ElessarCuthalion/KiCAD_library/3D/(SolidWorks)/Installation/Stones/Quartz crystal big 1.jpg

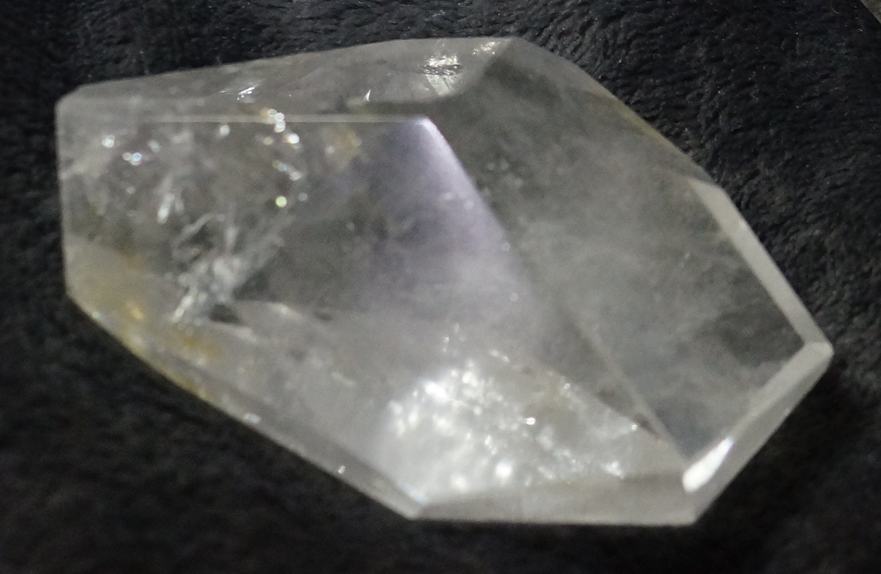
3D/(SolidWorks)/Installation/Stones/Quartz crystal big 1.jpg
