ElessarCuthalion/KiCAD_library/3D/(SolidWorks)/Installation/Stones/Quartz crystal big 2.jpg

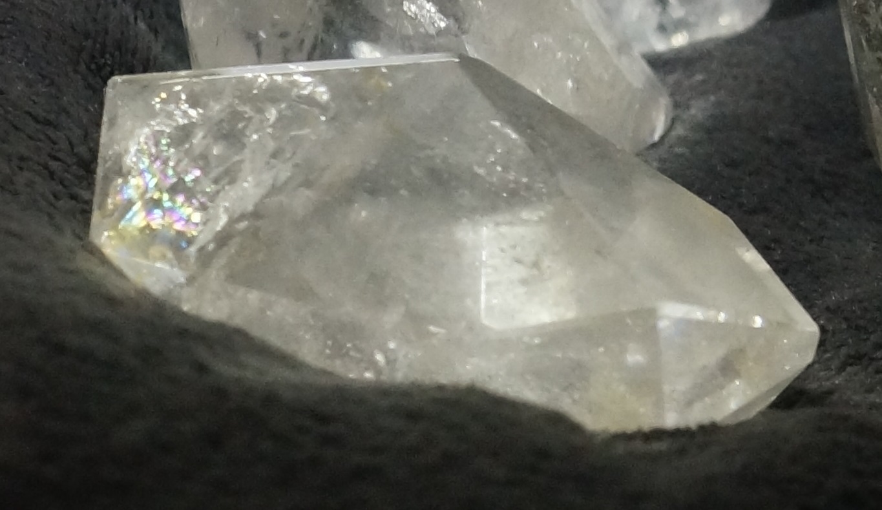
3D/(SolidWorks)/Installation/Stones/Quartz crystal big 2.jpg
