ElessarCuthalion/KiCAD_library/3D/(SolidWorks)/Buttons_Switches/+/900BGQ/900BGQ.png

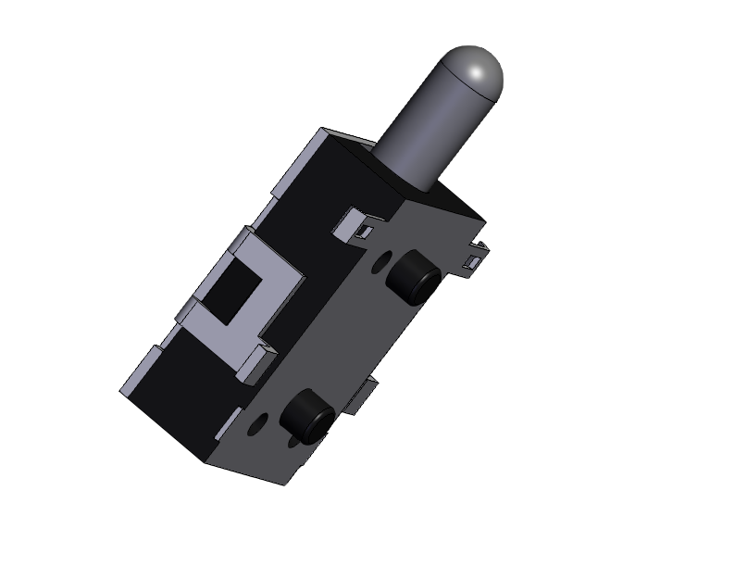
3D/(SolidWorks)/Buttons_Switches/+/900BGQ/900BGQ.png
