ElessarCuthalion/KiCAD_library/3D/(SolidWorks)/LEDs/Cree XLamp XP-E (XPERED L1 0000 00601)/Renderings/XPERED_L1_0000_0060120120402-31379-1748i98.JPG

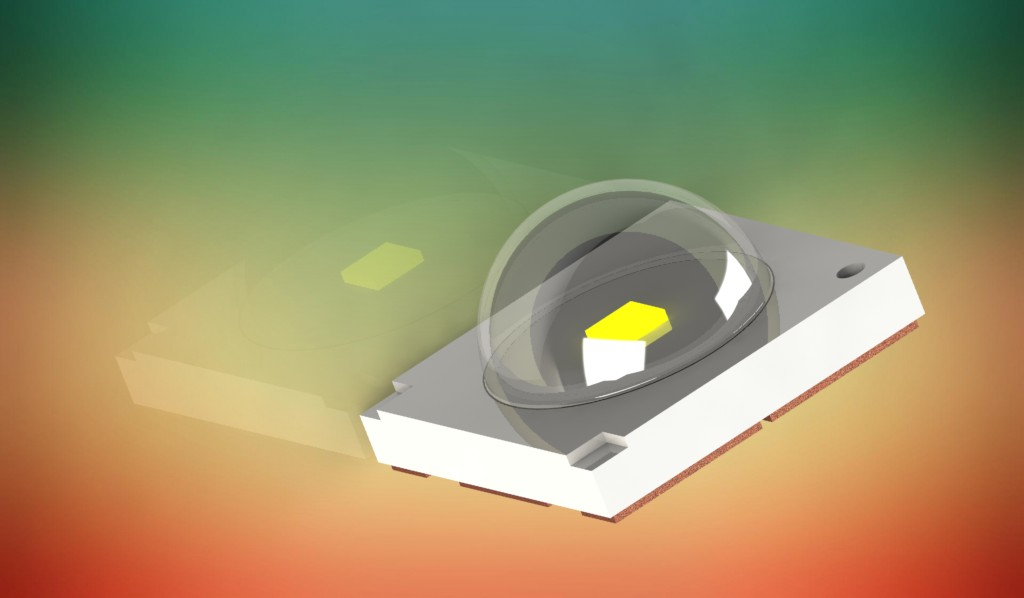
3D/(SolidWorks)/LEDs/Cree XLamp XP-E (XPERED L1 0000 00601)/Renderings/XPERED_L1_0000_0060120120402-31379-1748i98.JPG
