ElessarCuthalion/KiCAD_library/3D/Connectors/+/Degson terminals/Renderings/DG128-5.0.png

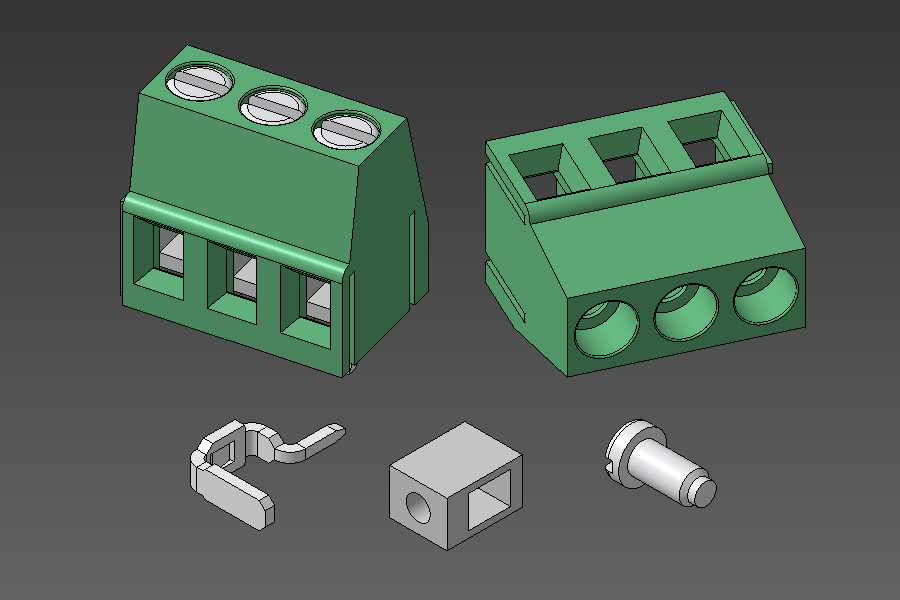
3D/Connectors/+/Degson terminals/Renderings/DG128-5.0.png
