ElessarCuthalion/KiCAD_library/3D/Connectors/+/Degson terminals/Renderings/overview.png

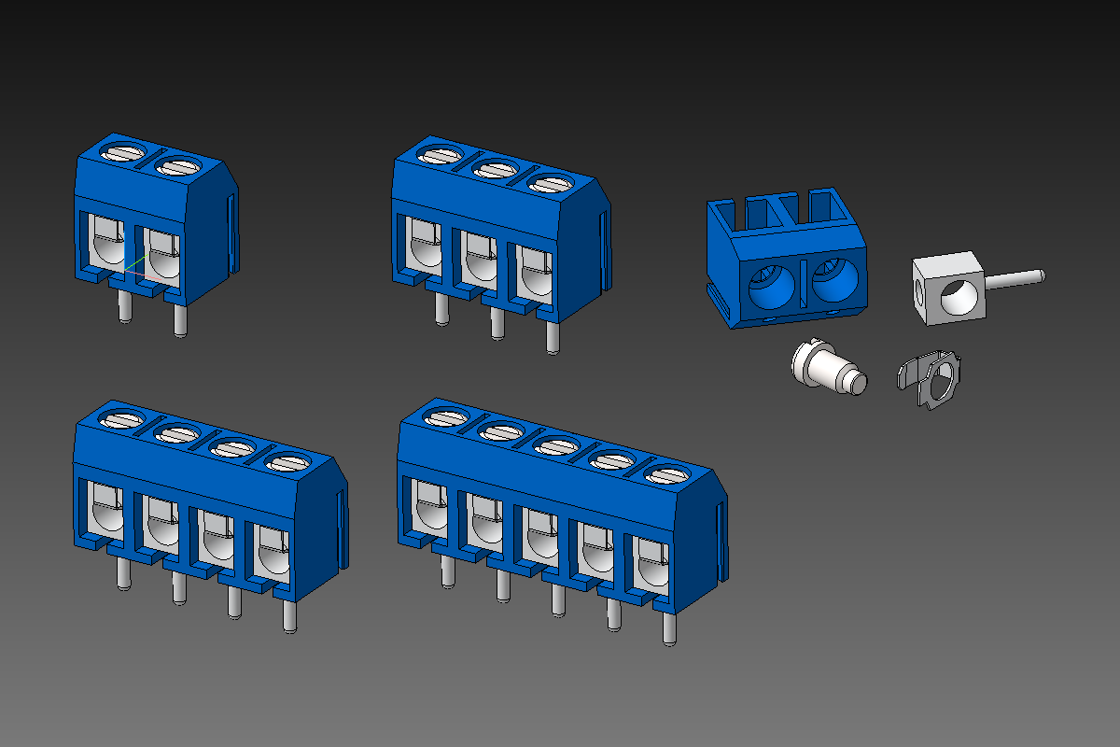
3D/Connectors/+/Degson terminals/Renderings/overview.png
