ElessarCuthalion/KiCAD_library/3D/(SolidWorks)/Buttons_Switches/+/900BGQ/User Library-900BGQ.sldasm

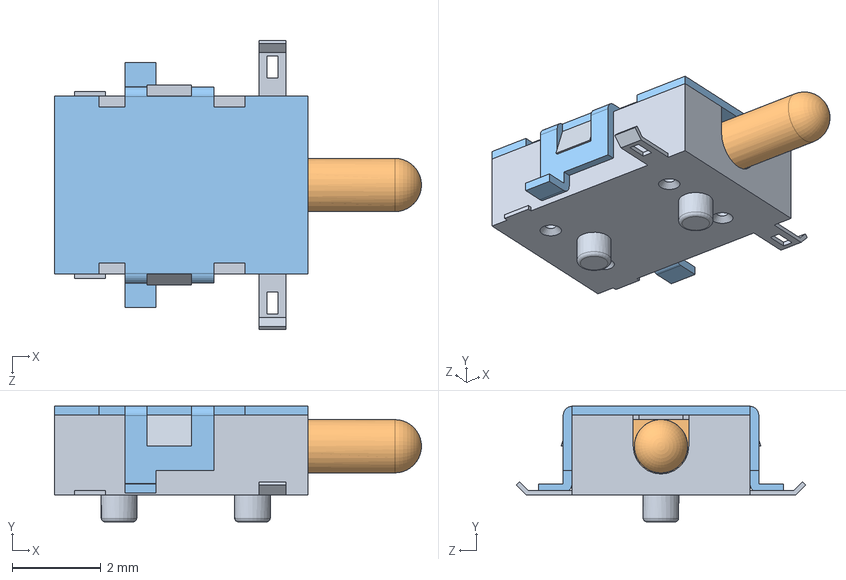
[picture p7: CAD file, 2019-11-22]
3D/(SolidWorks)/Buttons_Switches/+/900BGQ/User Library-900BGQ.sldasm
8.25 x 2.60 x 6.50 mm
User Library-900BGQ_900B_BODY
User Library-900BGQ_button
User Library-900BGQ_metal bracket
