ElessarCuthalion/KiCAD_library/3D/(SolidWorks)/Buttons_Switches/Импортированно/Switch SS-3235S-L2 (MSS-22D18G2)/SS-3235S-L2 (MSS-22D18G2).SLDASM

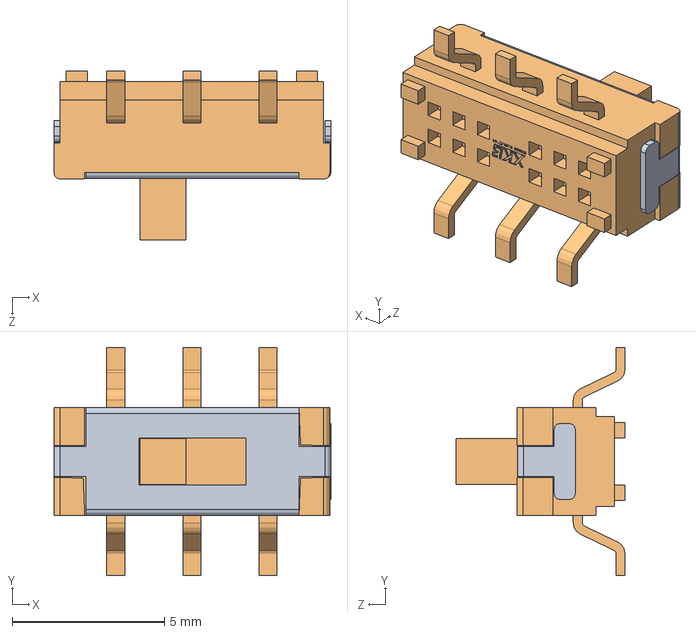
[picture p8: CAD file, 2020-05-14]
3D/(SolidWorks)/Buttons_Switches/Импортированно/Switch SS-3235S-L2 (MSS-22D18G2)/SS-3235S-L2 (MSS-22D18G2).SLDASM
9.10 x 7.50 x 5.55 mm
SS-3235S-L2_01
SS-3235S-L2_02
