ElessarCuthalion/KiCAD_library/3D/(SolidWorks)/Connectors/Импортированно/MicroSD Socket 112J-TXAR-R_C_1-1/112J-TXAR-R_C_1-1 with Card.SLDASM

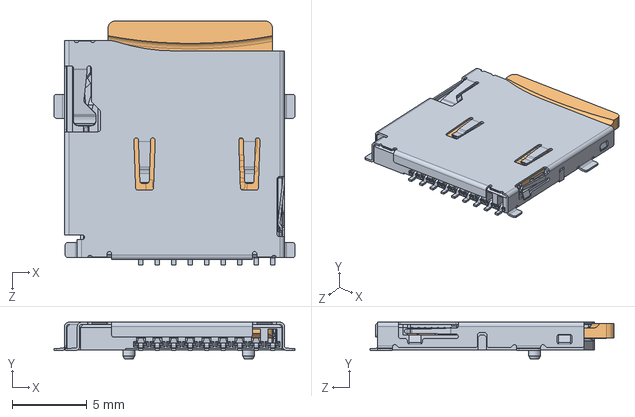
[picture p9: CAD file, 2019-11-27]
3D/(SolidWorks)/Connectors/Импортированно/MicroSD Socket 112J-TXAR-R_C_1-1/112J-TXAR-R_C_1-1 with Card.SLDASM
16.1 x 2.45 x 16.3 mm
MicroSD Socket 112J-TXAR-R_C_1-1
Micro-SD card
