ElessarCuthalion/KiCAD_library/3D/(SolidWorks)/Furniture/Hinge 20x16mm Assem.SLDASM

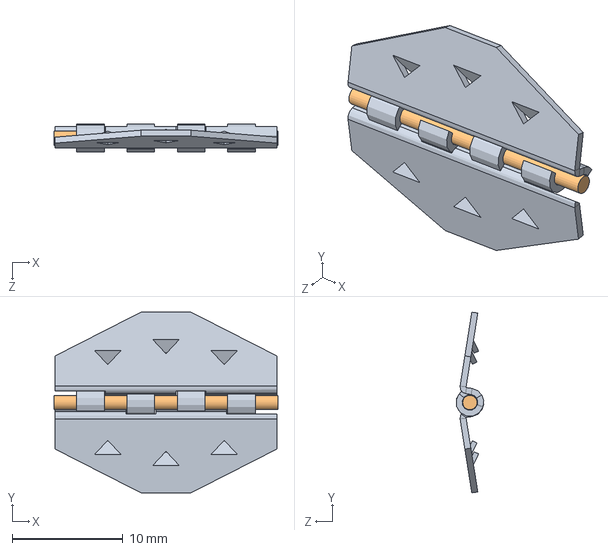
[picture p10: CAD file, 2025-02-06]
3D/(SolidWorks)/Furniture/Hinge 20x16mm Assem.SLDASM
20.2 x 16.3 x 2.48 mm
Деталь1^Hinge 20x16mm Assem x 2
Стержень^Hinge 20x16mm Assem
