ElessarCuthalion/KiCAD_library/3D/(SolidWorks)/Inductors/Импортированно/Ferrite Bead 0603/User Library-FB_1608-1.sldasm

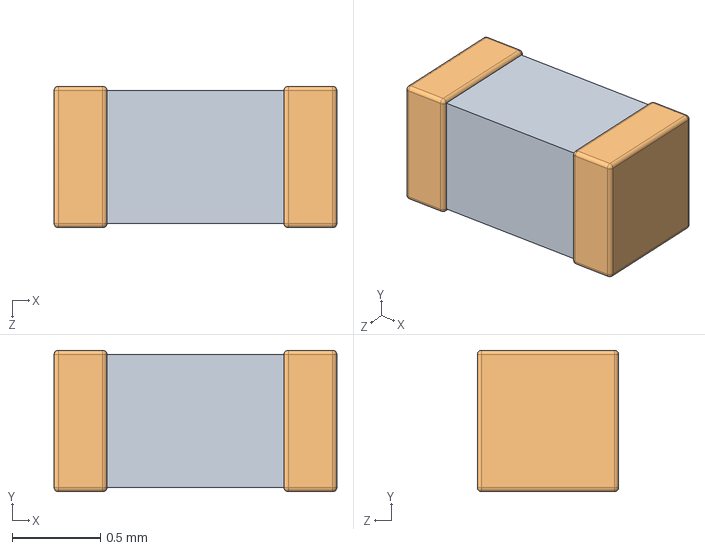
[picture p11: CAD file, 2019-11-27]
3D/(SolidWorks)/Inductors/Импортированно/Ferrite Bead 0603/User Library-FB_1608-1.sldasm
1.60 x 0.8 x 0.8 mm
User Library-FB_1608-1_Pad001
User Library-FB_1608-1_Cut
