ElessarCuthalion/KiCAD_library/3D/(SolidWorks)/Installation/Electrician/Fan 8412NGMI/8412NGMI_ebm-papst.sldasm

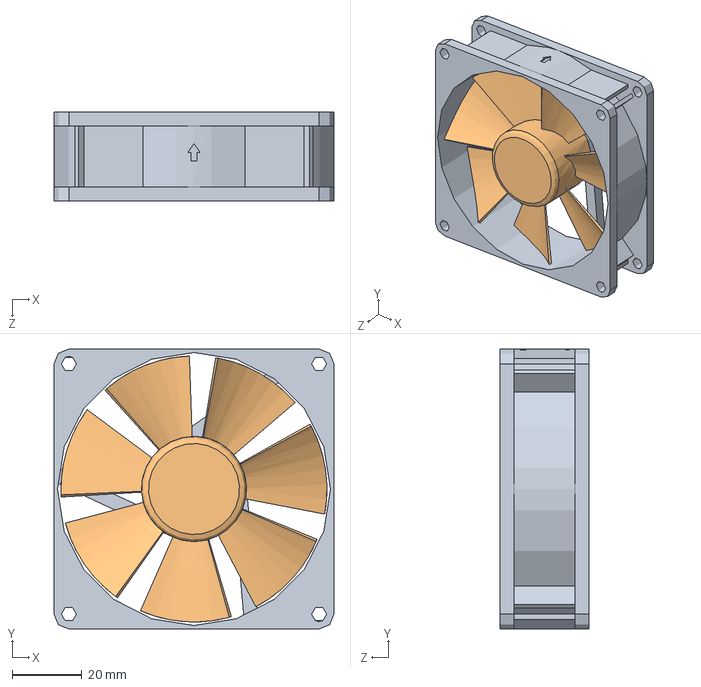
[picture p12: CAD file, 2019-11-18]
3D/(SolidWorks)/Installation/Electrician/Fan 8412NGMI/8412NGMI_ebm-papst.sldasm
80.0 x 80.0 x 25.4 mm
Fan-House_8412NGMI_ebm-papst
Fan_8412NGMI_ebm-papst
