ElessarCuthalion/KiCAD_library/3D/(SolidWorks)/Installation/Electrician/ТЭН водяной из нержавейки 2,0 кВт 195 мм 03.324/ТЭН водяной 2кВт 195мм 03.324.SLDASM

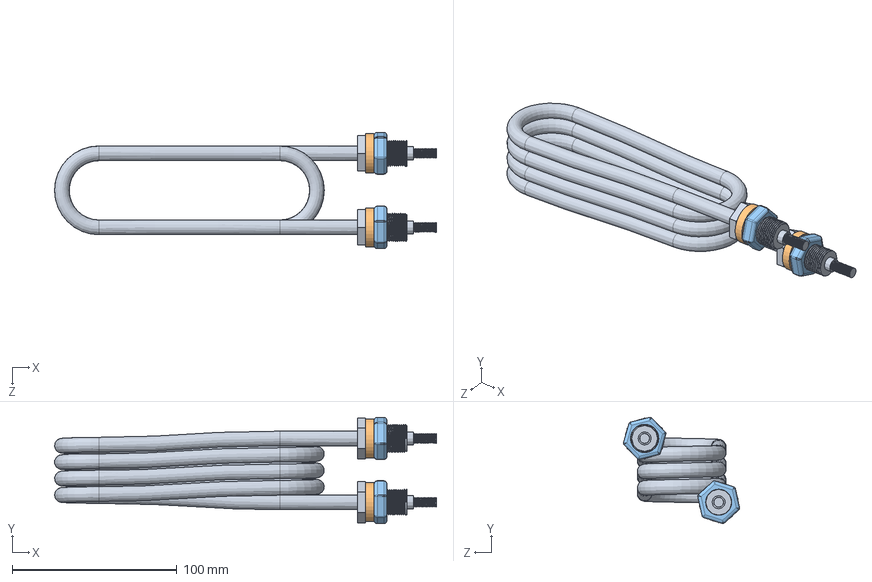
[picture p13: CAD file, 2021-07-01]
3D/(SolidWorks)/Installation/Electrician/ТЭН водяной из нержавейки 2,0 кВт 195 мм 03.324/ТЭН водяной 2кВт 195мм 03.324.SLDASM
232.2 x 64.7 x 70.7 mm
ТЭН№1
ТЭН№2 x 2
ТЭН№3 x 2
