ElessarCuthalion/KiCAD_library/3D/(SolidWorks)/Installation/Импортированно/Fuse Holder FC-201/Clips FC-201 with fuse 5x20.sldasm

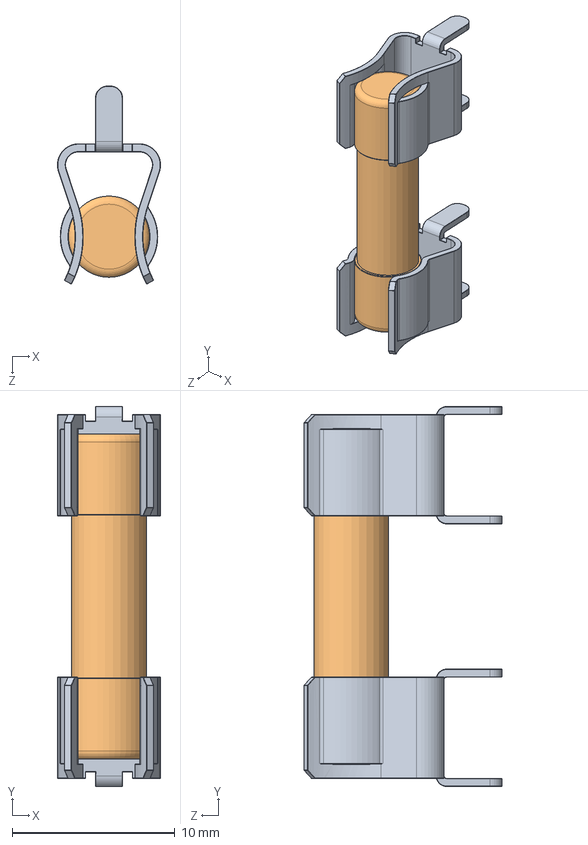
[picture p14: CAD file, 2020-11-07]
3D/(SolidWorks)/Installation/Импортированно/Fuse Holder FC-201/Clips FC-201 with fuse 5x20.sldasm
6.34 x 23.4 x 12.2 mm
Clips FC-201 with fuse 5x20_FC-201 x 2
Clips FC-201 with fuse 5x20_5x20
