ElessarCuthalion/KiCAD_library/3D/(SolidWorks)/Installation/Импортированно/Fuse Holder FH-100/Clips FH-100 with fuse 5x20.sldasm

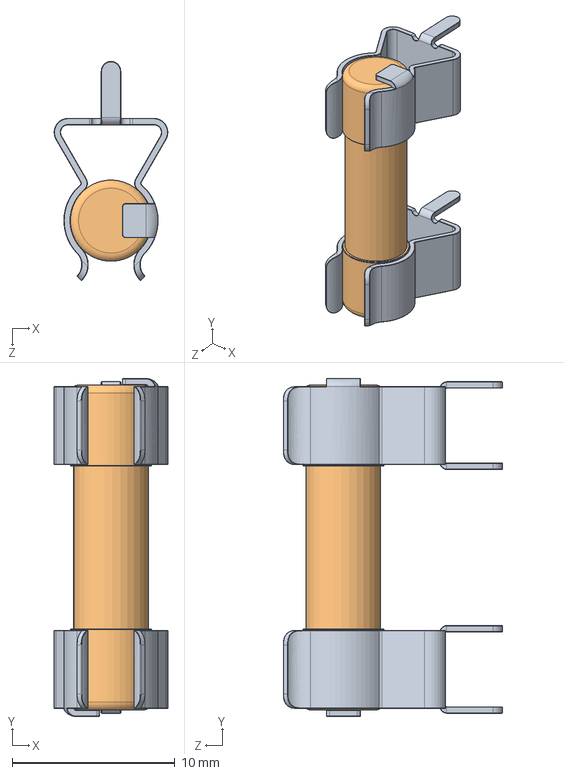
[picture p15: CAD file, 2020-11-07]
3D/(SolidWorks)/Installation/Импортированно/Fuse Holder FH-100/Clips FH-100 with fuse 5x20.sldasm
7.00 x 20.8 x 13.5 mm
Clips FH-100 with fuse 5x20_FH-100 x 2
Clips FH-100 with fuse 5x20_5x20
