ElessarCuthalion/KiCAD_library/3D/(SolidWorks)/LEDs/Cree XLamp XP-E (XPERED L1 0000 00601)/cree xlamp_xp_e XPERED_L1_0000_00601.SLDASM

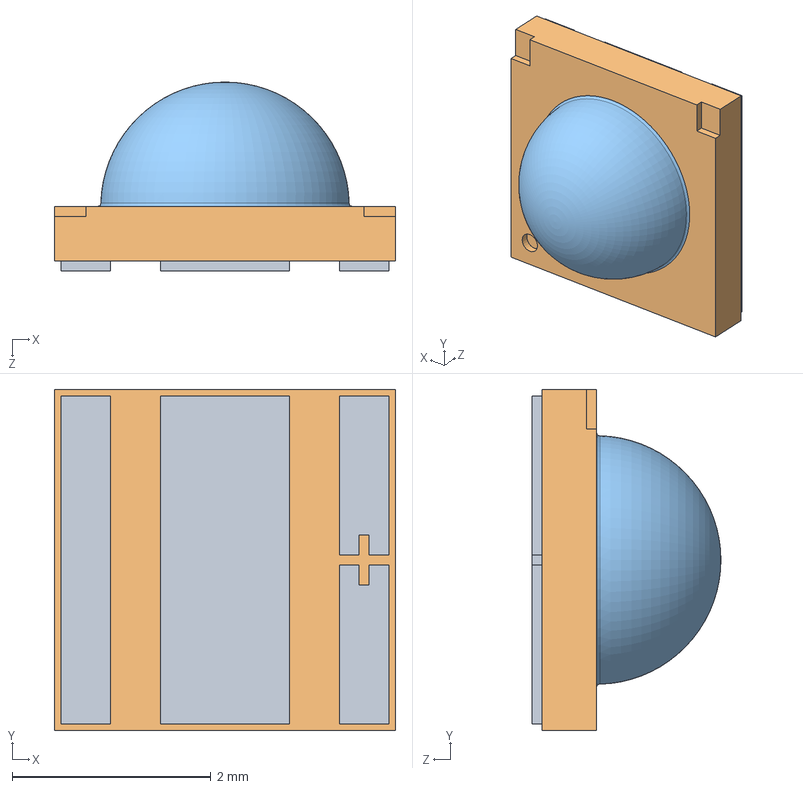
[picture p16: CAD file, 2023-12-07]
3D/(SolidWorks)/LEDs/Cree XLamp XP-E (XPERED L1 0000 00601)/cree xlamp_xp_e XPERED_L1_0000_00601.SLDASM
3.43 x 3.43 x 1.90 mm
led anod
led_alaptest
led_lencse
emiter_fosfor
