ElessarCuthalion/KiCAD_library/3D/(SolidWorks)/LEDs/Импортированы/LED5050 RGB/_LED5050 RGB.sldasm

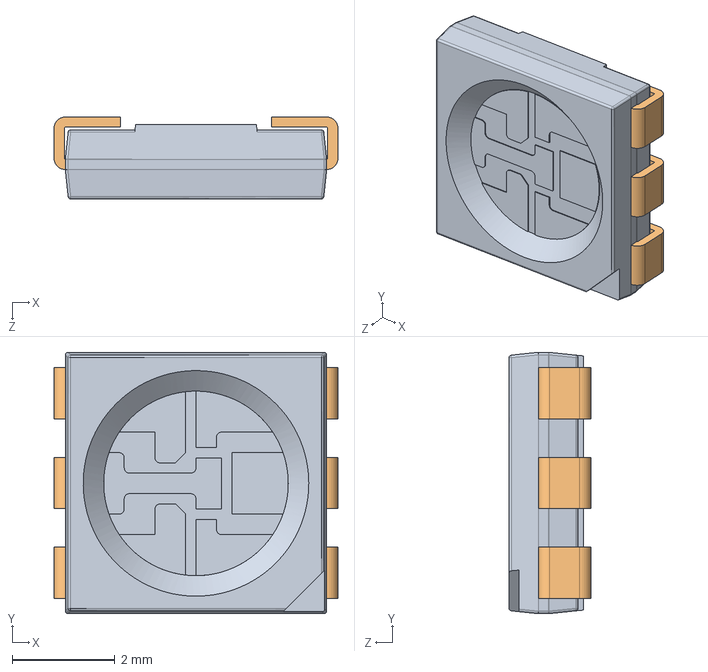
[picture p17: CAD file, 2019-11-22]
3D/(SolidWorks)/LEDs/Импортированы/LED5050 RGB/_LED5050 RGB.sldasm
5.54 x 5.10 x 1.60 mm
Open_CASCADE_STEP_translator_6.8_1.1
Lead x 6
