ElessarCuthalion/KiCAD_library/3D/(SolidWorks)/Modules/Raspberry/Импортированно/Raspberry Pi 3.SLDASM

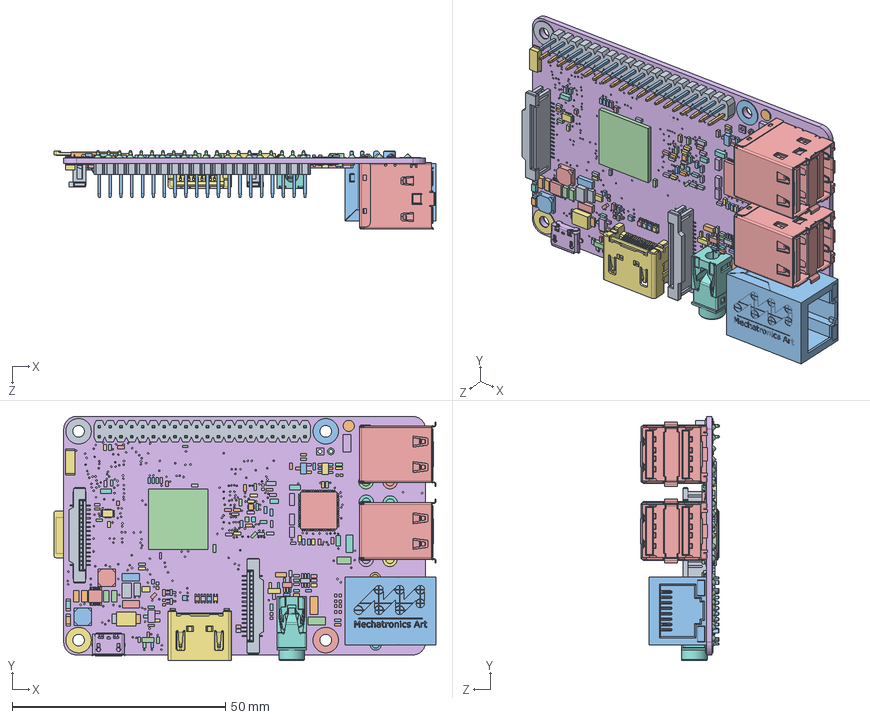
[picture p18: CAD file, 2019-11-18]
3D/(SolidWorks)/Modules/Raspberry/Импортированно/Raspberry Pi 3.SLDASM
89.6 x 57.3 x 18.6 mm
Raspberry Pi 3157
Raspberry Pi 3242 x 20
Raspberry Pi 3266 x 20
raspberry_pi_3(bar_180_2x20)
MOLEX_672983090 x 2
molex_0473460001
molex_0471510001
PJ-322
te_1-1734248-5 x 2
MOLEX_1040310811
raspberry_pi_B_(RJ45)
Raspberry Pi 312
Raspberry Pi 314
Raspberry Pi 3172
Raspberry Pi 3173
Raspberry Pi 3174
Raspberry Pi 3175
Raspberry Pi 3176
Raspberry Pi 3177
Raspberry Pi 3178
Raspberry Pi 3179
Raspberry Pi 3180
Raspberry Pi 3181
Raspberry Pi 3182
Raspberry Pi 3183
Raspberry Pi 3184
Raspberry Pi 3185
Raspberry Pi 3186
Raspberry Pi 3187
Raspberry Pi 3188
Raspberry Pi 3189
Raspberry Pi 3190
Raspberry Pi 3191
Raspberry Pi 3192
Raspberry Pi 3193
Raspberry Pi 3194
Raspberry Pi 3195
Raspberry Pi 3196
Raspberry Pi 3197
Raspberry Pi 3198
Raspberry Pi 3199
Raspberry Pi 3200
Raspberry Pi 3201
Raspberry Pi 3202
Raspberry Pi 3203
Raspberry Pi 3204
Raspberry Pi 3205
Raspberry Pi 3206
Raspberry Pi 3207
Raspberry Pi 3208
Raspberry Pi 3209
Raspberry Pi 3210
Raspberry Pi 3211
Raspberry Pi 3212
Raspberry Pi 3213
Raspberry Pi 3214
Raspberry Pi 3215
Raspberry Pi 3216
Raspberry Pi 3217
Raspberry Pi 3218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
