ElessarCuthalion/KiCAD_library/3D/(SolidWorks)/SOT_TO/Импортированно/SOT89/SOT89.SLDASM

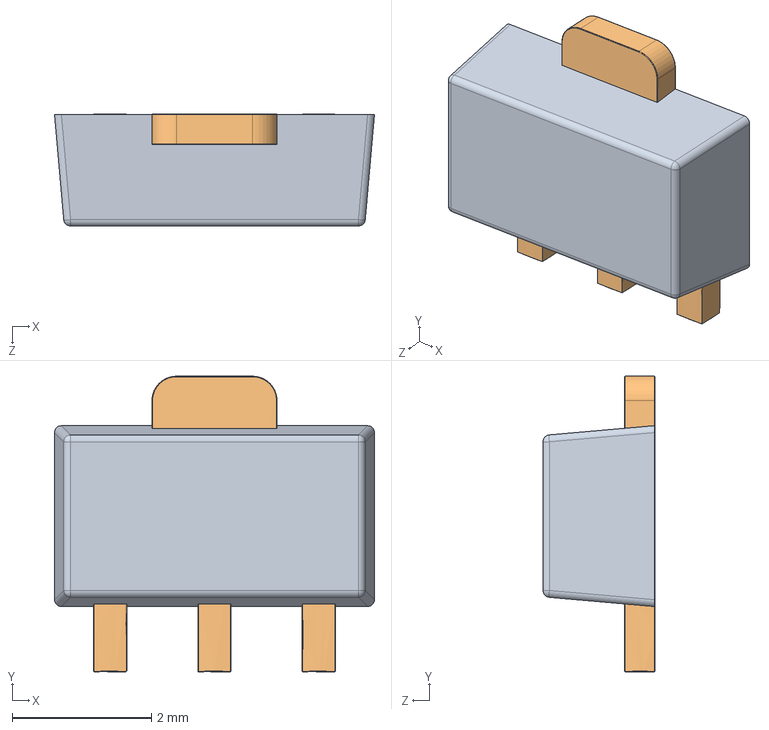
[picture p19: CAD file, 2020-11-05]
3D/(SolidWorks)/SOT_TO/Импортированно/SOT89/SOT89.SLDASM
4.60 x 4.25 x 1.61 mm
SOT89-case
SOT89-pinout
