ElessarCuthalion/KiCAD_library/3D/(SolidWorks)/Battery_&_Holders/BatHolder 3xAA/BatHolder 3xAA Asm.SLDASM

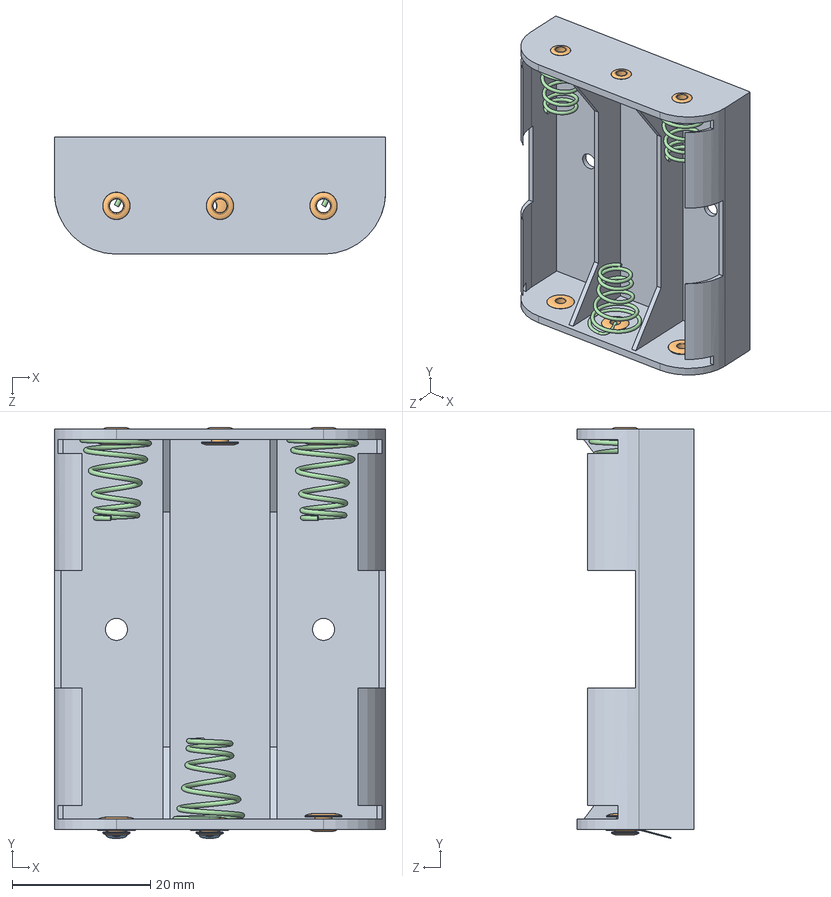
[picture p20: CAD file, 2019-11-18]
3D/(SolidWorks)/Battery_&_Holders/BatHolder 3xAA/BatHolder 3xAA Asm.SLDASM
48.0 x 59.5 x 17.0 mm
BatteryHolder 3xAA Case
