ElessarCuthalion/KiCAD_library/3D/(SolidWorks)/Connectors/_Plug's/RJ-25 plug + cover cast (ethernet cable)/male_main_head.SLDPRT

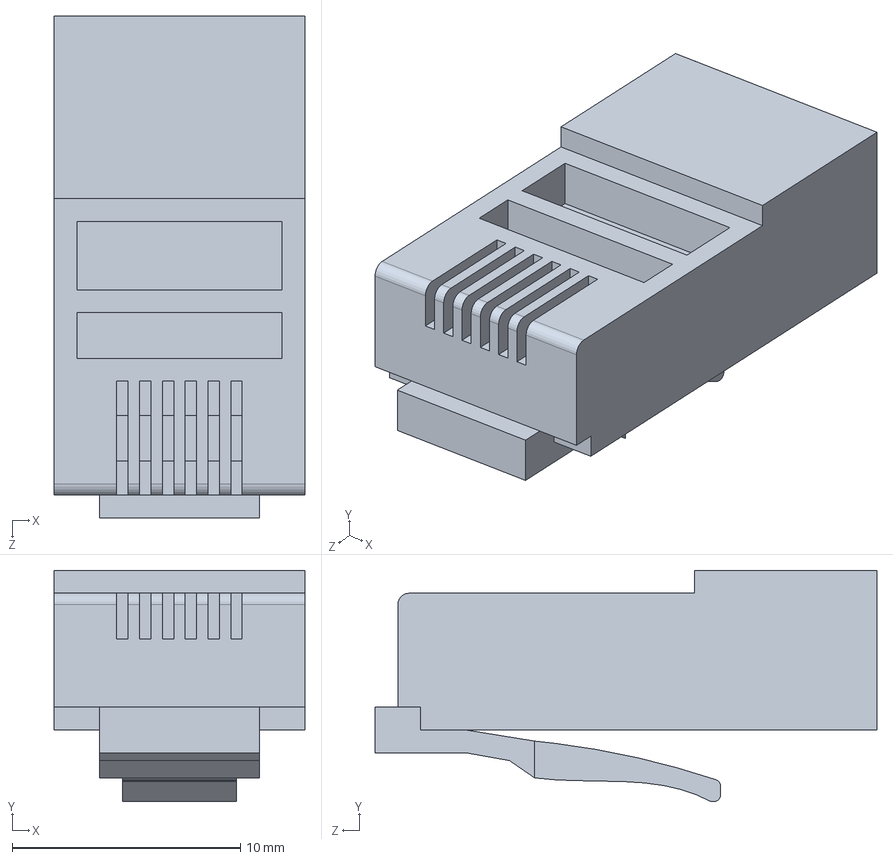
[picture p21: CAD file, 2020-08-14]
3D/(SolidWorks)/Connectors/_Plug's/RJ-25 plug + cover cast (ethernet cable)/male_main_head.SLDPRT
11.0 x 10.1 x 22.0 mm
