ElessarCuthalion/KiCAD_library/3D/(SolidWorks)/Connectors/Cleamm-2_5mm - DG306-5.0-xxP/DG306-5.0-3P.SLDASM

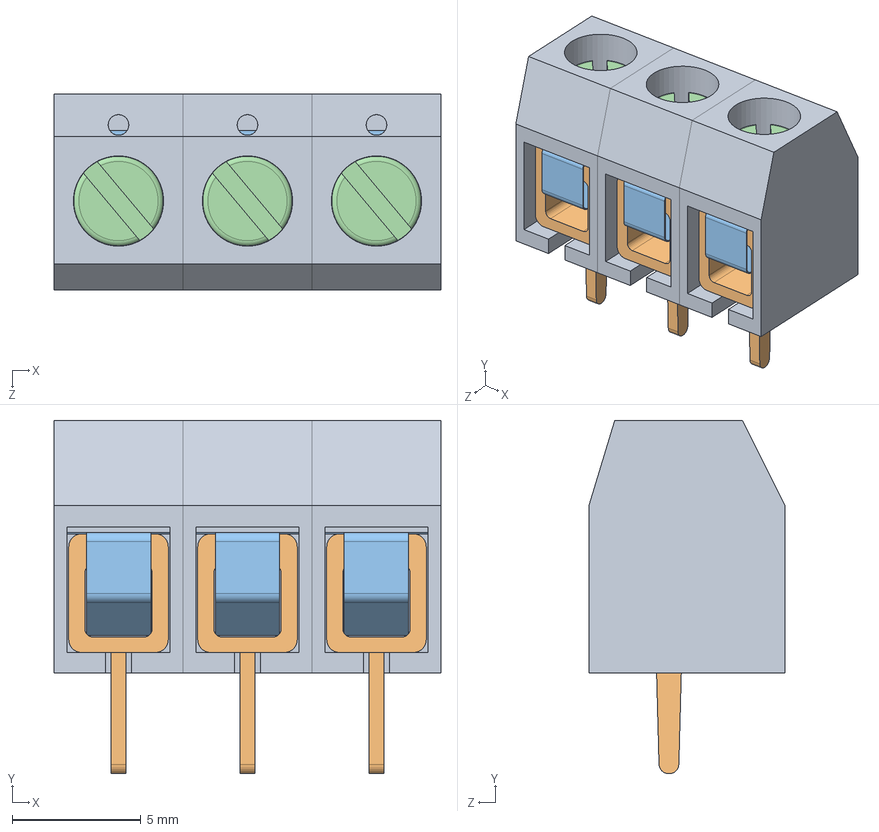
[picture p22: CAD file, 2020-06-08]
3D/(SolidWorks)/Connectors/Cleamm-2_5mm - DG306-5.0-xxP/DG306-5.0-3P.SLDASM
15.0 x 13.7 x 7.60 mm
DG306-5.0-3P_Case x 3
DG306-5.0-3P_Leg x 3
DG306-5.0-3P_Spring x 3
DG306-5.0-3P_Cap x 3
