ElessarCuthalion/KiCAD_library/3D/(SolidWorks)/Connectors/USB-B vetrical IGS-61400413321/User Library-IGS-61400413321-rev1.sldasm

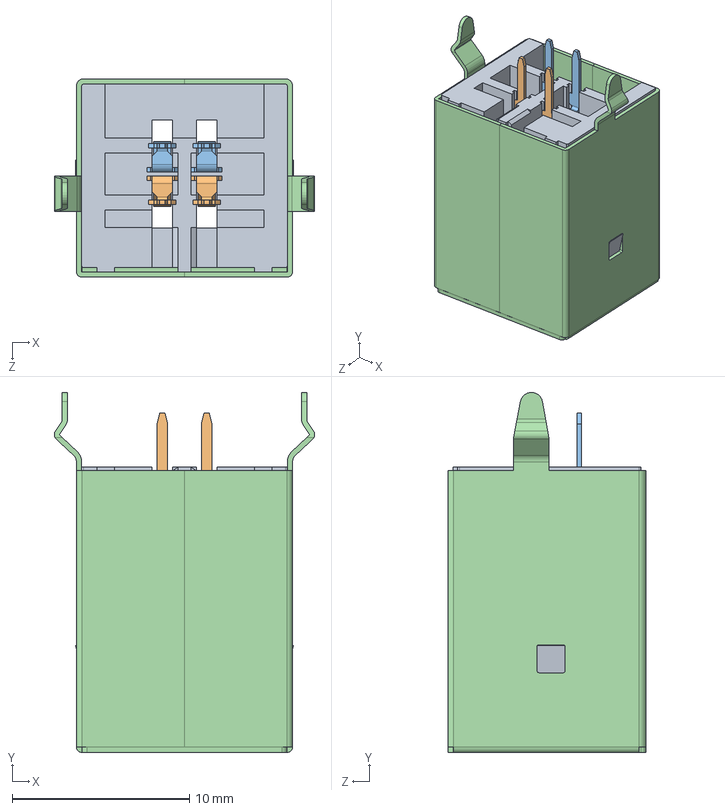
[picture p23: CAD file, 2024-06-06]
3D/(SolidWorks)/Connectors/USB-B vetrical IGS-61400413321/User Library-IGS-61400413321-rev1.sldasm
14.7 x 20.3 x 11.2 mm
User Library-IGS-61400413321-rev1_DEFAULT
User Library-IGS-61400413321-rev1_DEFAULT-1 x 2
User Library-IGS-61400413321-rev1_DEFAULT-2 x 2
User Library-IGS-61400413321-rev1_DEFAULT-3
