ElessarCuthalion/KiCAD_library/3D/(SolidWorks)/Connectors/Импортированно/USB-micro B+Hole/User Library-usb_port_ch.sldasm

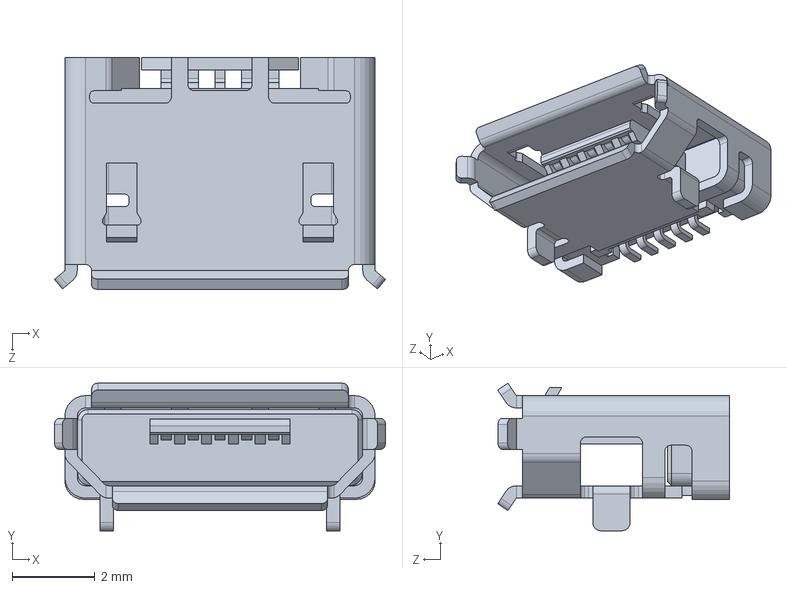
[picture p24: CAD file, 2020-10-19]
3D/(SolidWorks)/Connectors/Импортированно/USB-micro B+Hole/User Library-usb_port_ch.sldasm
8.00 x 3.57 x 5.60 mm
