ElessarCuthalion/KiCAD_library/3D/(SolidWorks)/Furniture/Hinge 42x14mm Assem.SLDASM

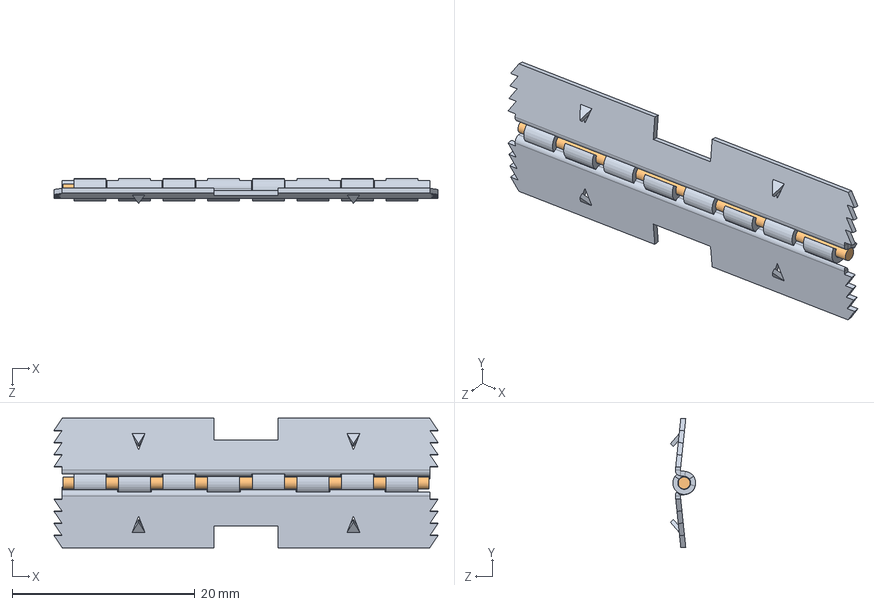
[picture p25: CAD file, 2025-02-06]
3D/(SolidWorks)/Furniture/Hinge 42x14mm Assem.SLDASM
42.0 x 14.2 x 2.77 mm
Деталь1^Hinge 42x14mm Assem x 2
Стержень^Hinge 42x14mm Assem
