ElessarCuthalion/KiCAD_library/3D/(SolidWorks)/Inductors/Импортированно/Ferrite Bead 0805/User Library-FB_2012-1.sldasm

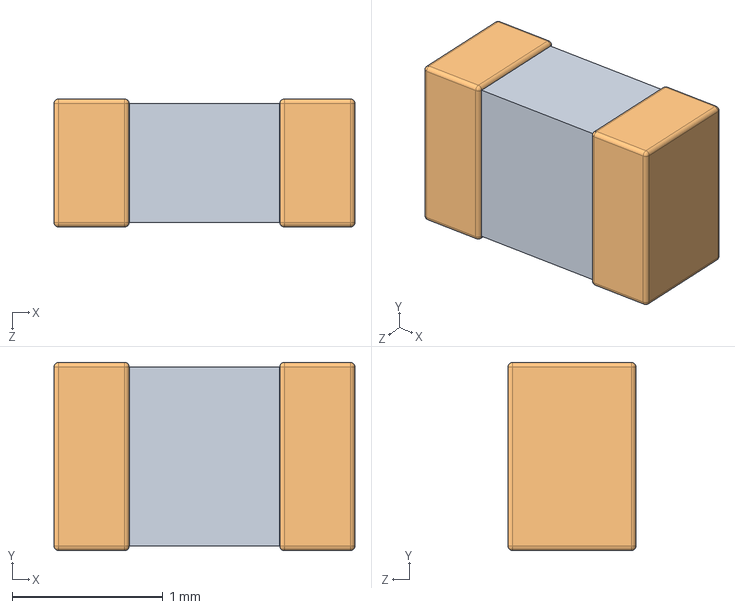
[picture p26: CAD file, 2019-11-27]
3D/(SolidWorks)/Inductors/Импортированно/Ferrite Bead 0805/User Library-FB_2012-1.sldasm
2.00 x 1.25 x 0.85 mm
User Library-FB_2012-1_Pad001
User Library-FB_2012-1_Cut
