ElessarCuthalion/KiCAD_library/3D/(SolidWorks)/Installation/Импортированно/PIR D203S TO5-3 + Case/PIR Sensor.sldasm

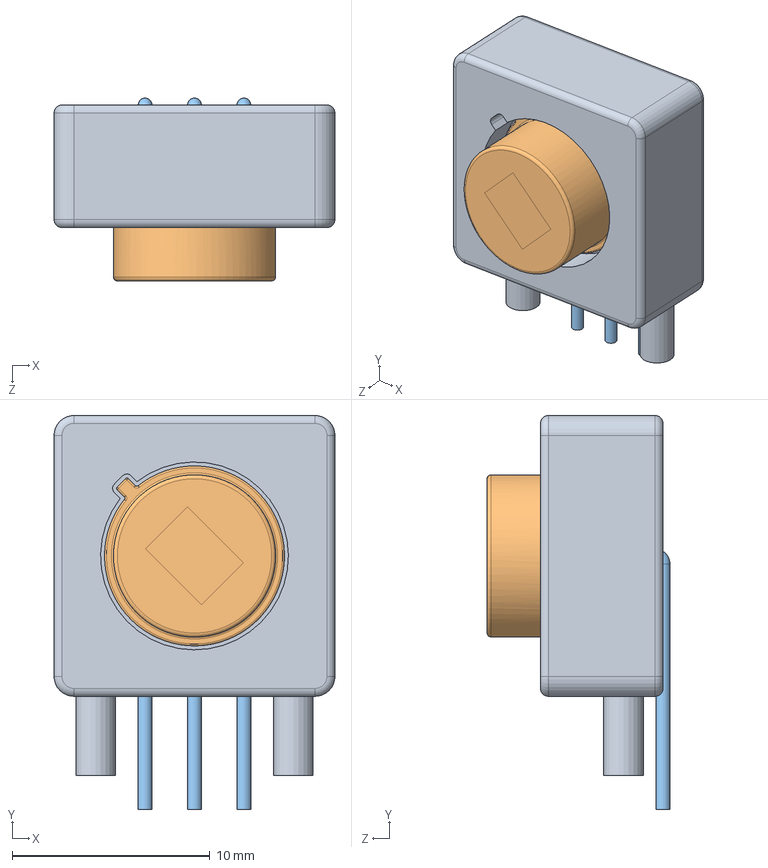
[picture p27: CAD file, 2020-09-22]
3D/(SolidWorks)/Installation/Импортированно/PIR D203S TO5-3 + Case/PIR Sensor.sldasm
14.2 x 19.9 x 9.25 mm
User Library-PIR Sensor_PIR plastic
User Library-PIR Sensor_PIR_S_Orginal
User Library-PIR Sensor_Leads
