ElessarCuthalion/KiCAD_library/3D/(SolidWorks)/Opto/opto_SOP4-2.54 - KAQY21xS/SOP254P680X235-4N.SLDASM

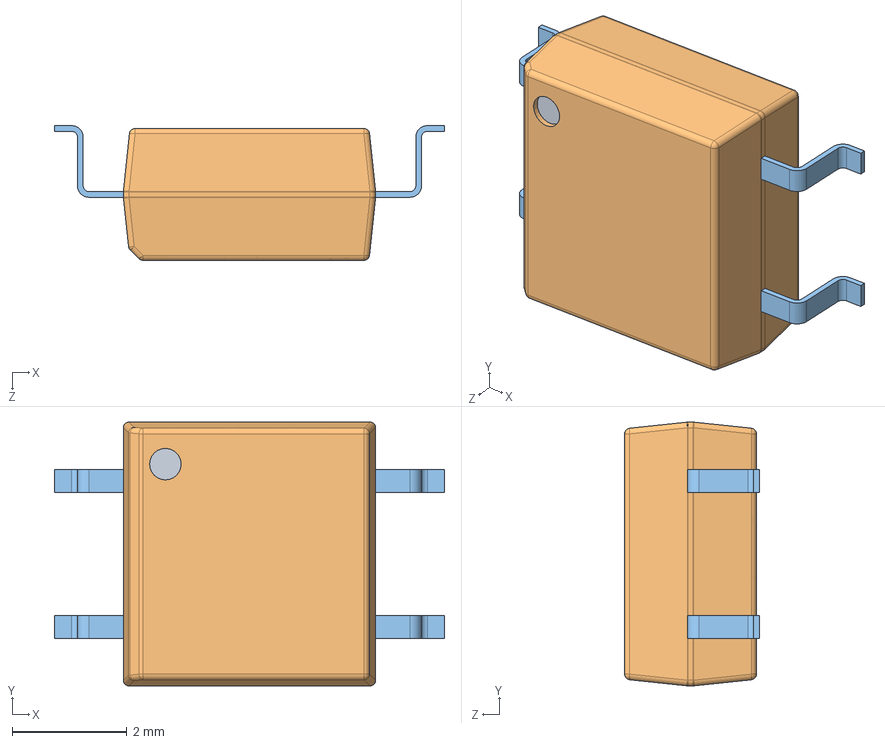
[picture p29: CAD file, 2023-04-14]
3D/(SolidWorks)/Opto/opto_SOP4-2.54 - KAQY21xS/SOP254P680X235-4N.SLDASM
6.80 x 4.60 x 2.35 mm
Open_CASCADE_STEP_translator_6.8_1.1
Open_CASCADE_STEP_translator_6.8_1.2.1
Leader x 4
