ElessarCuthalion/KiCAD_library/3D/(SolidWorks)/Opto/Импортированно/opto_SOP16/TLP291-4(SOP16).sldasm

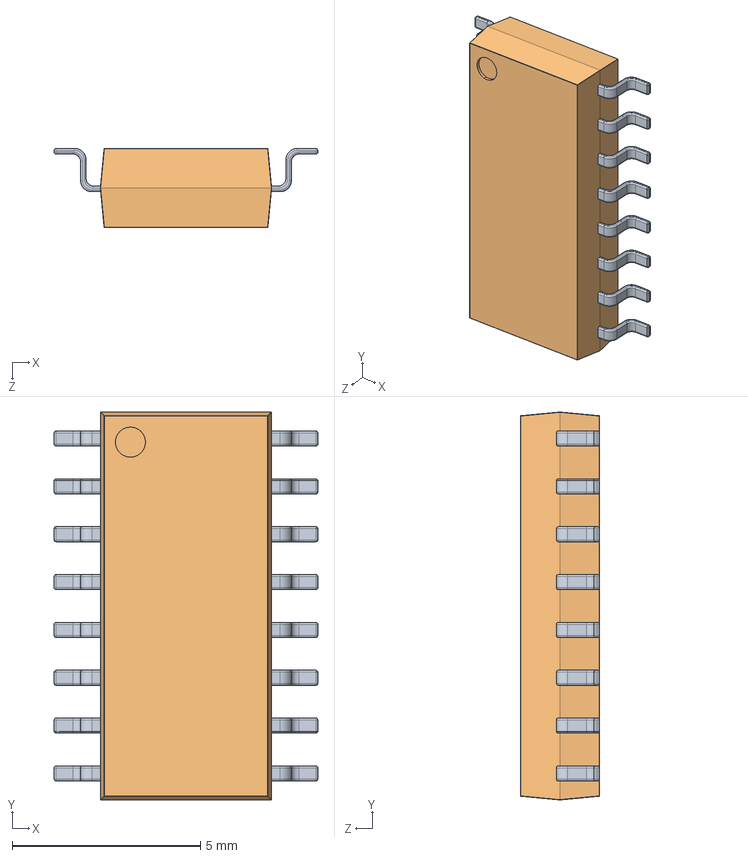
[picture p30: CAD file, 2020-10-14]
3D/(SolidWorks)/Opto/Импортированно/opto_SOP16/TLP291-4(SOP16).sldasm
7.00 x 10.3 x 2.10 mm
TLP291-4(SOP16)_Document
TLP291-4(SOP16)__X_EB_X_B8_X_94_X_EB_X_A1_X_9D 01
