ElessarCuthalion/KiCAD_library/3D/(SolidWorks)/Power/24V Mean Well Power Supply/User Library-24 V Power Supply.SLDASM

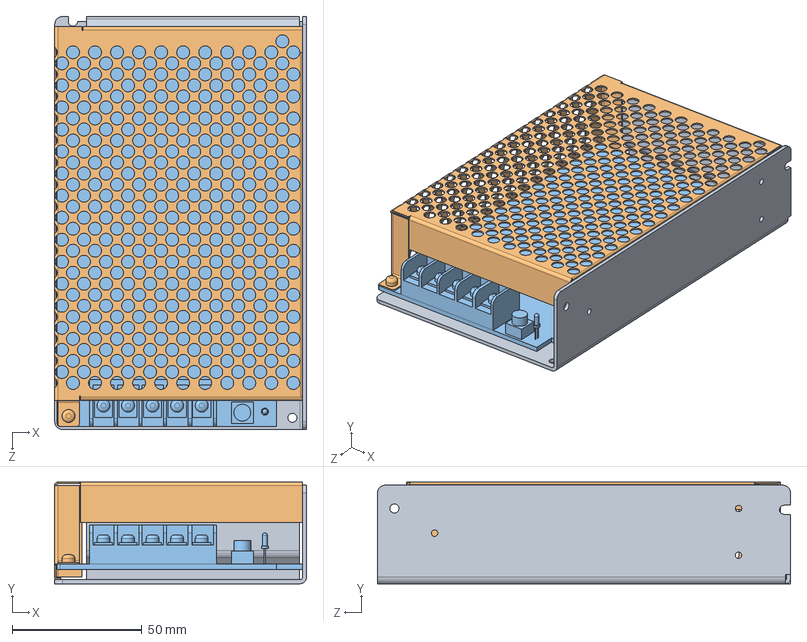
[picture p31: CAD file, 2020-02-28]
3D/(SolidWorks)/Power/24V Mean Well Power Supply/User Library-24 V Power Supply.SLDASM
97.1 x 39.1 x 159.0 mm
User Library-24 V Power Supply_Base
User Library-24 V Power Supply_Cover
User Library-24 V Power Supply_Board
