ElessarCuthalion/KiCAD_library/3D/(SolidWorks)/Power/PwrSupp_MW_LRS-50-12/PwrSupp_MW_LRS-50-12.SLDASM

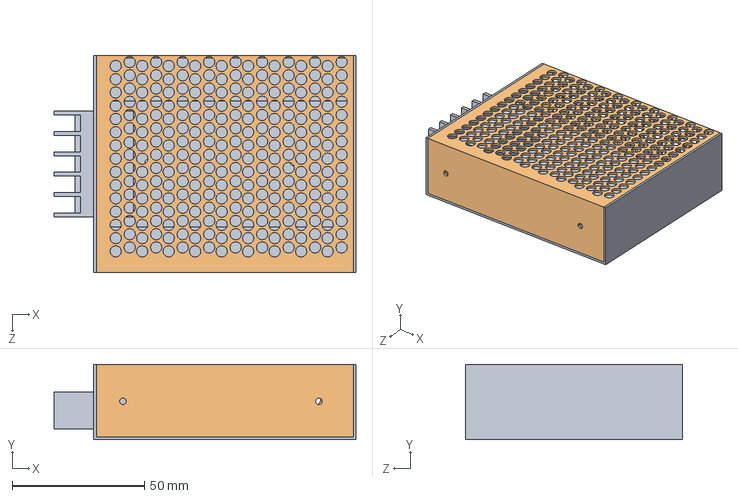
[picture p32: CAD file, 2021-07-01]
3D/(SolidWorks)/Power/PwrSupp_MW_LRS-50-12/PwrSupp_MW_LRS-50-12.SLDASM
114.0 x 28.5 x 82.0 mm
Часть блока питания №1
Часть блока питания №2
