ElessarCuthalion/KiCAD_library/3D/(SolidWorks)/Radio/Импортированно/2450BM14A0002/User Library-2450BM14A0002.sldasm

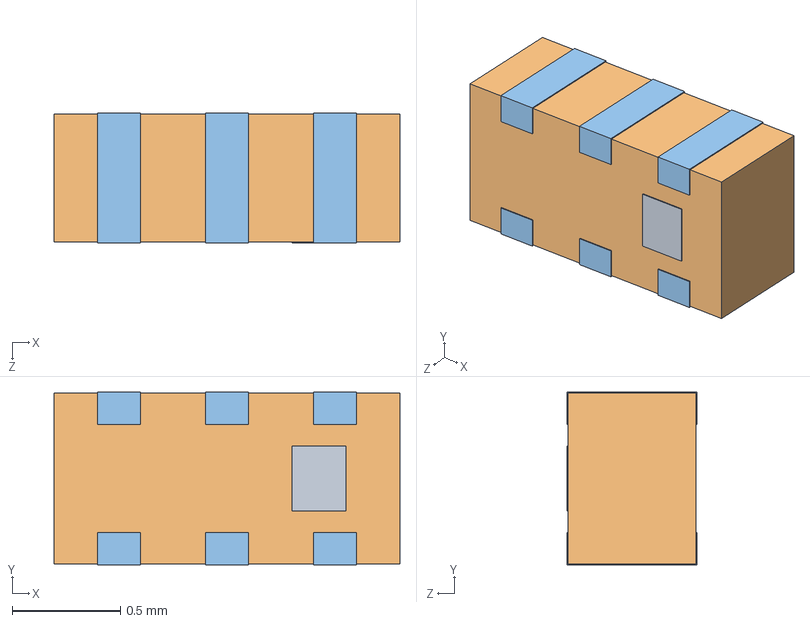
[picture p33: CAD file, 2020-01-05]
3D/(SolidWorks)/Radio/Импортированно/2450BM14A0002/User Library-2450BM14A0002.sldasm
1.60 x 0.8 x 0.6 mm
User Library-2450BM14A0002_Pad002
User Library-2450BM14A0002_Pad001
User Library-2450BM14A0002_Pad
