ElessarCuthalion/KiCAD_library/3D/(SolidWorks)/Connectors/_Plug's/RJ-25 plug + cover cast (ethernet cable)/ethernet_assem.SLDASM

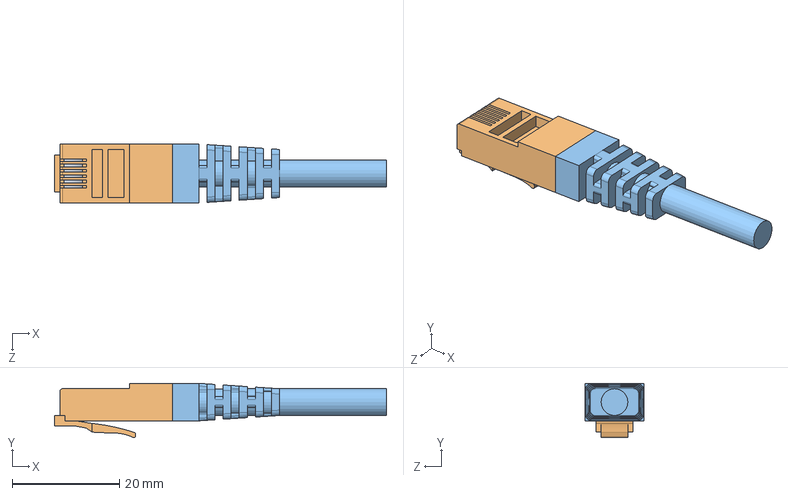
[picture p34: CAD file, 2020-08-14]
3D/(SolidWorks)/Connectors/_Plug's/RJ-25 plug + cover cast (ethernet cable)/ethernet_assem.SLDASM
62.0 x 10.1 x 11.0 mm
ethernet_pin x 6
male_main_head
cable
