ElessarCuthalion/KiCAD_library/3D/(SolidWorks)/Connectors/Импортированно/KF1000-xP Клеммная колодка/User Library-KF1000-3P.SLDASM

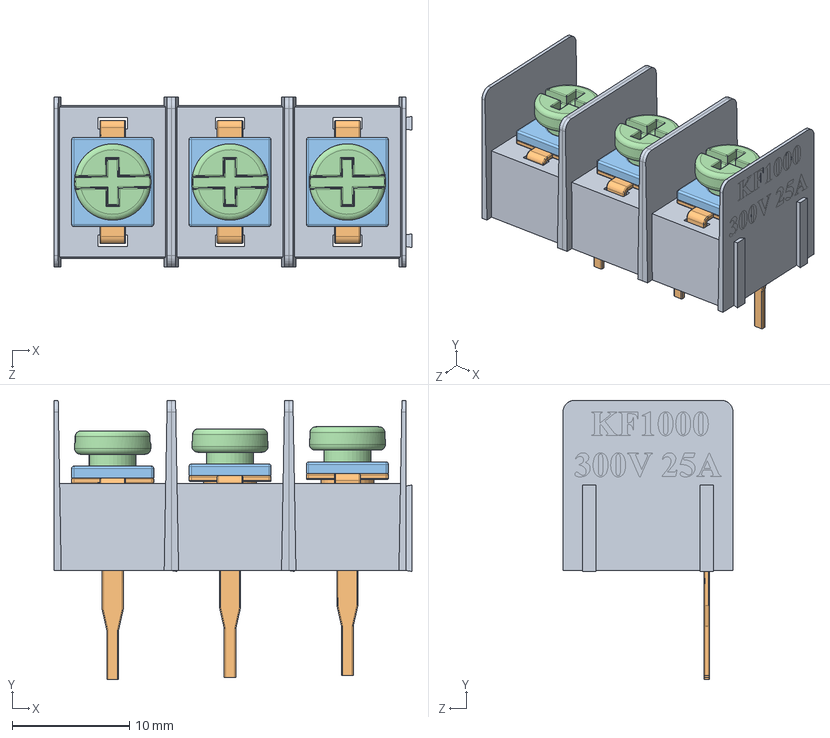
[picture p35: CAD file, 2020-10-26]
3D/(SolidWorks)/Connectors/Импортированно/KF1000-xP Клеммная колодка/User Library-KF1000-3P.SLDASM
30.5 x 23.8 x 14.5 mm
User Library-KF1000-3P_KF1000 Body x 3
User Library-KF1000-3P_KF1000-Pin x 3
User Library-KF1000-3P_KF1000-Washer x 3
User Library-KF1000-3P_KF1000-Bolt x 3
