ElessarCuthalion/KiCAD_library/3D/(SolidWorks)/Inductors/Импортированно/CDRH104R/User Library-cdrh104r.sldasm

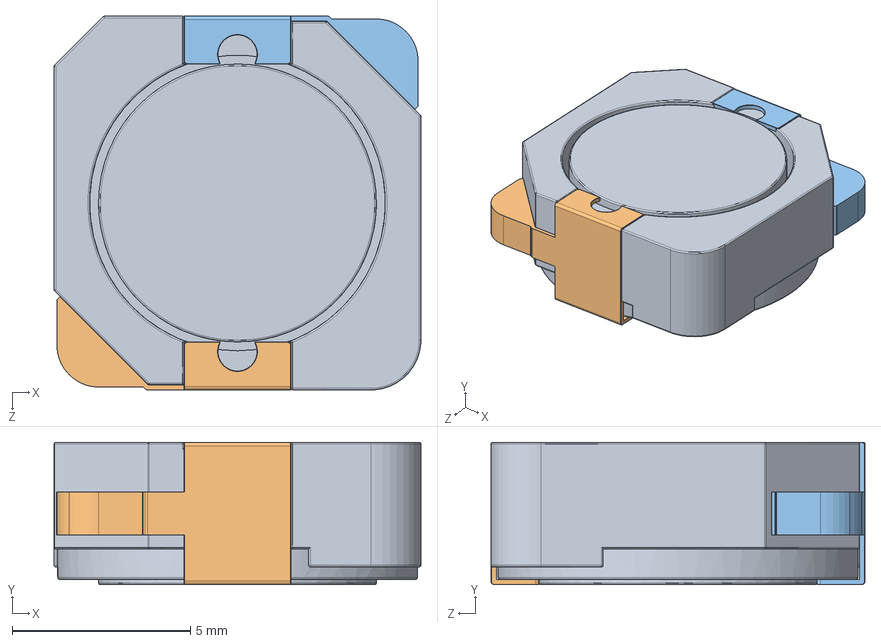
[picture p36: CAD file, 2023-06-21]
3D/(SolidWorks)/Inductors/Импортированно/CDRH104R/User Library-cdrh104r.sldasm
10.3 x 4.00 x 10.5 mm
User Library-cdrh104r_CDRH104R_KORPUS
User Library-cdrh104r_CDRH104R_NOGKA
User Library-cdrh104r_CDRH104R_NOGKA_1
