ElessarCuthalion/KiCAD_library/3D/(SolidWorks)/Installation/Импортированно/Fuse Holder LF-102071/Clips LF-102071 with fuse 6.3x32.sldasm

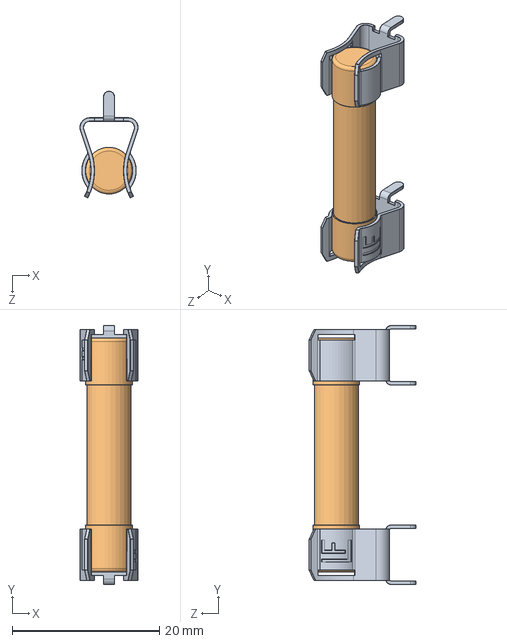
[picture p37: CAD file, 2020-10-14]
3D/(SolidWorks)/Installation/Импортированно/Fuse Holder LF-102071/Clips LF-102071 with fuse 6.3x32.sldasm
7.89 x 35.2 x 14.5 mm
User Library-Clips LF-102071 with fuse 6.3x32_LF 102071 x 2
Clips LF-102071 with fuse 6.3x32_6,3x32
