ElessarCuthalion/KiCAD_library/3D/(SolidWorks)/Radio/Импортированно/Balun 2450BM15/User Library-Balun 2450BM15.sldasm

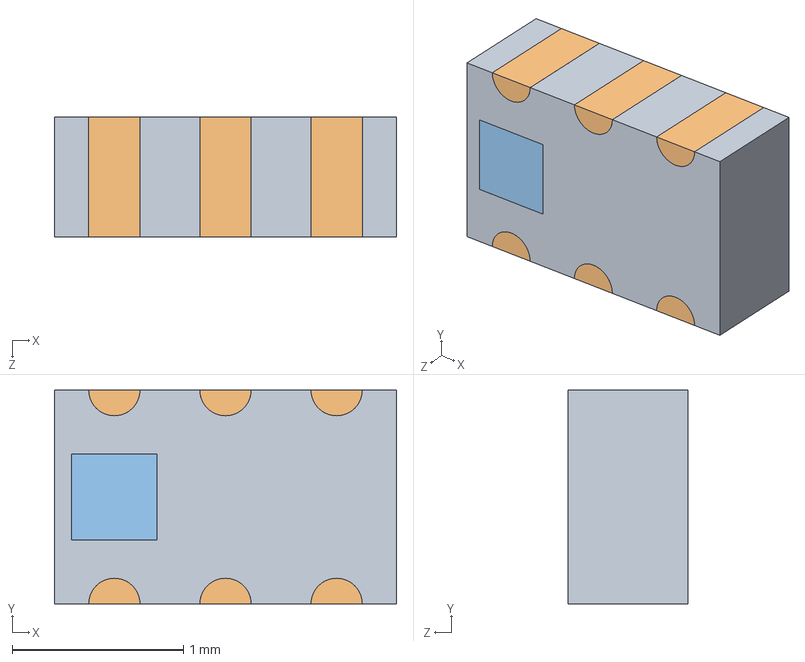
[picture p38: CAD file, 2020-01-05]
3D/(SolidWorks)/Radio/Импортированно/Balun 2450BM15/User Library-Balun 2450BM15.sldasm
2.00 x 1.25 x 0.7 mm
User Library-Balun 2450BM15_Part29
User Library-Balun 2450BM15_Imported x 6
User Library-Balun 2450BM15_Pin 1 Marking
