ElessarCuthalion/KiCAD_library/3D/(SolidWorks)/Connectors/Cleamm-2_5mm - DG126-5.0-xxP/DG126-5.0-02P.SLDASM

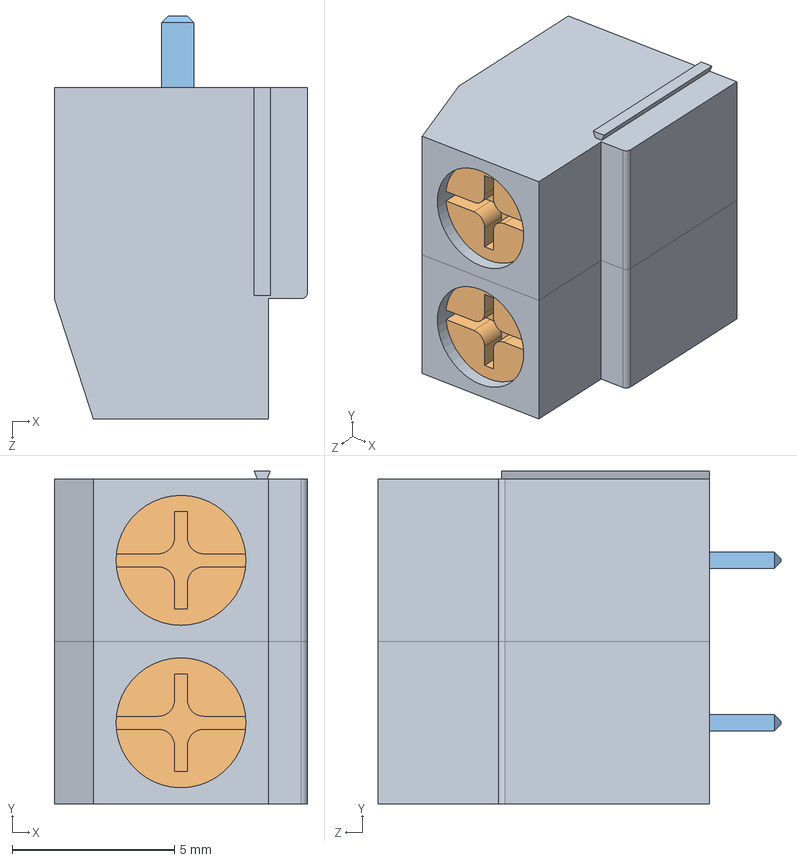
[picture p39: CAD file, 2020-10-18]
3D/(SolidWorks)/Connectors/Cleamm-2_5mm - DG126-5.0-xxP/DG126-5.0-02P.SLDASM
7.80 x 10.2 x 12.4 mm
DG126-5.0-02P_DG126_case x 2
DG126-5.0-02P_Screw x 2
DG126-5.0-02P_DG126_contact x 2
