ElessarCuthalion/KiCAD_library/3D/(SolidWorks)/Furniture/Hinge 1222.01.21 42.5x9mm Assem.SLDASM

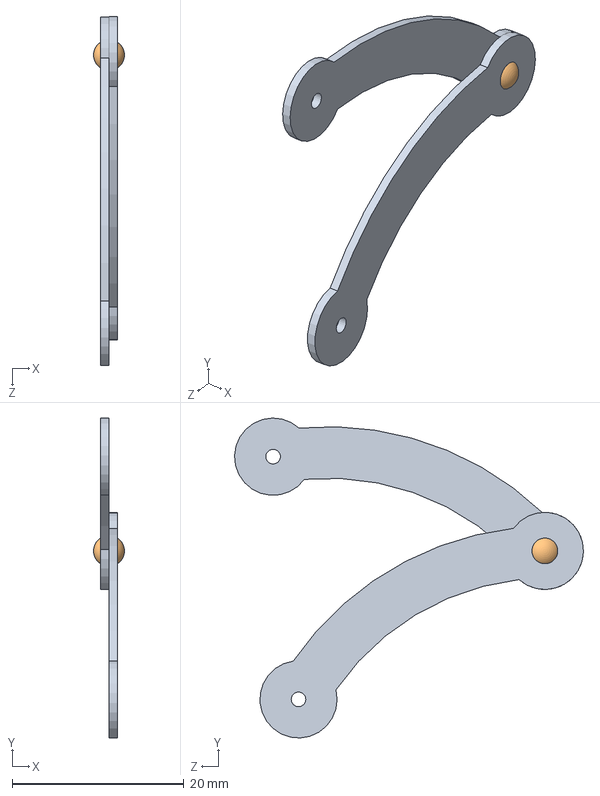
[picture p40: CAD file, 2024-11-10]
3D/(SolidWorks)/Furniture/Hinge 1222.01.21 42.5x9mm Assem.SLDASM
3.60 x 37.3 x 40.6 mm
Деталь1^Hinge 1222.01.21 42.5x9mm Assem x 2
Клёпка^Hinge 1222.01.21 42.5x9mm Assem
