ElessarCuthalion/KiCAD_library/3D/(SolidWorks)/Inductors/Импортированно/4x Ferrite Bead 0804 SMD/User Library-FB-0804-4x.sldasm

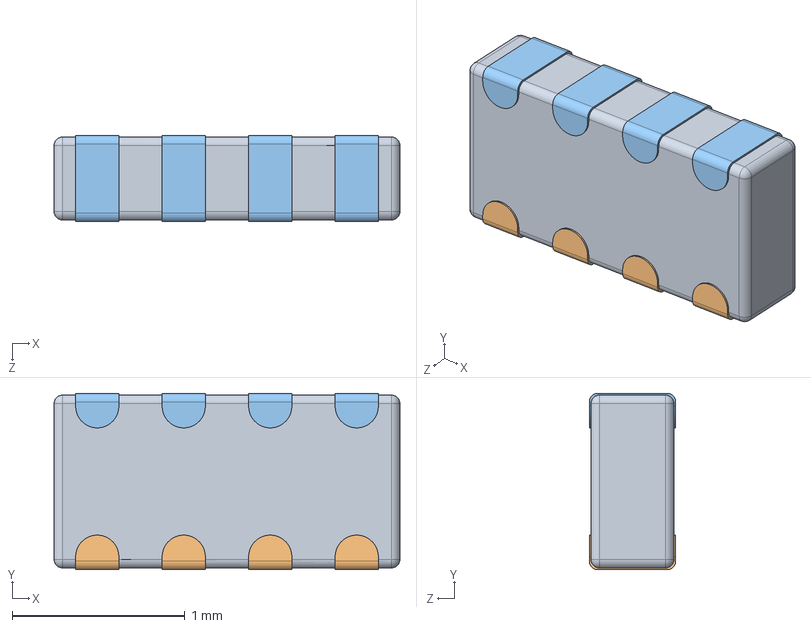
[picture p41: CAD file, 2019-11-27]
3D/(SolidWorks)/Inductors/Импортированно/4x Ferrite Bead 0804 SMD/User Library-FB-0804-4x.sldasm
2.00 x 1.02 x 0.5 mm
User Library-FB-0804-4x_Fillet
User Library-FB-0804-4x_Array
User Library-FB-0804-4x_Clone_of_Array
