ElessarCuthalion/KiCAD_library/3D/(SolidWorks)/Inductors/Импортированно/SDR0403_r.sldasm

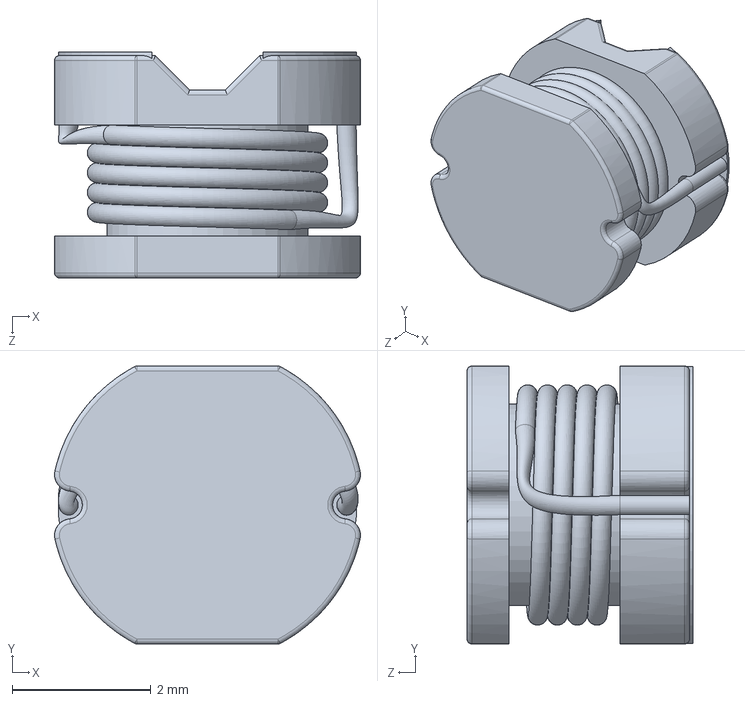
[picture p42: CAD file, 2020-10-14]
3D/(SolidWorks)/Inductors/Импортированно/SDR0403_r.sldasm
4.40 x 4.00 x 3.25 mm
