ElessarCuthalion/KiCAD_library/3D/(SolidWorks)/Installation/Electrician/Компрессор QM 110H MBP Wansheng/Компрессор QM 110H MBP Wansheng.SLDASM

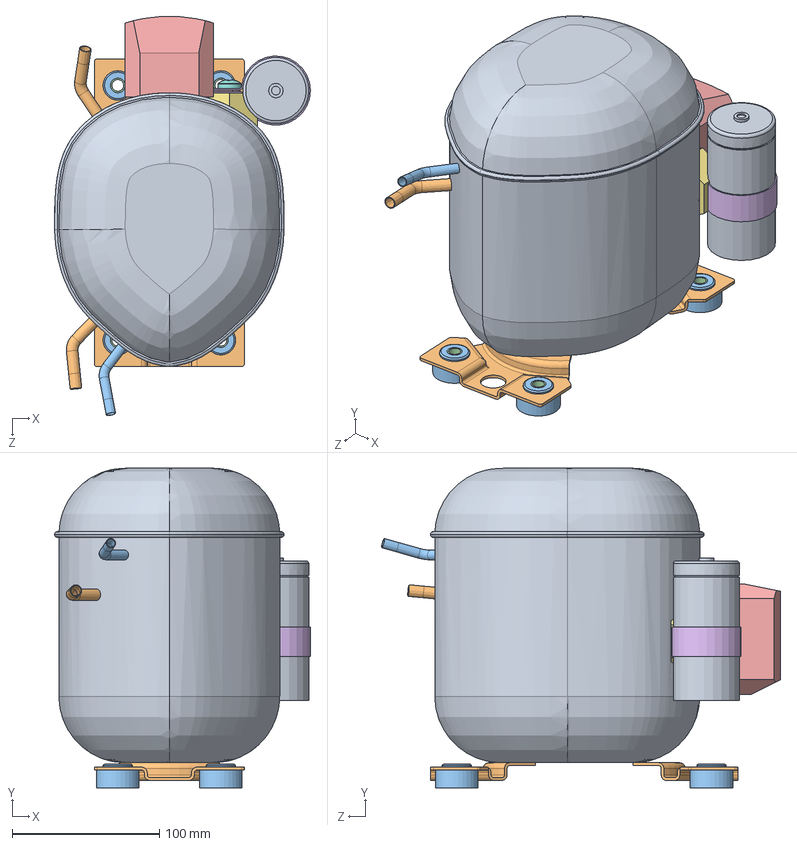
[picture p43: CAD file, 2021-07-01]
3D/(SolidWorks)/Installation/Electrician/Компрессор QM 110H MBP Wansheng/Компрессор QM 110H MBP Wansheng.SLDASM
173.9 x 217.0 x 271.0 mm
Детал компрессора №1
Детал компрессора №2 x 2
Детал компрессора №3 x 4
Детал компрессора №4 x 4
Детал компрессора №5
Детал компрессора №6
hex thin nut gradeb_din
pan head cross recess screw_din
Детал компрессора №7
Детал компрессора №8 x 2
Детал компрессора №8_1
