ElessarCuthalion/KiCAD_library/3D/(SolidWorks)/Installation/Electrician/Микродвигатель ZF 5-13 T4 (220V)/Микродвигатель ZF 5-13 T4.SLDASM

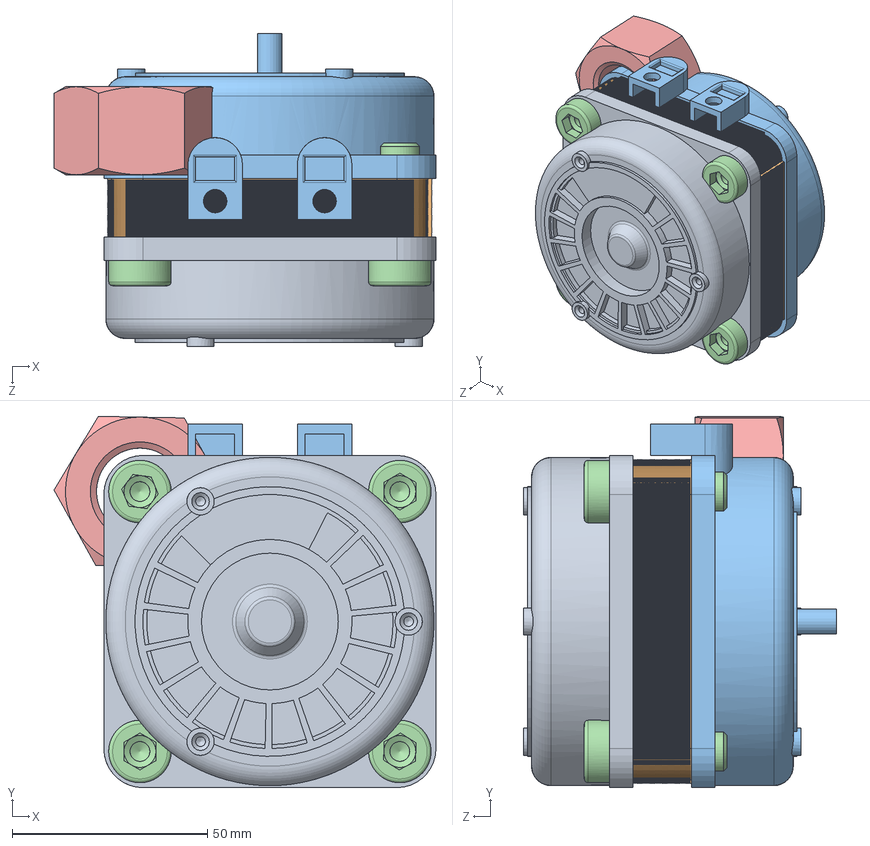
[picture p44: CAD file, 2021-07-01]
3D/(SolidWorks)/Installation/Electrician/Микродвигатель ZF 5-13 T4 (220V)/Микродвигатель ZF 5-13 T4.SLDASM
97.7 x 95.0 x 80.0 mm
Микродвигатель - деталь №1
Микродвигатель - деталь №2
Микродвигатель - деталь №3
socket thin pilot cap screw_din x 4
