ElessarCuthalion/KiCAD_library/3D/(SolidWorks)/Installation/Electrician/Электромагнитный клапан G1-2/Электромагнитный клапан G1-2.SLDASM

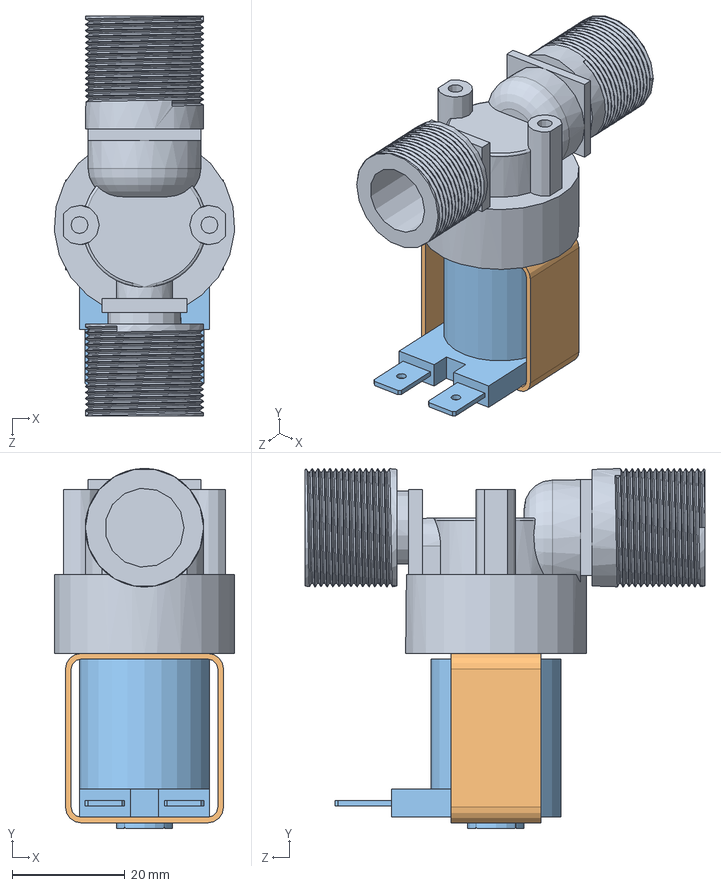
[picture p45: CAD file, 2021-07-01]
3D/(SolidWorks)/Installation/Electrician/Электромагнитный клапан G1-2/Электромагнитный клапан G1-2.SLDASM
31.9 x 63.7 x 70.8 mm
ЭК1 8 мм
ЭК2 8 мм
ЭК3 8 мм
