ElessarCuthalion/KiCAD_library/3D/(SolidWorks)/QFN_DFN_LGA/Импортированно/R-PWSON-N16/User Library-R-PWSON-N16.sldasm

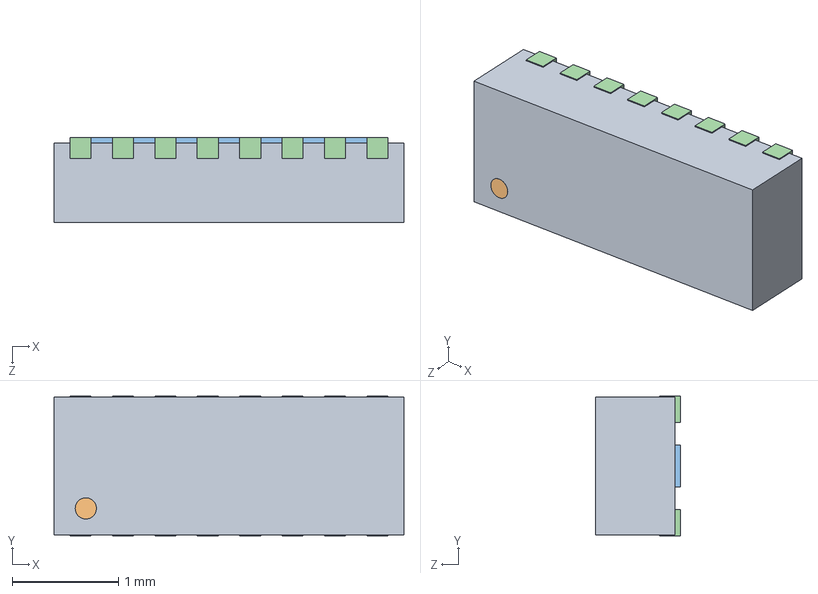
[picture p46: CAD file, 2019-11-27]
3D/(SolidWorks)/QFN_DFN_LGA/Импортированно/R-PWSON-N16/User Library-R-PWSON-N16.sldasm
3.30 x 1.32 x 0.801 mm
User Library-R-PWSON-N16_Pad
User Library-R-PWSON-N16_Cylinder
User Library-R-PWSON-N16_Pad001
User Library-R-PWSON-N16_Compound002
