ElessarCuthalion/KiCAD_library/3D/(SolidWorks)/Connectors/Импортированно/USB-B-S-X-W-TH/User Library-Samtec - USB-B-S-X-W-TH.sldasm

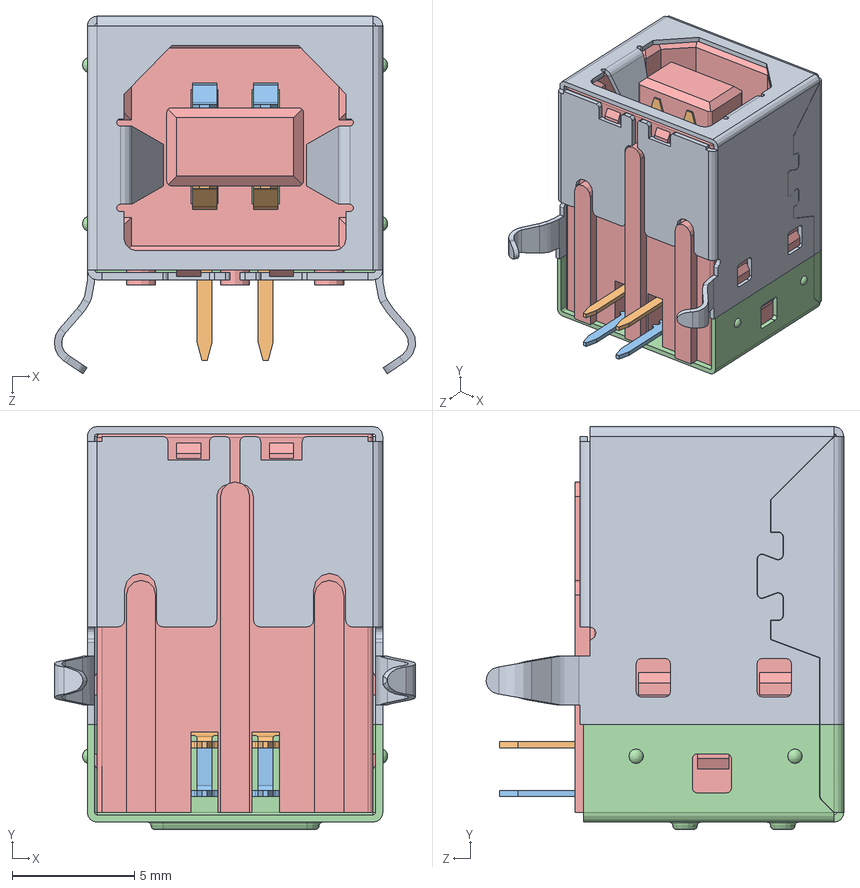
[picture p47: CAD file, 2020-06-04]
3D/(SolidWorks)/Connectors/Импортированно/USB-B-S-X-W-TH/User Library-Samtec - USB-B-S-X-W-TH.sldasm
14.8 x 16.5 x 14.6 mm
User Library-Samtec - USB-B-S-X-W-TH_shell-USB BF TH____2
User Library-Samtec - USB-B-S-X-W-TH_contact01-USB BF TH____2 x 2
User Library-Samtec - USB-B-S-X-W-TH_contact02-USB BF TH____2 x 2
User Library-Samtec - USB-B-S-X-W-TH_rear shell-USB BF TH____2
User Library-Samtec - USB-B-S-X-W-TH_housing-USB BF TH____2
