ElessarCuthalion/KiCAD_library/3D/(SolidWorks)/Inductors/Импортированно/SDE0805/User Library-Inductor_SDE0805.sldasm

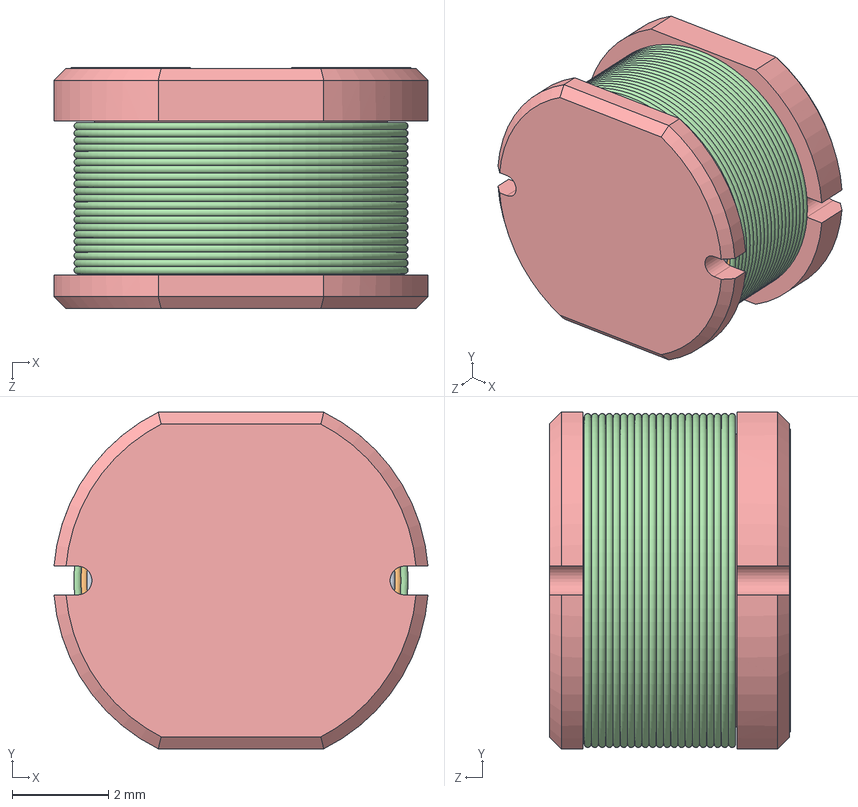
[picture p48: CAD file, 2019-11-27]
3D/(SolidWorks)/Inductors/Импортированно/SDE0805/User Library-Inductor_SDE0805.sldasm
7.78 x 7.00 x 5.02 mm
User Library-Inductor_SDE0805_Array002
User Library-Inductor_SDE0805_Array001
User Library-Inductor_SDE0805_Pad003
User Library-Inductor_SDE0805_Array
User Library-Inductor_SDE0805_Cut002
