ElessarCuthalion/KiCAD_library/3D/(SolidWorks)/Opto/Импортированно/opto MOC8050SR2M_SMDIP-6/MOC8050SR2M.sldasm

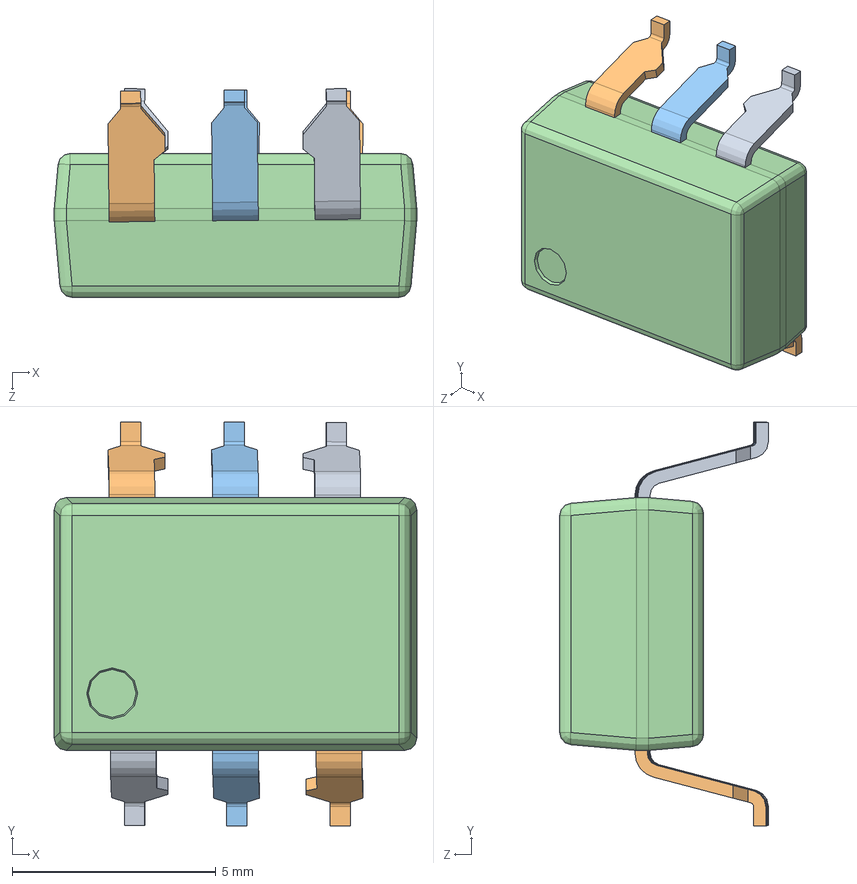
[picture p49: CAD file, 2020-10-09]
3D/(SolidWorks)/Opto/Импортированно/opto MOC8050SR2M_SMDIP-6/MOC8050SR2M.sldasm
8.89 x 9.90 x 5.12 mm
MOC8050SR2M_dipso6leadbumpr_1 x 2
MOC8050SR2M_dipso6leadbumpl_1 x 2
MOC8050SR2M_dipso6lead_1 x 2
MOC8050SR2M_dipso6body_1
