ElessarCuthalion/KiCAD_library/3D/(SolidWorks)/Power/ResettableFuse/MF-R250/User Library-MF-R250.sldasm

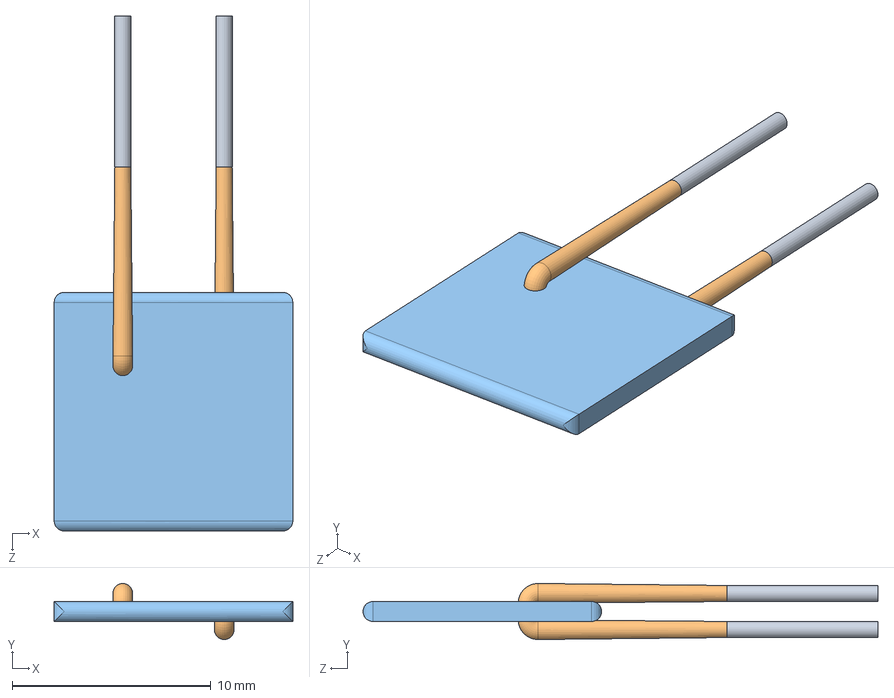
[picture p50: CAD file, 2023-06-21]
3D/(SolidWorks)/Power/ResettableFuse/MF-R250/User Library-MF-R250.sldasm
12.0 x 2.82 x 25.9 mm
User Library-MF-R250_LEAD x 2
User Library-MF-R250_LEAD_BODY x 2
User Library-MF-R250_BODY
User Library-MF-R250_STRING
