ElessarCuthalion/KiCAD_library/3D/(SolidWorks)/Installation/Electrician/IEC_FILTER (B84771A0015A000, 15A 250V) - импортированно/IEC_FILTER (B84771A0015A000, 15A 250V).SLDASM

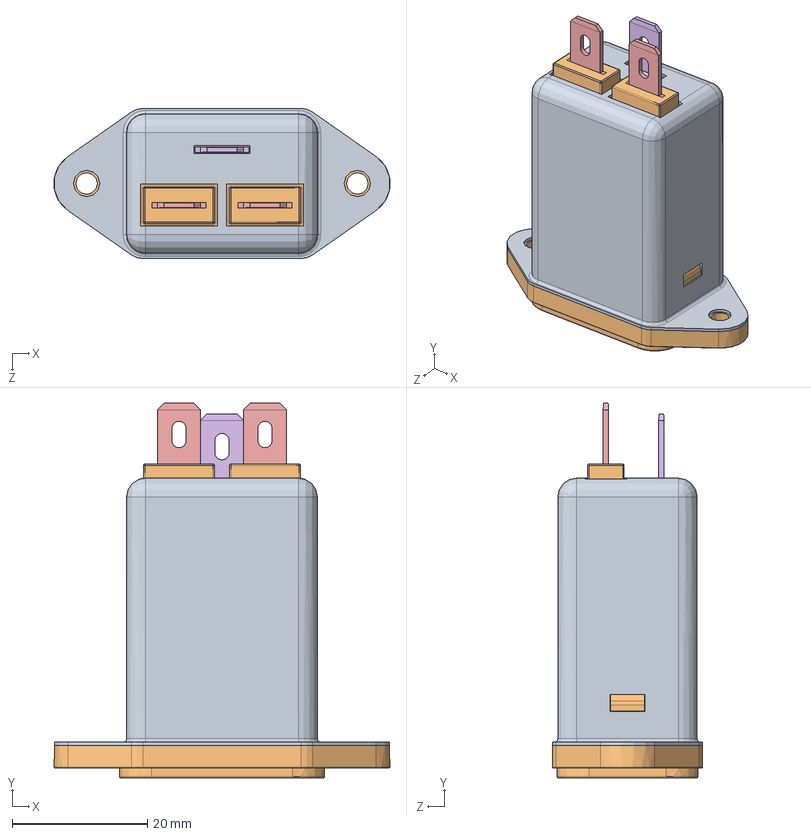
[picture p51: CAD file, 2021-07-02]
3D/(SolidWorks)/Installation/Electrician/IEC_FILTER (B84771A0015A000, 15A 250V) - импортированно/IEC_FILTER (B84771A0015A000, 15A 250V).SLDASM
49.6 x 55.4 x 22.2 mm
IEC_FILTER_SHELL
IEC_FILTER_PLASTIC
IEC_FILTER_EARTH_PIN
IEC_FILTER_L-N_PIN x 2
IEC_FILTER_L-N_TAB x 2
IEC_FILTER_EARTH_TAB
