ElessarCuthalion/KiCAD_library/3D/(SolidWorks)/Installation/Electrician/Мотор S55JXRKM-8100 + насос роторный PS-204 (200) (Бритта)/Мотор S55JXRKM-8100.SLDASM

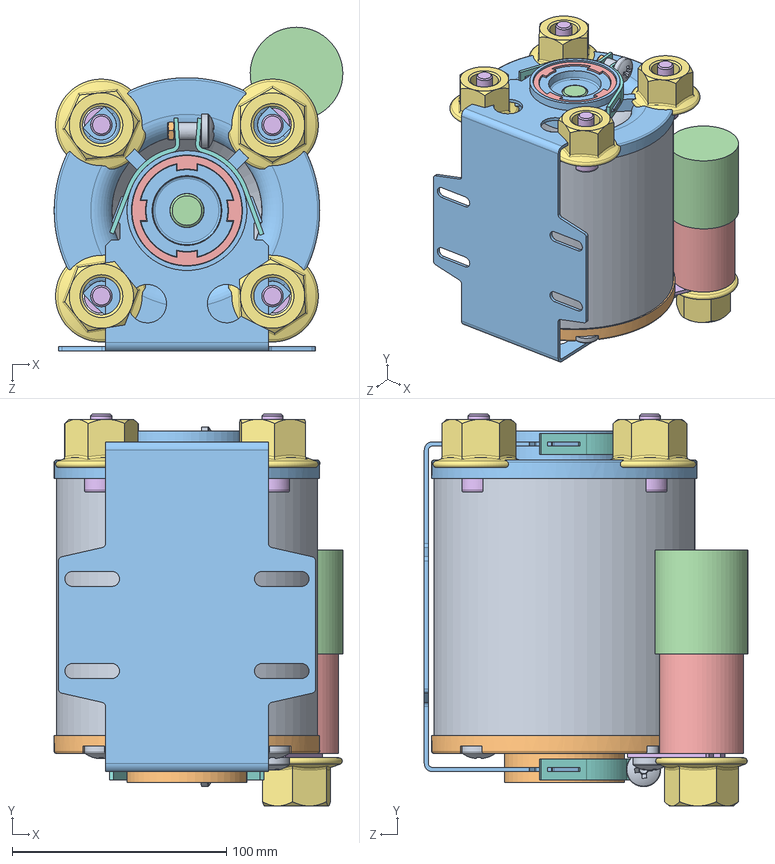
[picture p52: CAD file, 2021-07-01]
3D/(SolidWorks)/Installation/Electrician/Мотор S55JXRKM-8100 + насос роторный PS-204 (200) (Бритта)/Мотор S55JXRKM-8100.SLDASM
134.8 x 183.0 x 151.1 mm
МНБ№1
МНБ№2
МНБ№3
МНБ№4
МНБ№5
socket thin pilot cap screw_din x 4
hex flange nut_din x 5
МНБ№6 x 4
pan head cross recess screw_din x 7
hex thin nut chamfered gradeab_din x 2
МНБ№7
ДН7
ДН8
МНБ№8
