ElessarCuthalion/KiCAD_library/3D/(SolidWorks)/Connectors/Импортированно/MicroSD Socket 112C-TXAR-R02_C_1 (с крышкой)/112C-TXAR-R02_C_1.sldasm

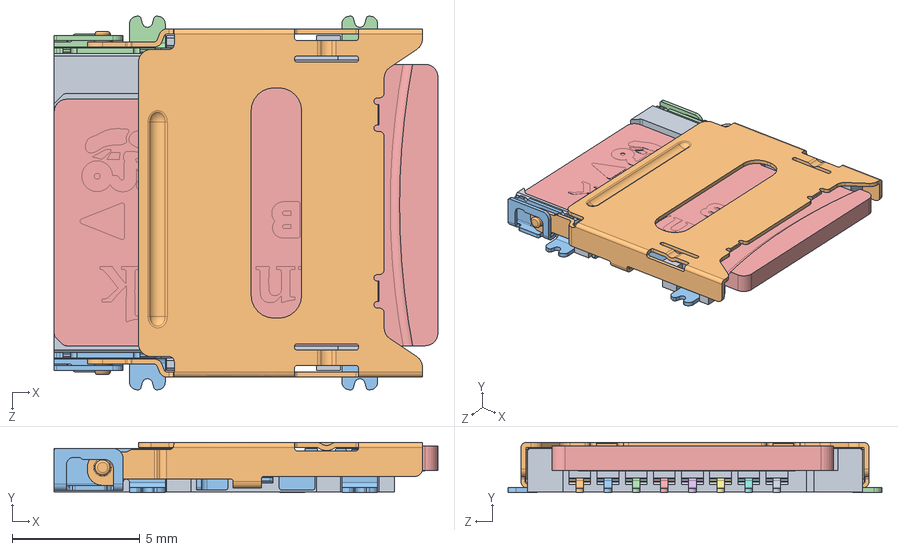
[picture p53: CAD file, 2019-11-27]
3D/(SolidWorks)/Connectors/Импортированно/MicroSD Socket 112C-TXAR-R02_C_1 (с крышкой)/112C-TXAR-R02_C_1.sldasm
15.0 x 1.96 x 14.6 mm
User Library-112C-TXAR-R02_C_1_201-1
User Library-112C-TXAR-R02_C_1_301-1
User Library-112C-TXAR-R02_C_1_301_1-1
User Library-112C-TXAR-R02_C_1_301_2-1
User Library-112C-TXAR-R02_C_1_301_3-1
User Library-112C-TXAR-R02_C_1_301_4-1
User Library-112C-TXAR-R02_C_1_301_5-1
User Library-112C-TXAR-R02_C_1_301_6-1
User Library-112C-TXAR-R02_C_1_301_7-1
User Library-112C-TXAR-R02_C_1_401-1
User Library-112C-TXAR-R02_C_1_402_L-F-1
User Library-112C-TXAR-R02_C_1_402_R-F-1
Micro-SD card
