ElessarCuthalion/KiCAD_library/3D/(SolidWorks)/Battery_&_Holders/Импортированно/BatteryHolder CR2032 - CH7410/User Library-bat_holder_ch7410_2032.sldasm

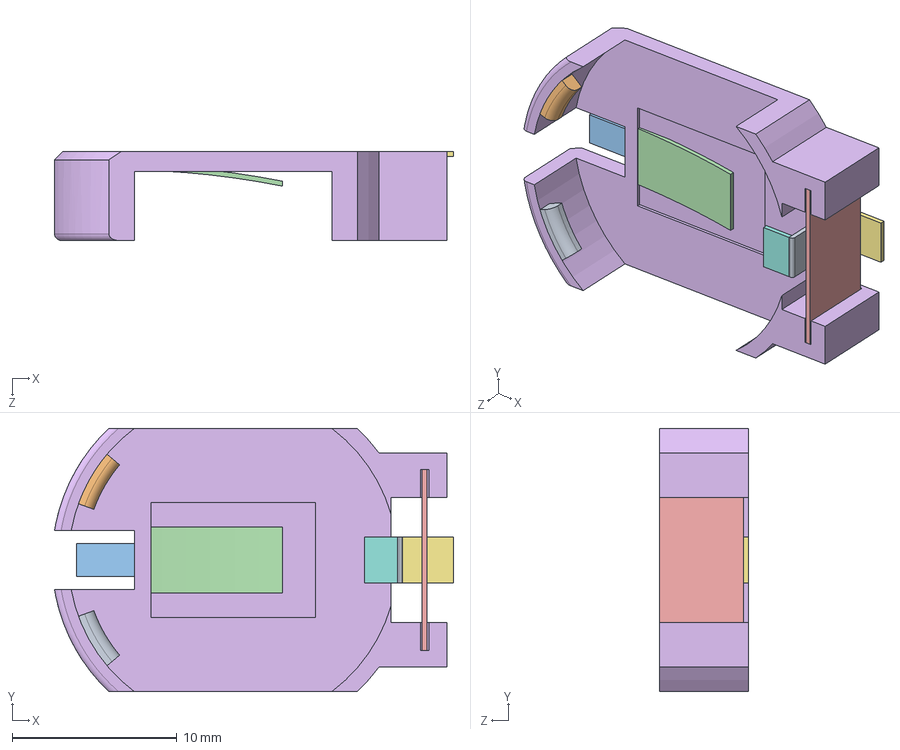
[picture p54: CAD file, 2020-10-09]
3D/(SolidWorks)/Battery_&_Holders/Импортированно/BatteryHolder CR2032 - CH7410/User Library-bat_holder_ch7410_2032.sldasm
24.3 x 16.0 x 5.40 mm
User Library-bat_holder_ch7410_2032_Fillet001
User Library-bat_holder_ch7410_2032_Fillet002
User Library-bat_holder_ch7410_2032_kont1
User Library-bat_holder_ch7410_2032_Revolve002
User Library-bat_holder_ch7410_2032_kont4
User Library-bat_holder_ch7410_2032_Cut007
User Library-bat_holder_ch7410_2032_Cube005
User Library-bat_holder_ch7410_2032_Cube007
User Library-bat_holder_ch7410_2032_Fillet003
