ElessarCuthalion/KiCAD_library/3D/(SolidWorks)/Installation/Clamp GH-201A.SLDASM

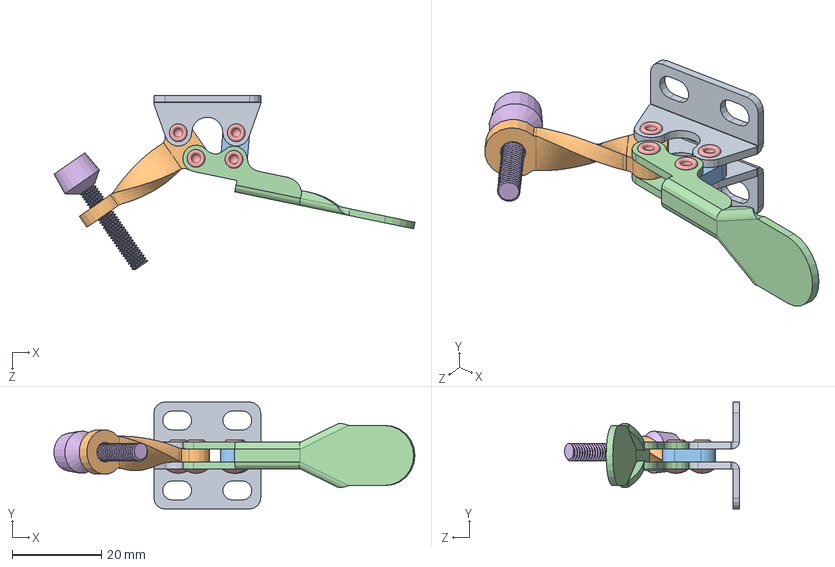
[picture p55: CAD file, 2024-12-10]
3D/(SolidWorks)/Installation/Clamp GH-201A.SLDASM
81.0 x 24.0 x 39.2 mm
Деталь1^Clamp CH-201A x 2
Деталь2^Clamp CH-201A
Деталь3^Clamp CH-201A
Деталь4^Clamp CH-201A
Деталь5^Clamp CH-201A x 4
Деталь6^Clamp CH-201A
