ElessarCuthalion/KiCAD_library/3D/(SolidWorks)/Installation/Electrician/Насос циркуляционный БелАвтоКомплект БАК.32118 отопительный 75.3730 12V D18/Насос отопительный БелАК БАК.32118.SLDASM

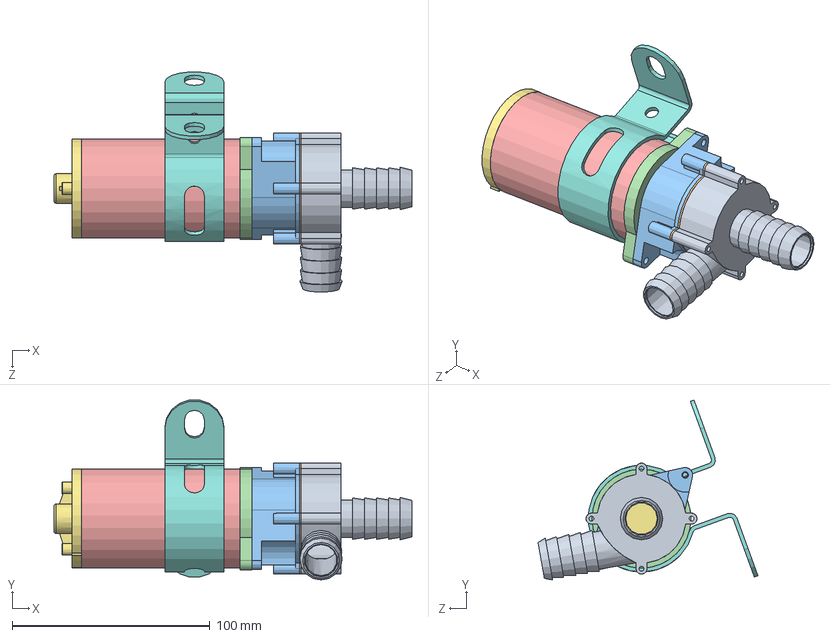
[picture p56: CAD file, 2021-07-01]
3D/(SolidWorks)/Installation/Electrician/Насос циркуляционный БелАвтоКомплект БАК.32118 отопительный 75.3730 12V D18/Насос отопительный БелАК БАК.32118.SLDASM
181.0 x 91.0 x 111.2 mm
НБ1
НБ2
НБ3
НБ4
НБ5
НБ6
НБ7
НБ8
