ElessarCuthalion/KiCAD_library/3D/(SolidWorks)/QFN_DFN_LGA/Импортированно/MP4432 (QFN16_3mmx4mm)/User Library-MP4432(QFN-16-3mmx4mm).sldasm

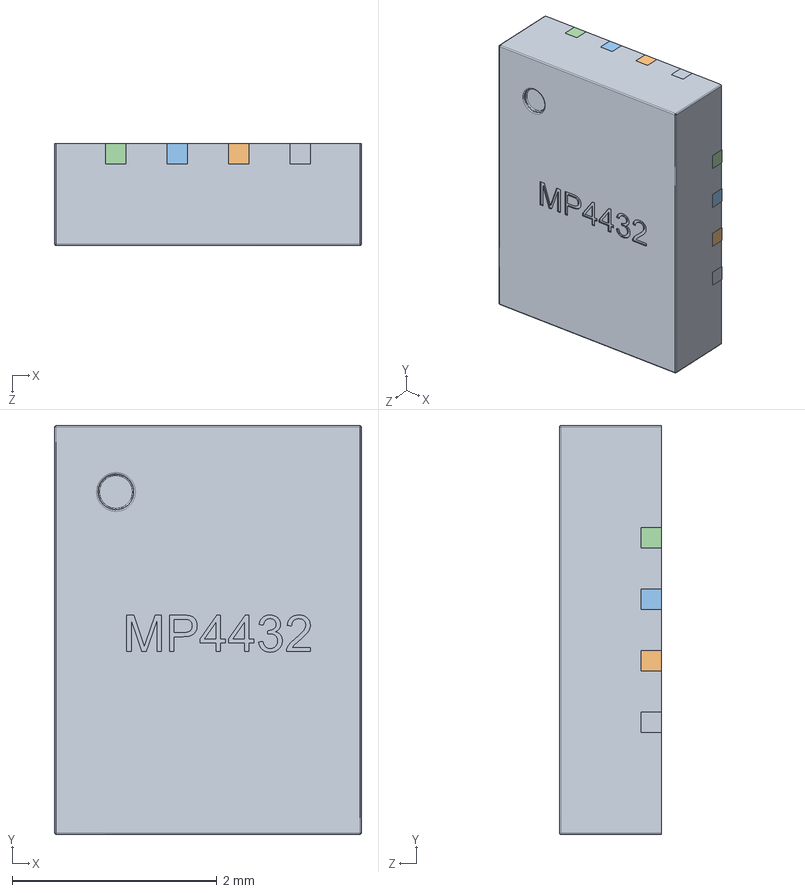
[picture p57: CAD file, 2020-01-04]
3D/(SolidWorks)/QFN_DFN_LGA/Импортированно/MP4432 (QFN16_3mmx4mm)/User Library-MP4432(QFN-16-3mmx4mm).sldasm
3.00 x 4.00 x 1.00 mm
User Library-MP4432(QFN-16-3mmx4mm)_Part_869
User Library-MP4432(QFN-16-3mmx4mm)_Part_868
User Library-MP4432(QFN-16-3mmx4mm)_Part_867
User Library-MP4432(QFN-16-3mmx4mm)_Part_866
User Library-MP4432(QFN-16-3mmx4mm)_Part_508
User Library-MP4432(QFN-16-3mmx4mm)_Part_536
User Library-MP4432(QFN-16-3mmx4mm)_Part_564
User Library-MP4432(QFN-16-3mmx4mm)_Part_592
User Library-MP4432(QFN-16-3mmx4mm)_Part_643
User Library-MP4432(QFN-16-3mmx4mm)_Part_671
User Library-MP4432(QFN-16-3mmx4mm)_Part_699
User Library-MP4432(QFN-16-3mmx4mm)_Part_727
User Library-MP4432(QFN-16-3mmx4mm)_Part_754
User Library-MP4432(QFN-16-3mmx4mm)_Part_865
User Library-MP4432(QFN-16-3mmx4mm)_Part_864
User Library-MP4432(QFN-16-3mmx4mm)_Part_862
User Library-MP4432(QFN-16-3mmx4mm)_Part_3738
