ElessarCuthalion/KiCAD_library/3D/(SolidWorks)/Installation/Electrician/Конденсатор BS-ACC-A2-120 B2,1 Belief + Микродвигатель ZF 5-13 T4/Конденсатор BS-ACC-A2-120 B2,1 Belief.SLDASM

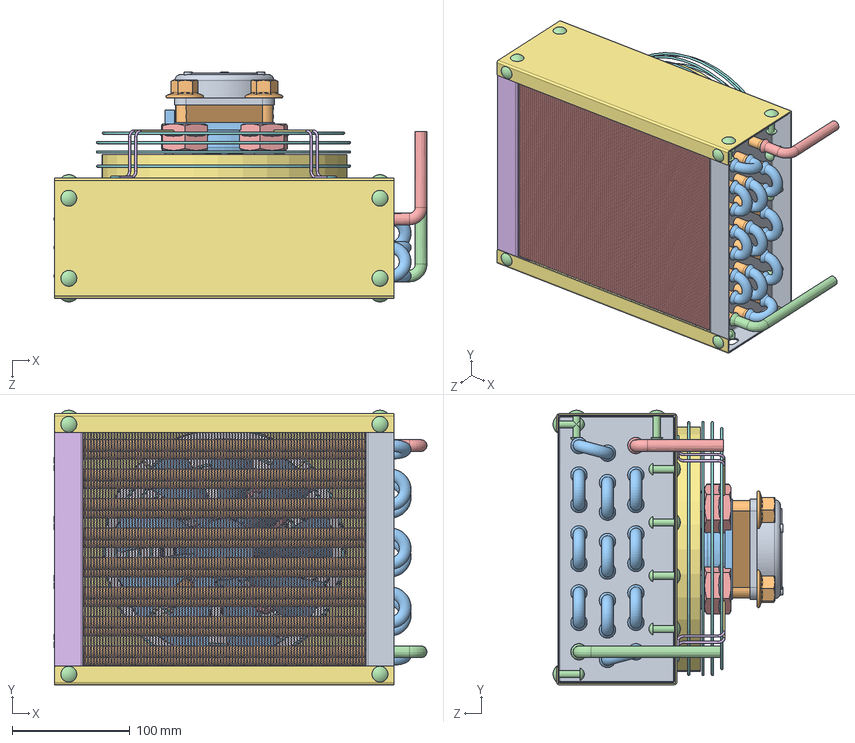
[picture p58: CAD file, 2021-07-01]
3D/(SolidWorks)/Installation/Electrician/Конденсатор BS-ACC-A2-120 B2,1 Belief + Микродвигатель ZF 5-13 T4/Конденсатор BS-ACC-A2-120 B2,1 Belief.SLDASM
316.5 x 233.0 x 195.1 mm
Деталь конденсатора №1
Деталь конденсатора №2 x 24
Деталь конденсатора №3 x 23
Деталь конденсатора №4
Деталь конденсатора №5
Деталь конденсатора №1_2
Деталь конденсатора №6
Деталь конденсатора №7
Микродвигатель - деталь №1
Микродвигатель - деталь №2
Микродвигатель - деталь №3
socket thin pilot cap screw_din x 4
hex nut style 2 gradeab_din x 4
Деталь конденсатора №8_1 x 8
Деталь конденсатора №8_2 x 4
Деталь конденсатора №8_3 x 4
hex flange nut_din x 4
hex flange bolt_din x 4
Лопости конденсатора
rivet 07_din x 16
Деталь конденсатора №9 x 96
