ElessarCuthalion/KiCAD_library/3D/(SolidWorks)/! Examples/Сквозной вырез для саморезов впотай D2.0mm, шляпка D4mm, WoodFill.SLDPRT

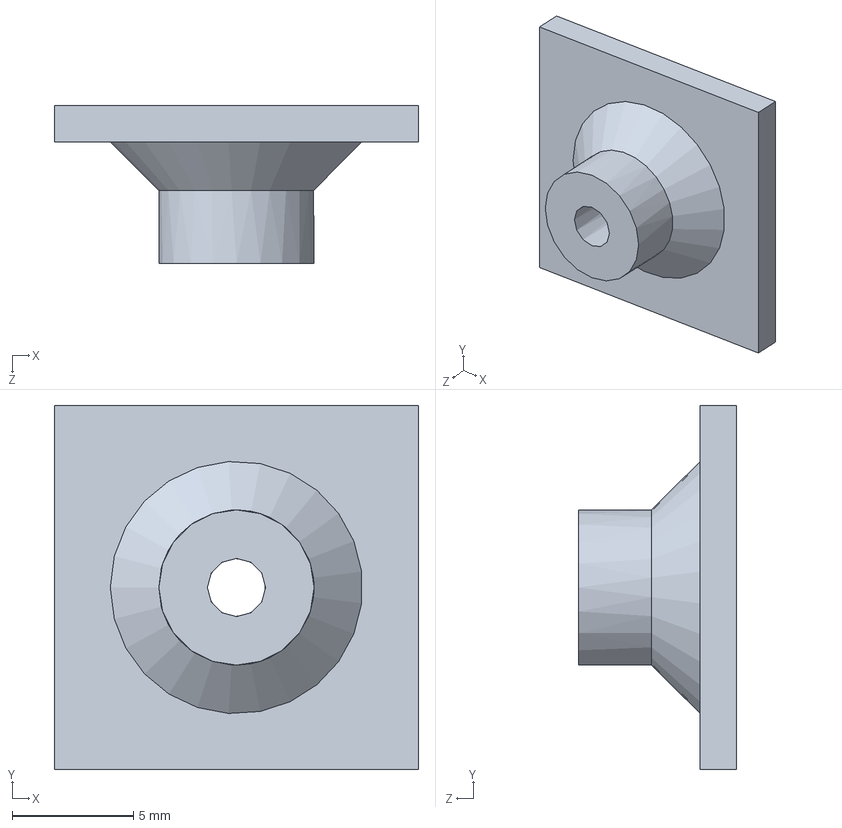
[picture p60: CAD file, 2022-12-21]
3D/(SolidWorks)/! Examples/Сквозной вырез для саморезов впотай D2.0mm, шляпка D4mm, WoodFill.SLDPRT
15.0 x 15.0 x 6.50 mm
