ElessarCuthalion/KiCAD_library/3D/(SolidWorks)/Battery_&_Holders/BatHolder 3xAA/Part3.SLDPRT

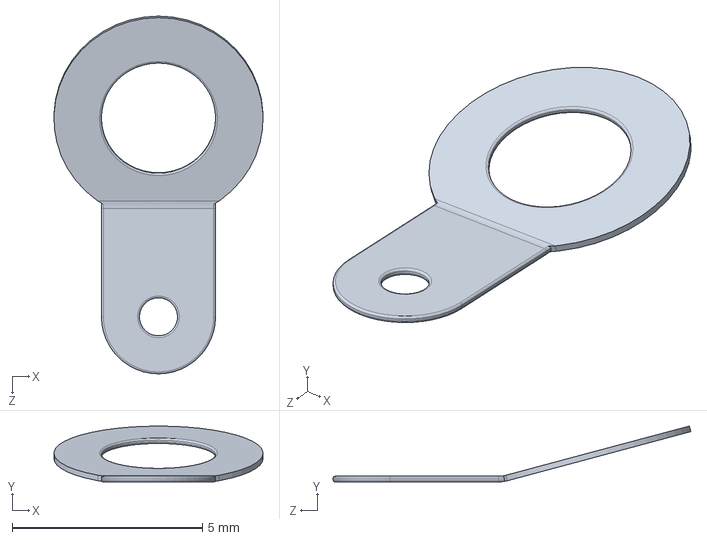
[picture p61: CAD file, 2019-11-18]
3D/(SolidWorks)/Battery_&_Holders/BatHolder 3xAA/Part3.SLDPRT
5.50 x 1.47 x 9.41 mm
