ElessarCuthalion/KiCAD_library/3D/(SolidWorks)/Battery_&_Holders/Li-Pol_41x20x5.8_602040_500mAh.SLDPRT

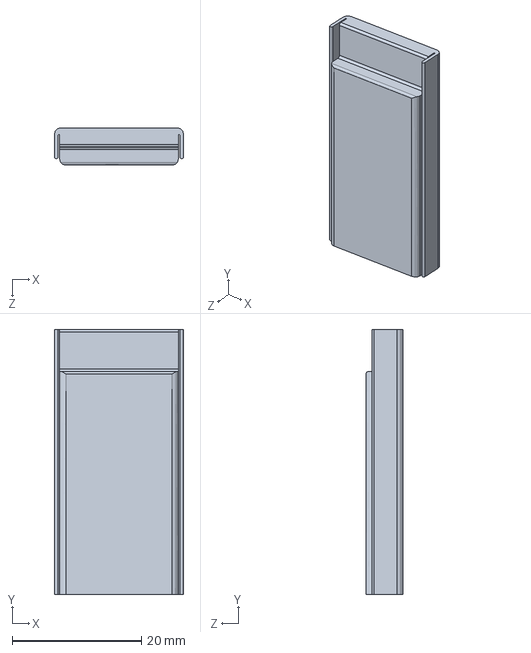
[picture p62: CAD file, 2026-03-27]
3D/(SolidWorks)/Battery_&_Holders/Li-Pol_41x20x5.8_602040_500mAh.SLDPRT
20.0 x 41.0 x 5.80 mm
