ElessarCuthalion/KiCAD_library/3D/(SolidWorks)/Battery_&_Holders/Импортированно/BatteryHolder CR2032 - CH7410/User Library-bat_holder_ch7410_2032_Fillet002.sldprt

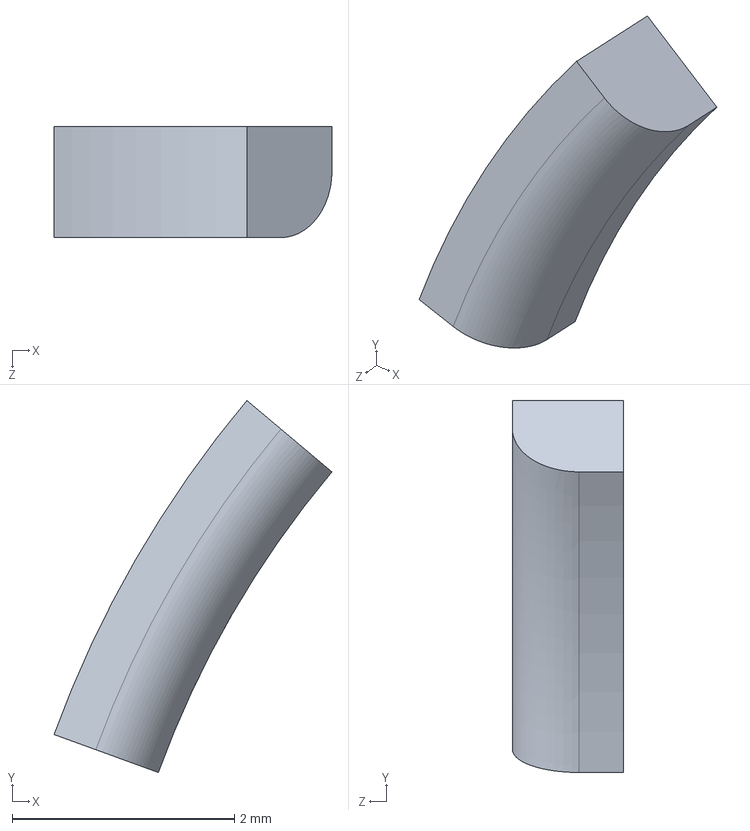
[picture p63: CAD file, 2020-10-09]
3D/(SolidWorks)/Battery_&_Holders/Импортированно/BatteryHolder CR2032 - CH7410/User Library-bat_holder_ch7410_2032_Fillet002.sldprt
2.50 x 3.35 x 1.00 mm
