ElessarCuthalion/KiCAD_library/3D/(SolidWorks)/Bearings/+/Ball Bearing _312 ID, _500 OD, _156 W.sldprt

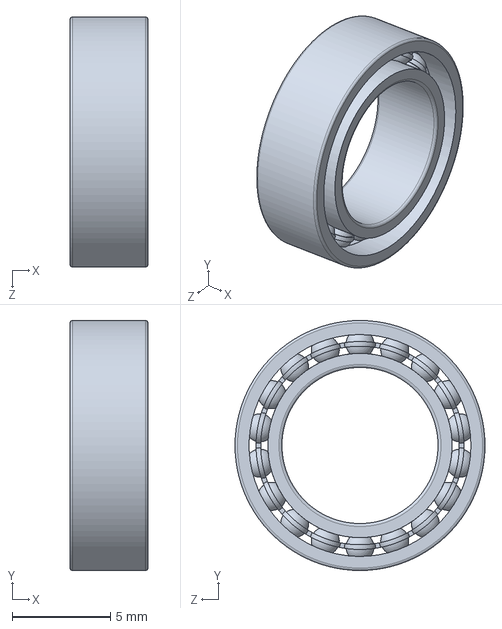
[picture p64: CAD file, 2019-12-09]
3D/(SolidWorks)/Bearings/+/Ball Bearing _312 ID, _500 OD, _156 W.sldprt
3.97 x 12.7 x 12.7 mm
