ElessarCuthalion/KiCAD_library/3D/(SolidWorks)/Bearings/Ball Bearing D8x22h7 608ZZ.STEP

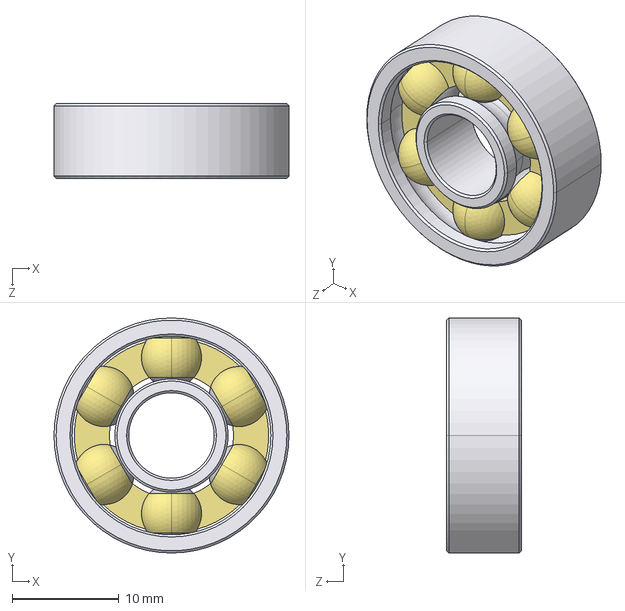
[picture p65: CAD file, 2021-12-15]
3D/(SolidWorks)/Bearings/Ball Bearing D8x22h7 608ZZ.STEP
22.0 x 22.0 x 7.00 mm
