ElessarCuthalion/KiCAD_library/3D/(SolidWorks)/Buttons_Switches/+/DIP SW SMT 2pos.sldprt

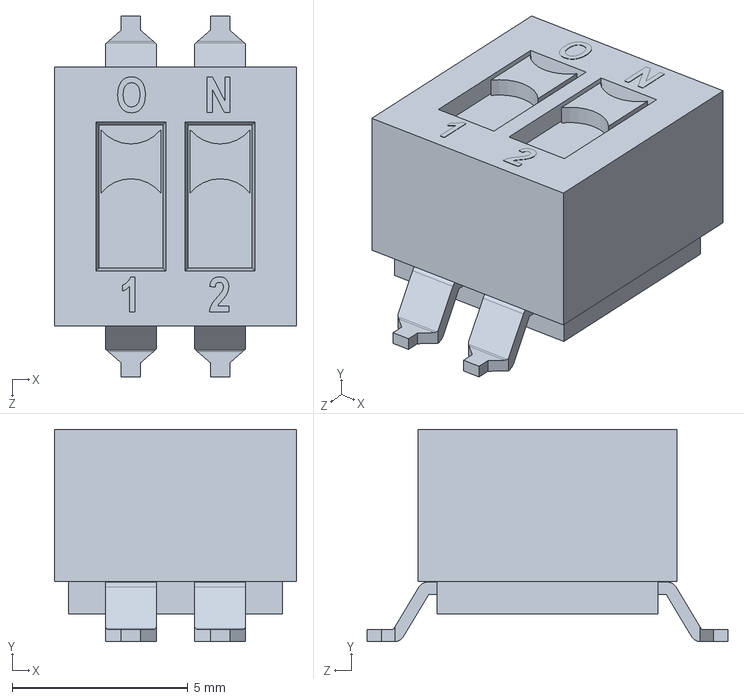
[picture p66: CAD file, 2019-11-22]
3D/(SolidWorks)/Buttons_Switches/+/DIP SW SMT 2pos.sldprt
6.90 x 6.05 x 10.3 mm
