ElessarCuthalion/KiCAD_library/3D/(SolidWorks)/Buttons_Switches/Reed Switch Glass 14.5x2.3mm (МКА-14103) hinged.SLDPRT

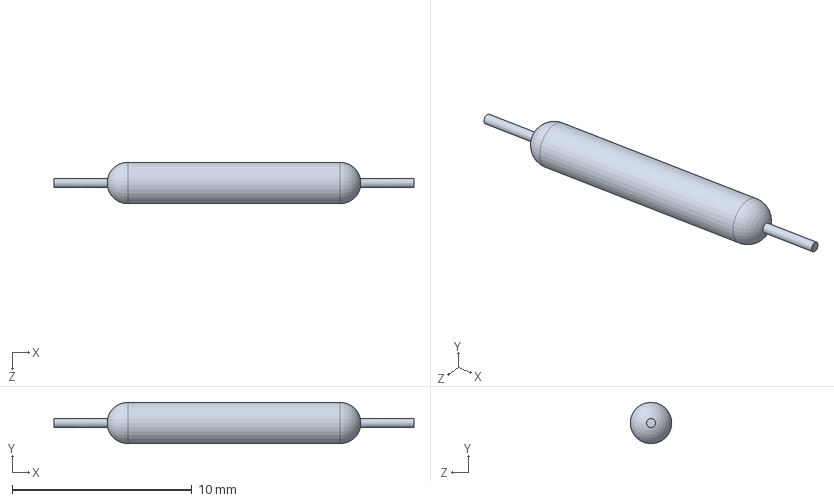
[picture p67: CAD file, 2022-10-23]
3D/(SolidWorks)/Buttons_Switches/Reed Switch Glass 14.5x2.3mm (МКА-14103) hinged.SLDPRT
20.0 x 2.29 x 2.30 mm
