ElessarCuthalion/KiCAD_library/3D/(SolidWorks)/Buttons_Switches/Импортированно/Button 12x12x12 DIP - SWT 12x12x12.SLDPRT

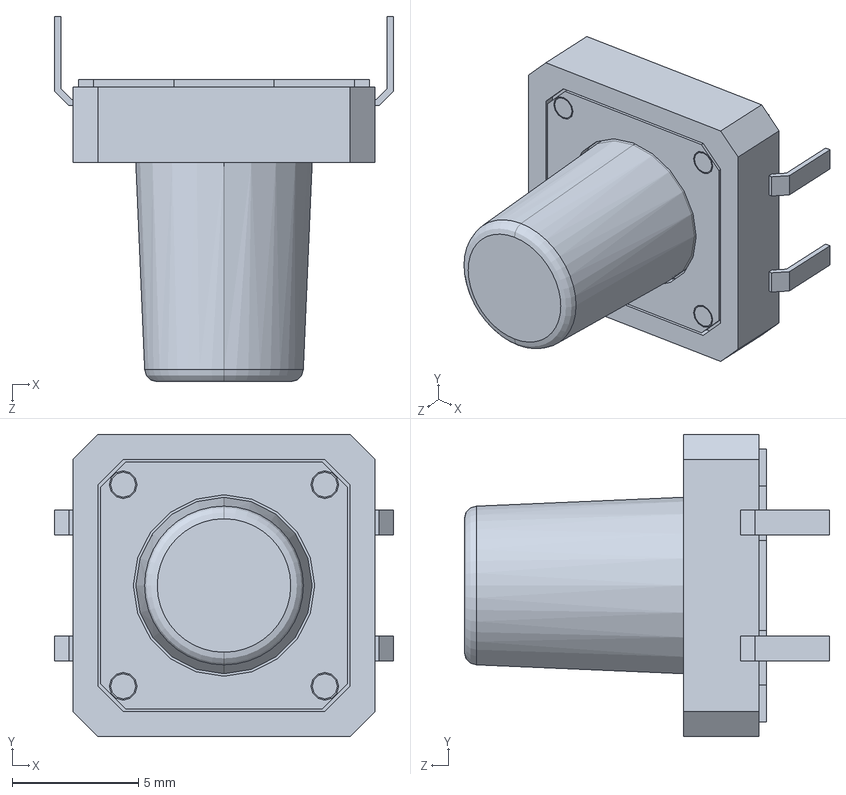
[picture p68: CAD file, 2024-12-22]
3D/(SolidWorks)/Buttons_Switches/Импортированно/Button 12x12x12 DIP - SWT 12x12x12.SLDPRT
13.5 x 12.0 x 14.5 mm
