ElessarCuthalion/KiCAD_library/3D/(SolidWorks)/Capacitors/CAP_DIP_5.0mm Vishay Kxxxx15 Series.SLDPRT

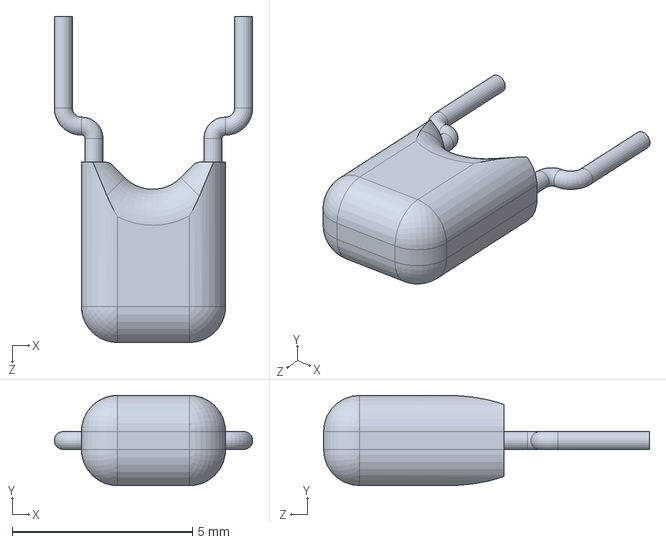
[picture p69: CAD file, 2023-04-18]
3D/(SolidWorks)/Capacitors/CAP_DIP_5.0mm Vishay Kxxxx15 Series.SLDPRT
5.50 x 2.50 x 9.04 mm
