ElessarCuthalion/KiCAD_library/3D/(SolidWorks)/Capacitors/Импортированно/CAP_pol_DIP_D6.3x11mm.SLDPRT

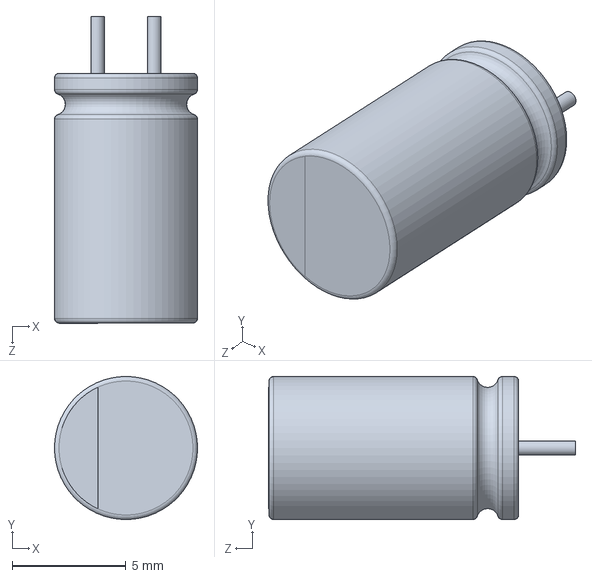
[picture p70: CAD file, 2023-04-27]
3D/(SolidWorks)/Capacitors/Импортированно/CAP_pol_DIP_D6.3x11mm.SLDPRT
6.30 x 6.30 x 13.5 mm
