ElessarCuthalion/KiCAD_library/3D/(SolidWorks)/Cases/Clock_47mm.step.SLDPRT

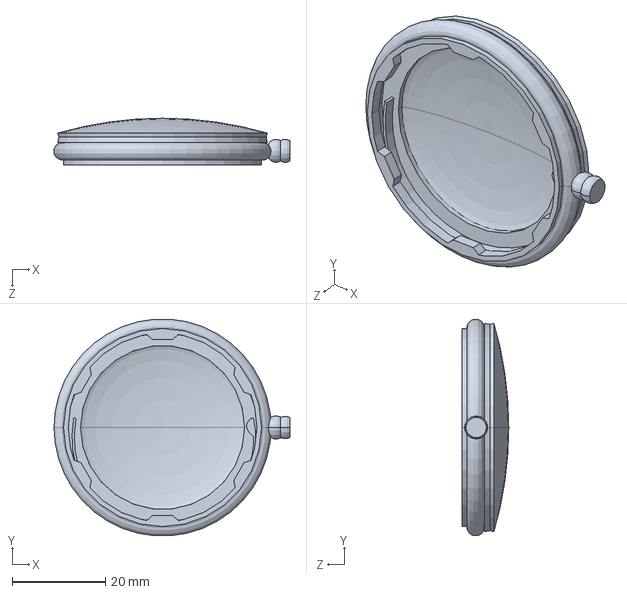
[picture p71: CAD file, 2020-04-10]
3D/(SolidWorks)/Cases/Clock_47mm.step.SLDPRT
50.6 x 46.5 x 10.0 mm
