ElessarCuthalion/KiCAD_library/3D/(SolidWorks)/Connectors/+/USB Type-C 6pin.sldprt

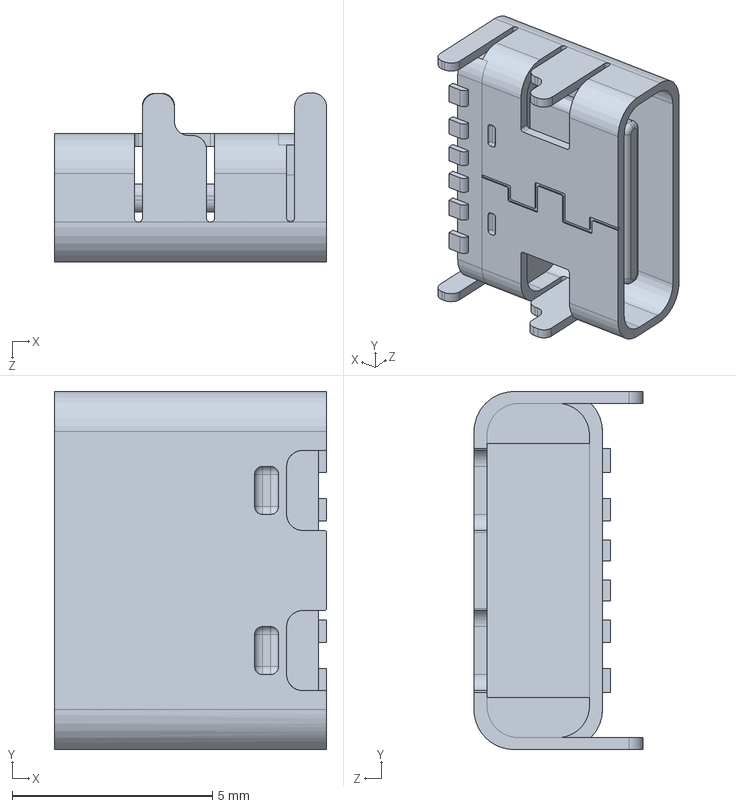
[picture p72: CAD file, 2025-06-27]
3D/(SolidWorks)/Connectors/+/USB Type-C 6pin.sldprt
6.80 x 8.94 x 4.22 mm
