ElessarCuthalion/KiCAD_library/3D/(SolidWorks)/Connectors/_Plug's/_Импортированно/RJ-45 plug - Molex 44915-0001.STEP

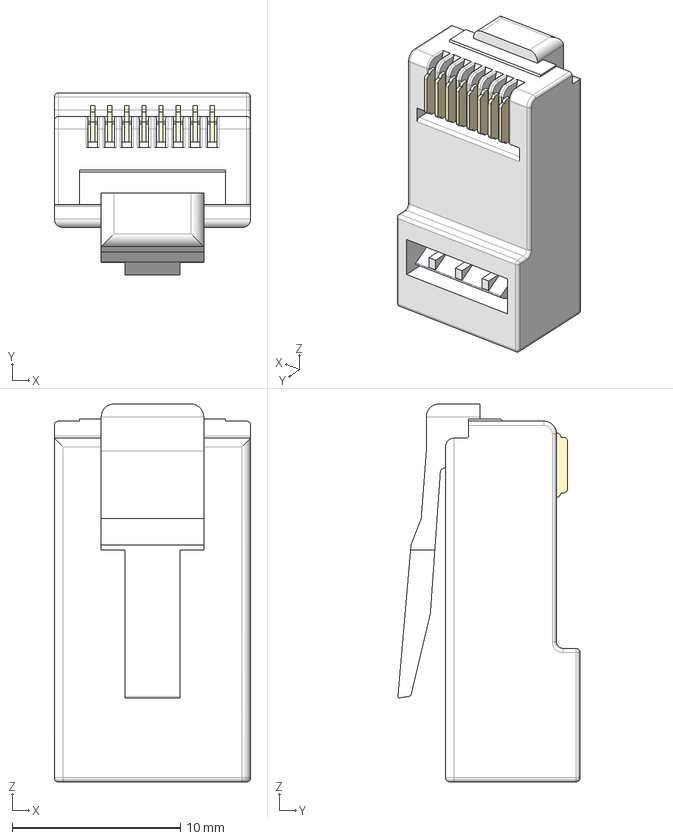
[picture p73: CAD file, 2020-08-14]
3D/(SolidWorks)/Connectors/_Plug's/_Импортированно/RJ-45 plug - Molex 44915-0001.STEP
11.7 x 10.8 x 22.5 mm
