ElessarCuthalion/KiCAD_library/3D/(SolidWorks)/Connectors/_Plug's/RJ-25 plug + cover cast (ethernet cable)/ethernet_pin.SLDPRT

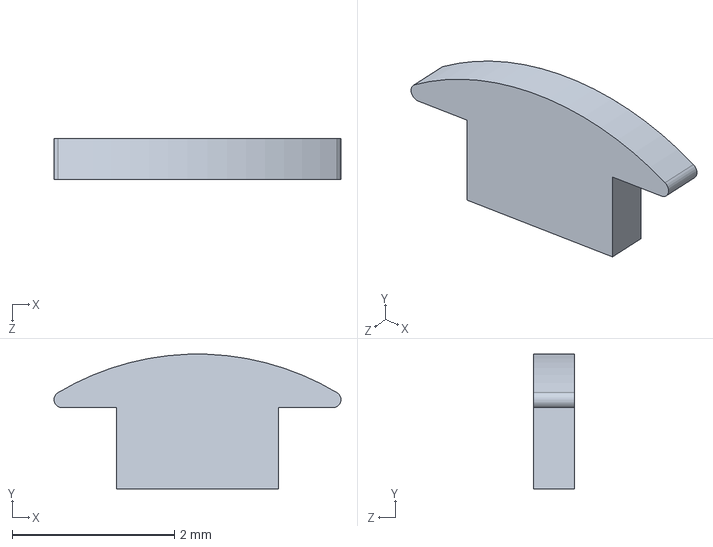
[picture p74: CAD file, 2020-08-14]
3D/(SolidWorks)/Connectors/_Plug's/RJ-25 plug + cover cast (ethernet cable)/ethernet_pin.SLDPRT
3.54 x 1.66 x 0.5 mm
