ElessarCuthalion/KiCAD_library/3D/(SolidWorks)/Connectors/_Plug's/USB-C plug lip.SLDPRT

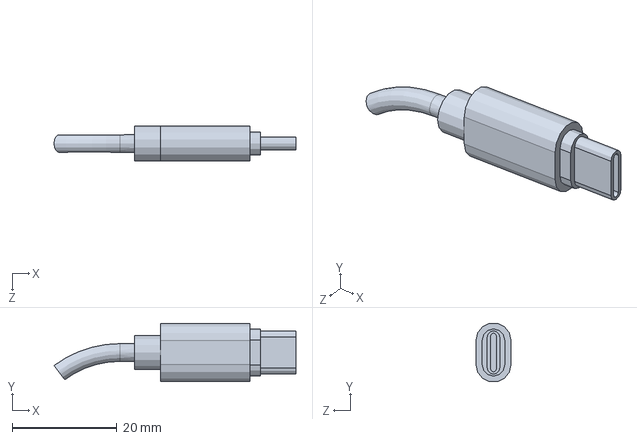
[picture p75: CAD file, 2026-03-27]
3D/(SolidWorks)/Connectors/_Plug's/USB-C plug lip.SLDPRT
46.2 x 11.1 x 6.70 mm
