ElessarCuthalion/KiCAD_library/3D/(SolidWorks)/Connectors/Cleamm-2_5mm - DG306-5.0-xxP/DG306-5.0-3P_Leg.SLDPRT

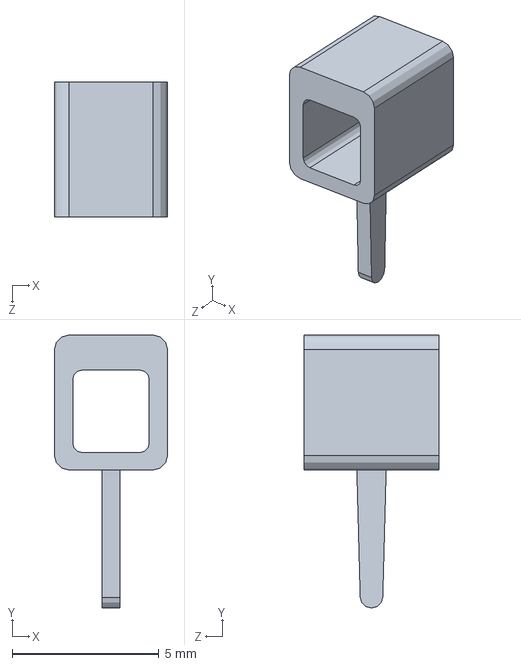
[picture p76: CAD file, 2020-06-08]
3D/(SolidWorks)/Connectors/Cleamm-2_5mm - DG306-5.0-xxP/DG306-5.0-3P_Leg.SLDPRT
3.86 x 9.30 x 4.60 mm
