ElessarCuthalion/KiCAD_library/3D/(SolidWorks)/Connectors/PBS2-3 (DS1026-01-1X03).SLDPRT

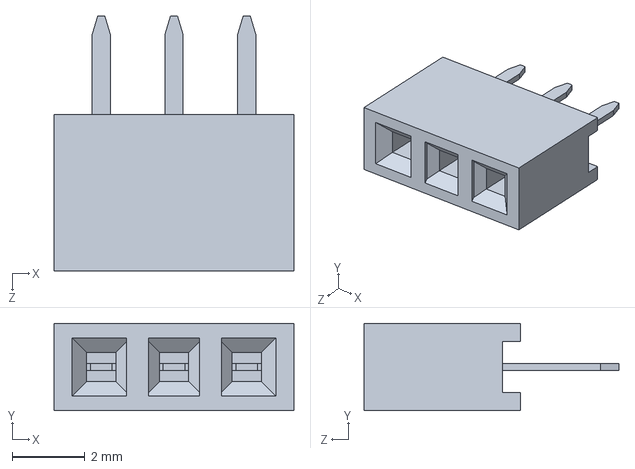
[picture p77: CAD file, 2026-02-16]
3D/(SolidWorks)/Connectors/PBS2-3 (DS1026-01-1X03).SLDPRT
6.60 x 2.40 x 7.00 mm
