ElessarCuthalion/KiCAD_library/3D/(SolidWorks)/Connectors/Импортированно/KF1000-xP Клеммная колодка/User Library-KF1000-3P_KF1000 Body.SLDPRT

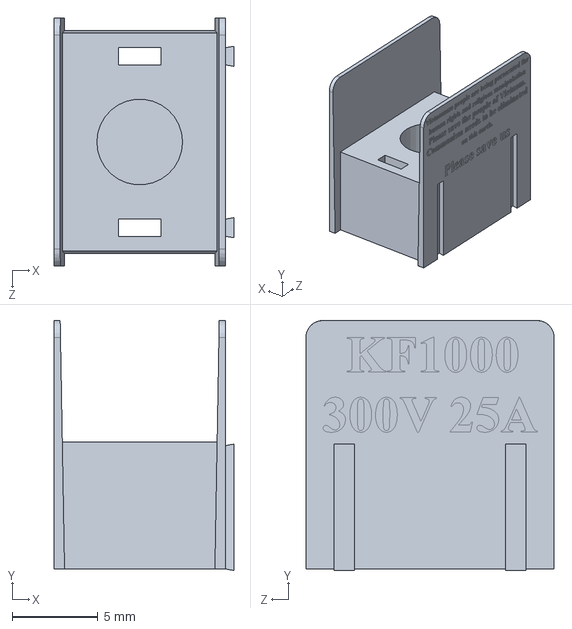
[picture p78: CAD file, 2020-10-26]
3D/(SolidWorks)/Connectors/Импортированно/KF1000-xP Клеммная колодка/User Library-KF1000-3P_KF1000 Body.SLDPRT
10.5 x 14.6 x 14.5 mm
