ElessarCuthalion/KiCAD_library/3D/(SolidWorks)/Connectors/Импортированно/USB Type-C female with PCB.step.SLDPRT

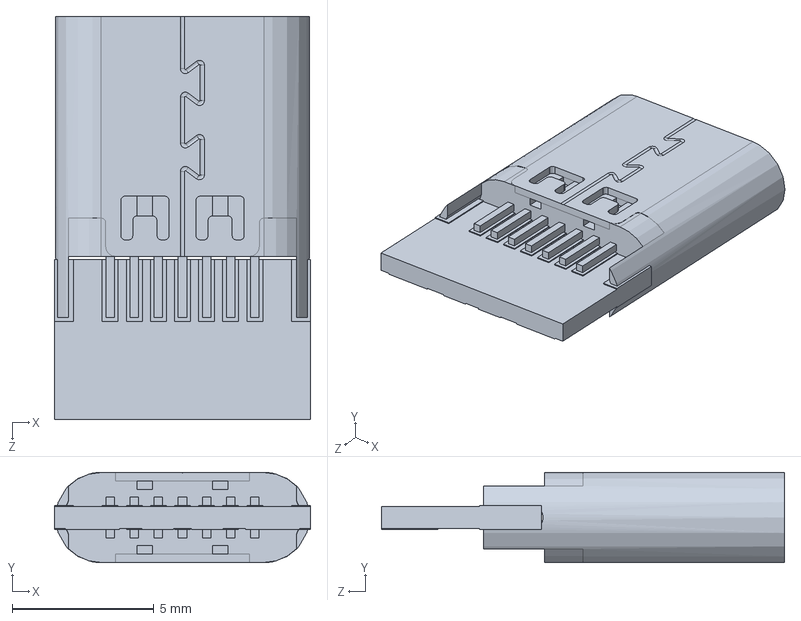
[picture p79: CAD file, 2026-04-15]
3D/(SolidWorks)/Connectors/Импортированно/USB Type-C female with PCB.step.SLDPRT
9.04 x 3.19 x 14.2 mm
