ElessarCuthalion/KiCAD_library/3D/(SolidWorks)/Diodes/Bridge KBU case.SLDPRT

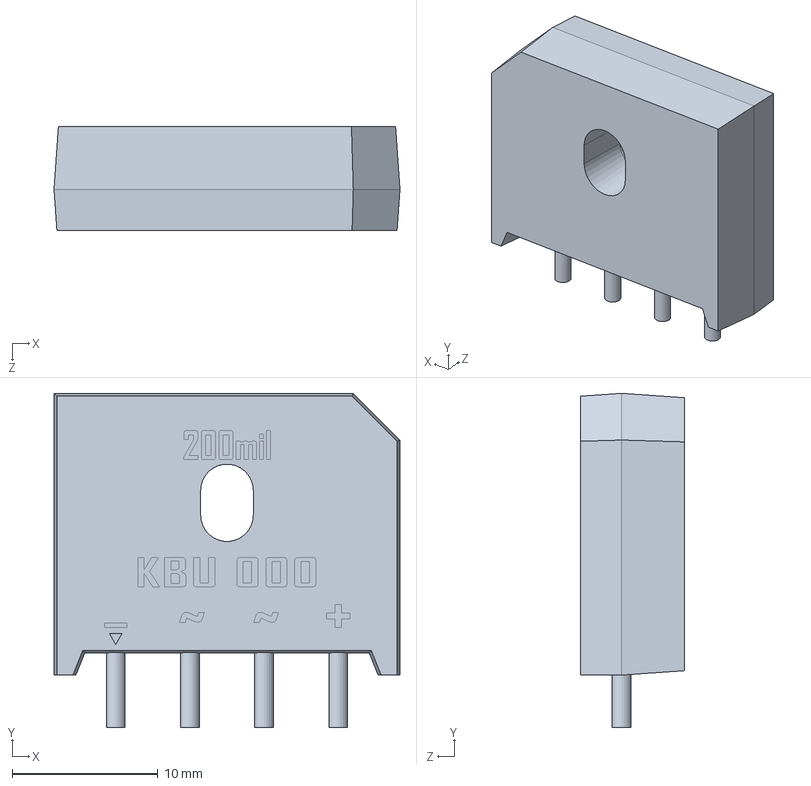
[picture p80: CAD file, 2023-04-19]
3D/(SolidWorks)/Diodes/Bridge KBU case.SLDPRT
23.7 x 22.9 x 7.10 mm
