ElessarCuthalion/KiCAD_library/3D/(SolidWorks)/DIP/DIP6-SMD.sldprt

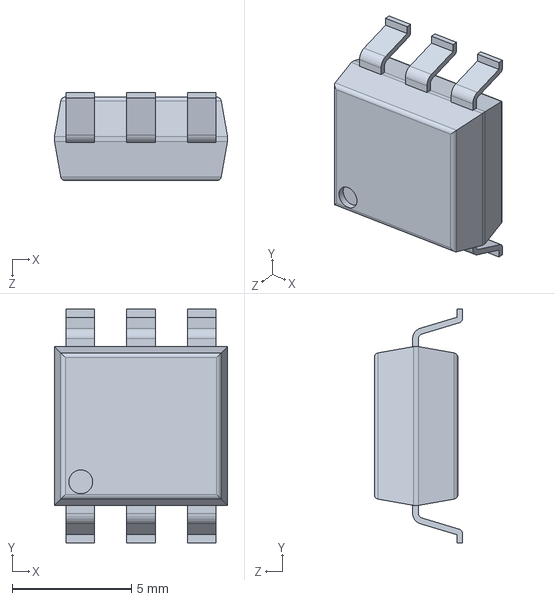
[picture p81: CAD file, 2020-10-09]
3D/(SolidWorks)/DIP/DIP6-SMD.sldprt
7.25 x 9.80 x 3.71 mm
