ElessarCuthalion/KiCAD_library/3D/(SolidWorks)/Display/LCD Nokia5110.SLDPRT

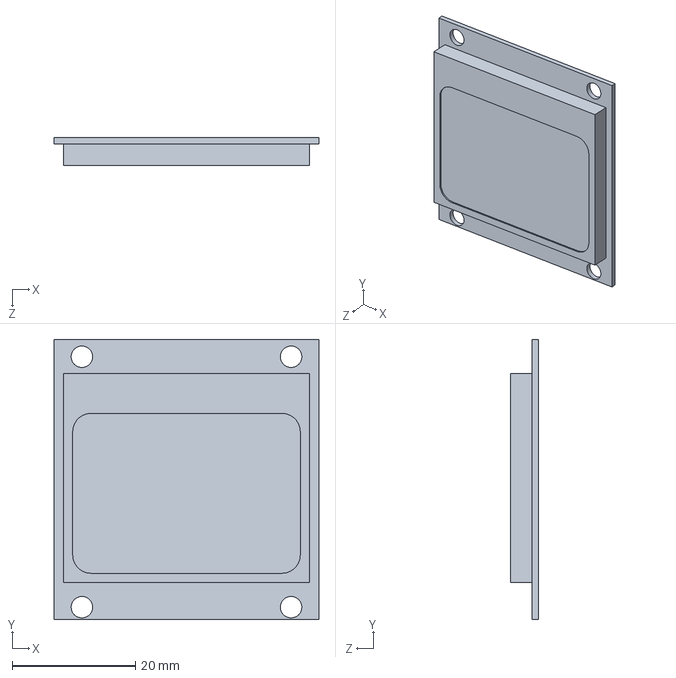
[picture p82: CAD file, 2019-11-18]
3D/(SolidWorks)/Display/LCD Nokia5110.SLDPRT
43.0 x 45.5 x 4.50 mm
