ElessarCuthalion/KiCAD_library/3D/(SolidWorks)/Hydraulics/Предохранительный клапан FoxWeld AERO 1,4.SLDPRT

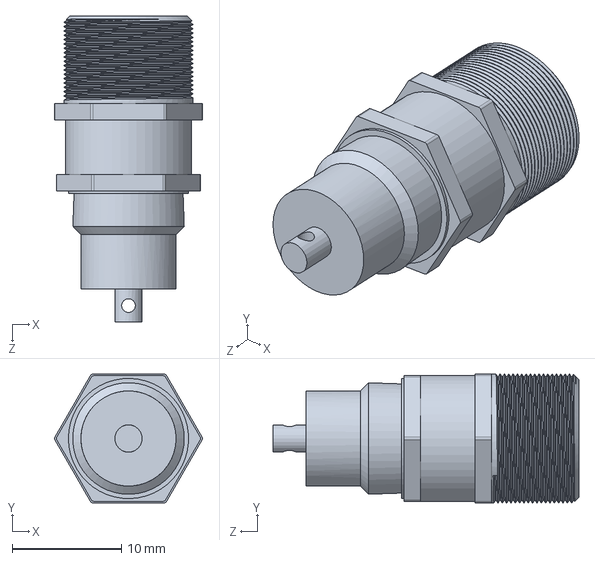
[picture p83: CAD file, 2021-07-01]
3D/(SolidWorks)/Hydraulics/Предохранительный клапан FoxWeld AERO 1,4.SLDPRT
13.5 x 11.8 x 28.0 mm
