ElessarCuthalion/KiCAD_library/3D/(SolidWorks)/Hydraulics/Фитинги/Фитинг FD7540 10.SLDPRT

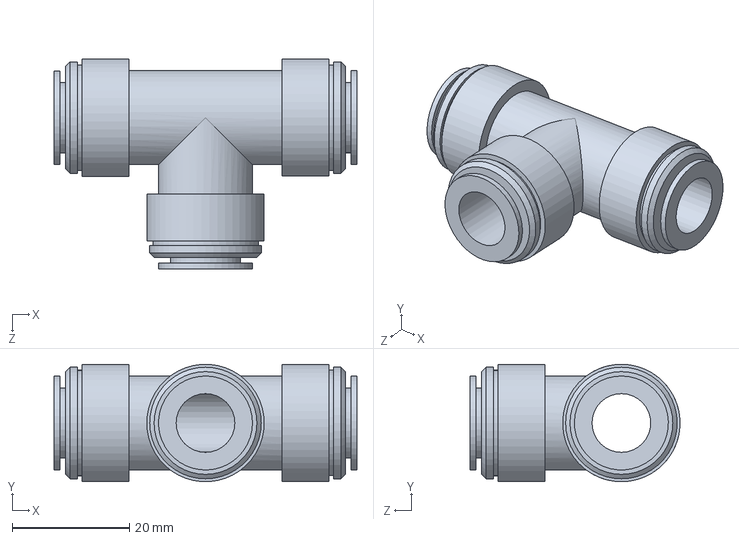
[picture p84: CAD file, 2021-07-01]
3D/(SolidWorks)/Hydraulics/Фитинги/Фитинг FD7540 10.SLDPRT
51.6 x 20.0 x 35.8 mm
