ElessarCuthalion/KiCAD_library/3D/(SolidWorks)/Inductors/+/Choke PL8200.SLDPRT

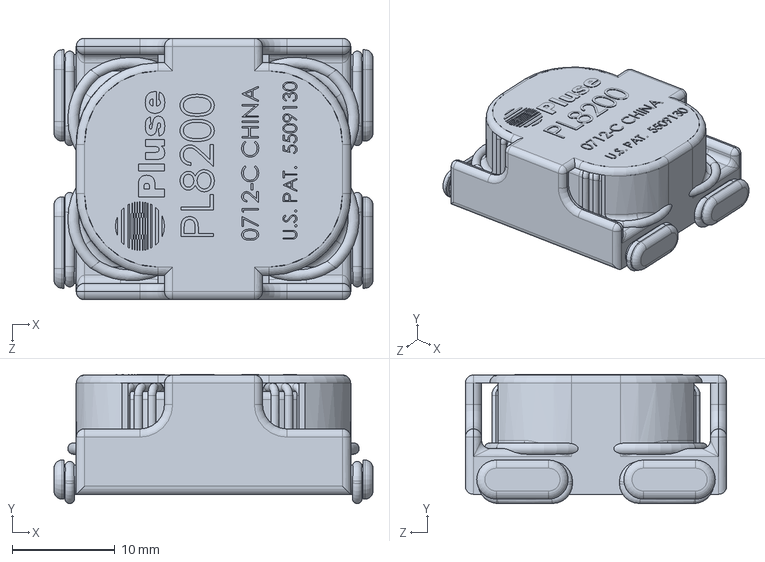
[picture p85: CAD file, 2023-04-14]
3D/(SolidWorks)/Inductors/+/Choke PL8200.SLDPRT
31.0 x 12.5 x 25.4 mm
