ElessarCuthalion/KiCAD_library/3D/(SolidWorks)/Inductors/CDRH4D18.sldprt

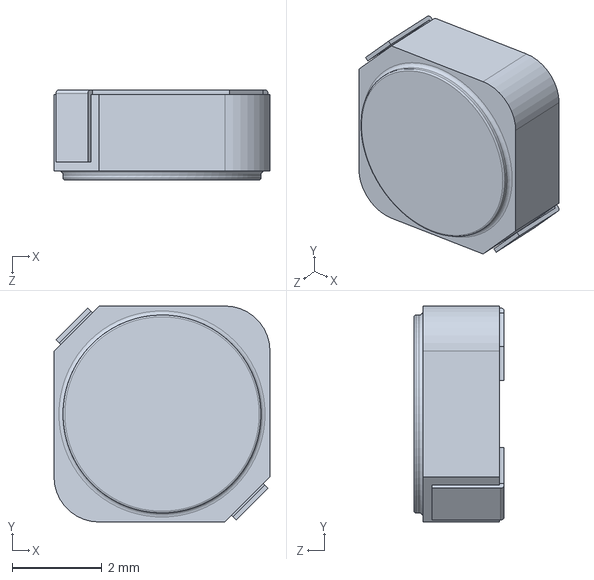
[picture p86: CAD file, 2023-06-22]
3D/(SolidWorks)/Inductors/CDRH4D18.sldprt
4.80 x 4.80 x 2.00 mm
