ElessarCuthalion/KiCAD_library/3D/(SolidWorks)/Inductors/Импортированно/CDRH127.SLDPRT

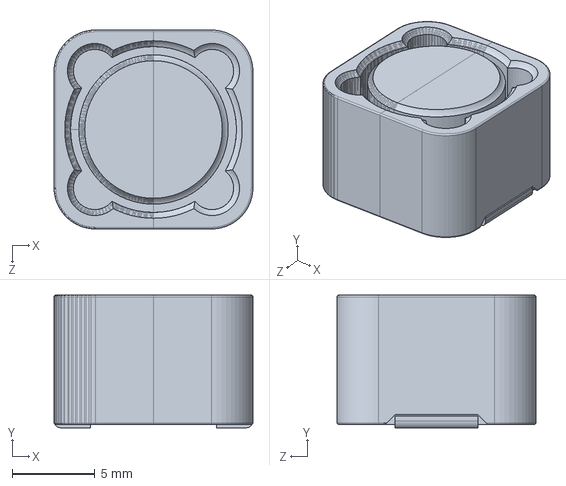
[picture p87: CAD file, 2023-06-21]
3D/(SolidWorks)/Inductors/Импортированно/CDRH127.SLDPRT
12.0 x 8.00 x 12.0 mm
