ElessarCuthalion/KiCAD_library/3D/(SolidWorks)/Installation/Electrician/Датчик температуры Pt1000 SUS304-18mm.SLDPRT

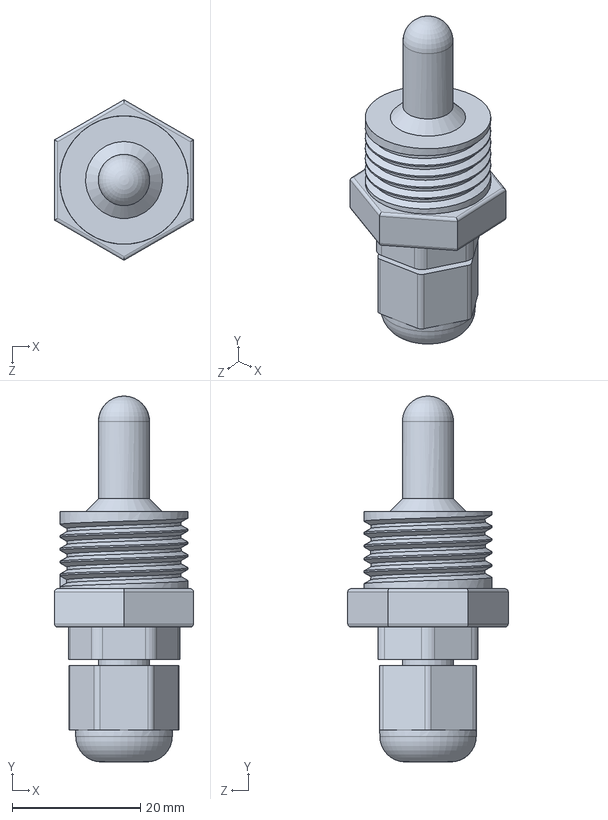
[picture p88: CAD file, 2021-07-02]
3D/(SolidWorks)/Installation/Electrician/Датчик температуры Pt1000 SUS304-18mm.SLDPRT
21.7 x 57.0 x 25.0 mm
