ElessarCuthalion/KiCAD_library/3D/(SolidWorks)/Installation/Electrician/Компрессор QM 110H MBP Wansheng/Детал компрессора №5.SLDPRT

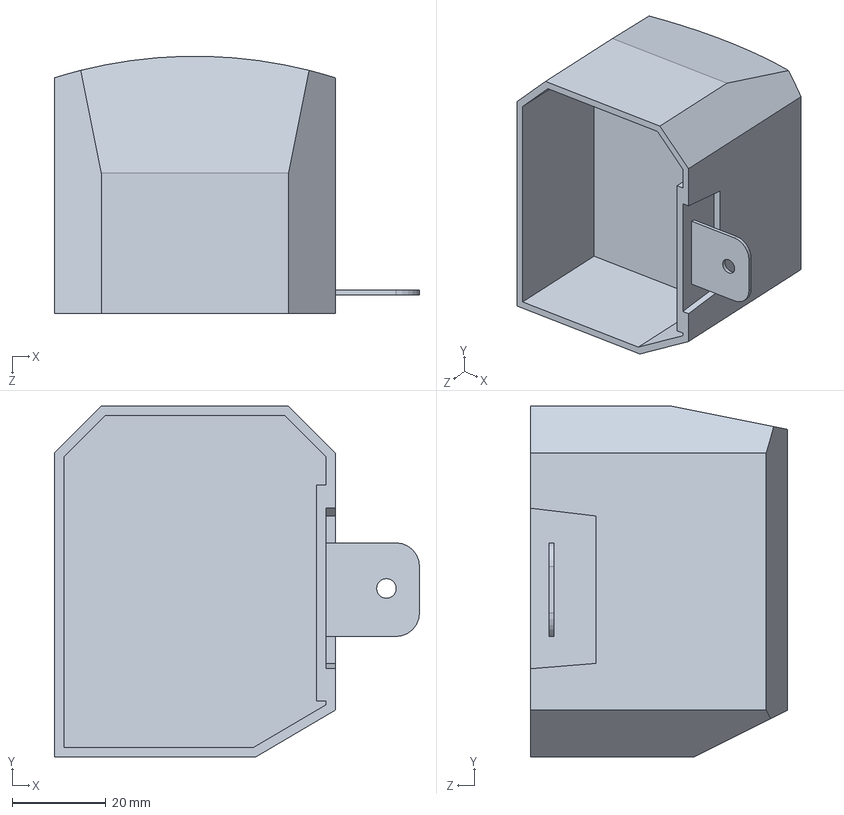
[picture p89: CAD file, 2021-07-01]
3D/(SolidWorks)/Installation/Electrician/Компрессор QM 110H MBP Wansheng/Детал компрессора №5.SLDPRT
78.0 x 75.0 x 55.0 mm
