ElessarCuthalion/KiCAD_library/3D/(SolidWorks)/Installation/Electrician/Конденсатор BS-ACC-A2-120 B2,1 Belief + Микродвигатель ZF 5-13 T4/Деталь конденсатора №2.SLDPRT

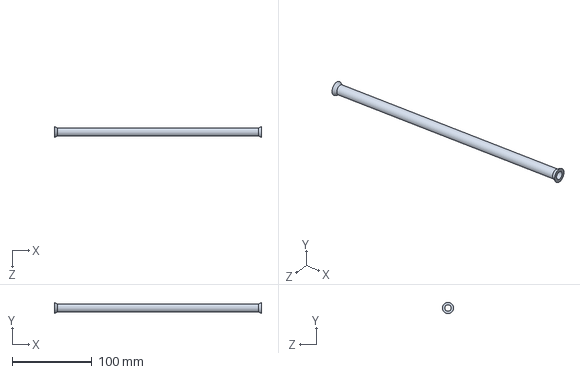
[picture p90: CAD file, 2021-07-01]
3D/(SolidWorks)/Installation/Electrician/Конденсатор BS-ACC-A2-120 B2,1 Belief + Микродвигатель ZF 5-13 T4/Деталь конденсатора №2.SLDPRT
260.0 x 14.0 x 14.0 mm
