ElessarCuthalion/KiCAD_library/3D/(SolidWorks)/Installation/Electrician/Контактная пара ABK-404/Контакт мама.SLDPRT

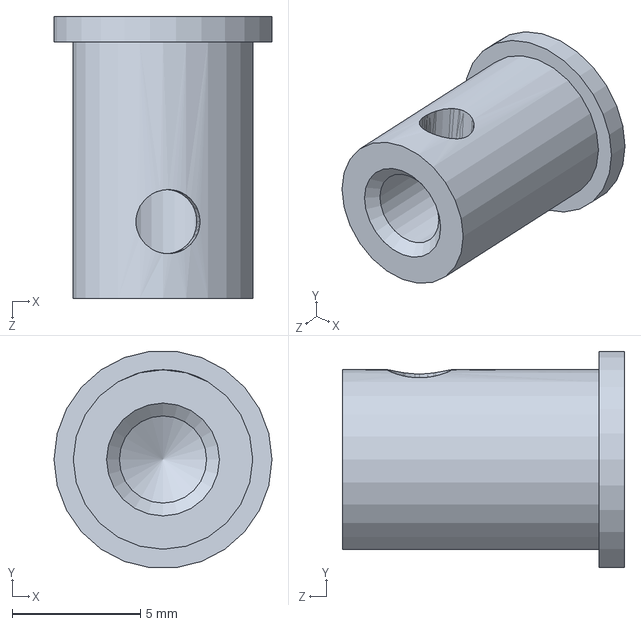
[picture p91: CAD file, 2021-07-01]
3D/(SolidWorks)/Installation/Electrician/Контактная пара ABK-404/Контакт мама.SLDPRT
8.50 x 8.44 x 11.0 mm
