ElessarCuthalion/KiCAD_library/3D/(SolidWorks)/Installation/Electrician/Микродвигатель ZF 5-13 T4 (220V)/Микродвигатель - деталь №3.SLDPRT

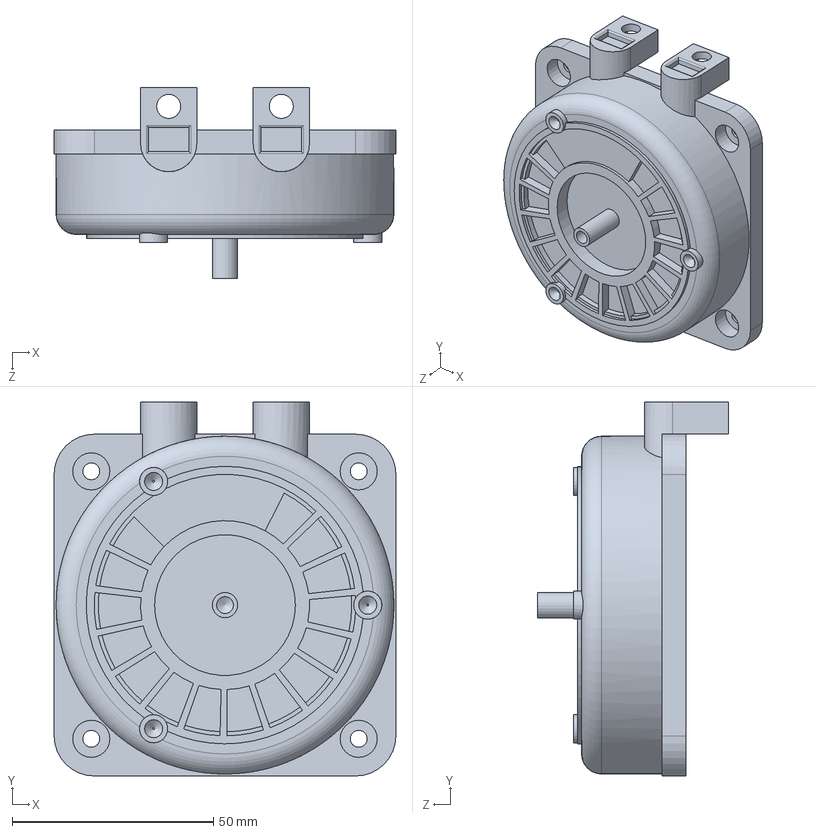
[picture p92: CAD file, 2021-07-01]
3D/(SolidWorks)/Installation/Electrician/Микродвигатель ZF 5-13 T4 (220V)/Микродвигатель - деталь №3.SLDPRT
85.0 x 93.0 x 47.6 mm
