ElessarCuthalion/KiCAD_library/3D/(SolidWorks)/Installation/Electrician/Мотор S55JXRKM-8100 + насос роторный PS-204 (200) (Бритта)/Насос роторный PS-204 (200).SLDPRT

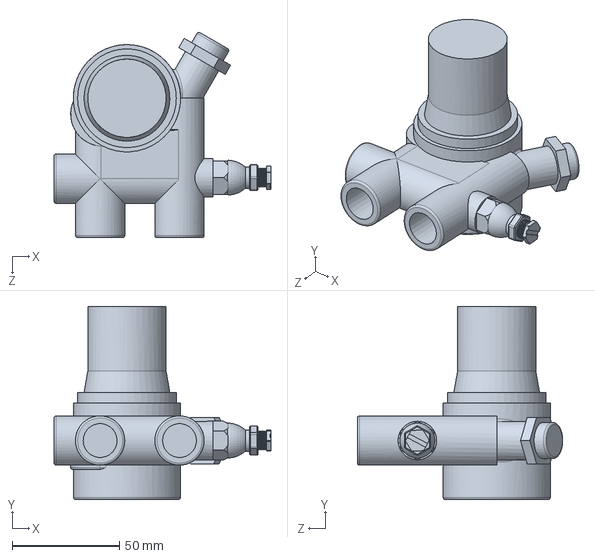
[picture p93: CAD file, 2021-07-02]
3D/(SolidWorks)/Installation/Electrician/Мотор S55JXRKM-8100 + насос роторный PS-204 (200) (Бритта)/Насос роторный PS-204 (200).SLDPRT
101.1 x 90.0 x 95.7 mm
