ElessarCuthalion/KiCAD_library/3D/(SolidWorks)/Installation/Electrician/Насос циркуляционный БелАвтоКомплект БАК.32118 отопительный 75.3730 12V D18/НБ7.SLDPRT

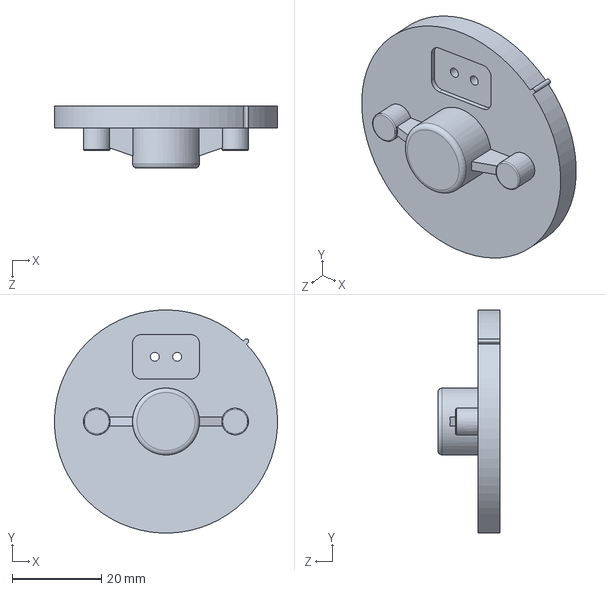
[picture p94: CAD file, 2021-07-01]
3D/(SolidWorks)/Installation/Electrician/Насос циркуляционный БелАвтоКомплект БАК.32118 отопительный 75.3730 12V D18/НБ7.SLDPRT
50.0 x 50.0 x 14.0 mm
