ElessarCuthalion/KiCAD_library/3D/(SolidWorks)/Installation/Electrician/Электромагнитный клапан G1-2/ЭК3 8 мм.SLDPRT

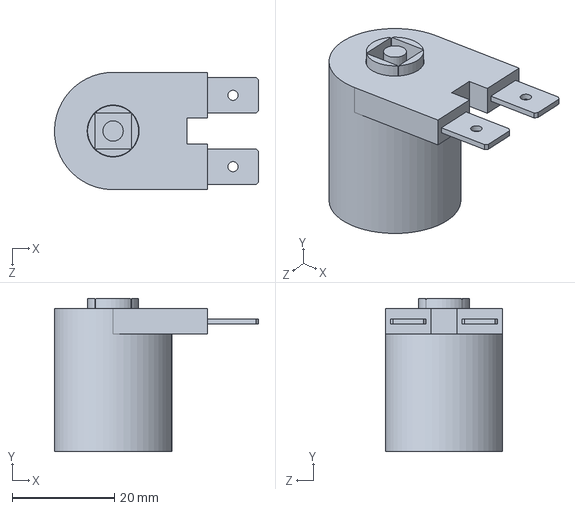
[picture p95: CAD file, 2021-07-01]
3D/(SolidWorks)/Installation/Electrician/Электромагнитный клапан G1-2/ЭК3 8 мм.SLDPRT
40.0 x 30.0 x 23.0 mm
