ElessarCuthalion/KiCAD_library/3D/(SolidWorks)/Installation/Neodymium Magnet D8x1mm.SLDPRT

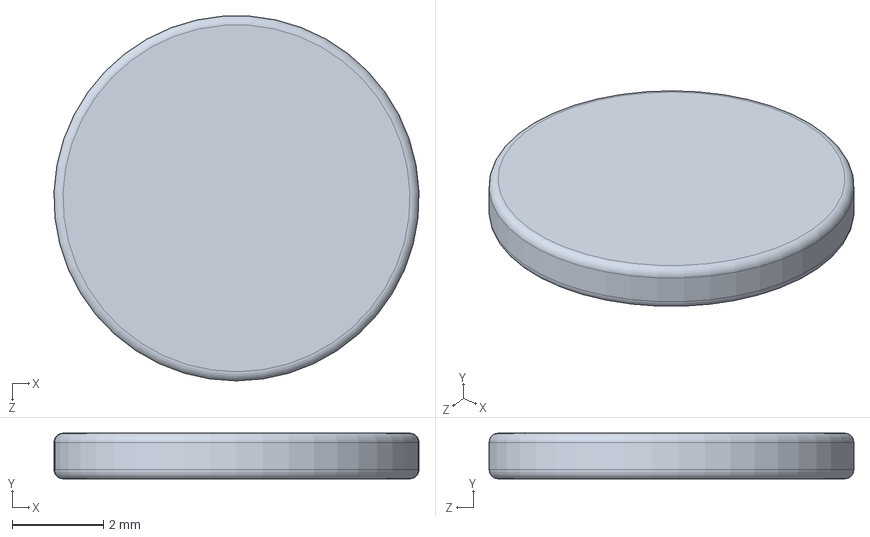
[picture p96: CAD file, 2025-06-06]
3D/(SolidWorks)/Installation/Neodymium Magnet D8x1mm.SLDPRT
7.99 x 1.00 x 7.99 mm
