ElessarCuthalion/KiCAD_library/3D/(SolidWorks)/Installation/Stones/Quartz crystal mid_2.STEP

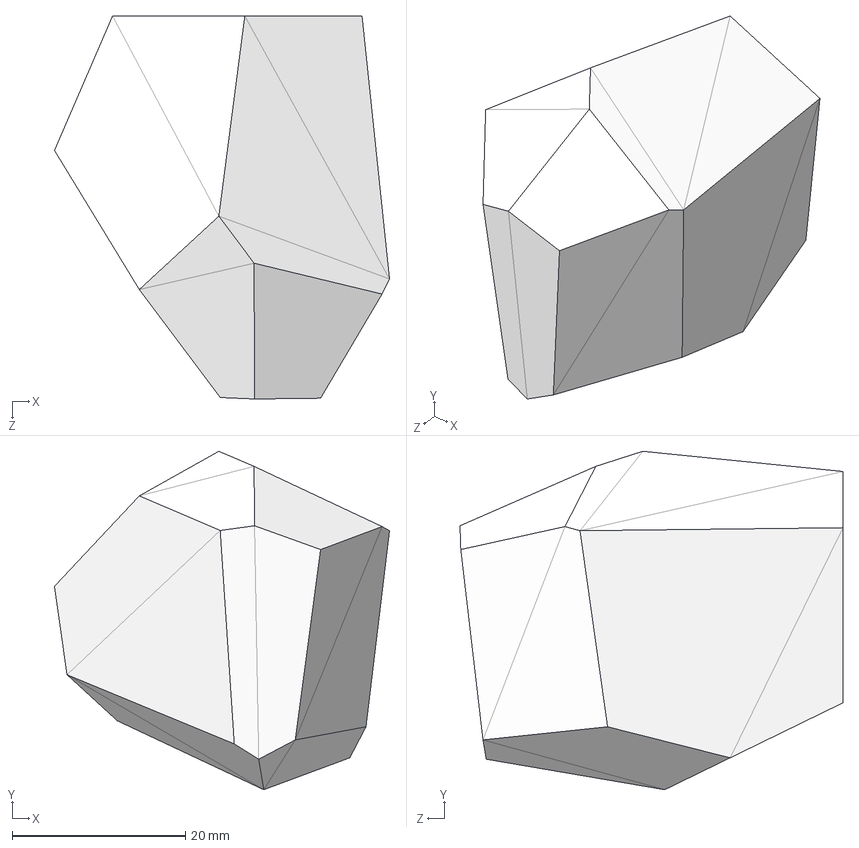
[picture p97: CAD file, 2024-12-14]
3D/(SolidWorks)/Installation/Stones/Quartz crystal mid_2.STEP
38.7 x 39.0 x 44.2 mm
