ElessarCuthalion/KiCAD_library/3D/(SolidWorks)/Installation/Импортированно/Fuse Holder KLS5-242 with fuse 5.2x20.stp.SLDPRT

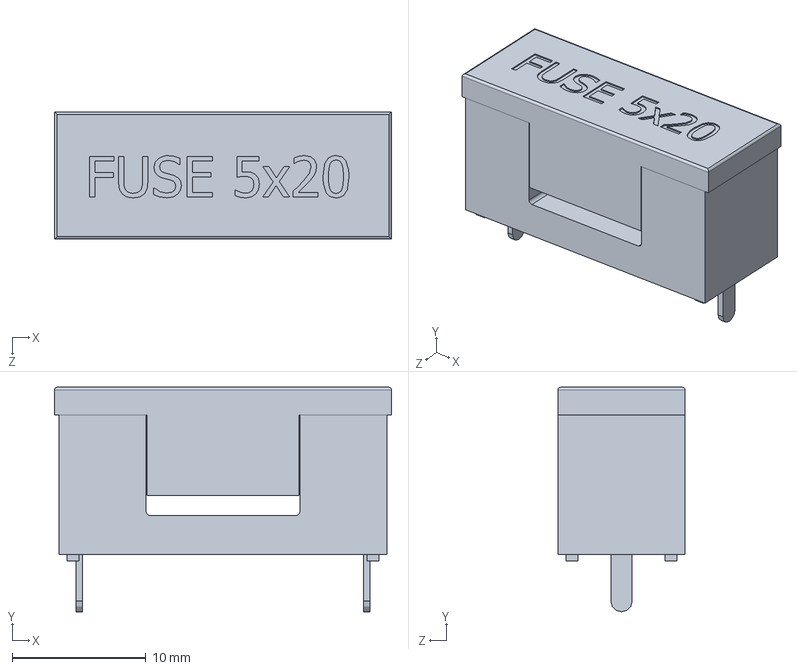
[picture p98: CAD file, 2020-11-07]
3D/(SolidWorks)/Installation/Импортированно/Fuse Holder KLS5-242 with fuse 5.2x20.stp.SLDPRT
25.2 x 16.8 x 9.50 mm
