ElessarCuthalion/KiCAD_library/3D/(SolidWorks)/LEDs/+/RGB-CC_DIP-5mm BL-L515s имп.SLDPRT

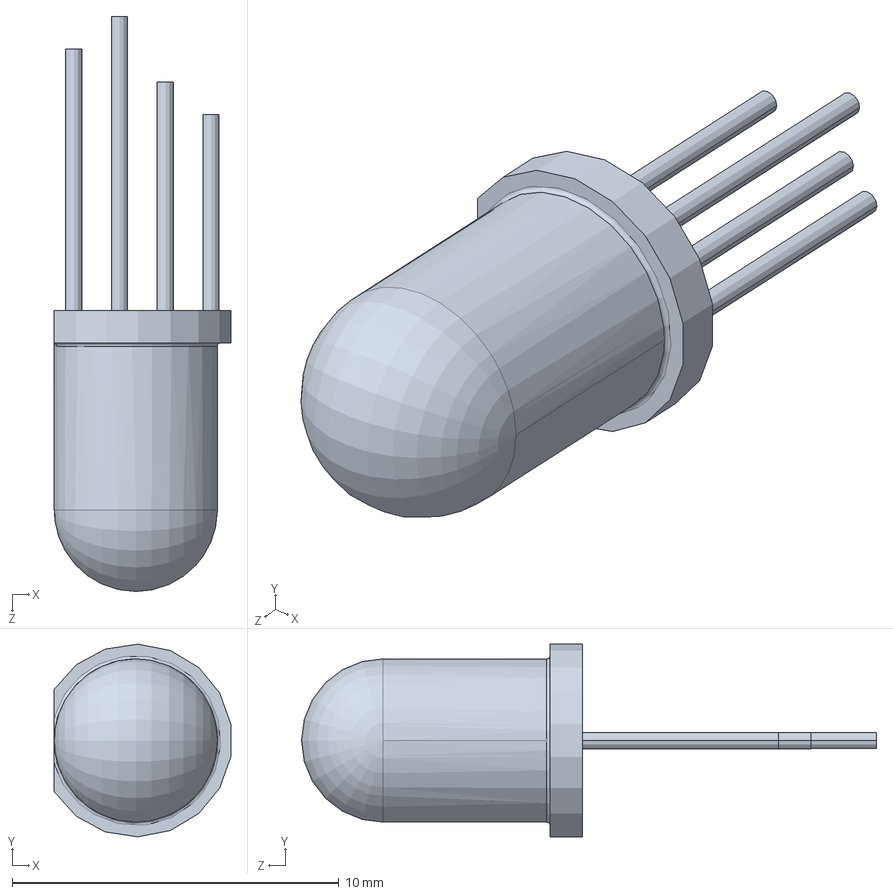
[picture p99: CAD file, 2023-04-23]
3D/(SolidWorks)/LEDs/+/RGB-CC_DIP-5mm BL-L515s имп.SLDPRT
5.41 x 5.90 x 17.6 mm
