ElessarCuthalion/KiCAD_library/3D/(SolidWorks)/LEDs/Импортированы/Cree XP-L Hi (XLamp XHP35.2 HI).SLDPRT

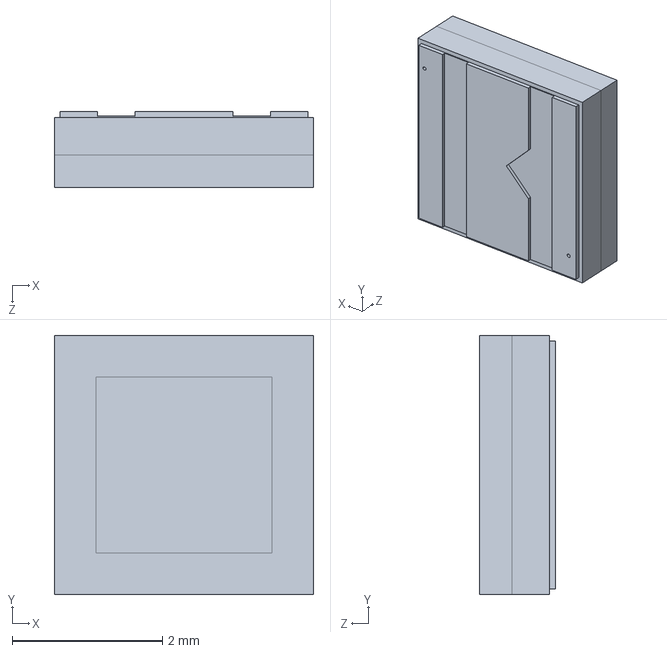
[picture p100: CAD file, 2023-12-07]
3D/(SolidWorks)/LEDs/Импортированы/Cree XP-L Hi (XLamp XHP35.2 HI).SLDPRT
3.45 x 3.45 x 1.01 mm
