ElessarCuthalion/KiCAD_library/3D/(SolidWorks)/Micro-SD card.sldprt

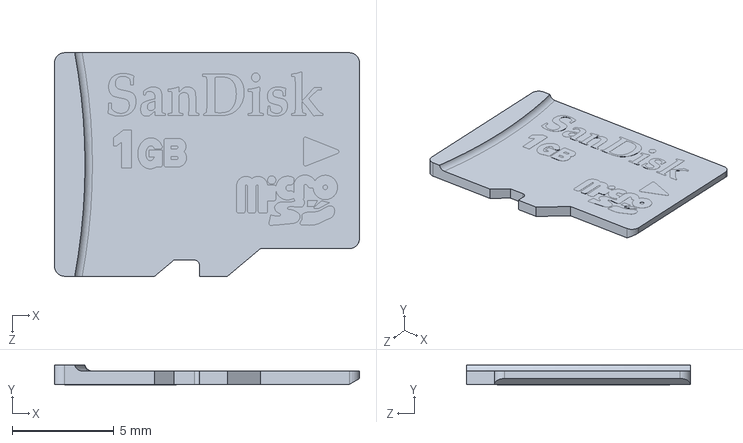
[picture p101: CAD file, 2019-11-27]
3D/(SolidWorks)/Micro-SD card.sldprt
15.0 x 0.975 x 11.0 mm
