ElessarCuthalion/KiCAD_library/3D/(SolidWorks)/Modules/Raspberry/Raspi3B+_Mock.SLDPRT

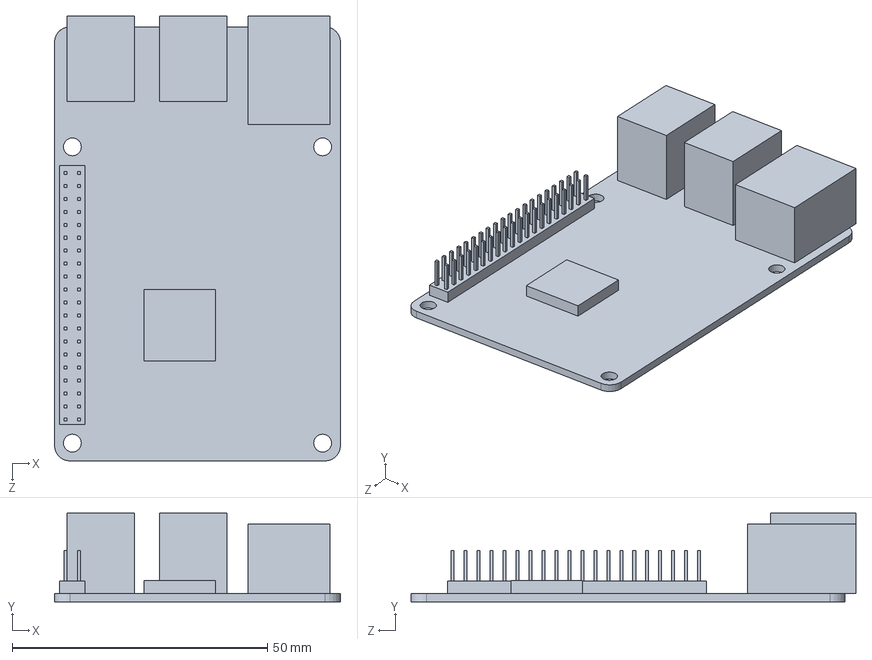
[picture p102: CAD file, 2019-11-18]
3D/(SolidWorks)/Modules/Raspberry/Raspi3B+_Mock.SLDPRT
56.0 x 17.4 x 87.1 mm
