ElessarCuthalion/KiCAD_library/3D/(SolidWorks)/Motors/+/Vibro_12x3d5.SLDPRT

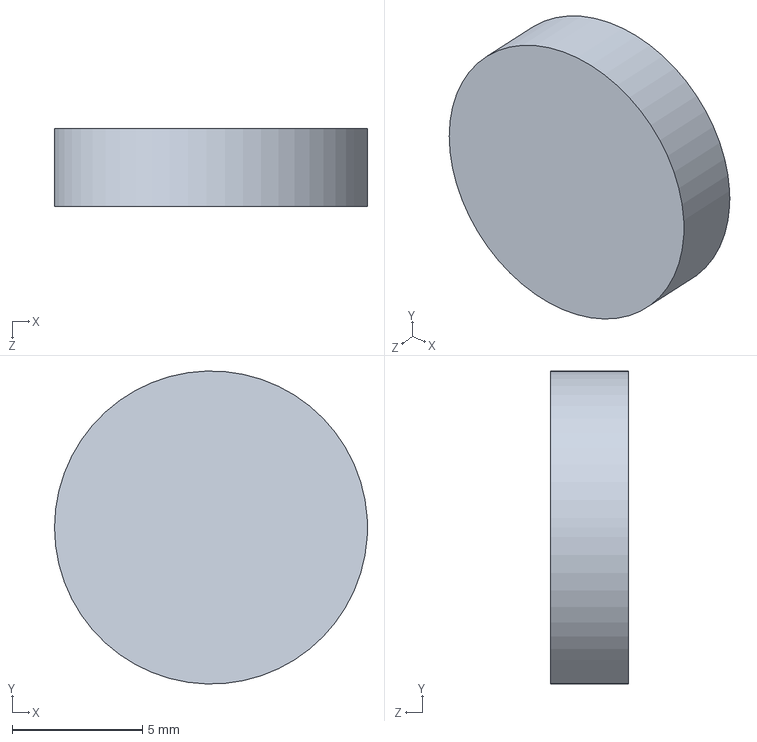
[picture p103: CAD file, 2019-11-18]
3D/(SolidWorks)/Motors/+/Vibro_12x3d5.SLDPRT
12.0 x 12.0 x 3.00 mm
