ElessarCuthalion/KiCAD_library/3D/(SolidWorks)/Motors/StepGearMotor_GM15BY (SM1511WC01).STEP

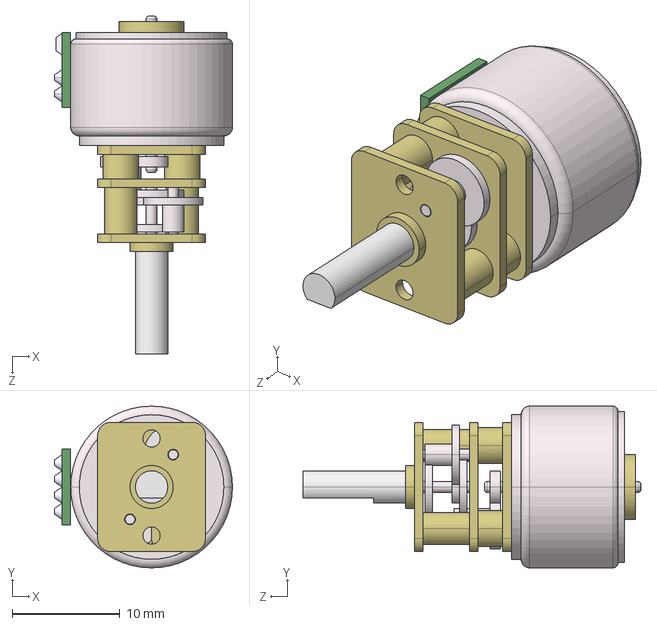
[picture p104: CAD file, 2024-11-11]
3D/(SolidWorks)/Motors/StepGearMotor_GM15BY (SM1511WC01).STEP
16.5 x 15.0 x 31.3 mm
