ElessarCuthalion/KiCAD_library/3D/(SolidWorks)/Nutted_Profile/Leg Wooden box - cylinder d9 h3.SLDPRT

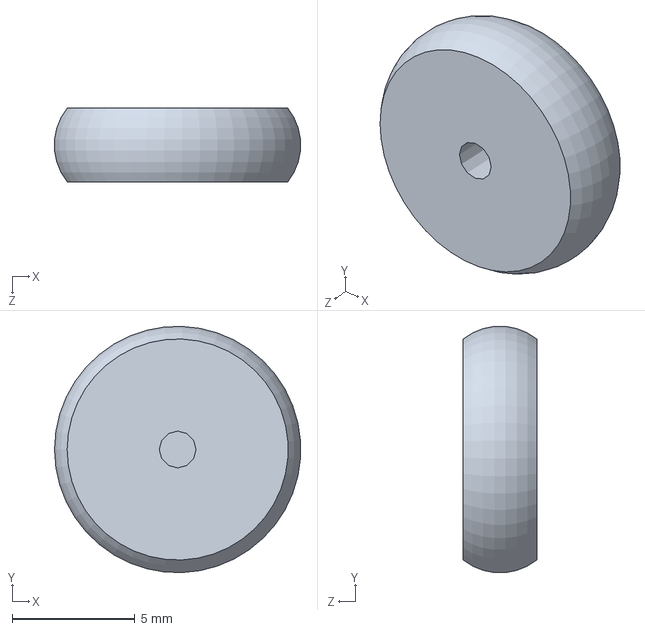
[picture p105: CAD file, 2026-04-15]
3D/(SolidWorks)/Nutted_Profile/Leg Wooden box - cylinder d9 h3.SLDPRT
10.0 x 10.0 x 3.00 mm
