ElessarCuthalion/KiCAD_library/3D/(SolidWorks)/Opto/opto_SOP4 ACPL-217.sldprt

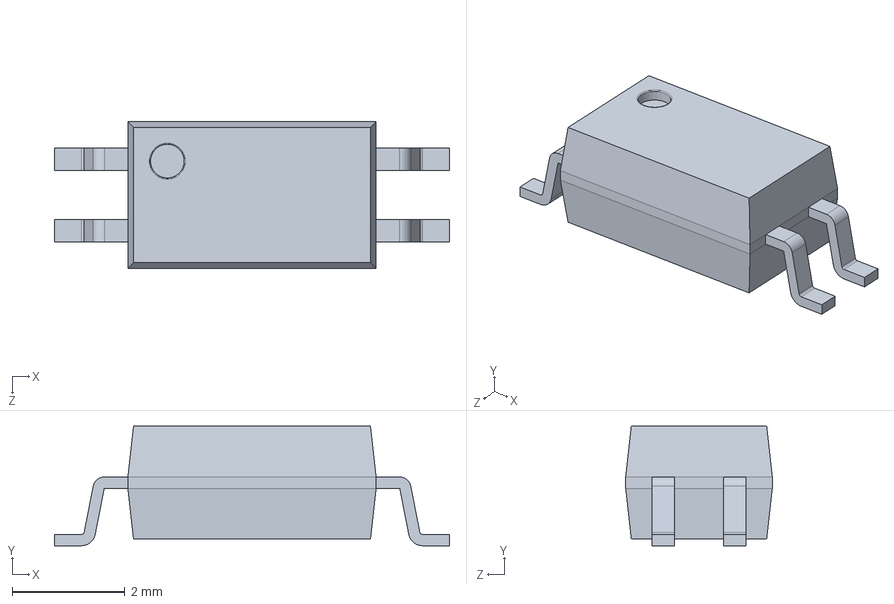
[picture p106: CAD file, 2020-10-09]
3D/(SolidWorks)/Opto/opto_SOP4 ACPL-217.sldprt
7.00 x 2.12 x 2.60 mm
