ElessarCuthalion/KiCAD_library/3D/(SolidWorks)/Opto/Импортированно/opto_SOP16/TLP291-4(SOP16)_Document.sldprt

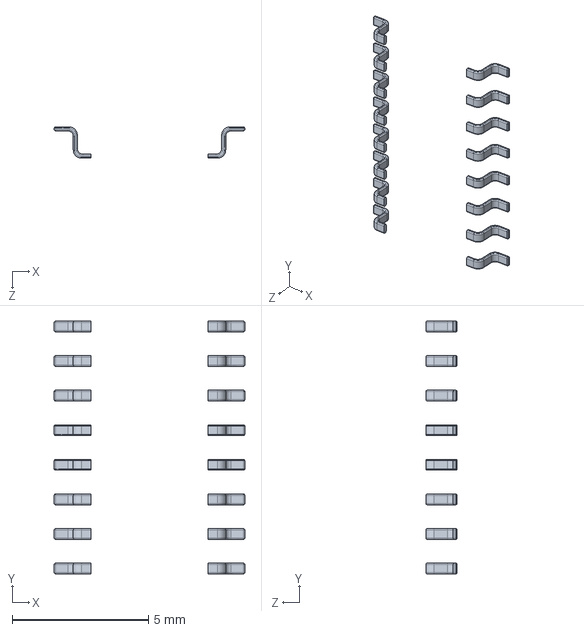
[picture p107: CAD file, 2020-10-14]
3D/(SolidWorks)/Opto/Импортированно/opto_SOP16/TLP291-4(SOP16)_Document.sldprt
7.00 x 9.29 x 1.15 mm
