ElessarCuthalion/KiCAD_library/3D/(SolidWorks)/Opto/Импортированно/TSOP2xxx, TSOP32xxx Vert.step.SLDPRT

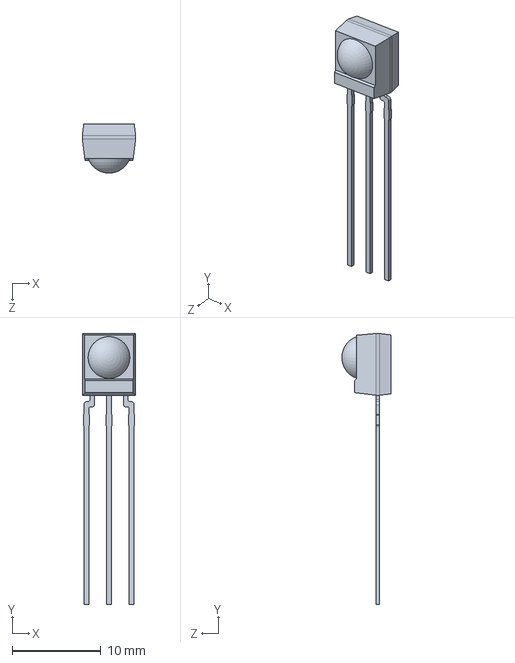
[picture p108: CAD file, 2023-03-30]
3D/(SolidWorks)/Opto/Импортированно/TSOP2xxx, TSOP32xxx Vert.step.SLDPRT
6.00 x 30.5 x 5.55 mm
