ElessarCuthalion/KiCAD_library/3D/(SolidWorks)/Power/24V Mean Well Power Supply/User Library-24 V Power Supply_Base.SLDPRT

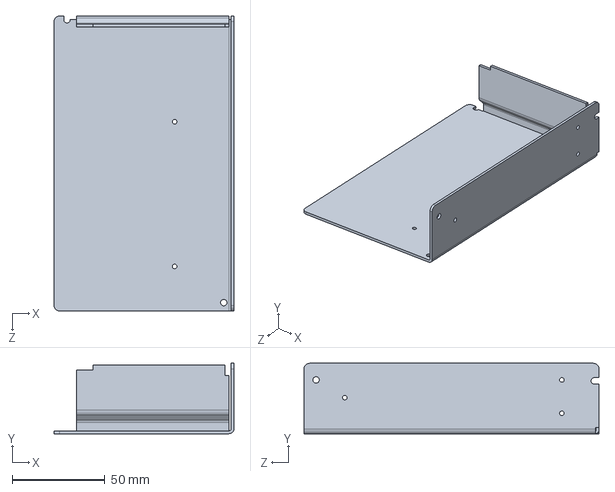
[picture p109: CAD file, 2020-02-28]
3D/(SolidWorks)/Power/24V Mean Well Power Supply/User Library-24 V Power Supply_Base.SLDPRT
97.0 x 38.0 x 159.0 mm
