ElessarCuthalion/KiCAD_library/3D/(SolidWorks)/Power/PwrSupp_MW_IRM-30-xxST.SLDPRT

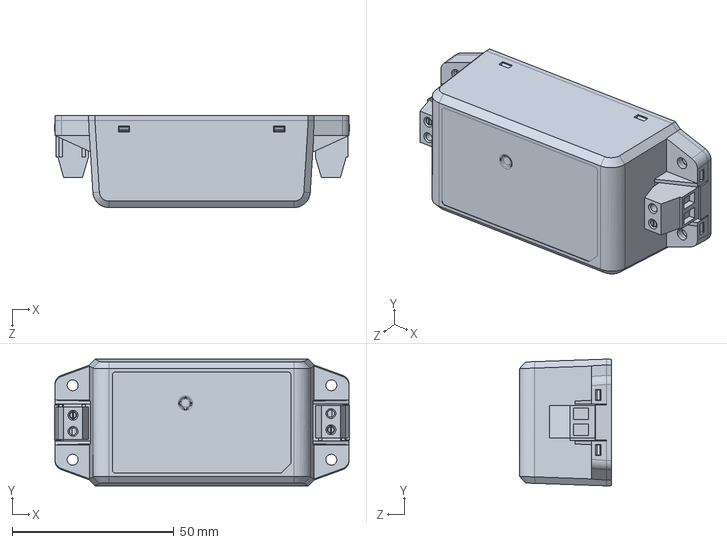
[picture p110: CAD file, 2023-10-29]
3D/(SolidWorks)/Power/PwrSupp_MW_IRM-30-xxST.SLDPRT
91.2 x 39.2 x 28.5 mm
