ElessarCuthalion/KiCAD_library/3D/(SolidWorks)/Power/PwrSupp_MW_RS-25-5/Часть блока питания №2.SLDPRT

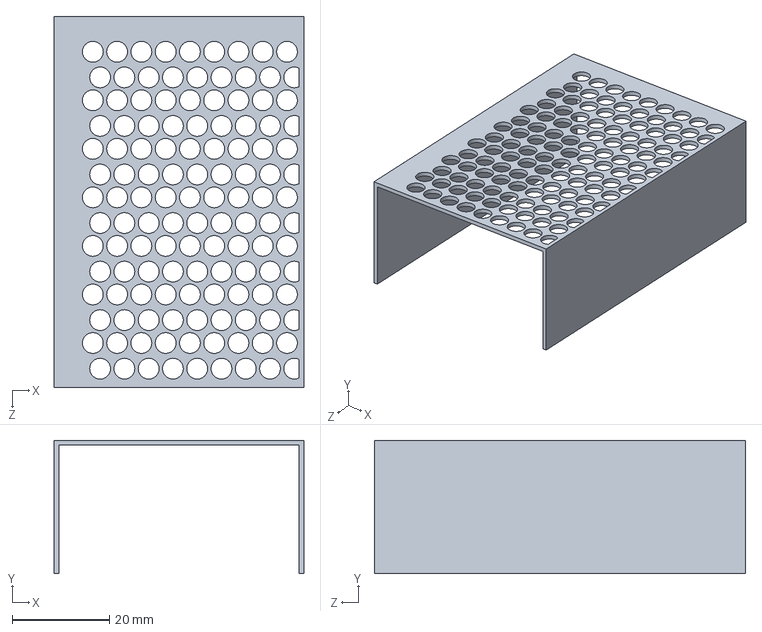
[picture p112: CAD file, 2021-07-01]
3D/(SolidWorks)/Power/PwrSupp_MW_RS-25-5/Часть блока питания №2.SLDPRT
51.5 x 27.5 x 76.5 mm
