ElessarCuthalion/KiCAD_library/3D/(SolidWorks)/Power/ResettableFuse/MR-RHT650-0 (12.7x12.7).step

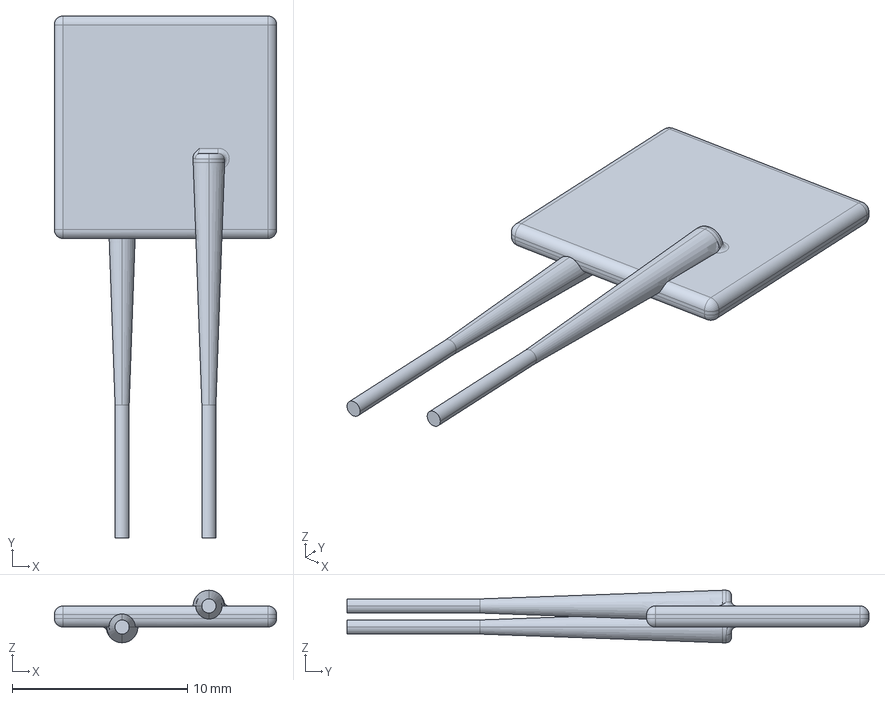
[picture p113: CAD file, 2023-06-21]
3D/(SolidWorks)/Power/ResettableFuse/MR-RHT650-0 (12.7x12.7).step
12.7 x 29.8 x 3.00 mm
