ElessarCuthalion/KiCAD_library/3D/(SolidWorks)/QFN_DFN_LGA/+/DFN6_2pin PAD - SOT1118 DFN2020-6.sldprt

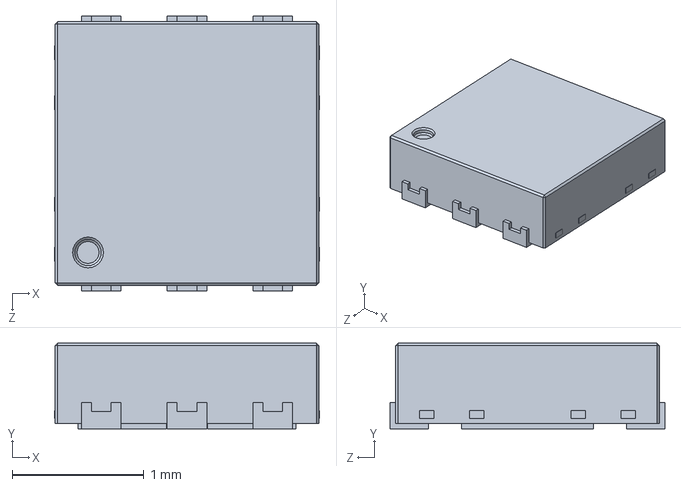
[picture p114: CAD file, 2020-10-19]
3D/(SolidWorks)/QFN_DFN_LGA/+/DFN6_2pin PAD - SOT1118 DFN2020-6.sldprt
2.01 x 0.65 x 2.08 mm
