ElessarCuthalion/KiCAD_library/3D/(SolidWorks)/QFN_DFN_LGA/MLP8_3.3x3.3.sldprt

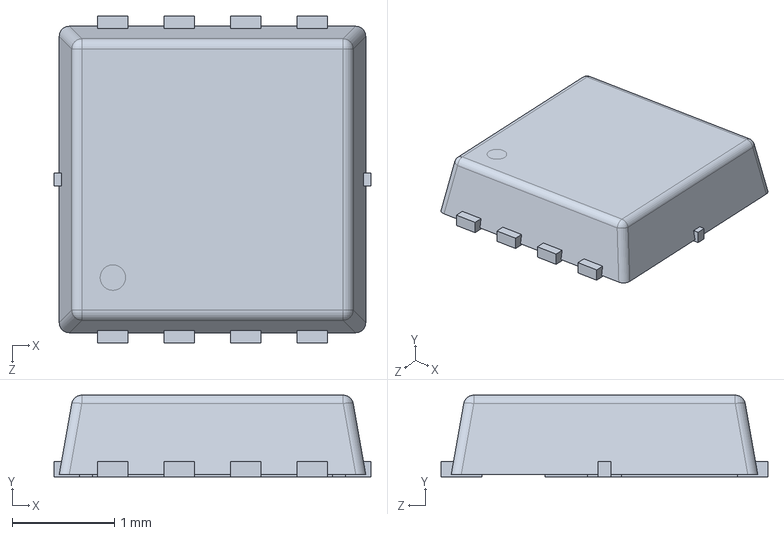
[picture p115: CAD file, 2020-06-07]
3D/(SolidWorks)/QFN_DFN_LGA/MLP8_3.3x3.3.sldprt
3.10 x 0.8 x 3.20 mm
