ElessarCuthalion/KiCAD_library/3D/(SolidWorks)/QFN_DFN_LGA/Импортированно/FCQFN24 - MP2637.step.SLDPRT

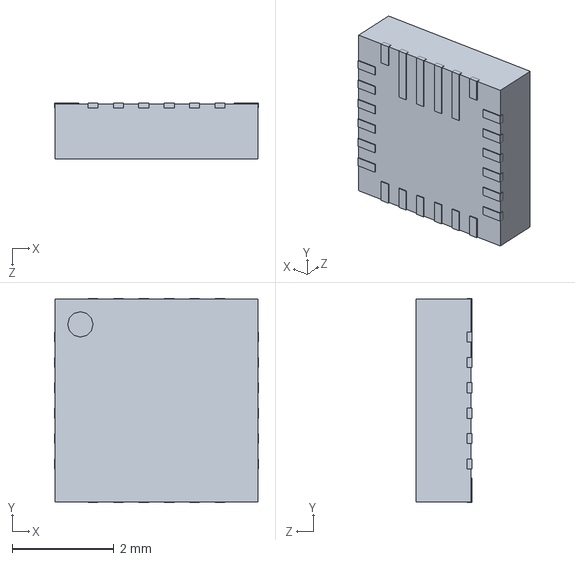
[picture p116: CAD file, 2024-02-05]
3D/(SolidWorks)/QFN_DFN_LGA/Импортированно/FCQFN24 - MP2637.step.SLDPRT
4.02 x 4.02 x 1.10 mm
