ElessarCuthalion/KiCAD_library/3D/(SolidWorks)/Quartz/TXC 7B 4pin 5.0x3.2.sldprt

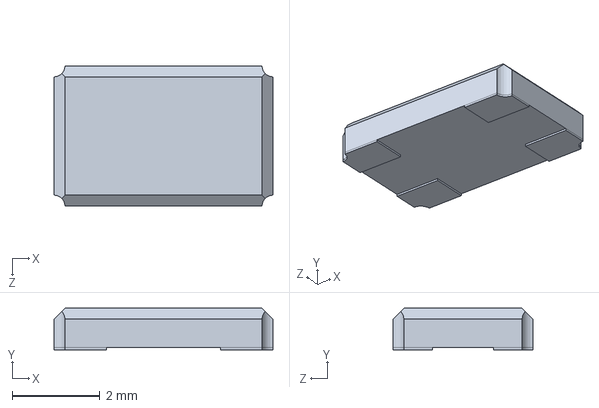
[picture p117: CAD file, 2020-11-06]
3D/(SolidWorks)/Quartz/TXC 7B 4pin 5.0x3.2.sldprt
5.00 x 0.95 x 3.20 mm
