ElessarCuthalion/KiCAD_library/3D/(SolidWorks)/Quartz/импортированно/NDK_NX3215SA 2pin.sldprt

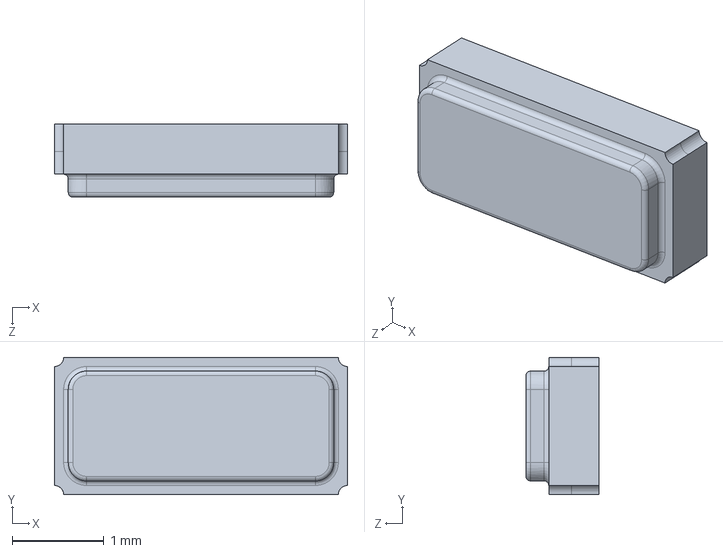
[picture p118: CAD file, 2020-11-06]
3D/(SolidWorks)/Quartz/импортированно/NDK_NX3215SA 2pin.sldprt
3.20 x 1.50 x 0.8 mm
