ElessarCuthalion/KiCAD_library/3D/(SolidWorks)/Radio/Balun2450FB15L0001.sldprt

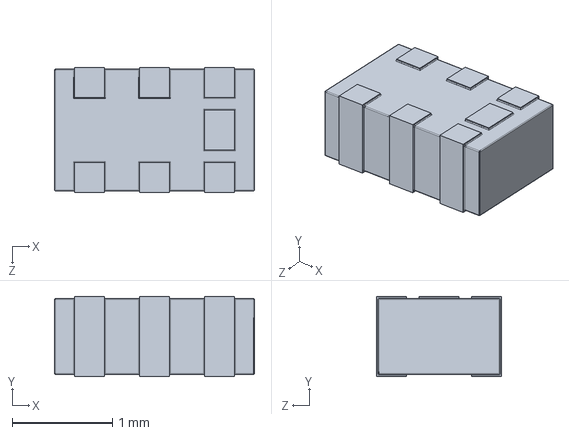
[picture p119: CAD file, 2020-01-05]
3D/(SolidWorks)/Radio/Balun2450FB15L0001.sldprt
2.00 x 0.8 x 1.25 mm
