ElessarCuthalion/KiCAD_library/3D/(SolidWorks)/Relays/USSR vacuum relay В1В-1В (контур посадочного места).SLDPRT

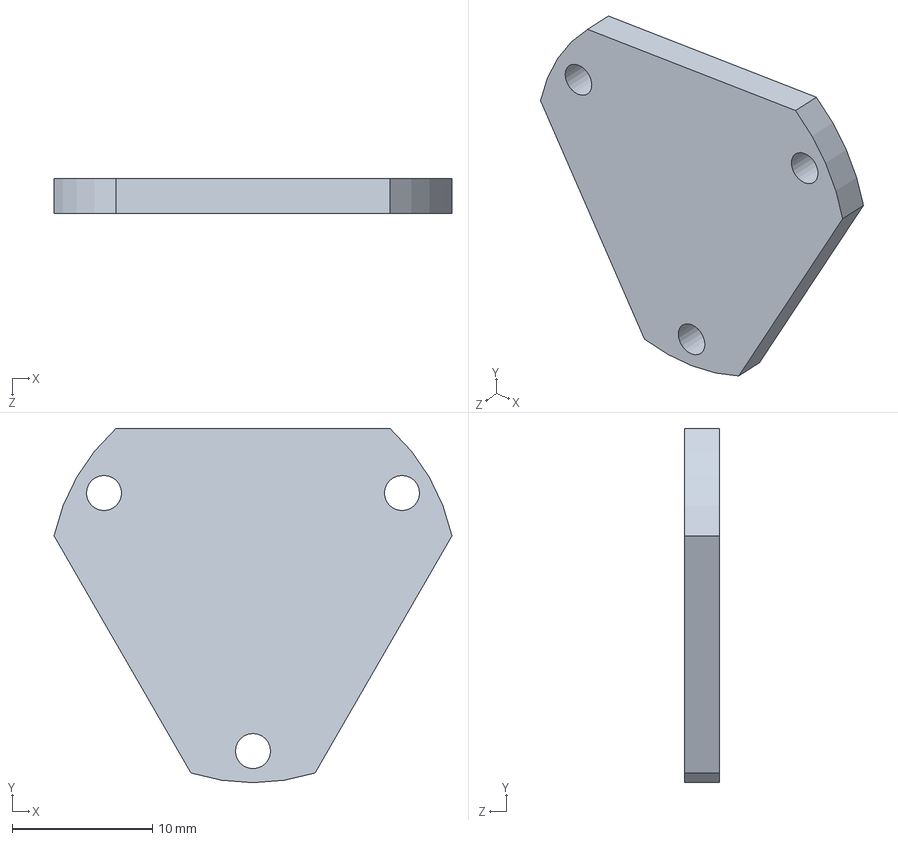
[picture p120: CAD file, 2020-04-05]
3D/(SolidWorks)/Relays/USSR vacuum relay В1В-1В (контур посадочного места).SLDPRT
28.3 x 25.2 x 2.50 mm
