ElessarCuthalion/KiCAD_library/3D/(SolidWorks)/Resistors/+/RES_TRIM Bourns-3314G.sldprt

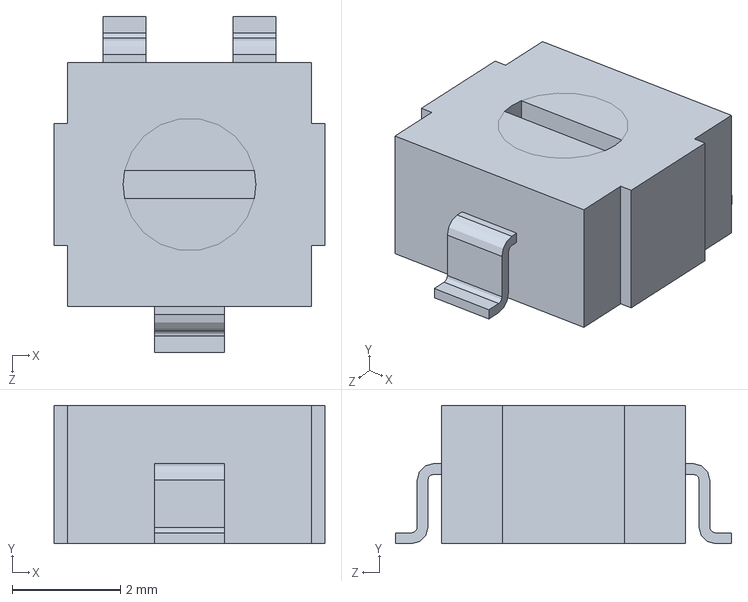
[picture p121: CAD file, 2020-06-02]
3D/(SolidWorks)/Resistors/+/RES_TRIM Bourns-3314G.sldprt
5.00 x 2.55 x 6.20 mm
