ElessarCuthalion/KiCAD_library/3D/(SolidWorks)/Resistors/импонтерованно/Res50-Axial 0.5W-560K.sldprt

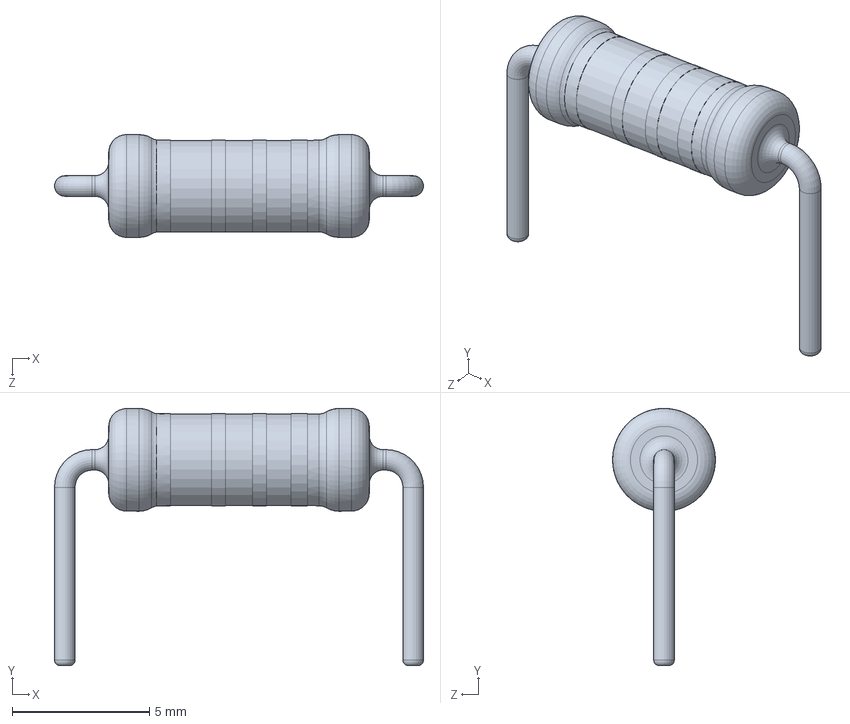
[picture p122: CAD file, 2020-03-07]
3D/(SolidWorks)/Resistors/импонтерованно/Res50-Axial 0.5W-560K.sldprt
13.5 x 9.38 x 3.75 mm
