ElessarCuthalion/KiCAD_library/3D/(SolidWorks)/SOP_MSOP_TSSOP/SOP8_150mil (вар2).sldprt

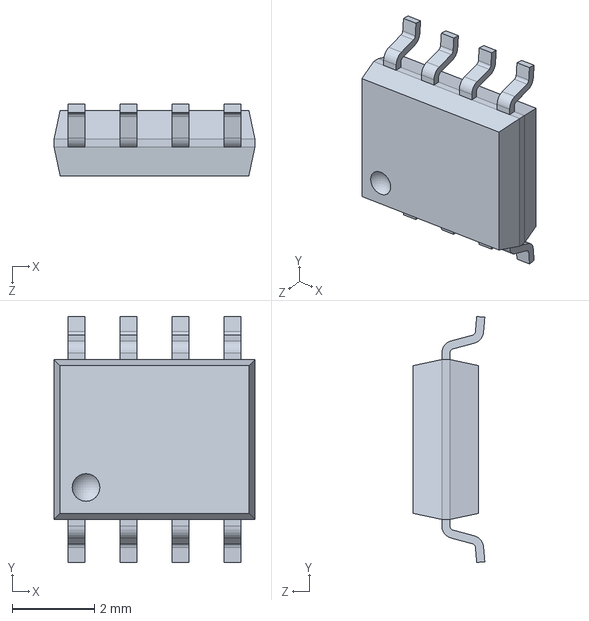
[picture p123: CAD file, 2019-12-26]
3D/(SolidWorks)/SOP_MSOP_TSSOP/SOP8_150mil (вар2).sldprt
4.90 x 6.00 x 1.75 mm
