ElessarCuthalion/KiCAD_library/3D/(SolidWorks)/Connectors/Cleamm-2_5mm - DG126-5.0-xxP/DG126-5.0-02P_DG126.SLDASM

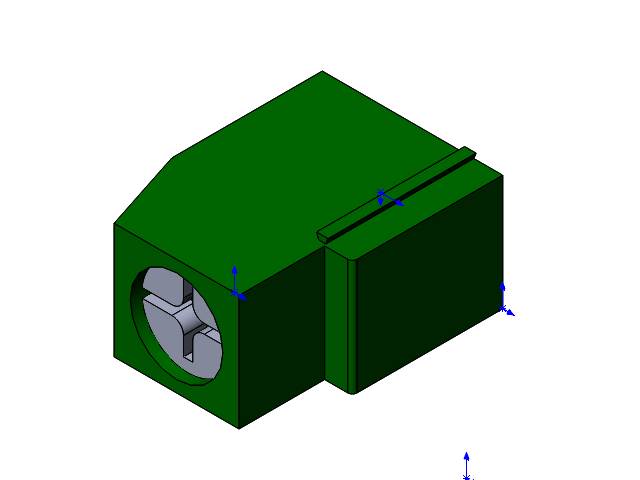
[picture p124: CAD file, 2020-10-18]
3D/(SolidWorks)/Connectors/Cleamm-2_5mm - DG126-5.0-xxP/DG126-5.0-02P_DG126.SLDASM
DG126-5.0-02P_DG126_case
DG126-5.0-02P_Screw
DG126-5.0-02P_DG126_contact
