ElessarCuthalion/KiCAD_library/3D/(SolidWorks)/Hydraulics/Фитинги/Фитинг Мод. FD7590 (8мм).SLDASM

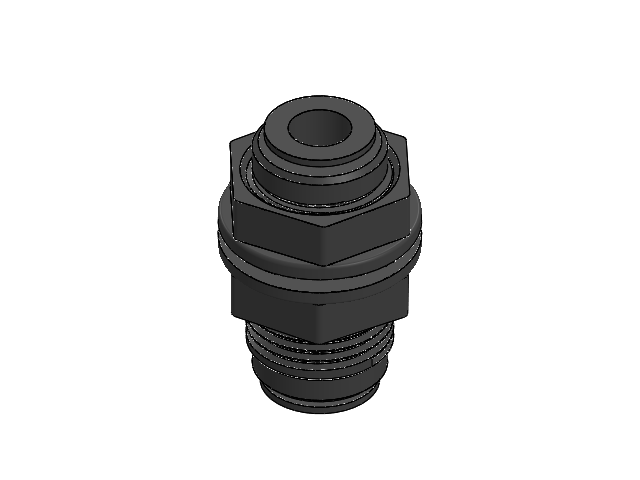
[picture p125: CAD file, 2021-07-01]
3D/(SolidWorks)/Hydraulics/Фитинги/Фитинг Мод. FD7590 (8мм).SLDASM
Часть фитинга (8мм) (7 верс.) (8 верс.) (9верс.)(показ) (10 верс.) 11в. 12в. (13 верс.)
Гайка нафитинг (8мм) (7 верс.) (8 верс.) (9верс.)(показ) (10 верс.) 11в. 12в. (13 верс.) x 2
