ElessarCuthalion/KiCAD_library/3D/(SolidWorks)/Installation/Electrician/Конденсатор BS-ACC-A2-120 B2,1 Belief + Микродвигатель ZF 5-13 T4/Крюк рамы конденсатора.SLDASM

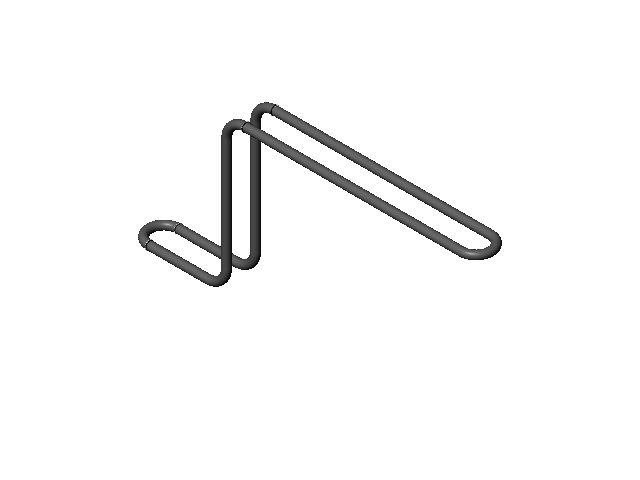
[picture p126: CAD file, 2021-07-01]
3D/(SolidWorks)/Installation/Electrician/Конденсатор BS-ACC-A2-120 B2,1 Belief + Микродвигатель ZF 5-13 T4/Крюк рамы конденсатора.SLDASM
Деталь конденсатора №8_1 x 2
Деталь конденсатора №8_2
Деталь конденсатора №8_3
