ElessarCuthalion/KiCAD_library/3D/(SolidWorks)/Connectors/Cleamm-2_5mm - DG306-5.0-xxP/DG306-5.0-3P_Section.SLDASM

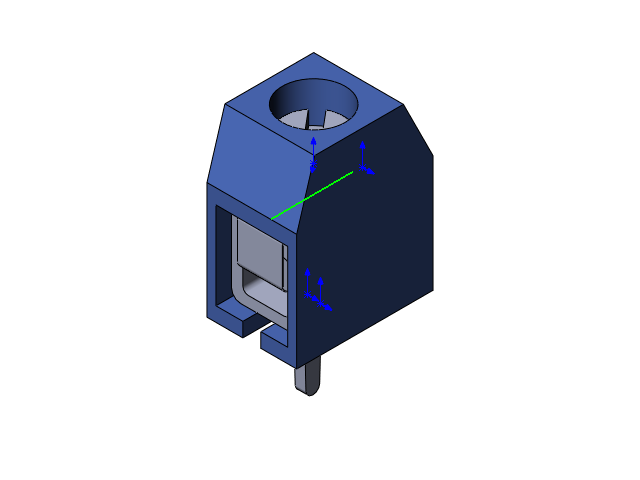
[picture p127: CAD file, 2020-06-08]
3D/(SolidWorks)/Connectors/Cleamm-2_5mm - DG306-5.0-xxP/DG306-5.0-3P_Section.SLDASM
DG306-5.0-3P_Case
DG306-5.0-3P_Leg
DG306-5.0-3P_Spring
DG306-5.0-3P_Cap
