ElessarCuthalion/KiCAD_library/3D/(SolidWorks)/Installation/Electrician/Конденсатор BS-ACC-A2-120 B2,1 Belief + Микродвигатель ZF 5-13 T4/Микродвигатель ZF 5-13 T4.SLDASM

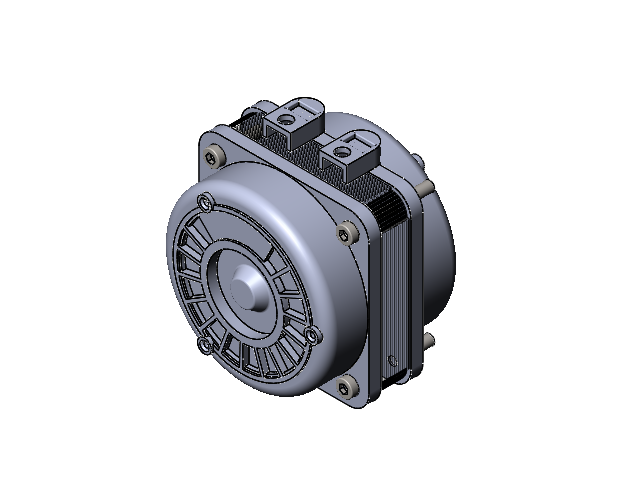
[picture p128: CAD file, 2021-07-01]
3D/(SolidWorks)/Installation/Electrician/Конденсатор BS-ACC-A2-120 B2,1 Belief + Микродвигатель ZF 5-13 T4/Микродвигатель ZF 5-13 T4.SLDASM
Микродвигатель - деталь №1
Микродвигатель - деталь №2
Микродвигатель - деталь №3
socket thin pilot cap screw_din x 4
hex nut style 2 gradeab_din x 4
