ElessarCuthalion/KiCAD_library/3D/(SolidWorks)/Hydraulics/Фитинги/Фитинг Мод. FD7590 (10мм).SLDASM

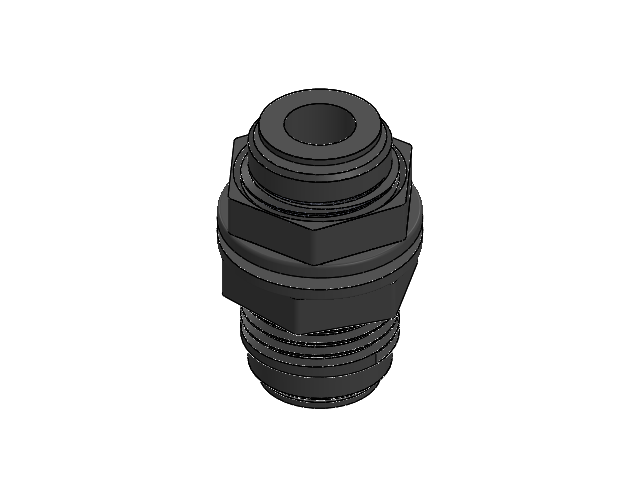
[picture p129: CAD file, 2021-07-01]
3D/(SolidWorks)/Hydraulics/Фитинги/Фитинг Мод. FD7590 (10мм).SLDASM
Часть фитинга (10мм) (7 верс.)дпс (8 верс.) (9верс.)(показ) (10 верс.) 11в. 12в. (13 верс.)
Гайка нафитинг (10мм) (7 верс.)дпс (8 верс.) (9верс.)(показ) (10 верс.) 11в. 12в. (13 верс.) x 2
