ElessarCuthalion/KiCAD_library/3D/(SolidWorks)/Installation/Electrician/Конденсатор BS-ACC-A2-120 B2,1 Belief + Микродвигатель ZF 5-13 T4/Задняя часть конденсатора.SLDASM

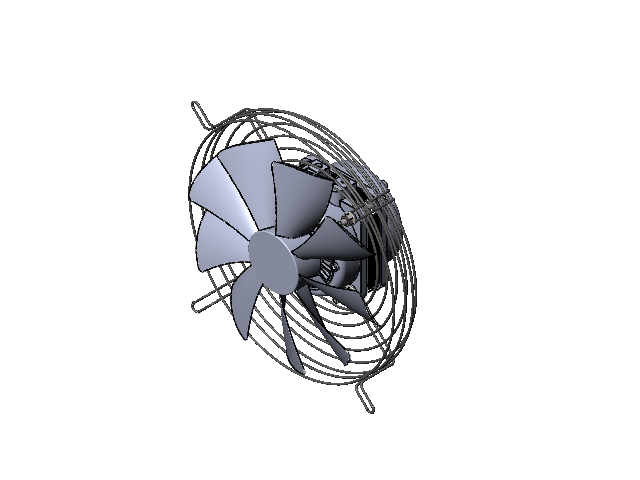
[picture p130: CAD file, 2021-07-01]
3D/(SolidWorks)/Installation/Electrician/Конденсатор BS-ACC-A2-120 B2,1 Belief + Микродвигатель ZF 5-13 T4/Задняя часть конденсатора.SLDASM
Деталь конденсатора №7
Микродвигатель - деталь №1
Микродвигатель - деталь №2
Микродвигатель - деталь №3
socket thin pilot cap screw_din x 4
hex nut style 2 gradeab_din x 4
Деталь конденсатора №8_1 x 8
Деталь конденсатора №8_2 x 4
Деталь конденсатора №8_3 x 4
hex flange nut_din x 4
hex flange bolt_din x 4
Лопости конденсатора
