ElessarCuthalion/KiCAD_library/3D/(SolidWorks)/Installation/Electrician/Конденсатор BS-ACC-A2-120 B2,1 Belief + Микродвигатель ZF 5-13 T4/Сборка медных трубок конденсатора.SLDASM

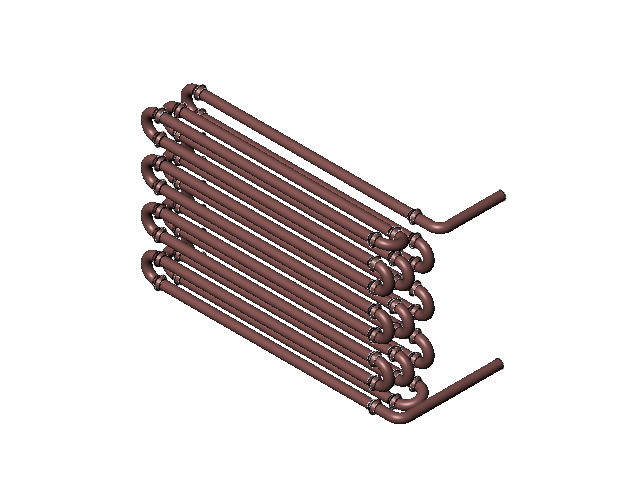
[picture p131: CAD file, 2021-07-01]
3D/(SolidWorks)/Installation/Electrician/Конденсатор BS-ACC-A2-120 B2,1 Belief + Микродвигатель ZF 5-13 T4/Сборка медных трубок конденсатора.SLDASM
Деталь конденсатора №2 x 24
Деталь конденсатора №3 x 23
Деталь конденсатора №4
Деталь конденсатора №5
