ElessarCuthalion/KiCAD_library/(list of files, cad)

Other CAD files:
3D/(SolidWorks)/Power/ResettableFuse/MF-R250/User Library-MF-R250_LEAD.sldasm
3D/(SolidWorks)/Power/PwrSupp_MW_RS-25-5/PwrSupp_MW_RS-25-5.SLDASM
3D/(SolidWorks)/Connectors/USB-B vetrical IGS-61400413321/User Library-IGS-61400413321-rev1_DEFAULT.sldasm
3D/(SolidWorks)/LEDs/Импортированы/LED5050 RGB/Body.sldasm
3D/(SolidWorks)/Opto/opto_SOP4-2.54 - KAQY21xS/Body.sldasm
3D/(SolidWorks)/Buttons_Switches/Импортированно/Switch MSK-22D18/MSK-22D18-ZPT_MMP221_PP.sldprt
3D/(SolidWorks)/Connectors/USB-B vetrical IGS-61400413321/User Library-IGS-61400413321-rev1_DEFAULT-2.sldprt
3D/(SolidWorks)/Connectors/Импортированно/MicroSD Socket 112C-TXAR-R02_C_1 (с крышкой)/User Library-112C-TXAR-R02_C_1_201-1.sldprt
3D/(SolidWorks)/Connectors/Импортированно/USB-B-S-X-W-TH/User Library-Samtec - USB-B-S-X-W-TH_rear shell-USB BF TH____2.sldprt
3D/(SolidWorks)/Connectors/Импортированно/USB-micro B+Hole/User Library-usb_port_ch_USBPORT_CH.sldprt
3D/(SolidWorks)/Inductors/Импортированно/4x Ferrite Bead 0804 SMD/User Library-FB-0804-4x_Clone_of_Array.sldprt
3D/(SolidWorks)/Inductors/Импортированно/CDRH104R/User Library-cdrh104r_CDRH104R_KORPUS.sldprt
3D/(SolidWorks)/Inductors/Импортированно/Ferrite Bead 0805/User Library-FB_2012-1_Pad001.sldprt
3D/(SolidWorks)/Inductors/Импортированно/SDE0805/User Library-Inductor_SDE0805_Pad003.sldprt
3D/(SolidWorks)/Installation/Electrician/IEC_FILTER (B84771A0015A000, 15A 250V) - импортированно/IEC_FILTER_L-N_TAB.sldprt
3D/(SolidWorks)/Installation/Импортированно/Fuse Holder LF-102071/Clips LF-102071 with fuse 6.3x32_LF 102071.sldprt
3D/(SolidWorks)/Installation/Импортированно/PIR D203S TO5-3 + Case/PIR Sensor_PIR plastic.sldprt
3D/(SolidWorks)/LEDs/RGB-CC_DIP-5mm BL-L515s.SLDPRT
3D/(SolidWorks)/Modules/Raspberry/Импортированно/Rpi components/Raspberry Pi 3171.sldprt
3D/(SolidWorks)/Opto/opto_SOP4-2.54 - KAQY21xS/Open_CASCADE_STEP_translator_6.8_1.1.sldprt
3D/(SolidWorks)/Opto/Импортированно/opto MOC8050SR2M_SMDIP-6/MOC8050SR2M_dipso6body_1.sldprt
3D/(SolidWorks)/QFN_DFN_LGA/Импортированно/MP4432 (QFN16_3mmx4mm)/User Library-MP4432(QFN-16-3mmx4mm)_Part_868.sldprt
3D/(SolidWorks)/QFN_DFN_LGA/Импортированно/R-PWSON-N16/User Library-R-PWSON-N16_Compound002.sldprt
3D/(SolidWorks)/Radio/Импортированно/2450BM14A0002/User Library-2450BM14A0002_Pad002.sldprt
3D/(SolidWorks)/Radio/Импортированно/Balun 2450BM15/User Library-Balun 2450BM15_Part29.sldprt
3D/(SolidWorks)/! Examples/Вырез для магнита D3x5мм, WoodFill.SLDPRT
3D/(SolidWorks)/! Examples/Вырез для петли Hinge 20x16mm, WoodFill.SLDPRT
3D/(SolidWorks)/! Examples/Вырез для петли Hinge 42x14mm +упор крышки, WoodFill.SLDPRT
3D/(SolidWorks)/! Examples/Вырез для петли Hinge 42x14mm, WoodFill.SLDPRT
3D/(SolidWorks)/! Examples/Вырез под USB-micro 5Pin for wire, WoodFill.SLDPRT
3D/(SolidWorks)/! Examples/Вырез под динамик Speaker_18x13, PLA.SLDPRT
3D/(SolidWorks)/! Examples/Вырез под динамик Speaker_D40x5.8, WoodFill.SLDPRT
3D/(SolidWorks)/! Examples/Держатель мотора StepMotor_9x8mm.SLDPRT
3D/(SolidWorks)/! Examples/Сквозной вырез для винтов впотай D2.5mm, шляпка D5mm, PLA, WoodFill.SLDPRT
3D/(SolidWorks)/! Examples/Сквозной вырез для саморезов впотай D2.5mm, шляпка D5mm, WoodFill.SLDPRT
3D/(SolidWorks)/! Examples/Стойка и отверстие под саморез D2.0mm, WoodFill.SLDPRT
3D/(SolidWorks)/! Examples/Стойка и отверстие под саморез D2.5mm, WoodFill.SLDPRT
3D/(SolidWorks)/! Examples/Шпон-паз для двигателя GM15BY (FIT0503), WoodFill.SLDPRT
3D/(SolidWorks)/Battery_&_Holders/BatHolder 3xAA/BatteryHolder 3xAA Case.SLDPRT
3D/(SolidWorks)/Battery_&_Holders/BatHolder 3xAA/Part2.SLDPRT
3D/(SolidWorks)/Battery_&_Holders/BatHolder 3xAA/Part4.SLDPRT
3D/(SolidWorks)/Battery_&_Holders/Battery 18650 2.SLDPRT
3D/(SolidWorks)/Battery_&_Holders/Battery 18650.SLDPRT
3D/(SolidWorks)/Battery_&_Holders/Battery 30x20x5.SLDPRT
3D/(SolidWorks)/Battery_&_Holders/Battery 48x30x5.SLDPRT
3D/(SolidWorks)/Battery_&_Holders/Battery 50x30x5.SLDPRT
3D/(SolidWorks)/Battery_&_Holders/Battery AA.SLDPRT
3D/(SolidWorks)/Battery_&_Holders/Battery AAA.SLDPRT
3D/(SolidWorks)/Battery_&_Holders/Battery BL-5C.SLDPRT
3D/(SolidWorks)/Battery_&_Holders/Battery CR2032.SLDPRT
3D/(SolidWorks)/Battery_&_Holders/Battery LIR123.SLDPRT
3D/(SolidWorks)/Battery_&_Holders/BatteryHolder 1x18650.SLDPRT
3D/(SolidWorks)/Battery_&_Holders/BatteryHolder 1xAA.SLDPRT
3D/(SolidWorks)/Battery_&_Holders/BatteryHolder 1xAAA.SLDPRT
3D/(SolidWorks)/Battery_&_Holders/BatteryHolder 2xAAA.SLDPRT
3D/(SolidWorks)/Battery_&_Holders/BatteryHolder 3x18650.SLDPRT
3D/(SolidWorks)/Battery_&_Holders/BatteryHolder 3xAA.SLDPRT
3D/(SolidWorks)/Battery_&_Holders/BatteryHolder 3xAAA.SLDPRT
3D/(SolidWorks)/Battery_&_Holders/BatteryHolder 4xAAA.SLDPRT
3D/(SolidWorks)/Battery_&_Holders/BatteryHolder CR2032 - BAT-HLD-001 (TBH-CR2032-M04).sldprt
3D/(SolidWorks)/Battery_&_Holders/BatteryHolder CR2032 - CH25-2032LF.sldprt
3D/(SolidWorks)/Battery_&_Holders/BatteryHolder CR2032 - CH7410.SLDPRT
3D/(SolidWorks)/Battery_&_Holders/BatteryHolder CR2032 - KLS5-CR2032-03.sldprt
3D/(SolidWorks)/Battery_&_Holders/BatteryHolder CR2032 - Keystone 3002TR.sldprt
3D/(SolidWorks)/Battery_&_Holders/Li-Pol_28.5x24.5x8.3_852526_Robiton_500mAh.SLDPRT
3D/(SolidWorks)/Battery_&_Holders/Li-Pol_29.5x28x3.2_30303_280mAh.SLDPRT
3D/(SolidWorks)/Battery_&_Holders/Li-Pol_31.5x20x3_302030_320mAh.SLDPRT
3D/(SolidWorks)/Battery_&_Holders/Li-Pol_32x30x6_603030_750mAh.SLDPRT
3D/(SolidWorks)/Battery_&_Holders/Li-Pol_36.5x19.5x6_602035_600mAh.SLDPRT
3D/(SolidWorks)/Battery_&_Holders/Li-Pol_36.5x25x3_302535_350mAh.SLDPRT
3D/(SolidWorks)/Battery_&_Holders/Li-Pol_36.8x29.7x4_043035_500mAh.SLDPRT
3D/(SolidWorks)/Battery_&_Holders/Li-Pol_37x30.5x4.4_043035_500mAh.SLDPRT
3D/(SolidWorks)/Battery_&_Holders/Li-Pol_40.5x24.5x4_042440_500mAh.SLDPRT
3D/(SolidWorks)/Battery_&_Holders/Li-Pol_41.5x30x4_043040_600mAh.SLDPRT
3D/(SolidWorks)/Battery_&_Holders/Li-Pol_41x20x3_302040_500mAh.SLDPRT
3D/(SolidWorks)/Battery_&_Holders/Li-Pol_41x30x5_503040_Robiton_550mAh.SLDPRT
3D/(SolidWorks)/Battery_&_Holders/Li-Pol_47x30x3_043048_700mAh.SLDPRT
3D/(SolidWorks)/Battery_&_Holders/Li-Pol_51.5x20x4_042048_500mAh.SLDPRT
3D/(SolidWorks)/Battery_&_Holders/Li-Pol_60x36x4_043759_1000mAh.SLDPRT
3D/(SolidWorks)/Battery_&_Holders/Samsung ICR18650-30B.SLDPRT
3D/(SolidWorks)/Battery_&_Holders/Samsung ICR18650-30B.STEP
3D/(SolidWorks)/Battery_&_Holders/Samsung ICR18650-30B.step.SLDPRT
3D/(SolidWorks)/Battery_&_Holders/Samsung INR18650-29R.SLDPRT
3D/(SolidWorks)/Battery_&_Holders/Sanyo UR18650ZY.sldprt
3D/(SolidWorks)/Battery_&_Holders/Импортированно/BatteryHolder CR2032 - CH7410/BatteryHolder CH7410 - вар.2.STEP
3D/(SolidWorks)/Battery_&_Holders/Импортированно/BatteryHolder CR2032 - CH7410/User Library-bat_holder_ch7410_2032_Cube005.sldprt
3D/(SolidWorks)/Battery_&_Holders/Импортированно/BatteryHolder CR2032 - CH7410/User Library-bat_holder_ch7410_2032_Cube007.sldprt
3D/(SolidWorks)/Battery_&_Holders/Импортированно/BatteryHolder CR2032 - CH7410/User Library-bat_holder_ch7410_2032_Cut007.sldprt
3D/(SolidWorks)/Battery_&_Holders/Импортированно/BatteryHolder CR2032 - CH7410/User Library-bat_holder_ch7410_2032_Fillet001.sldprt
3D/(SolidWorks)/Battery_&_Holders/Импортированно/BatteryHolder CR2032 - CH7410/User Library-bat_holder_ch7410_2032_Fillet003.sldprt
3D/(SolidWorks)/Battery_&_Holders/Импортированно/BatteryHolder CR2032 - CH7410/User Library-bat_holder_ch7410_2032_Revolve002.sldprt
3D/(SolidWorks)/Battery_&_Holders/Импортированно/BatteryHolder CR2032 - CH7410/User Library-bat_holder_ch7410_2032_kont1.sldprt
3D/(SolidWorks)/Battery_&_Holders/Импортированно/BatteryHolder CR2032 - CH7410/User Library-bat_holder_ch7410_2032_kont4.sldprt
3D/(SolidWorks)/Bearings/+/Ball Bearing 6000.sldprt
3D/(SolidWorks)/Bearings/+/Ball Bearing _2500 ID, _500 OD, _1875 W.sldprt
3D/(SolidWorks)/Bearings/+/Ball Bearing _375 ID, _875 OD, _210 W.sldprt
3D/(SolidWorks)/Bearings/+/D28x54h9 R18.sldprt
3D/(SolidWorks)/Bearings/+/RoundLinearBearing6x19.SLDPRT
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
