ElessarCuthalion/KiCAD_library/3D/(SolidWorks)/Installation/Stones/Quartz crystal big 3.jpg

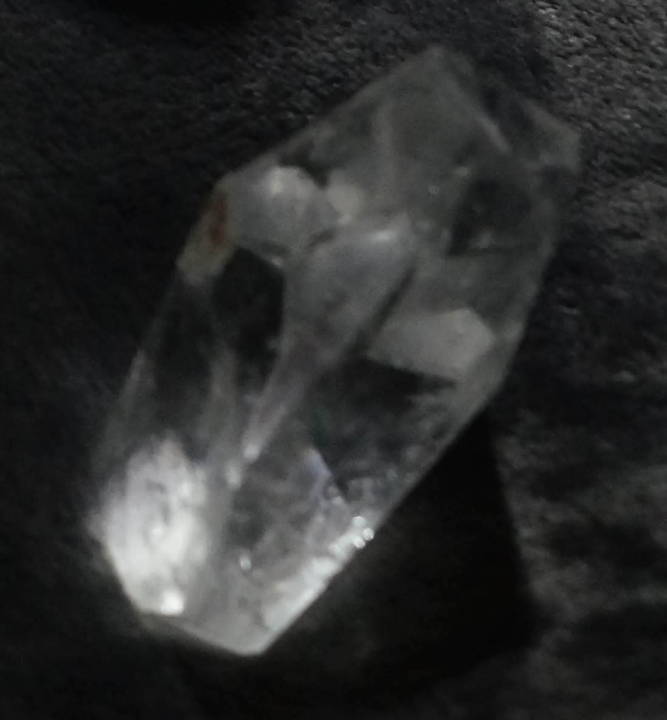
3D/(SolidWorks)/Installation/Stones/Quartz crystal big 3.jpg
