ElessarCuthalion/KiCAD_library/3D/(SolidWorks)/Installation/Stones/Quartz crystal mid_1 1.jpg

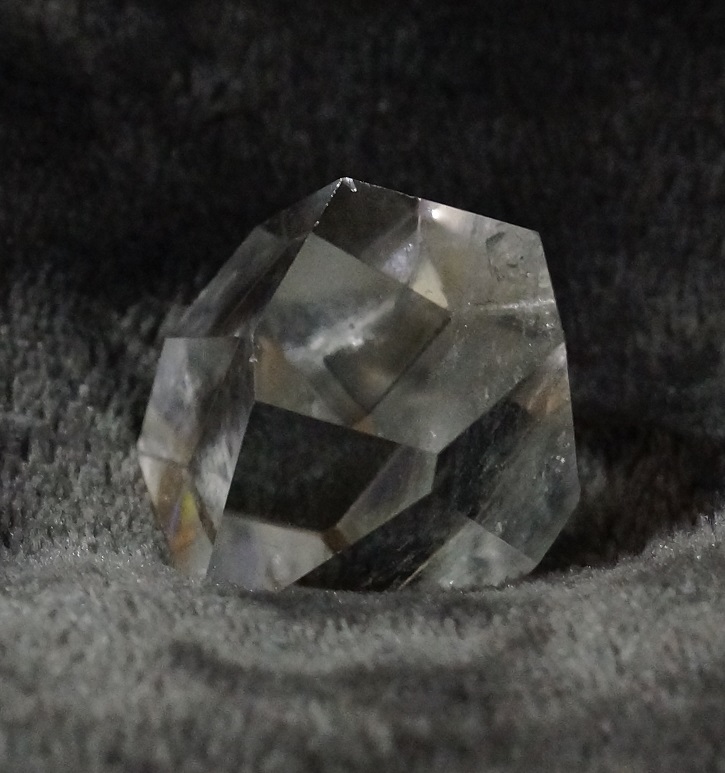
3D/(SolidWorks)/Installation/Stones/Quartz crystal mid_1 1.jpg
