ElessarCuthalion/KiCAD_library/3D/(SolidWorks)/Installation/Stones/Quartz crystal mid_1 2.jpg

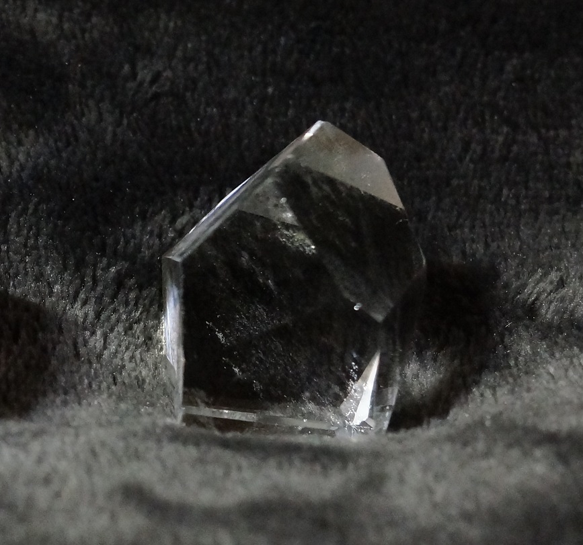
3D/(SolidWorks)/Installation/Stones/Quartz crystal mid_1 2.jpg
