ElessarCuthalion/KiCAD_library/3D/(SolidWorks)/Installation/Stones/Quartz crystal mid_1 3.jpg

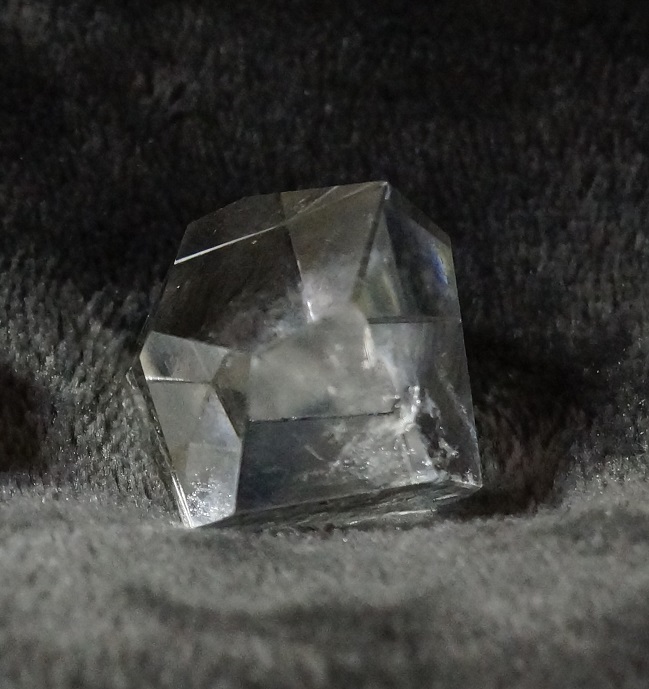
3D/(SolidWorks)/Installation/Stones/Quartz crystal mid_1 3.jpg
