ElessarCuthalion/KiCAD_library/!Template/sch/USB-C PCB HUSB238.kicad_sch

## KiCad design !Template/sch/USB-C PCB HUSB238.kicad_sch (2025-10-13)

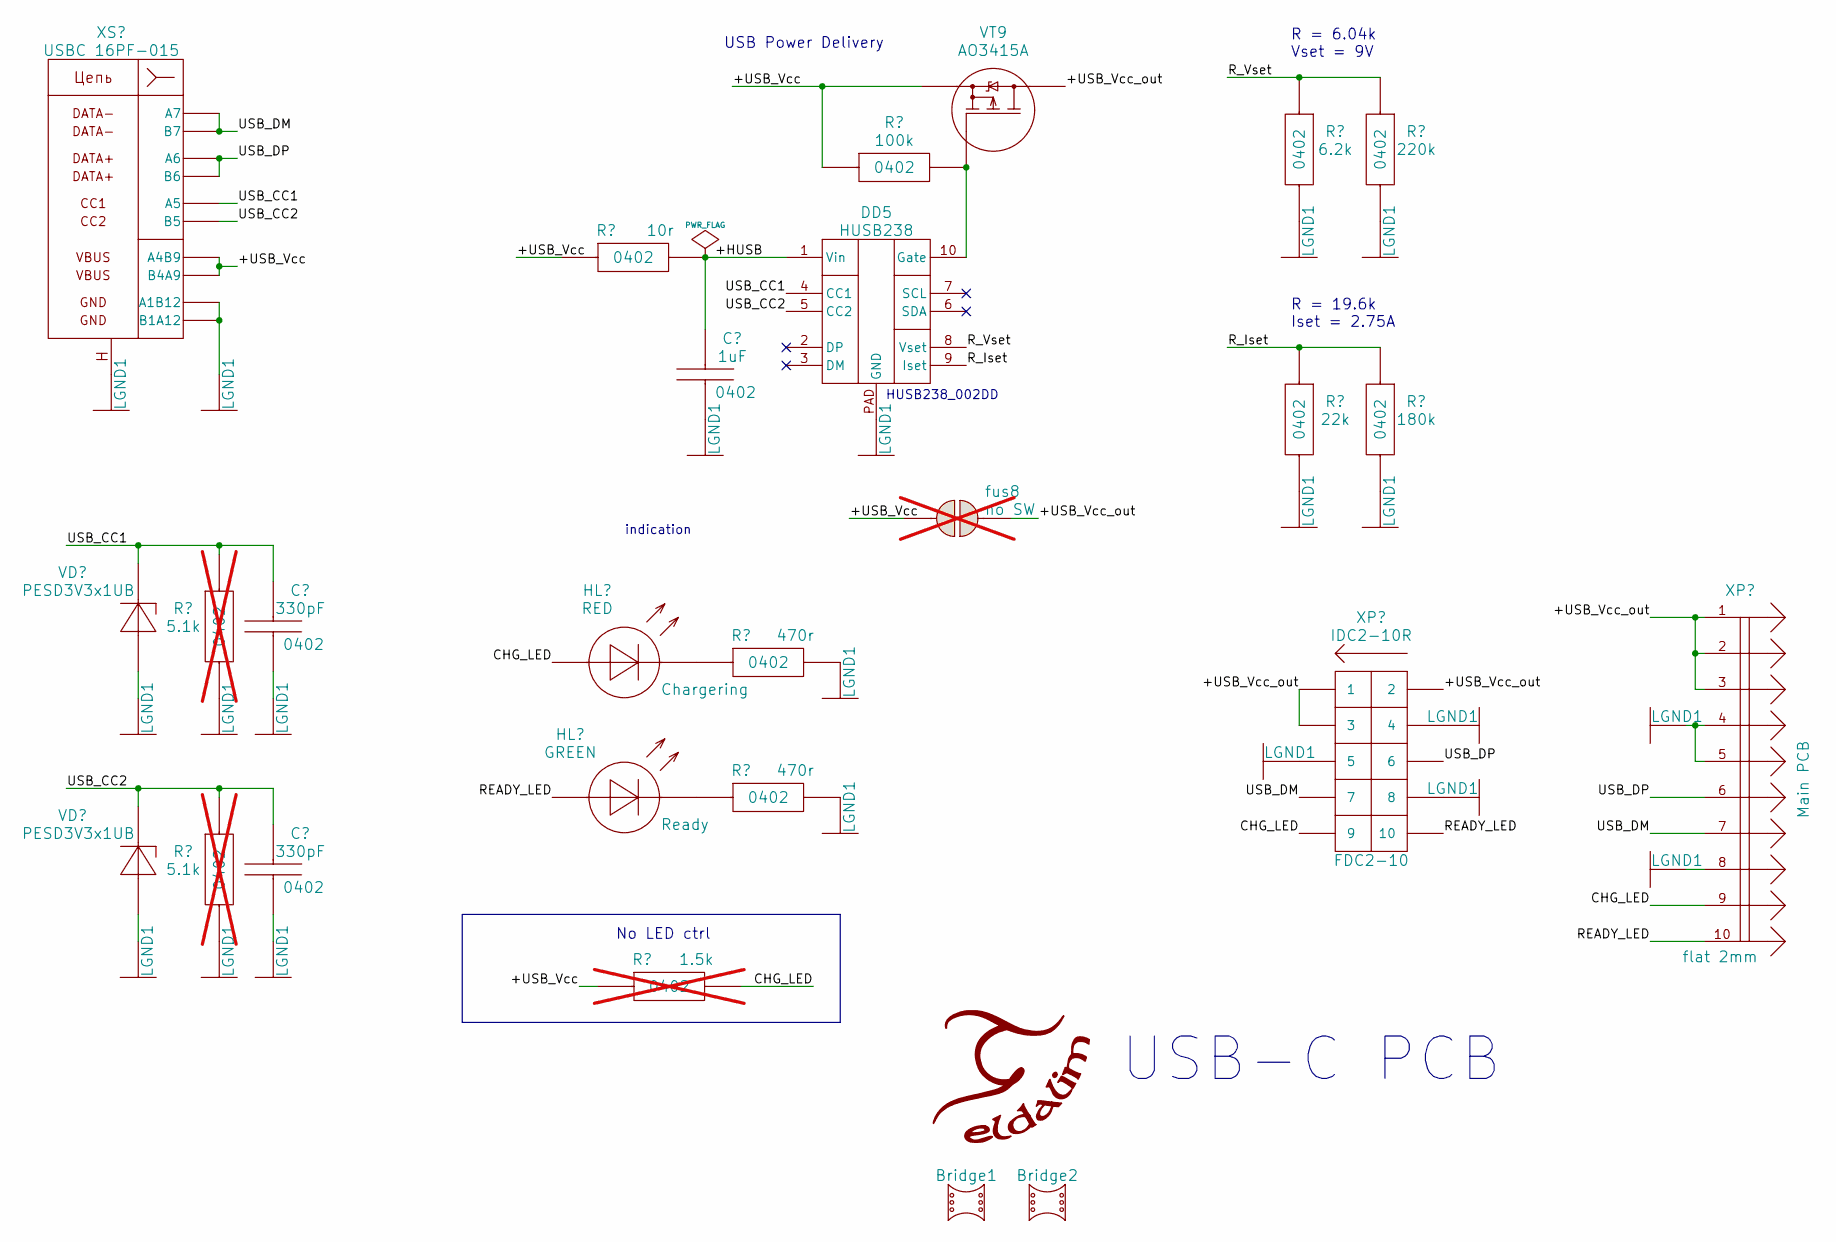
[picture p136: schematic USB-C PCB HUSB238.kicad_sch]

Parts:
Bridge1, Bridge2: Bridge_PCB; BridgePCB_exHole_2mm
C57, C58: 330pF; CAP0402
C59: 1uF; CAP0402
DD5: HUSB238; DFN10
HL3: RED; LED0603
HL4: GREEN; LED0603
Logo2: Eldalim; Eldalim_7x6
R35, R36: 5.1k; RES0402; not fitted
R37: 10r; RES0402
R38: 1.5k; RES0402; not fitted
R39, R40: 470r; RES0402
R41: 100k; RES0402
R42: 6.2k; RES0402
R43: 22k; RES0402
R44: 220k; RES0402
R45: 180k; RES0402
VD14, VD15: PESD3V3x1UB; SOD523
VT9: AO3415A; SOT23A
XP9: IDC2-10R; FDC2-10
XP10: Main PCB; FlatConn-10_1
XS3: USBC 16PF-015; USB-C_16pin_16PF-015
fus8: no SW; FuseSolder; not fitted

Connections:
+HUSB: C59.1, DD5.1 (Vin), R37.2
+USB_Vcc: R37.1, R41.1, VT9.2 (S), XS3.A4B9, XS3.B4A9, fus8.1
+USB_Vcc_out: VT9.3 (D), XP9.1, XP9.2, XP9.3, XP10.1, XP10.2, XP10.3, fus8.2
CHG_LED: XP9.9, XP10.9
LGND1: C57.2, C58.2, C59.2, DD5.PAD (GND), R35.2, R36.2, R39.2, R40.2, R42.2, R43.2, R44.2, R45.2, VD14.A, VD15.A, XP9.4, XP9.5, XP9.8, XP10.4, XP10.5, XP10.8, XS3.A1B12, XS3.B1A12, XS3.SHLD
unnamed: DD5.10 (Gate), R41.2, VT9.1 (G)
READY_LED: XP9.10, XP10.10
R_Iset: DD5.9 (Iset), R43.1, R45.1
R_Vset: DD5.8 (Vset), R42.1, R44.1
USB_CC1: C57.1, DD5.4 (CC1), R35.1, VD14.C, XS3.A5
USB_CC2: C58.1, DD5.5 (CC2), R36.1, VD15.C, XS3.B5
USB_DM: XP9.7, XP10.7, XS3.A7, XS3.B7
USB_DP: XP9.6, XP10.6, XS3.A6, XS3.B6

Notes on the sheet:
HUSB238_002DD
indication
R = 6.04k Vset = 9V
USB-C PCB
R = 19.6k Iset = 2.75A
No LED ctrl
USB Power Delivery
