ElessarCuthalion/KiCAD_library/!Template/sch/res_Audio CS42L52.kicad_sch

## KiCad design !Template/sch/res_Audio CS42L52.kicad_sch (2025-10-13)

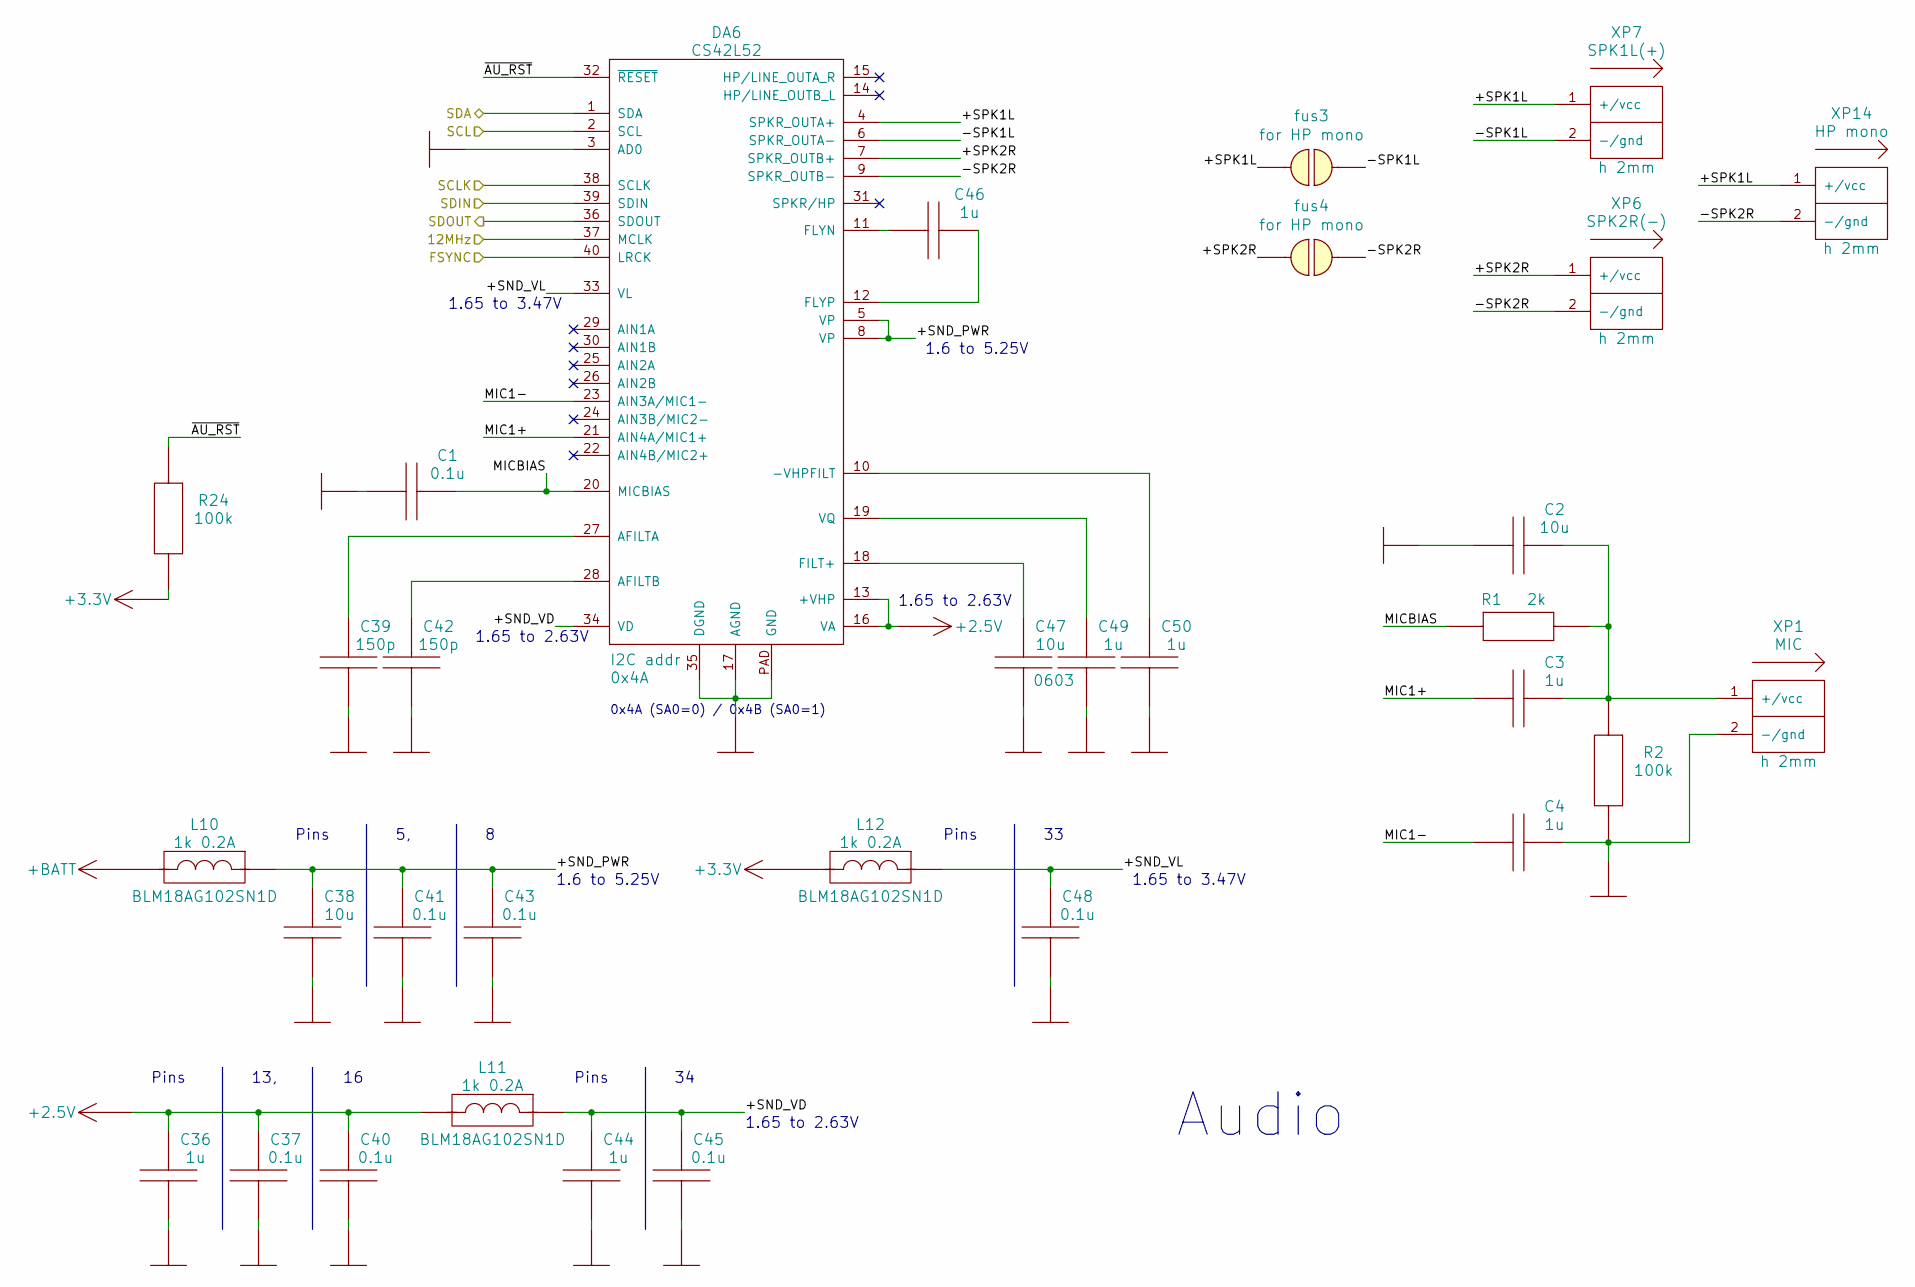
[picture p137: schematic res_Audio CS42L52.kicad_sch]

Parts:
C1, C37, C40, C41, C43, C45, C48: 0.1u; CAP0603
C2, C38, C47: 10u; CAP0603
C3, C4, C36, C44, C46, C49, C50: 1u; CAP0603
C39, C42: 150p; CAP0603
DA6: CS42L52; HQFN40
L10, L11, L12: 1k 0.2A; Bead_0603
R1: 2k; RES0603
R2, R24: 100k; RES0603
XP1: MIC; for_PolarOut_PLS2-2
XP6: SPK2R(-); for_PolarOut_PLS2-2
XP7: SPK1L(+); for_PolarOut_PLS2-2
XP14: HP mono; for_PolarOut_Flat1,5-2
fus3, fus4: for HP mono; FuseSolder

Connections:
12MHz: DA6.37 (MCLK)
+2.5V: C36.1, C37.1, C40.1, DA6.13 (+VHP), DA6.16 (VA), L11.1
+3.3V: L12.1
+BATT: L10.1
+SND_PWR: C38.1, C41.1, C43.1, DA6.5 (VP), DA6.8 (VP), L10.2
+SND_VD: C44.1, C45.1, DA6.34 (VD), L11.2
+SND_VL: C48.1, DA6.33 (VL), L12.2
+SPK1L: DA6.4 (SPKR_OUTA+), XP7.1 (+/vcc), XP14.1 (+/vcc), fus3.1
+SPK2R: DA6.7 (SPKR_OUTB+), XP6.1 (+/vcc), fus4.1
-SPK1L: DA6.6 (SPKR_OUTA-), XP7.2 (-/gnd), fus3.2
-SPK2R: DA6.9 (SPKR_OUTB-), XP6.2 (-/gnd), XP14.2 (-/gnd), fus4.2
FSYNC: DA6.40 (LRCK)
GND: C36.2, C37.2, C38.2, C39.2, C40.2, C41.2, C42.2, C43.2, C44.2, C45.2, C47.2, C48.2, C49.2, C50.2, DA6.3 (AD0), DA6.17 (AGND), DA6.35 (DGND), DA6.PAD (GND), XP1.2 (-/gnd)
MIC1+: DA6.21 (AIN4A/MIC1+)
MIC1-: DA6.23 (AIN3A/MIC1-)
MICBIAS: DA6.20 (MICBIAS), R1.1
unnamed: C39.1, DA6.27 (AFILTA)
unnamed: C42.1, DA6.28 (AFILTB)
unnamed: C47.1, DA6.18 (FILT+)
unnamed: C49.1, DA6.19 (VQ)
unnamed: C50.1, DA6.10 (-VHPFILT)
unnamed: R1.2, XP1.1 (+/vcc)
SCL: DA6.2 (SCL)
SCLK: DA6.38 (SCLK)
SDA: DA6.1 (SDA)
SDIN: DA6.39 (SDIN)
SDOUT: DA6.36 (SDOUT)
~AU_RST: DA6.32 (~RESET)

Notes on the sheet:
0x4A (SA0=0) / 0x4B (SA0=1)
Pins 13, 16
Audio
1.65 to 3.47V
1.65 to 2.63V
1.6 to 5.25V
Pins 5, 8
Pins 34
Pins 33
