ElessarCuthalion/KiCAD_library/!Template/sch/res_Ethernet W5500.kicad_sch

## KiCad design !Template/sch/res_Ethernet W5500.kicad_sch (2025-10-13)

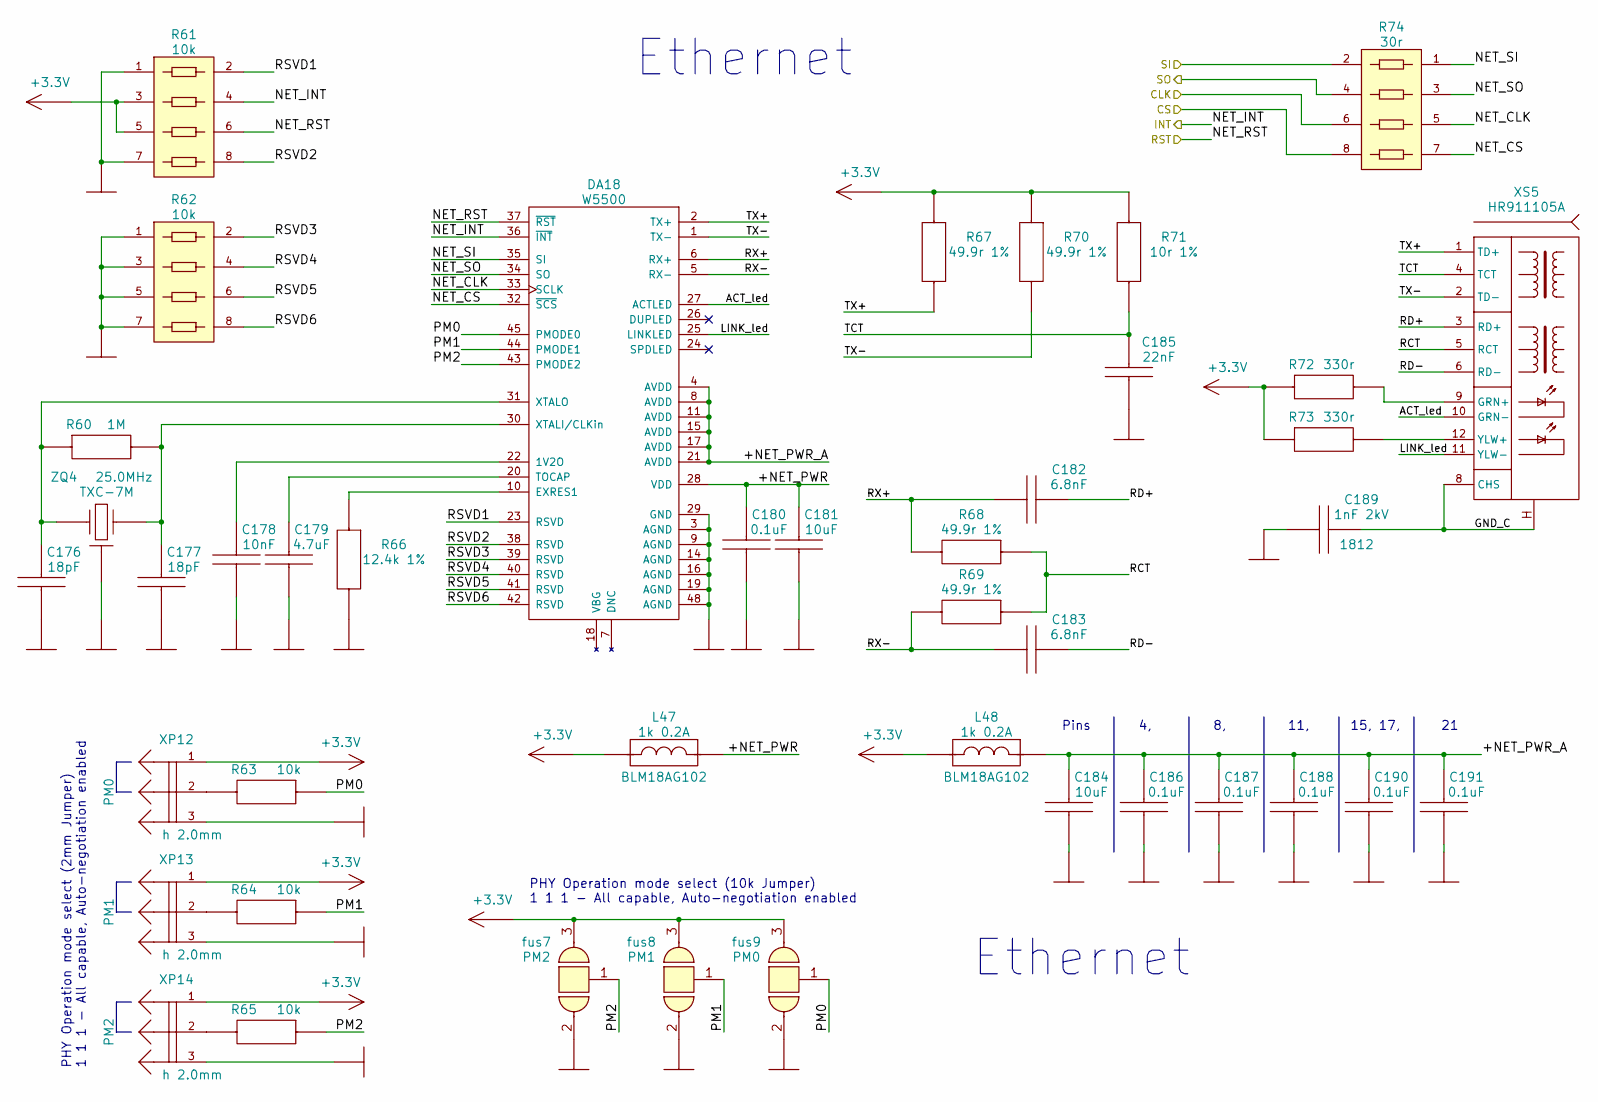
[picture p138: schematic res_Ethernet W5500.kicad_sch]

Parts:
C176, C177: 18pF; CAP0603
C178: 10nF; CAP0603
C179: 4.7uF; CAP0603
C180, C186, C187, C188, C190, C191: 0.1uF; CAP0603
C181, C184: 10uF; CAP0603
C182, C183: 6.8nF; CAP0603
C185: 22nF; CAP0603
C189: 1nF 2kV; CAP1812; Voltage V
DA18: W5500; LQFP48
L47, L48: 1k 0.2A; Bead_0603
R60: 1M; RES0603
R61, R62: 10k; RES0612x4
R63, R64, R65: 10k; RES0603
R66: 12.4k 1%; RES0603
R67, R68, R69, R70: 49.9r 1%; RES0603
R71: 10r 1%; RES0603
R72, R73: 330r; RES0603
R74: 30r; RES0612x4
XP12: PM0; PLS2-3
XP13: PM1; PLS2-3
XP14: PM2; PLS2-3
XS5: HR911105A; TJ-8P8C+TR_HR911105A
ZQ4: 25.0MHz; Crystal_3225
fus7: PM2; FuseSolder_x2_0603
fus8: PM1; FuseSolder_x2_0603
fus9: PM0; FuseSolder_x2_0603

Connections:
+3.3V: L47.1, L48.1, R61.3, R61.5, R72.1, R73.1, XP12.1, XP13.1, XP14.1, fus7.3, fus8.3, fus9.3
+NET_PWR: C180.1, C181.1, DA18.28 (VDD), L47.2
+NET_PWR_A: C184.1, C186.1, C187.1, C188.1, C190.1, C191.1, DA18.4 (AVDD), DA18.8 (AVDD), DA18.11 (AVDD), DA18.15 (AVDD), DA18.17 (AVDD), DA18.21 (AVDD), L48.2
ACT_led: DA18.27 (ACTLED)
CLK: R74.6
CS: R74.8
GND: C176.2, C177.2, C178.2, C179.2, C180.2, C181.2, C184.2, C185.2, C186.2, C187.2, C188.2, C190.2, C191.2, DA18.3 (AGND), DA18.9 (AGND), DA18.14 (AGND), DA18.16 (AGND), DA18.19 (AGND), DA18.29 (GND), DA18.48 (AGND), R61.1, R61.7, R62.1, R62.3, R62.5, R62.7, XP12.3, XP13.3, XP14.3, ZQ4.H, fus7.2, fus8.2, fus9.2
INT: DA18.36 (~INT), R61.4
LINK_led: DA18.25 (LINKLED)
NET_CLK: DA18.33 (SCLK), R74.5
NET_CS: DA18.32 (~SCS), R74.7
NET_RST: DA18.37 (~RST), R61.6
NET_SI: DA18.35 (SI), R74.1
NET_SO: DA18.34 (SO), R74.3
unnamed: C176.1, DA18.31 (XTALO), R60.1, ZQ4.1
unnamed: C177.1, DA18.30 (XTALI/CLKin), R60.2, ZQ4.2
unnamed: C178.1, DA18.22 (1V2O)
unnamed: C179.1, DA18.20 (TOCAP)
unnamed: R63.2, XP12.2
unnamed: R64.2, XP13.2
unnamed: R65.2, XP14.2
PM0: DA18.45 (PMODE0), R63.1, fus9.1
PM1: DA18.44 (PMODE1), R64.1, fus8.1
PM2: DA18.43 (PMODE2), R65.1, fus7.1
RCT: R68.1, R69.1
RSVD1: DA18.23 (RSVD), R61.2
RSVD2: DA18.38 (RSVD), R61.8
RSVD3: DA18.39 (RSVD), R62.2
RSVD4: DA18.40 (RSVD), R62.4
RSVD5: DA18.41 (RSVD), R62.6
RSVD6: DA18.42 (RSVD), R62.8
RX+: DA18.6 (RX+), R68.2
RX-: DA18.5 (RX-), R69.2
SI: R74.2
SO: R74.4
TCT: C185.1
TX+: DA18.2 (TX+)
TX-: DA18.1 (TX-)

Notes on the sheet:
Ethernet
PHY Operation mode select (2mm Jumper) 1 1 1 - All capable, Auto-negotiation enabled
PHY Operation mode select (10k Jumper) 1 1 1 - All capable, Auto-negotiation enabled
Pins 4, 8, 11, 15, 17, 21
