ElessarCuthalion/KiCAD_library/!Template/sch/res_RS-422_sensors.kicad_sch

## KiCad design !Template/sch/res_RS-422_sensors.kicad_sch (2025-10-13)

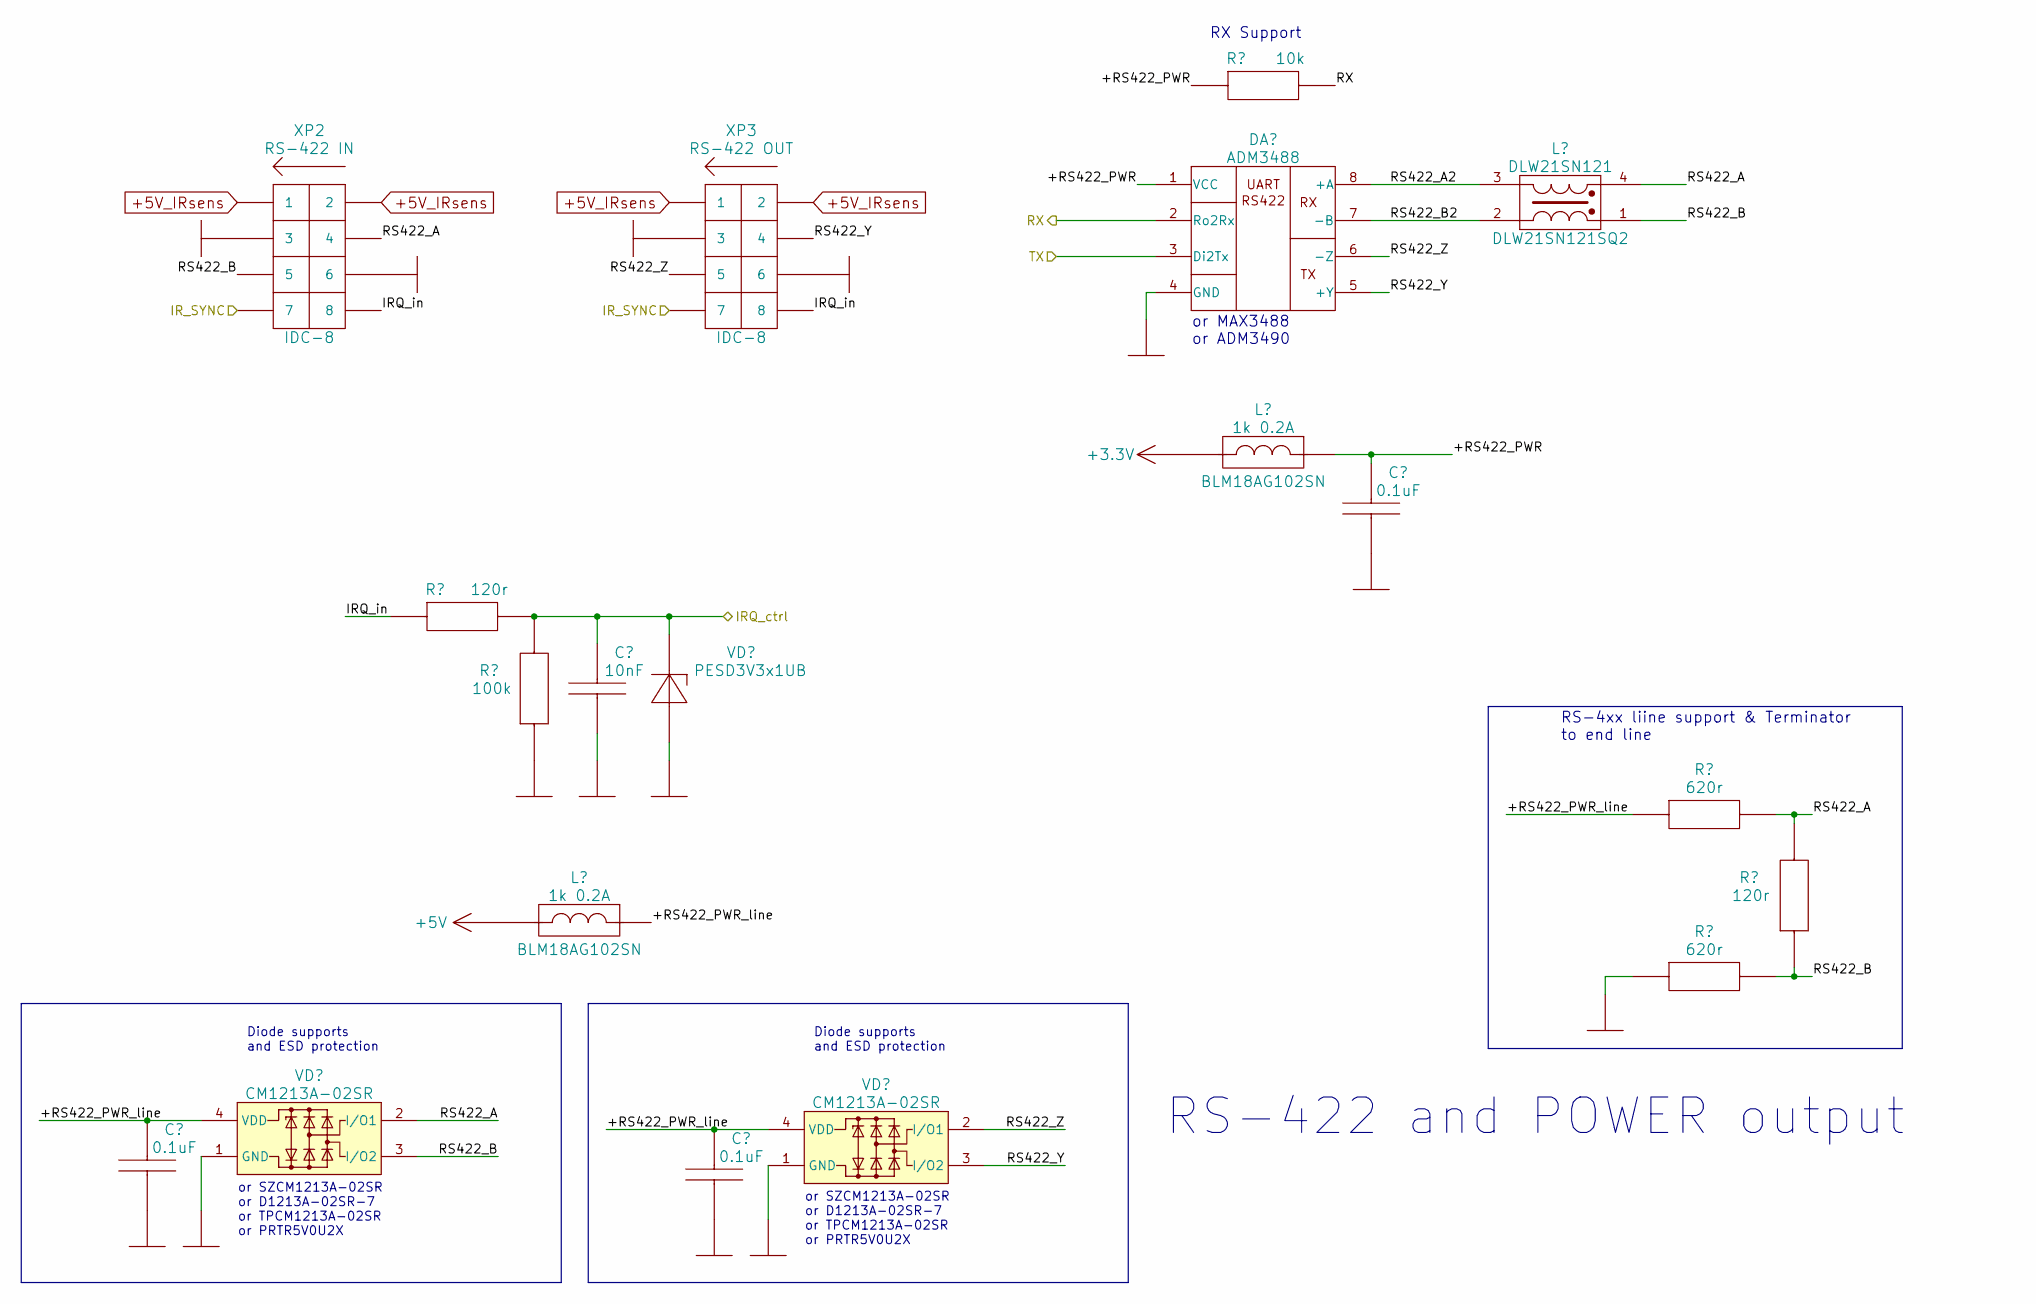
[picture p139: schematic res_RS-422_sensors.kicad_sch]

Parts:
C41, C43, C44: 0.1uF; CAP0603
C42: 10nF; CAP0603
DA4: ADM3488; SOP8
L8: DLW21SN121; Choke_0805
L9, L10: 1k 0.2A; Bead_0603
R22: 10k; RES0603
R23, R26: 120r; RES0603
R24: 100k; RES0603
R25, R27: 620r; RES0603
VD8: PESD3V3x1UB; SOD523
VD9, VD10: CM1213A−02SR; SOT143
XP2, XP3: IDC-8

Connections:
+3.3V: L9.1
+5V: L10.1
+5V_IRsens: XP2.1, XP2.2, XP3.1, XP3.2
+RS422_PWR: C41.1, DA4.1 (VCC), L9.2, R22.1
+RS422_PWR_line: C43.1, C44.1, L10.2, R25.1, VD9.4 (VDD), VD10.4 (VDD)
GND: C41.2, C42.2, C43.2, C44.2, DA4.4 (GND), R24.1, R27.1, VD8.A, VD9.1 (GND), VD10.1 (GND), XP2.3, XP2.6, XP3.3, XP3.6
IRQ_ctrl: C42.1, R23.2, R24.2, VD8.C
IRQ_in: R23.1, XP2.8, XP3.8
IR_SYNC: XP2.7, XP3.7
RS422_A: L8.4, R25.2, R26.2, VD9.2 (I/O1), XP2.4
RS422_A2: DA4.8 (+A), L8.3
RS422_B: L8.1, R26.1, R27.2, VD9.3 (I/O2), XP2.5
RS422_B2: DA4.7 (-B), L8.2
RS422_Y: DA4.5 (+Y), VD10.3 (I/O2), XP3.4
RS422_Z: DA4.6 (-Z), VD10.2 (I/O1), XP3.5
RX: DA4.2 (Ro2Rx), R22.2
TX: DA4.3 (Di2Tx)

Notes on the sheet:
Diode supports and ESD protection
or MAX3488 or ADM3490
or SZCM1213A−02SR or D1213A-02SR-7 or TPCM1213A-02SR or PRTR5V0U2X
RS-422 and POWER output
RS-4xx liine support & Terminator to end line
RX Support
