ElessarCuthalion/KiCAD_library/!Template/sch/res_RS-485_external.kicad_sch

## KiCad design !Template/sch/res_RS-485_external.kicad_sch (2025-10-13)

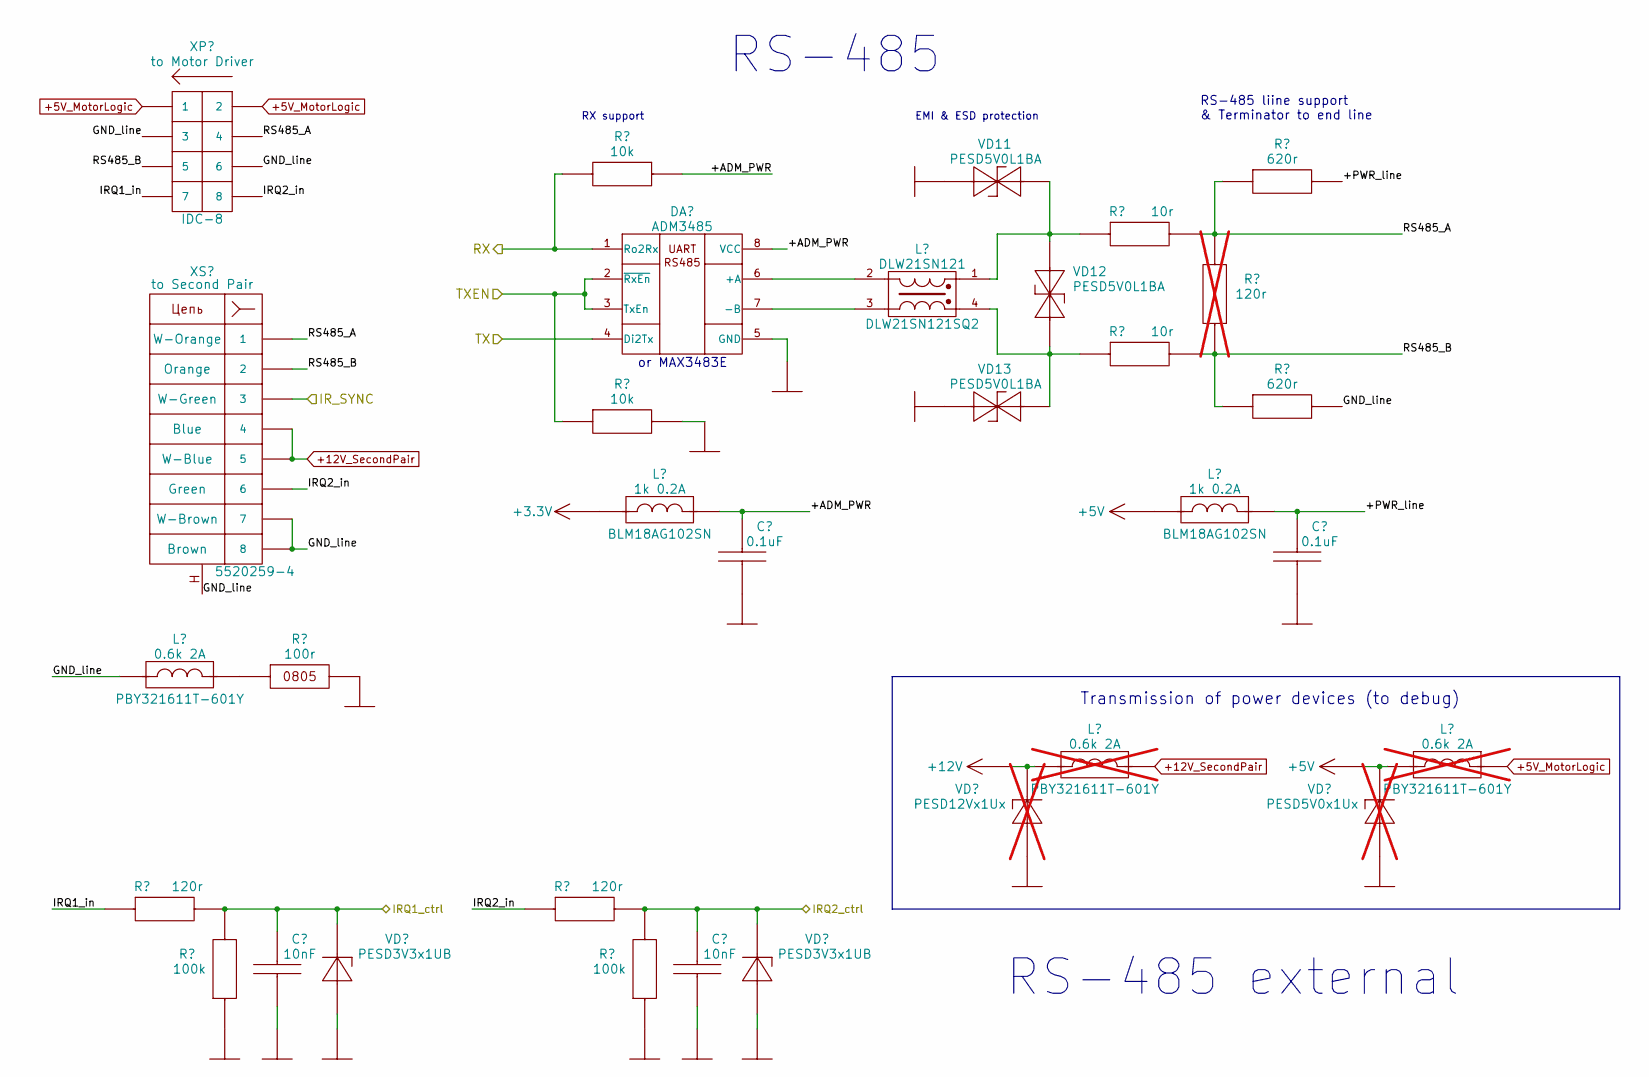
[picture p140: schematic res_RS-485_external.kicad_sch]

Parts:
C45, C46: 0.1uF; CAP0603
C47, C48: 10nF; CAP0603
DA5: ADM3485; SOP8
L11: DLW21SN121; Choke_0805
L12, L13: 1k 0.2A; Bead_0603
L14: 0.6k 2A; Bead_1206
L15, L16: 0.6k 2A; Bead_1206; not fitted
R28, R34: 10k; RES0603
R29, R33: 620r; RES0603
R30, R32: 10r; RES0603
R31: 120r; RES0603; not fitted
R35: 100r; RES0805
R36, R37: 120r; RES0603
R38, R39: 100k; RES0603
VD11, VD12, VD13: PESD5V0L1BA; SOD323
VD14: PESD12Vx1Ux; SOD523; not fitted
VD15: PESD5V0x1Ux; SOD523; not fitted
VD16, VD17: PESD3V3x1UB; SOD523
XP4: IDC-8
XS3: 5520259-4; TJ-8P8C_vert_5520259-х

Connections:
+3.3V: L12.1
+5V: L13.1, L16.1, VD15.C
+5V_MotorLogic: L16.2, XP4.1, XP4.2
+12V: L15.1, VD14.C
+12V_SecondPair: L15.2, XS3.4, XS3.5
+ADM_PWR: C45.1, DA5.8 (VCC), L12.2, R28.1
+PWR_line: C46.1, L13.2, R29.2
GND: C45.2, C46.2, C47.2, C48.2, DA5.5 (GND), R34.2, R35.2, R38.1, R39.1, VD11.C, VD13.C, VD14.A, VD15.A, VD16.A, VD17.A
GND_line: L14.1, R33.2, XP4.3, XP4.6, XS3.7, XS3.8, XS3.H
IRQ1_ctrl: C47.1, R36.2, R38.2, VD16.C
IRQ1_in: R36.1, XP4.7
IRQ2_ctrl: C48.1, R37.2, R39.2, VD17.C
IRQ2_in: R37.1, XP4.8, XS3.6
IR_SYNC: XS3.3
unnamed: DA5.6 (+A), L11.2
unnamed: DA5.7 (-B), L11.3
unnamed: L11.1, R30.1, VD11.A, VD12.C
unnamed: L11.4, R32.1, VD12.A, VD13.A
unnamed: L14.2, R35.1
RS485_A: R29.1, R30.2, R31.2, XP4.4, XS3.1
RS485_B: R31.1, R32.2, R33.1, XP4.5, XS3.2
RX: DA5.1 (Ro2Rx), R28.2
TX: DA5.4 (Di2Tx)
TXEN: DA5.2 (~RxEn), DA5.3 (TxEn), R34.1

Notes on the sheet:
or MAX3483E
RS-485 liine support & Terminator to end line
Transmission of power devices (to debug)
RS-485
RS-485 external
EMI & ESD protection
RX support
