ElessarCuthalion/KiCAD_library/!Template/sch/res_RS-485_internal.kicad_sch

## KiCad design !Template/sch/res_RS-485_internal.kicad_sch (2025-10-13)

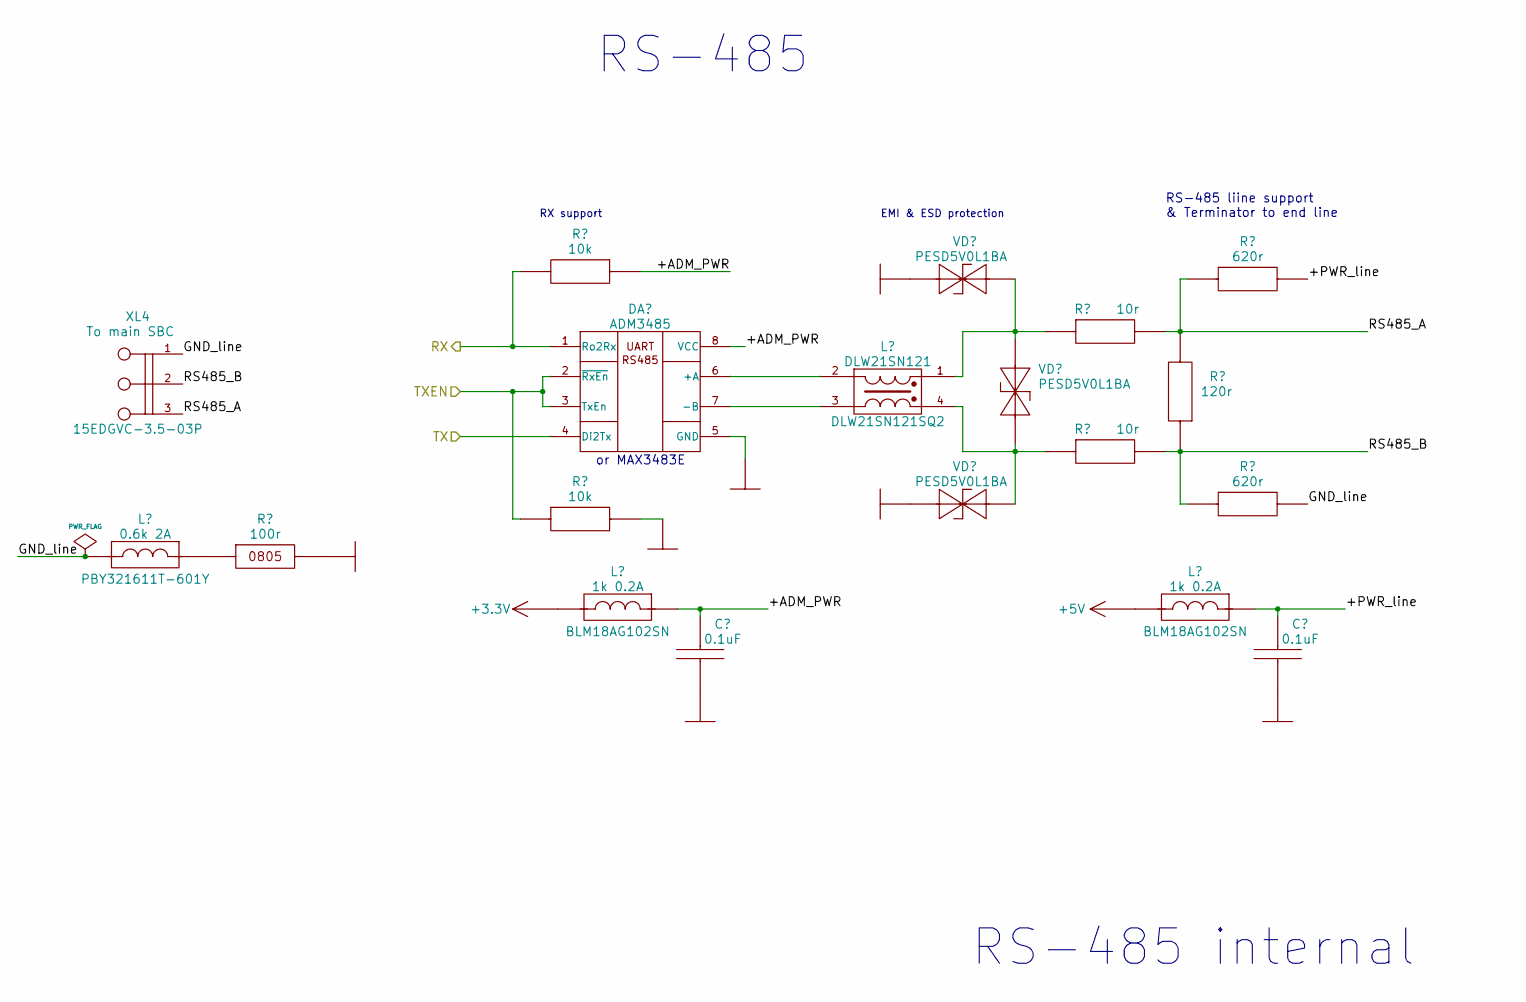
[picture p141: schematic res_RS-485_internal.kicad_sch]

Parts:
C49, C50: 0.1uF; CAP0603
DA6: ADM3485; SOP8
L14: 0.6k 2A; Bead_1206
L17: DLW21SN121; Choke_0805
L19, L20: 1k 0.2A; Bead_0603
R40, R46: 10k; RES0603
R41, R45: 620r; RES0603
R42, R44: 10r; RES0603
R43: 120r; RES0603
R47: 100r; RES0805
VD18, VD19, VD20: PESD5V0L1BA; SOD323
XL4: 15EDGVC-3.5-03P; Cleamm-3_3.5mm_15EDGVC-3.5s

Connections:
+3.3V: L19.1
+5V: L20.1
+ADM_PWR: C49.1, DA6.8 (VCC), L19.2, R40.1
+PWR_line: C50.1, L20.2, R41.2
GND: C49.2, C50.2, DA6.5 (GND), R46.2, R47.2, VD18.C, VD20.C
GND_line: L14.1, R45.2, XL4.1
unnamed: DA6.6 (+A), L17.2
unnamed: DA6.7 (-B), L17.3
unnamed: L14.2, R47.1
unnamed: L17.1, R42.1, VD18.A, VD19.C
unnamed: L17.4, R44.1, VD19.A, VD20.A
RS485_A: R41.1, R42.2, R43.2, XL4.3
RS485_B: R43.1, R44.2, R45.1, XL4.2
RX: DA6.1 (Ro2Rx), R40.2
TX: DA6.4 (Di2Tx)
TXEN: DA6.2 (~RxEn), DA6.3 (TxEn), R46.1

Notes on the sheet:
RS-485
RS-485 liine support & Terminator to end line
RX support
RS-485 internal
or MAX3483E
EMI & ESD protection
