ElessarCuthalion/KiCAD_library/!Template/sch/res_Radio CC1101.kicad_sch

## KiCad design !Template/sch/res_Radio CC1101.kicad_sch (2025-10-13)

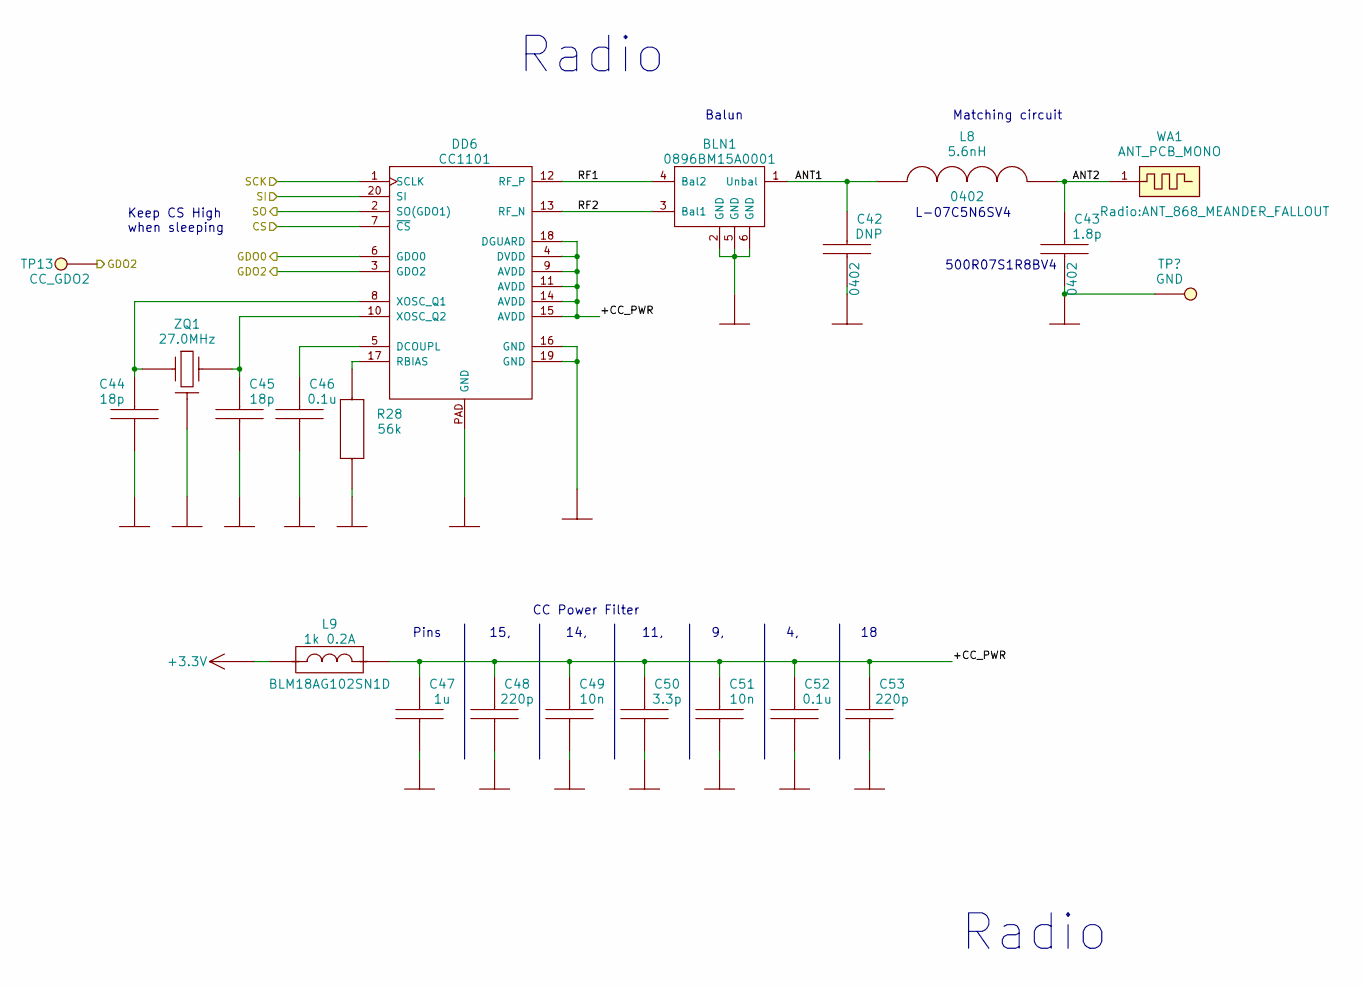
[picture p142: schematic res_Radio CC1101.kicad_sch]

Parts:
BLN1: 0896BM15A0001; Balun_Johanson868
C42: DNP; CAP0402
C43: 1.8p; CAP0402
C44, C45: 18p; CAP0603
C46, C52: 0.1u; CAP0603
C47: 1u; CAP0603
C48, C53: 220p; CAP0603
C49, C51: 10n; CAP0603
C50: 3.3p; CAP0603
DD6: CC1101; HQFN20
L8: 5.6nH; IND0402
L9: 1k 0.2A; Bead_0603
R28: 56k; RES0603
TP13: CC_GDO2; TestPoint_1mm
TP14: GND; TestPoint_1.5mm
WA1: ANT_PCB_MONO; ANT_868_MEANDER_FALLOUT
ZQ1: 27.0MHz; Crystal_3225

Connections:
+3.3V: L9.1
+CC_PWR: C47.1, C48.1, C49.1, C50.1, C51.1, C52.1, C53.1, DD6.4 (DVDD), DD6.9 (AVDD), DD6.11 (AVDD), DD6.14 (AVDD), DD6.15 (AVDD), DD6.18 (DGUARD), L9.2
ANT1: BLN1.1 (Unbal), C42.1, L8.1
ANT2: C43.1, L8.2, WA1.1
CS: DD6.7 (~CS)
GDO0: DD6.6 (GDO0)
GDO2: DD6.3 (GDO2), TP13.1
GND: BLN1.2 (GND), BLN1.5 (GND), BLN1.6 (GND), C42.2, C43.2, C44.2, C45.2, C46.2, C47.2, C48.2, C49.2, C50.2, C51.2, C52.2, C53.2, DD6.16 (GND), DD6.19 (GND), DD6.PAD (GND), R28.2, TP14.1, ZQ1.H
unnamed: C44.1, DD6.8 (XOSC_Q1), ZQ1.1
unnamed: C45.1, DD6.10 (XOSC_Q2), ZQ1.2
unnamed: C46.1, DD6.5 (DCOUPL)
unnamed: DD6.17 (RBIAS), R28.1
RF1: BLN1.4 (Bal2), DD6.12 (RF_P)
RF2: BLN1.3 (Bal1), DD6.13 (RF_N)
SCK: DD6.1 (SCLK)
SI: DD6.20 (SI)
SO: DD6.2 (SO(GDO1))

Notes on the sheet:
Radio
Matching circuit
Pins 15, 14, 11, 9, 4, 18
CC Power Filter
500R07S1R8BV4
Balun
L-07C5N6SV4
Keep CS High when sleeping
