ElessarCuthalion/KiCAD_library/!Template/sch/res_USB-C CH224K.kicad_sch

## KiCad design !Template/sch/res_USB-C CH224K.kicad_sch (2025-10-13)

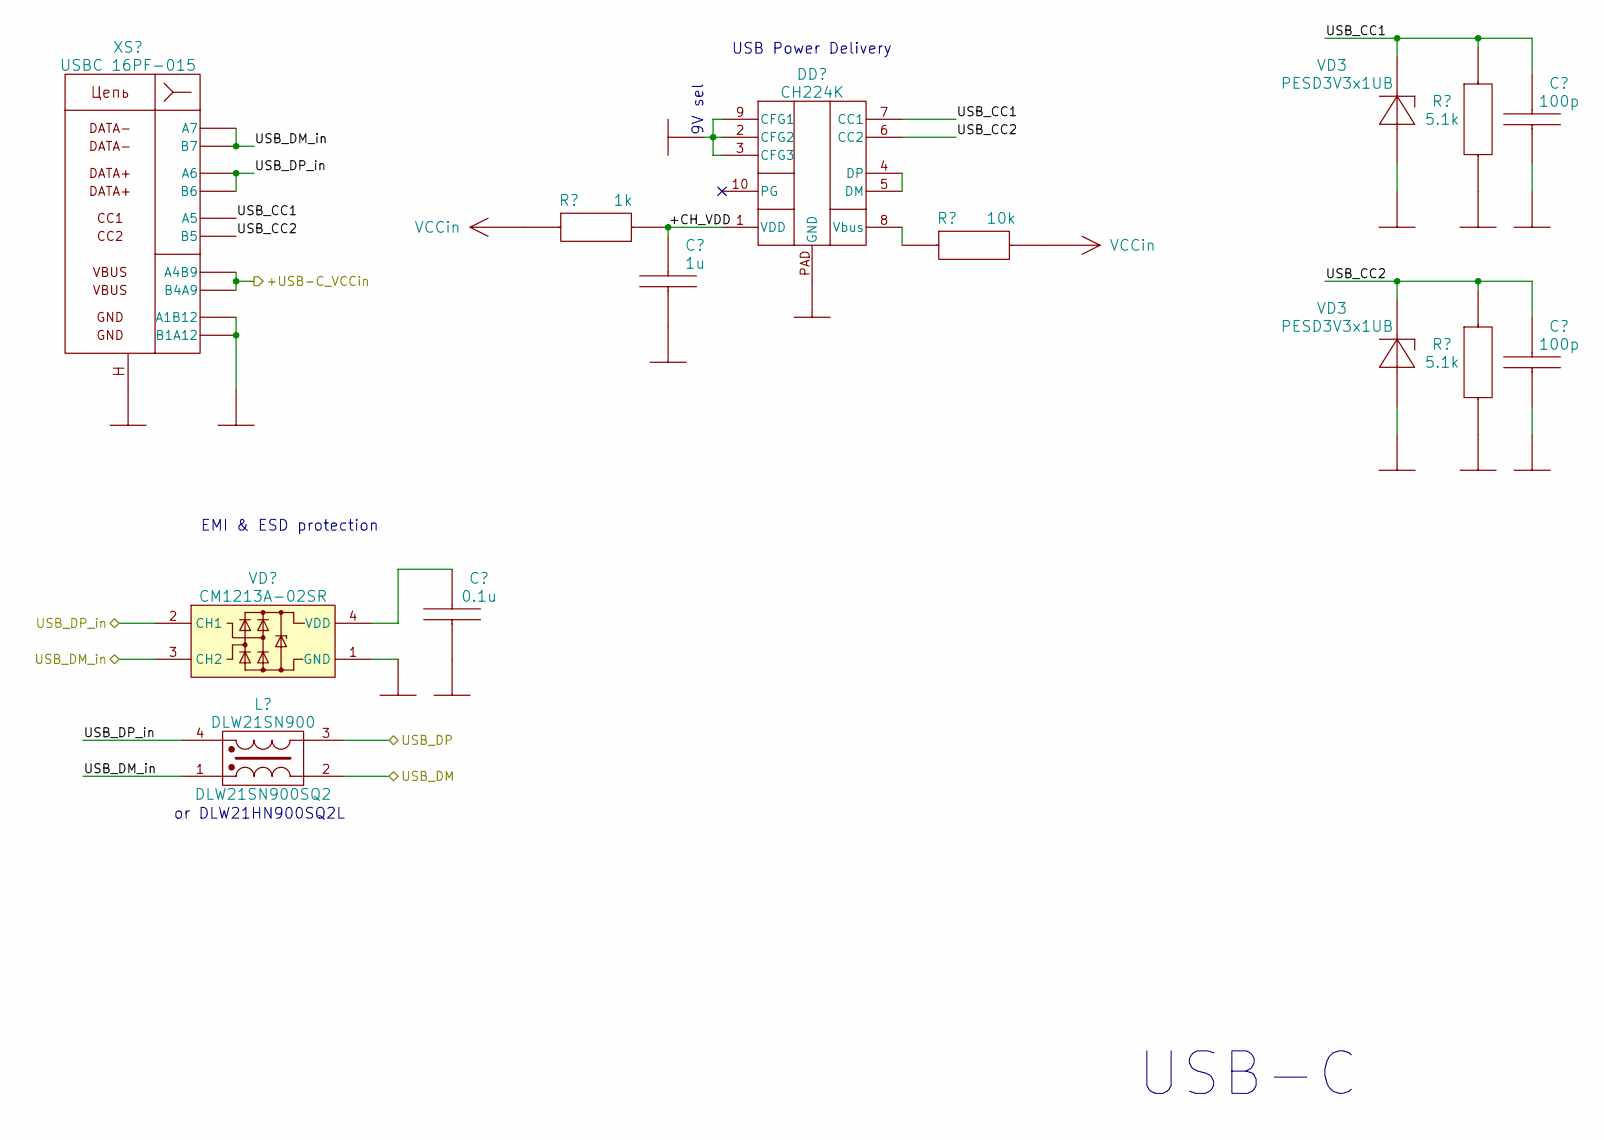
[picture p143: schematic res_USB-C CH224K.kicad_sch]

Parts:
C54, C55: 100p; CAP0603
C56: 1u; CAP0603
C59: 0.1u; CAP0603
DD7: CH224K; H2ESOP10
L13: DLW21SN900; Choke_0805
R29, R30: 5.1k; RES0603
R31: 1k; RES0603
R32: 10k; RES0603
VD3: PESD3V3x1UB; SOD523
VD10: CM1213A−02SR; SOT143
XS2: USBC 16PF-015; USB-C_16pin_16PF-015

Connections:
+CH_VDD: C56.1, DD7.1 (VDD), R31.2
+USB-C_VCCin: XS2.A4B9, XS2.B4A9
GND: C54.2, C55.2, C56.2, C59.2, DD7.2 (CFG2), DD7.3 (CFG3), DD7.9 (CFG1), DD7.PAD (GND), R29.2, R30.2, VD3.A, VD10.1 (GND), XS2.A1B12, XS2.B1A12, XS2.SHLD
unnamed: C59.1, VD10.4 (VDD)
unnamed: DD7.4 (DP), DD7.5 (DM)
unnamed: DD7.8 (Vbus), R32.1
USB_CC1: C54.1, DD7.7 (CC1), R29.1, VD3.C, XS2.A5
USB_CC2: C55.1, DD7.6 (CC2), R30.1, VD3.C, XS2.B5
USB_DM: L13.2
USB_DM_in: L13.1, VD10.3 (CH2), XS2.A7, XS2.B7
USB_DP: L13.3
USB_DP_in: L13.4, VD10.2 (CH1), XS2.A6, XS2.B6
VCCin: R31.1, R32.2

Notes on the sheet:
EMI & ESD protection
or DLW21HN900SQ2L
9V sel
USB-C
USB Power Delivery
