ElessarCuthalion/KiCAD_library/!Template/sch/res_USB-UART FT232R.kicad_sch

## KiCad design !Template/sch/res_USB-UART FT232R.kicad_sch (2025-10-13)

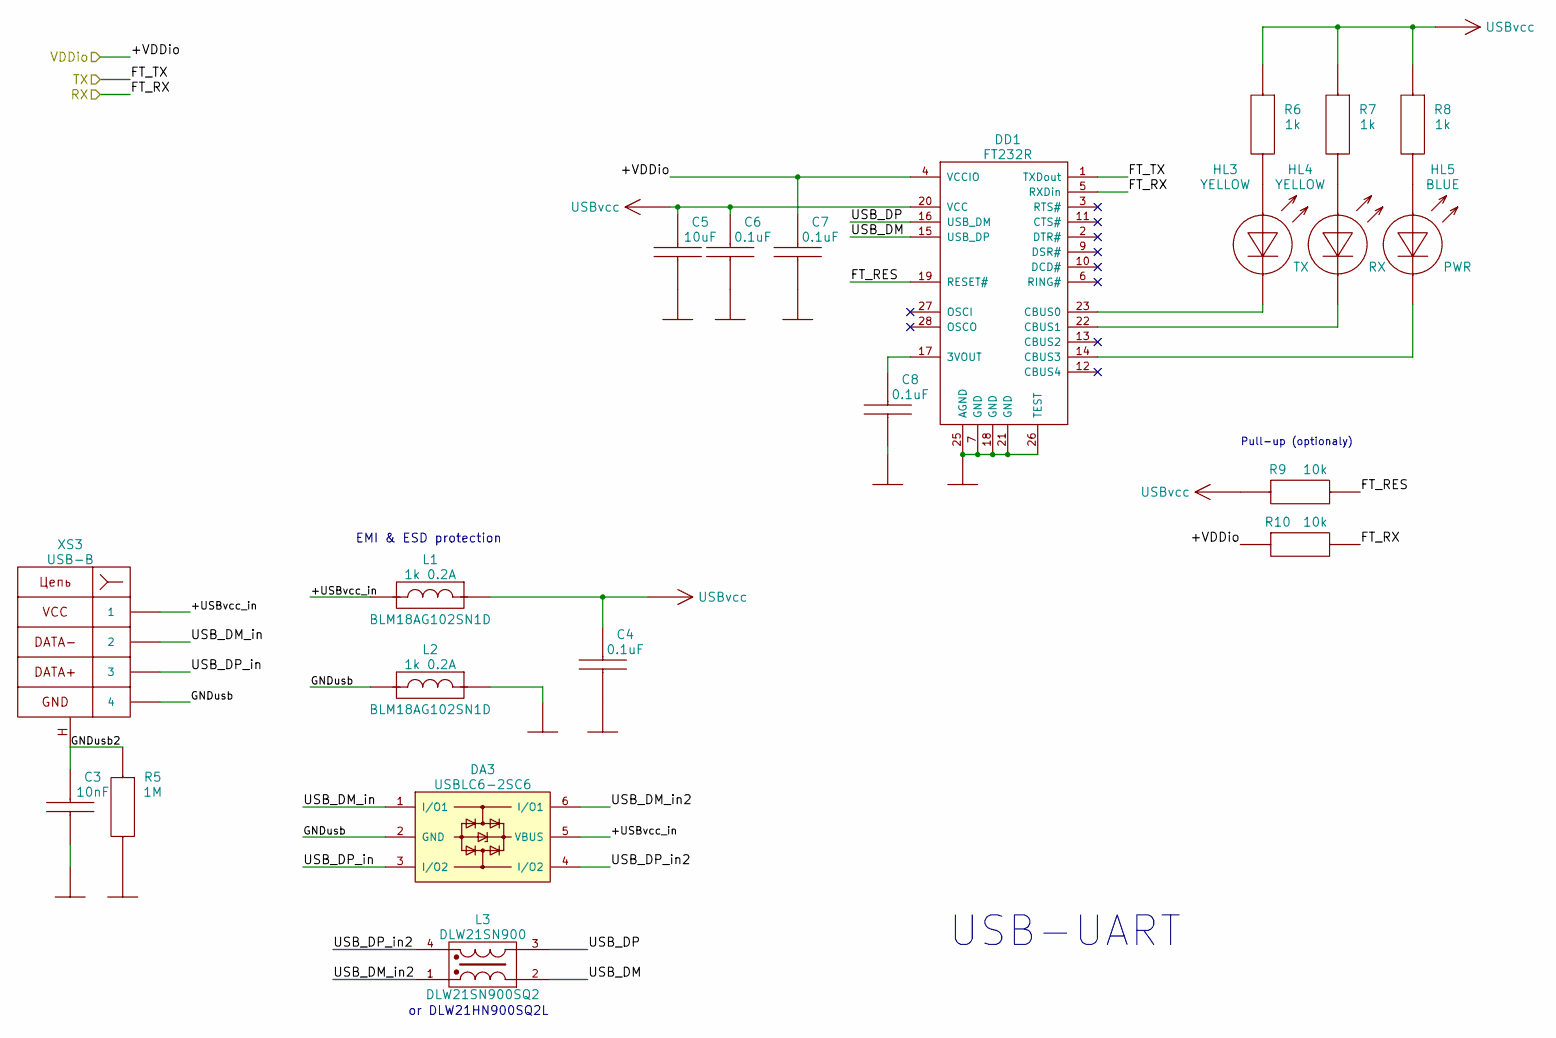
[picture p144: schematic res_USB-UART FT232R.kicad_sch]

Parts:
C3: 10nF; CAP0603
C4, C6, C7, C8: 0.1uF; CAP0603
C5: 10uF; CAP0603
DA3: USBLC6-2SC6; SOT23-6
DD1: FT232R; SSOP28
HL3, HL4: YELLOW; LED0805
HL5: BLUE; LED0805
L1, L2: 1k 0.2A; Bead_0603
L3: DLW21SN900; Choke_DLW21SN
R5: 1M; RES0603
R6, R7, R8: 1k; RES0603
R9, R10: 10k; RES0603
XS3: USB-B

Connections:
+USBvcc_in: DA3.5 (VBUS), L1.1, XS3.1
+VDDio: C7.1, DD1.4 (VCCIO), R10.1
FT_RES: DD1.19 (RESET#), R9.2
FT_RX: DD1.5 (RXDin), R10.2
FT_TX: DD1.1 (TXDout)
GND: C3.2, C4.2, C5.2, C6.2, C7.2, C8.2, DD1.7 (GND), DD1.18 (GND), DD1.21 (GND), DD1.25 (AGND), DD1.26 (TEST), L2.2
GNDusb: DA3.2 (GND), L2.1, XS3.4
GNDusb2: C3.1, XS3.SHLD
unnamed: C8.1, DD1.17 (3VOUT)
unnamed: DD1.14 (CBUS3), HL5.C
unnamed: DD1.22 (CBUS1), HL4.C
unnamed: DD1.23 (CBUS0), HL3.C
USB_DM: DD1.15 (USB_DP), L3.2
USB_DM_in: DA3.1 (I/O1), XS3.2
USB_DM_in2: DA3.6 (I/O1), L3.1
USB_DP: DD1.16 (USB_DM), L3.3
USB_DP_in: DA3.3 (I/O2), XS3.3
USB_DP_in2: DA3.4 (I/O2), L3.4
USBvcc: C4.1, C5.1, C6.1, DD1.20 (VCC), L1.2, R9.1

Notes on the sheet:
USB-UART
or DLW21HN900SQ2L
EMI & ESD protection
Pull-up (optionaly)
