ElessarCuthalion/KiCAD_library/!Template/sch/res_Wiegand.kicad_sch

## KiCad design !Template/sch/res_Wiegand.kicad_sch (2025-10-13)

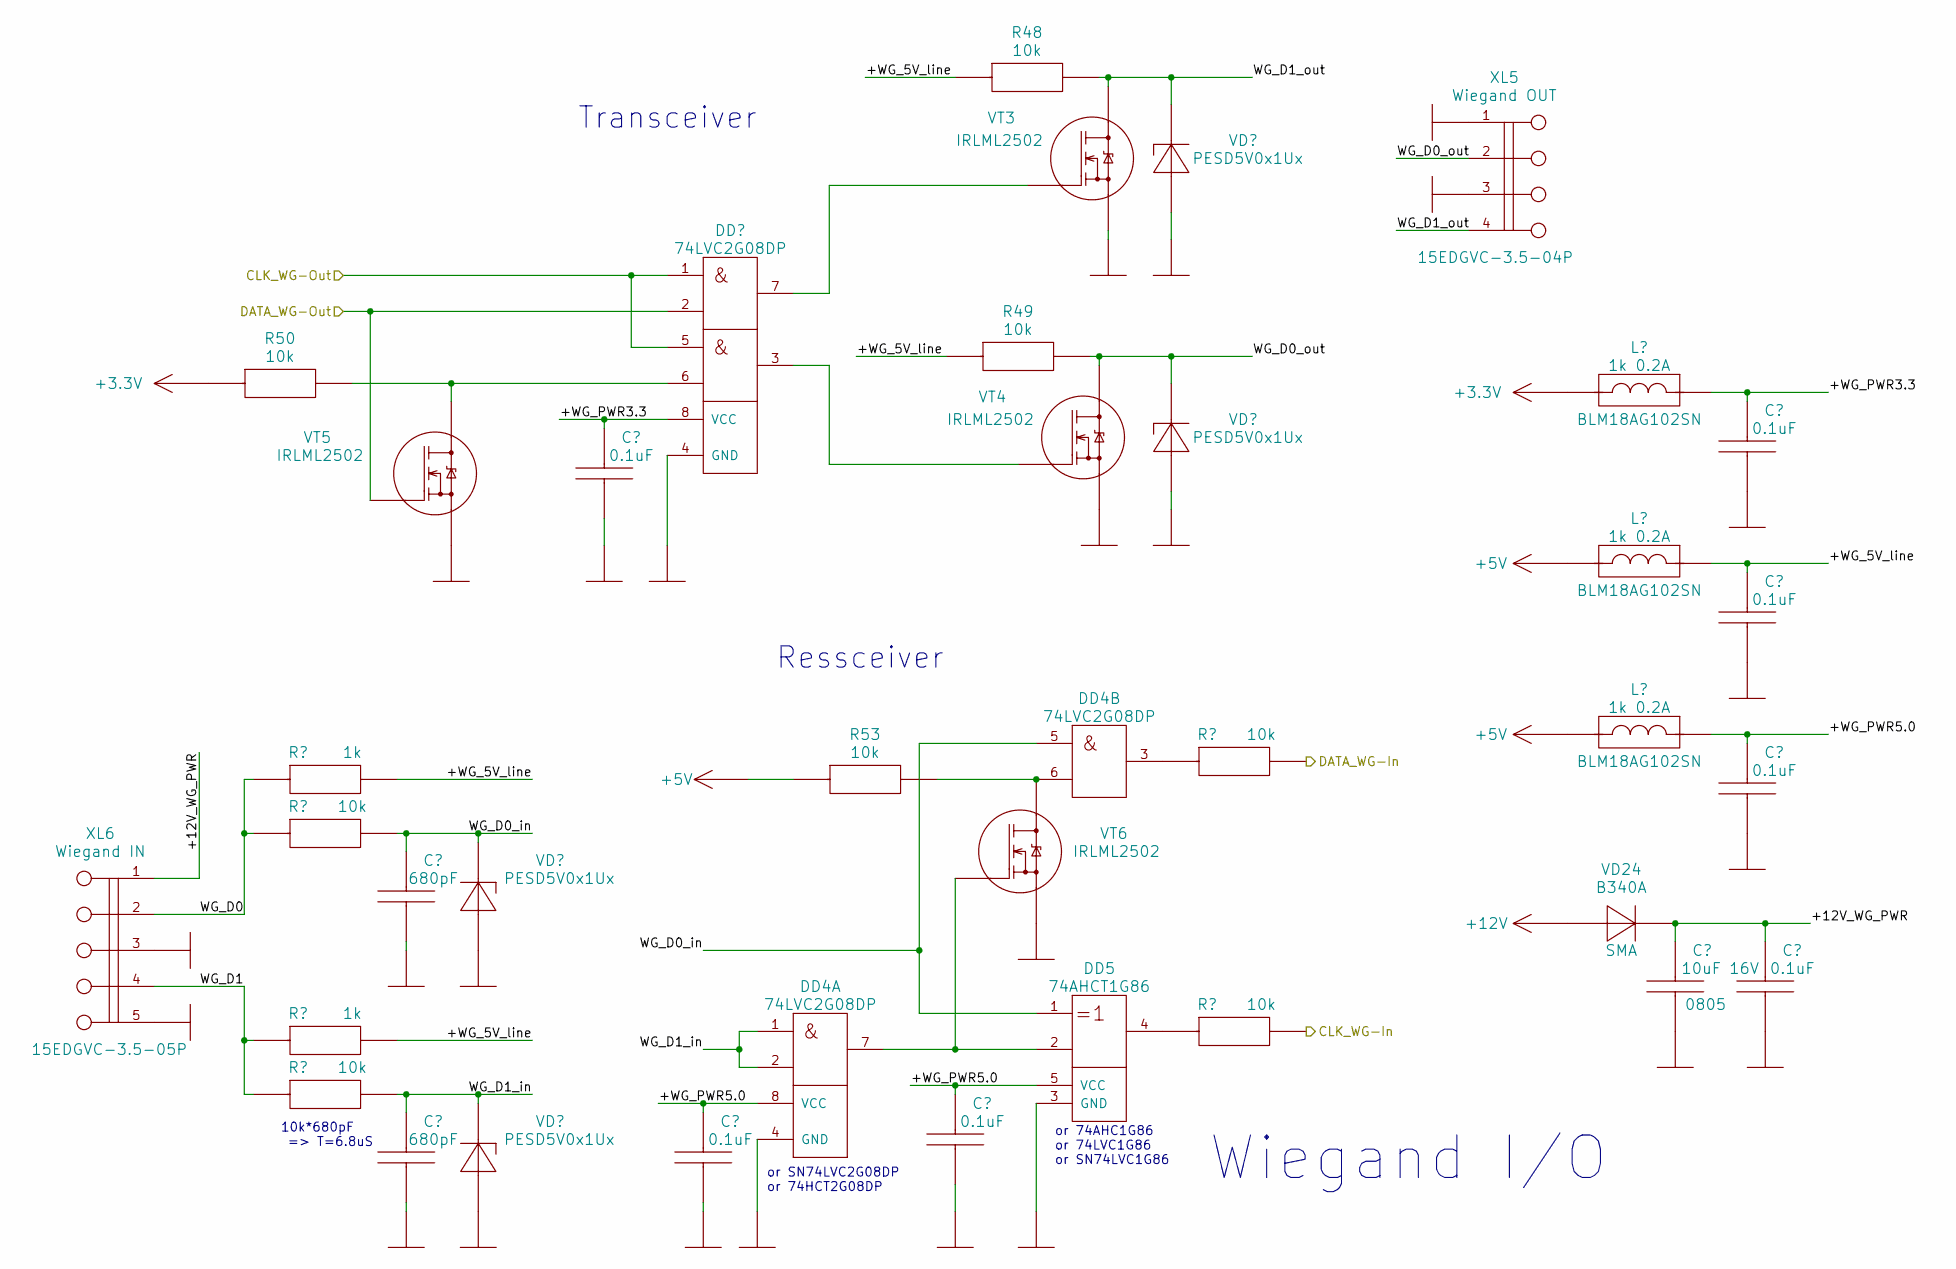
[picture p145: schematic res_Wiegand.kicad_sch]

Parts:
C51, C52, C53, C54, C57, C58, C60: 0.1uF; CAP0603
C55, C59: 680pF; CAP0603
C56: 10uF 16V; CAP0805
DD3, DD4: 74LVC2G08DP; MSOP8
DD5: 74AHCT1G86; SOT23-5
L21, L22, L23: 1k 0.2A; Bead_0603
R48, R49, R50, R51, R53, R54, R55, R57: 10k; RES0603
R52, R56: 1k; RES0603
VD21, VD22, VD23, VD25: PESD5V0x1Ux; SOD323+523
VD24: B340A; SMA_DO214AC
VT3, VT4, VT5, VT6: IRLML2502; SOT23-3
XL5: 15EDGVC-3.5-04P; Cleamm-4_3.5mm_15EDGVC-3.5s_mirr
XL6: 15EDGVC-3.5-05P; Cleamm-5_3.5mm_15EDGVC-3.5s_mirr

Connections:
+3.3V: L21.1, R50.1
+5V: L22.1, L23.1, R53.1
+12V: VD24.A
+12V_WG_PWR: C56.1, C57.1, VD24.C, XL6.1
+WG_5V_line: C53.1, L22.2, R48.1, R49.1, R52.2, R56.2
+WG_PWR3.3: C51.1, C52.1, DD3.8 (VCC), L21.2
+WG_PWR5.0: C54.1, C58.1, C60.1, DD4.8 (VCC), DD5.5 (VCC), L23.2
CLK_WG-In: R55.2
CLK_WG-Out: DD3.1, DD3.5
DATA_WG-In: R51.2
DATA_WG-Out: DD3.2, VT5.1 (G)
GND: C51.2, C52.2, C53.2, C54.2, C55.2, C56.2, C57.2, C58.2, C59.2, C60.2, DD3.4 (GND), DD4.4 (GND), DD5.3 (GND), VD21.A, VD22.A, VD23.A, VD25.A, VT3.2 (S), VT4.2 (S), VT5.2 (S), VT6.2 (S), XL5.1, XL5.3, XL6.3, XL6.5
unnamed: DD3.3, VT4.1 (G)
unnamed: DD3.6, R50.2, VT5.3 (D)
unnamed: DD3.7, VT3.1 (G)
unnamed: DD4.3, R51.1
unnamed: DD4.6, R53.2, VT6.3 (D)
unnamed: DD4.7, DD5.2, VT6.1 (G)
unnamed: DD5.4, R55.1
WG_D0: R52.1, R54.1, XL6.2
WG_D0_in: C55.1, DD4.5, DD5.1, R54.2, VD23.C
WG_D0_out: R49.2, VD22.C, VT4.3 (D), XL5.2
WG_D1: R56.1, R57.1, XL6.4
WG_D1_in: C59.1, DD4.1, DD4.2, R57.2, VD25.C
WG_D1_out: R48.2, VD21.C, VT3.3 (D), XL5.4

Notes on the sheet:
or SN74LVC2G08DP or 74HCT2G08DP
Wiegand I/O
or 74AHC1G86 or 74LVC1G86 or SN74LVC1G86
Transceiver
Ressceiver
10k*680pF => T=6.8uS
