ElessarCuthalion/KiCAD_library/!Template/El_lib/kl_crc.h

/*
 * crc_ccitt.h
 *
 *  Created on: May 5, 2020
 *      Author: layst
 */

#pragma once

#include <inttypes.h>

#define CRC_CCITT16

#define CRC_INITVALUE   0x0000U
#define CRC_POLY        0x1021U

namespace Crc {

uint16_t CalculateCRC16(uint8_t *Buf, uint32_t Len, const uint32_t Init = CRC_INITVALUE);
uint16_t CalculateCRC16HW(uint8_t *Buf, uint32_t Len, const uint32_t Init = CRC_INITVALUE);

void StartHW();
void AppendHW(uint8_t b);
uint16_t GetHW();

void InitHWDMA();
uint16_t CalculateCRC16HWDMA(uint8_t *Buf, uint32_t Len, const uint32_t Init = CRC_INITVALUE);

void CCITT16_PrintTable();

}
