ElessarCuthalion/KiCAD_library/(commit log)

2017-03-10 + LED display; + Relay
2017-03-13 +DFN6 +Relay +SOP24
2017-03-15 корректировка библиотек
2017-03-29 Корректировка
2017-05-16 добавлены поля для комментариев
2017-06-06 + комментарии к ACC, GIRO, MAGN; + IRM-03-5; + Amadon LOGO
2017-06-13 Обновление и исправление библиотек (фильтры посадочных мест, фильтры поиска, описания)
2017-06-15 Правка QFN/LGA, правка разъёмов
2017-06-19 + LED дисплей 9,2мм
2017-06-25 + Метки на плату (Name, Label)
2017-06-26 правка VS2812; + SK6812
2017-07-08 Убрал FSilkS со сквозных отверстий
2017-07-10 корректировка обозначений реле
2017-07-17 Правка посадочных мест LED3030 и WS2812
2017-07-24 + библиотека посадочных мест power
2017-09-01 + Relay 2C
2017-09-22 Правка атрибутов
2017-09-30 + разрядник 3-х электродный
2017-09-30 + диодный мост + лавинный диод
2017-10-01 + библиотека Protection
2017-10-01 изменено обозначение магнитного воздействия
2017-10-01 + обозначение варистора
2017-10-01 правка обозначений резисторов
2017-10-07 правка центровки обозначений
2017-10-09 Ширина контактной полащадки -> 0,3мм
2017-10-09 + CAP0508 (Capacitor 0402 Array x4)
2017-10-12 +CAP0612; графика back_логотипов перенесена на обратную сторону; +M74VHC1; правка свойств разъёмов.
2017-10-21 Правка локальных установок для термозагрузки
2017-10-21 продолжение...
2017-10-28 Исправлена графика для обратной стороны
2017-11-09 Правка контура разъёмов (частично удалено начертание на обратной стороне)
2017-11-09 Разъёмы: добавлен текст на нижний слой
2017-11-09 Разъёмы: правка. Знавение Val** -> VAL**
2017-11-09 Изменено значение Val** на VAL** Правка позиционирования полей
2017-11-12 Клеммники: убрал контур на обратном слое
2017-11-13 Правка PAD: +заливка, +открыты маской с низу.
2017-11-17 Центровка разъёмов
2017-11-17 + LED DIP
2017-11-23 fuse: свойство площадок - термозагрузка
2017-12-14 +PIR-датчик
2017-12-14 + KLS5-CR1220-02 (держатель 1220)
2017-12-15 Правка логотипов обратного слоя
2017-12-17 + Template_PCBs
    [151_bottom.kicad_pcb, 151_top.kicad_pcb, D2MG_bottom.kicad_pcb, D2MG_center.kicad_pcb, D3MG_bottom.kicad_pcb]
2017-12-29 + "SolderPoints" & "SolderPoints_DIP"
2017-12-31 + "SolderPoints" & "SolderPoints_DIP"
2017-12-31 "SolderPoints" & "SolderPoints_DIP"
2017-12-31 Исправлена Connectors.lib
2018-01-25 + MP2637; + FCQFN24; развернул остальные QFN ключём влево вверх
2018-01-26 + Spruce_60x70 Template_PCB
    [D2MG_bottom.kicad_pcb, D2MG_center.kicad_pcb, D3MG_bottom.kicad_pcb, Spruce_60x70.kicad_pcb]
2018-02-23 + CAP ECAS + шпблон D3MG_top
    [D3MG_top.kicad_pcb]
2018-02-26 Блоки питания: подпись назначения выводов на нижний слой
2018-03-09 + перемычка (для соединения "земель")
2018-03-20 Правка SOP-24: дорожка 0,2/0,2 теперь проходит между контактными площадками
2018-03-21 + "ртутный выключатель"
2018-04-11 Обозначил SAI1 для подключения CS42L52 в L476 x100
2018-05-18 HR911105A: +дополнительное обозначение (зеркально)
2018-05-26 + обозначение компонентов "виртуальными"
2018-05-27 + conn5f & bridge 4mm
2018-11-12 + WS2818 & RGB led CA
2018-11-15 разблокирована свободная ориентация текстовых меток
2019-01-16 +локальное заземление
2019-01-23 + STM32L476ZxTx
2019-01-24 + 2.5V
2019-04-17 переход на "неметаличесские отверстия"
2019-04-17 USB-micro B - несеталичесские отверстия
2019-04-17 + micro-USB с отверстиями
2019-04-18 неметал.отверстия
2019-05-23 STM32L476ZxTx fix
2019-06-17 завиксипрвано положение текста "значение"
2019-07-12 разъём не дорисован
2019-07-15 + микрофон EM0627
2019-07-17 перенос обозначения в центр
2019-08-27 + переменный резистор
2019-09-17 + Энкодер
2019-09-19 изменены свойства заливки онтактных площадок
2019-09-19 уменьшен поясой контактной площадки
2019-09-23 Правка свойств заливки контактных площадок DIP-элементов
2019-11-18 + 3D Library from Kreyl
    [1054500101.stp, 1P2T_8d6x3d6.SLDPRT, 1P2T_8d6x3d6.STEP, 1P2T_8d7x4d7.SLDPRT, 1P2T_8d7x4d7.STEP, 1P3T.SLDPRT, 2ZHDRC-03P.SLDPRT, 2way_5mm_R.stp]
2019-11-19 сортировка 3D--моделей
    [1P2T_8d6x3d6.STEP, 1P2T_8d7x4d7.STEP, Assem 18650_holder_pcb.SLDASM, BatHolder 3xAA Asm.SLDASM, BatHolder 3xAA.STEP, Battery 18650.SLDPRT, Battery 18650_hr.SLDPRT, Battery 30x20x5.SLDPRT]
2019-11-20 присвоение 3Dмоделей, сортировка...
    [BNC_73100-0131.STEP, Button 6x6x5 DIP.SLDPRT, Button 6x6x5 DIP.STEP, CAP0201.step, CAP0402.step, CAP0603.step, CAP0805.step, CAP1206.step]
2019-11-21 присвоение 3D- моделей, сортировка...
    [1P2T_8d6x3d6.SLDPRT, 1P2T_8d7x4d7.SLDPRT, 1P3T.SLDPRT, 2ZHDRC-03P.SLDPRT, Audio_PJ320A (DIP).STEP, BLS2-7R.SLDPRT, Btn_PBS-33.SLDPRT, Button 12x12x7_3.SLDPRT]
2019-11-28 выделены посадочные места для EMI L-фильтров
2019-12-04 + Opto
    [ITR9606.STEP, ITR9606.sldprt, ITR9608.STEP, ITR9608.sldprt]
2019-12-09 сортировка...
    [8412NGMI_ebm-papst.sldasm, BREADBOARD_MINI.stp, BatteryHolder 1x18650.STEP, BatteryHolder 1xAA.STEP, BatteryHolder 2xAAA.STEP, BatteryHolder 4xAAA.STEP, BatteryHolder CH7410.STEP, ESP32-WROOM-32.step]
2019-12-09 + подшипники
    [Ball Bearing 6000.sldprt, Ball Bearing D1_4 D2_13 h5.STEP, Ball Bearing D1_4 D2_13 h5.sldprt, Ball Bearing _2500 ID, _500 OD, _1875 W.sldprt, Ball Bearing _312 ID, _500 OD, _156 W.sldprt, Ball Bearing _375 ID, _875 OD, _210 W.sldprt, D1_25 D2_62 h17 6305-1.sldprt, D1_28 D2_54 h9 R18.sldprt]
2020-01-29 fix & +
    [Battery 18650 2.SLDPRT, Battery 18650.SLDPRT, Battery 18650_hr.SLDPRT, CDRH4D28 h2.9.STEP, CDRH4D28 h3.STEP, CDRH4D28.sldprt, CDRH5D28 h3.STEP, CDRH5D28.sldprt]
2020-03-02 + & fix
    [SC82AB.step, SOT143_TO253.step, SOT223.step, SOT23-3.step, SOT23-5.step, SOT23-6.step, SOT23-8.step, SOT323_SC70-3.step]
2020-03-07 + 3D res 2W
    [RES DIP 2W MF-200 - 20mm_h2mm.SLDPRT, RES DIP 2W MF-200 - 20mm_h2mm.STEP, Res40-Axial Short 0.25W-2.2R.sldprt, Res90 2W SilCoat.sldprt, Resistor 1.8W 2.2 Ohms 5%.sldprt, Resistor 2W PR02.sldprt, WMO5S.sldprt]
2020-03-11 + STM32F072RxTx
2020-03-13 + 12V
2020-03-20 + модуль вольтметра + mx-2.54 x2 и x4
2020-03-22 + зазор для механичесских отвестий
2020-03-22 Сортировка RGB LED5050 +коммент
2020-03-24 перемещение поля Обозначение
2020-03-26 + аккумулятор 603030
    [Li-Pol_603030.SLDPRT, Li-Pol_603030.STEP, Li-Pol_603030.step.SLDPRT]
2020-03-29 + обозначение шагового двигателя
2020-03-30 + уполярный шаговый двигатель (УГО); fix
2020-03-31 + обозначение двигателя MDSW020B41 внутри платы
    [StepMotor_MDSW020B41.SLDPRT]
2020-04-01 Добавлен аналог MDSW020B41. Переривовоно посадочное место под него
    [StepMotor_MDSW020B41.SLDPRT, StepMotor_MDSW020B41.STEP, StepMotor_MDSW020B41.step.SLDPRT, StepMotor_MDSW020B41alternat.SLDPRT, StepMotor_MDSW020B41alternat.STEP, StepMotor_MDSW020B41alternat.step.SLDPRT]
2020-04-11 переработка модели двигателя + двинатель с открытым редуктором
    [StepGearMotor_GM15BY (FIT0503) Case.SLDPRT, StepGearMotor_GM15BY (FIT0503) Case.STL, StepGearMotor_GM15BY (FIT0503).SLDPRT, StepGearMotor_GM15BY (FIT0503).STEP, StepGearMotor_GM15BY (FIT0503).step.SLDPRT, StepGearMotor_GM15BY-VSM1527-100-10D.SLDPRT, StepGearMotor_GM15BY-VSM1527-100-10D.STEP, StepGearMotor_GM15BY-VSM1527-100-10D.step.SLDPRT]
2020-04-12 Скорректирован корпус двигателя FIT0503, добавлена кнопка 5,2*5,2*6 + micro-USB-разъёмы
    [Button 5x5x5 AJ-037(TS52xxA).STEP, Button 5x5x6 AJ-037(TS52xxA).STEP, SD-micro TFWF1.sldprt, StepGearMotor_GM15BY (FIT0503) Case.SLDPRT, StepGearMotor_GM15BY (FIT0503).SLDPRT, StepGearMotor_GM15BY (FIT0503).STEP, StepGearMotor_GM15BY (FIT0503).step.SLDPRT, USB-micro 5Pin 4.85+7.2.sldprt]
2020-04-17 + SON4 3D
    [SON4.SLDPRT, SON4.STEP]
2020-04-22 добавлен аккумулятор 403035 и вариант кожуха с длянными ножками для ретуктора FIT0503
    [Li-Pol_043035_4.4x30.5x37.SLDPRT, Li-Pol_043035_4.4x30.5x37.STEP, Li-Pol_043035_4.4x30.5x37.step.SLDPRT, Li-Pol_603030.SLDPRT, Li-Pol_603030_6x30x32.SLDPRT, Li-Pol_603030_6x30x32.STEP, Li-Pol_603030_6x30x32.step.SLDPRT, StepGearMotor_GM15BY (FIT0503) Case v2.SLDPRT]
2020-04-25 Пересмотрена нумерация контактов для разъёма шагового двигателя
2020-05-04 + теплоотвод
    [Heatsink 14x13(18)x6.2.SLDPRT, Heatsink 14x13(18)x6.2.STEP]
2020-05-04 отказался от рисунка рисунка контура плыаты в обозначении
2020-05-06 + Li-pol 503040
    [Li-Pol_043035_4.4x30.5x37_500mAh.SLDPRT, Li-Pol_043035_4.4x30.5x37_500mAh.STEP, Li-Pol_043035_4.4x30.5x37_500mAh.step.SLDPRT, Li-Pol_503040_5x30x41_Robiton_550mAh.SLDPRT, Li-Pol_503040_5x30x41_Robiton_550mAh.STEP, Li-Pol_603030_6x30x32_750mAh.SLDPRT, Li-Pol_603030_6x30x32_750mAh.STEP, Li-Pol_603030_6x30x32_750mAh.step.SLDPRT]
2020-05-06 + неодимовый магнит
    [Neodymium Magnet D3x2mm.SLDPRT, Neodymium Magnet D3x2mm.STEP]
2020-05-07 + контрольная точка DIP
2020-05-12 + примеры
    [CylinderD27H45.SLDPRT, CylinderD27H45.STL, CylinderD27H45.g, Вырез для петли (Hinge 42x14mm) WoodFill.SLDPRT, Вырез для петли (Hinge 42x14mm) WoodFill.STL, Вырез для петли (Hinge 42x14mm) WoodFill.g, Вырез для самореза (D) WoodFill.SLDPRT, Вырез под USB (USB-micro 5Pin for wire) WoodFill.SLDPRT]
2020-05-13 + пример авреза под малый динамик; + переключател на 2 контактные грппы
    [Вырез для самореза (D2.5mm) и стойка, WoodFill.SLDPRT, Вырез под динамик (Speaker_18x13) PLA.SLDPRT, Сквозной вырез для винтов впотай (D2.5mm, шляпка D5mm) PLA, WoodFill.SLDPRT]
2020-05-14 + MSS-22D18... ; сортировка посадочных мест выключателей
    [MSK-22D18-ZPT.STEP, MSK-22D18-ZPT.sldasm, MSK-22D18-ZPT_3ID_3MJING.sldprt, MSK-22D18-ZPT_MMP221.sldprt, MSK-22D18-ZPT_MMP221_PIN.sldprt, MSK-22D18-ZPT_MMP221_PP.sldprt, MSK-22D18-ZPT_MMP221_SM.sldprt, SS-3235S-L2 (MSS-22D18G2).SLDASM]
2020-05-15 + 3D модели TJ-8P8C
    [TJ-8P8C x2-442480085.STEP, TJ-8P8C x2-442480085.sldprt, TJ-8P8C-FRJAE-468.sldprt, TJ-8P8C-RJHS-5384.sldprt, TJ-8P8C-TJ12-8P8C.sldprt, TJ-8P8C-TRJE101DNL (DS1128-06 or 1-406541-1).STEP, TJ-8P8C-TRJE101DNL (DS1128-06 or 1-406541-1).sldprt, TJ-8P8C_SMD-RJSSE5380.sldprt]
2020-05-18 перенос Обозначения
2020-05-26 + USB мщдели
    [USB-micro_B Molex_47346-0001.step, USB-mini_B Lumberg_2486_01.step]
2020-05-26 + A4988 обозначение
2020-05-26 + CWF; развёрнуты разъёмы
2020-05-28 + разъём 2,5мм для шагового двигателя
2020-06-02 + 3D PLD2-6
    [PLD2-6 PinHeader_2x03_P2.00mm_Vertical.step]
2020-06-02 убрал оченратания штыревых разъёмов с нижнего слоя
2020-06-05 пересмотерена 3D-модель PBS, PBD; + 3D-модель LED 5mm vert; проба новой концепции HFCQFN16
    [LED DIP 5mm Blue Vert.STEP, LED DIP 5mm Blue Vert.sldprt, LED DIP 5mm Green Vert.STEP, LED DIP 5mm Green Vert.sldprt, LED DIP 5mm Red Vert.STEP, LED DIP 5mm Vert.SLDPRT, LED DIP 5mm Vert.STEP, LED DIP 5mm White Vert.STEP]
2020-06-07 пересмотр контактных площадок...
2020-06-07 + 3D
    [DFN12_3x1.35-QFN-12L.stp, DFN8_1.7x1.5-uQFN_1.7x1.5mm.stp, IDC-10R_2x05_P2.54mm_Horizontal.step, IDC-6R_2x03_P2.54mm_Horizontal.step, IDC-8R_2x04_P2.54mm_Horizontal.step, LFCSP10 (from ADG772BCPZ-REEL7).sldprt, MLP8_3.3x3.3.STEP, MLP8_3.3x3.3.sldprt]
2020-07-07 + резъбовая штанга на M4
    [Threaded Rod M3x90.SLDPRT, Threaded Rod M4x90.SLDPRT]
2020-07-25 + разъём FPC-6 0.5mm
    [FPC-6_0.5mm 1734839-6.SLDPRT, FPC-6_0.5mm 1734839-6.STEP, FPC-6_1.0mm.stp]
2020-07-26 + LED3030 3D
    [LED3030 YUJI.stp, LED3030.SLDPRT, LED3030.STEP]
2020-07-28 + 3D LED SK6812 4020
    [Epistar3535_RGB.SLDPRT, SK68xx SIDE.SLDPRT, SK68xx SIDE.STEP]
2020-07-28 + RJ-45 SMD
    [TJ-8P8C_SMD_vret-1-338088-x.SLDPRT, TJ-8P8C_SMD_vret-1-338088-x.STEP]
2020-07-28 + модели "RJ-45 x2" на разбор и покраску
    [TJ-8P8C x2-5406526-1.stp, TJ-8P8C x2-M-MUSB-K152-30-REVT3_RJHSE-5381-02.sldprt, TJ-8P8C x2-M-RJHSE-5380-02-REVT1.sldprt, TJ-8P8C x2-Molex_442480085.STEP]
2020-07-29 ignore 3D print files
2020-07-30 + пластина сенсора круглая 10мм
2020-07-31 + контур для пластины сессорной кнопки
    [TouchKey10mm_SilkS.SLDPRT, TouchKey10mm_SilkS.STEP]
2020-08-07 + контакты на маленький динамик
    [Speaker_18x13.STEP, Speaker_18x13.step.SLDPRT, Speaker_18x13_LCHS1622.SLDPRT, Speaker_18x13_LCHS1622.STEP, Speaker_18x13_LCHS1622.step.SLDPRT]
2020-08-14 + RJ-45 3D
    [RJ-25 plug + cover cast.STEP, RJ-25 plug + cover cast.STEP.SLDPRT, RJ-45 plug + cable.step, RJ-45 plug + cable.step.SLDPRT, RJ-45 plug + cover other.SLDPRT, RJ-45 plug + cover.STEP, RJ-45 plug + cover.sldprt, RJ-45 plug - MOLEX_44915-0001.SLDPRT]
2020-08-20 + SOD523 3D
    [SOD523F.STEP]
2020-09-06 + 3D...
    [FCQFN16 - MP8765.stp.SLDPRT, FCQFN24 - MP2637.stp.SLDPRT, FCQFN24.STEP, HQFN16_3x3mm_P0.5mm_EP1.8x1.8mm.step, X2QFN12 - TUSB211RWBR.stp.SLDPRT, X2QFN12.STEP]
2020-09-07 обновлены модели
    [FCQFN16 - MP8765.stp.SLDPRT, FCQFN16.STEP, FCQFN24 - MP2637.stp.SLDPRT, FCQFN24.STEP, X2QFN12 - TUSB211RWBR.stp.SLDPRT, X2QFN12.STEP]
2020-09-07 переименование...
    [DFN8_1.7x1.5mm-uQFN.STEP, LGA12_4.9x2.5mm-VL53L1X.step, MLP8_3.3x3.3mm.STEP, QFN16_4x4mm_p0_65.STEP]
2020-09-22 + D203S
    [PIR Sensor.sldasm, PIR Sensor_Leads.sldprt, PIR Sensor_PIR plastic.sldprt, PIR Sensor_PIR_S_Orginal.sldprt, PIR_D203S_TO5-3.STEP, PIR_D203S_TO5-3.sldprt]
2020-09-24 термозагрузка на DIP-компоненты; мелкие правки
2020-09-28 + L433; MSK12C01 3D
    [SMD SPDT MSK12C01 IS_1290_1P2T_2.sldprt]
2020-09-30 + токовый шунт SBB-M
    [CurrentSensor_SBB-M-1F-y-t5.SLDPRT, CurrentSensor_SBB-M-1F-y-t5.STEP]
2020-09-30 + графика паука
2020-10-01 термозагрузка для PCB Fuse
2020-10-01 + графика паука на паутине
2020-10-02 паук на паутине: рисунок на медном слое
2020-10-09 + VS; Opto VS; CH7410 3D...
    [BatteryHolder CH7410 - вар.2.STEP, BatteryHolder CH7410.STEP, DIP6-SMD.STEP, DIP6-SMD.sldprt, MOC8050SR2M.sldasm, MOC8050SR2M_dipso6body_1.sldprt, MOC8050SR2M_dipso6lead_1.sldprt, MOC8050SR2M_dipso6leadbumpl_1.sldprt]
2020-10-11 транзисторы: правка описаний
2020-10-12 перенос в opto
    [MOC8050SR2M.sldasm, MOC8050SR2M_dipso6body_1.sldprt, MOC8050SR2M_dipso6lead_1.sldprt, MOC8050SR2M_dipso6leadbumpl_1.sldprt, MOC8050SR2M_dipso6leadbumpr_1.sldprt, opto 4N25_SMDIP-6.STEP, opto 4N25_SMDIP-6.sldprt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]
2020-10-12 + TO220-3 3D
    [TO220-3_Horizontal_TabDown (2).STEP, TO220-3_Horizontal_TabDown.step, TO220-3_Horizontal_TabUp (2).STEP, TO220-3_Horizontal_TabUp (2).sldprt, TO220-3_Horizontal_TabUp.step, TO220-3_Vertical-1mm.STEP, TO220-3_Vertical.SLDPRT]
2020-10-14 + держатели предохранителей
    [Clips FC-201 with fuse 5x20.sldasm, Clips FC-201 with fuse 5x20_5x20.sldprt, Clips FC-201 with fuse 5x20_FC-201.sldprt, Clips FH-100 with fuse 5x20.sldasm, Clips FH-100 with fuse 5x20_5x20.sldprt, Clips FH-100 with fuse 5x20_FH-100.sldprt, Clips LF-102071 with fuse 6.3x32.sldasm, Clips LF-102071 with fuse 6.3x32_6,3x32.sldprt]
2020-10-16 + Wi-Fi ESP32
    [ESP32-WROOM-32.step]
2020-10-18 + клеммники Degson
    [Cleamm-10_5mm_DG128-5.0-10.stp, Cleamm-2_5mm_DG128-5.0-02.stp, Cleamm-2_9.5mm_MKDSV 5_2-9.5.stp, Cleamm-3_5mm_DG128-5.0-03.stp, Cleamm-3_5mm_DG306-5.0-3P.STEP, Cleamm-4_5mm_DG128-5.0-04.stp, Cleamm-5_5mm_DG128-5.0-05.stp, Cleamm-6_5mm_DG128-5.0-06.stp]
2020-10-18 FPC-6: замена FPV-WZB201-02-LF на TE 0-1734839-6
2020-10-21 + линда Френеля, + RG-45 DIP vert
    [FresnelLens 10mm 8308-4.SLDPRT, FresnelLens 10mm 8308-4.STEP, PIR_D203S_TO5-3.STEP, PIR_D203S_TO5-3.sldprt, TJ-8P8C_vret-5520259-x.SLDPRT, TJ-8P8C_vret-5520259-x.STEP]
2020-10-23 + EG4002, etc
    [TJ-8P8C_x-0406525-12-x.stp]
2020-10-26 правка обозначений входов приёмо-передатчика RS-485/422
2020-10-26 + BTN4.4*4.5; сортировка кнопок и выключателей
    [Button 12x12x7.3.SLDPRT, Button 4.5x4.5x3.8 IT-1109S.STEP, Button 4.5x4.5x3.8 IT-1109S.sldprt, Button 4.5x4.5x3.8 SMD IT-1109S.sldprt, Button 4.5x4.5x5 SMD.STEP, Button IT-1198.SLDPRT, Button IT1198.STEP, Button KLS7-TS5401.sldprt]
2020-10-26 + BTN 4.5*4.5 3D; fix LED 3030 PAD
    [Button 4.5x4.5x3.8.STEP, Button 4.5x4.5x3.8.sldprt]
2020-10-28 + радиатор SK 29, IDC-16, Cleamm-4, etc
    [Heatsink 30x12x38 - SK 29 38 S.SLDPRT, Heatsink 30x12x38 - SK 29 38 S.STEP]
2020-10-30 + SBTN01 series 3D
    [PwrSupp_MW_SBTN01series.SLDPRT, PwrSupp_MW_SBTN01series.STEP]
2020-11-02 + IDC2 3D; + MX2.54-2R
    [IDC2-10MS (BH2-10).STEP, IDC2-10MS (BH2-10).sldprt, IDC2-10R (BH2-10R).STEP, IDC2-14MS (BH2-14).STEP, IDC2-14MS (BH2-14).sldprt, IDC2-24MS (BH2-24).STEP, IDC2-24MS (BH2-24).sldprt]
2020-11-04 + метки на останна-лого
2020-11-05 + SOT-89; PT4115
    [SOT89-3.STEP, SOT89-5L.stp, SOT89-case.SLDPRT, SOT89-pinout.SLDPRT, SOT89.SLDASM]
2020-11-06 смещено обозначение
2020-11-06 + cristal 2012 3D
    [Crystal_2012_FC-12M.stp, NDK_NX3215SA 2pin.sldprt, TXC Corp 7M series 3.3x2.6.sldprt]
2020-11-08 + PowerDI123
    [PowerDI123.STEP, PowerDI123.sldprt]
2020-11-09 + Micro-Fit 3D
    [MicroFit-1x2 - Molex 43650-0215.SLDPRT, MicroFit-1x2 - Molex 43650-0215.STEP, MicroFit-1x2-436500215.sldprt, MicroFit-1x2R - Molex 43650-0200 — серые контакты.SLDPRT, MicroFit-1x2R - Molex 43650-0200.SLDPRT, MicroFit-1x2R - Molex 43650-0200.STEP, MicroFit-1x3 - Molex 43650-0315.SLDPRT, MicroFit-1x3 - Molex 43650-0315.STEP]
2020-11-10 + MX-2.54 3D
    [MX2.54-2.SLDPRT, MX2.54-2.STEP, MX2.54-2R.SLDPRT, MX2.54-2R.STEP, MX2.54-3.SLDPRT, MX2.54-3.STEP, MX2.54-3R.SLDPRT, MX2.54-3R.STEP]
2020-11-14 + WEC6R0505QG I 3D; ,,,
    [SuperCap_D10.5x21x32 WEC6R0505QG I.STEP, SuperCap_D10.5x21x32 WEC6R0505QG I.sldprt]
2020-12-25 Выделено отдельное посадочное место для VL53L1 (с ключём)
2021-01-07 замена 3D моделей разъёмов IDC-2.54
    [IDC-10MS (DS1013-10S).step, IDC-10_2x05_P2.54mm_Vertical.step, IDC-12MS (DS1013-12S).stp, IDC-12__2x06_P2.54mm_Vertical.step, IDC-14MS (DS1013-14S).stp, IDC-14_2x07_P2.54mm_Vertical.step, IDC-16MS (DS1013-16S).stp, IDC-16_2x08_P2.54mm_Vertical.step]
2021-01-10 подписан аналог
2021-01-19 + датчик жидкости
2021-01-20 правка обозначения преобразователя уровня
2021-01-27 + RGB LED hor
2021-01-27 + ICN2595
    [TSSOP24_4.4x7.8mm_P0.65mm.step]
2021-02-03 + разъёмные клеммы
    [TO202-3.STEP, TO202-3.sldprt]
2021-02-06 + Li-pol аккумуляторы
    [Li-Pol_043040_4x30x41.5_600mAh.SLDPRT, Li-Pol_043040_4x30x41.5_600mAh.STEP, Li-Pol_043040_4x30x41.5_600mAh.step.SLDPRT, Li-Pol_043048_3x30x47_700mAh.SLDPRT, Li-Pol_043048_3x30x47_700mAh.STEP, Li-Pol_043048_3x30x47_700mAh.step.SLDPRT, Li-Pol_043759_4x36x60_1000mAh.SLDPRT, Li-Pol_043759_4x36x60_1000mAh.STEP]
2021-02-07 + 3D модели разъёмных клеммников (2EDGRC / 2EDGVC)
    [Cleamm-10_5mm - 2EDGVC-5_0-10P-14-00AH.sldprt, Cleamm-2_5mm - 2EDGRC-5_0-02P-14-00AH.sldprt, Cleamm-2_5mm - 2EDGVC-5_0-02P-14-00AH.STEP, Cleamm-2_5mm - 2EDGVC-5_0-02P-14-00AH.sldprt, Cleamm-3_5mm - 2EDGRC-5_0-03P-14-00AH.sldprt, Cleamm-3_5mm - 2EDGVC-5_0-03P-14-00AH.sldprt, Cleamm-4_5mm - 2EDGRC-5_0-04P-14-00AH.sldprt, Cleamm-4_5mm - 2EDGVC-5_0-04P-14-00AH.sldprt]
2021-02-10 fix (обозначения L431, L433, L476)
2021-02-17 + PCA9635 (требует правки)
2021-02-25 + Speaker_D15x4
    [Speaker_D15x4.SLDPRT, Speaker_D15x4.STEP, Speaker_D15x4.step.SLDPRT]
2021-03-10 + петля 20x16
    [Fuse Holder 153032-1.sldprt, Hinge 20x16mm Assem.SLDASM, Hinge 20x16mm Part.SLDASM, Hinge 20x16mm Part.STEP, Hinge 20x16mm Part.step.SLDPRT, Hinge 42x14mm 1.2.STEP, Hinge 42x14mm Assem.SLDASM, Hinge 42x14mm Part.SLDASM]
2021-03-14 + аккумуляторы
    [Li-Pol_302040_3x20x41_500mAh.SLDPRT, Li-Pol_302040_3x20x41_500mAh.STEP, Li-Pol_302040_3x20x41_500mAh.step.SLDPRT, Li-Pol_852526_8.3x24.5x28.5_Robiton_500mAh.SLDPRT, Li-Pol_852526_8.3x24.5x28.5_Robiton_500mAh.STEP, Li-Pol_852526_8.3x24.5x28.5_Robiton_500mAh.step.SLDPRT, Вырез для петли (Hinge 42x14mm) WoodFill.SLDPRT, Вырез для петли (Hinge 42x14mm) WoodFill.STL]
2021-03-15 + Li-Pol_302030_3x20x31.5_320mAh
    [Li-Pol_302030_3x20x31.5_320mAh.SLDPRT, Li-Pol_302030_3x20x31.5_320mAh.STEP, Li-Pol_302030_3x20x31.5_320mAh.step.SLDPRT]
2021-03-15 + мотор 9х8 и 15мм
    [StepMotor_9x8mm.SLDPRT, StepMotor_9x8mm.STEP, StepMotor_9x8mm.step.SLDPRT, StepMotor_GM15BY_no_gear.SLDPRT]
2021-03-19 Li-pol упорядочены по размеру
    [Li-Pol_3x20x31.5_302030_320mAh.SLDPRT, Li-Pol_3x20x31.5_302030_320mAh.STEP, Li-Pol_3x20x31.5_302030_320mAh.step.SLDPRT, Li-Pol_3x20x41_302040_500mAh.SLDPRT, Li-Pol_3x20x41_302040_500mAh.STEP, Li-Pol_3x20x41_302040_500mAh.step.SLDPRT, Li-Pol_3x30x47_043048_700mAh.SLDPRT, Li-Pol_3x30x47_043048_700mAh.STEP]
2021-03-21 + li-pol 3mm
    [Li-Pol_3.2x28x29.5_30303_280mAh.SLDPRT, Li-Pol_3.2x28x29.5_30303_280mAh.STEP, Li-Pol_3.2x28x29.5_30303_280mAh.step.SLDPRT, Li-Pol_3x25x36.5_302535_350mAh.SLDPRT, Li-Pol_3x25x36.5_302535_350mAh.STEP, Li-Pol_3x25x36.5_302535_350mAh.step.SLDPRT]
2021-03-28 + Li-pol
    [Li-Pol_4x29.7x36.8_043035_500mAh.SLDPRT, Li-Pol_4x29.7x36.8_043035_500mAh.STEP, Li-Pol_4x29.7x36.8_043035_500mAh.step.SLDPRT]
2021-03-29 + Fuse Holder KLS5-266
    [Fuse Holder FH-100 with fuse 5x20.STEP]
2021-03-30 + 2EDGVC-5_0-03P
    [Cleamm-3_5mm - 2EDGVC-5_0-03P-14-00AH.STEP]
2021-04-07 + Neodymium Magnet D6x1mm
    [Neodymium Magnet D6x1mm.SLDPRT]
2021-04-15 + Cabochon
    [CabochonPerl_D4mm.SLDPRT, CabochonPerl_D6mm.SLDPRT, CabochonPerl_D8x4.5mm.SLDPRT, Hinge 20x16mm Assem.SLDASM, Hinge 20x16mm Part.SLDASM, Hinge 20x16mm Part.STEP, Hinge 20x16mm Part.step.SLDPRT, Hinge 42x14mm Assem.SLDASM]
2021-04-16 полубусины: поправлен цвет
    [CabochonPerl_D4mm.SLDPRT, CabochonPerl_D6mm.SLDPRT, CabochonPerl_D8x4.5mm.SLDPRT]
2021-04-28 + модель боковых светодиодов
    [E6C1204RGBC3UDA.SLDPRT, E6C1204RGBC3UDA.STEP]
2021-06-05 Мосты на печатной плате: + & fix
2021-07-01 + держатель предохранителя FH1-200C
    [Fuse Holder 696108003002 (FH1-200C) with fuse 5x20.STEP, Fuse Holder 696108003002 (FH1-200C) with fuse 5x20.sldprt]
2021-07-01 + 3D модели деталей Ehtele от Ивана
    [ABK-404 - мама.SLDASM, ABK-404 - мама.STEP, ABK-404 - папа.SLDASM, ABK-404 - папа.STEP, Nut M3L15_MF.SLDPRT, PwrSupp_MW_LRS-50-12.SLDASM, PwrSupp_MW_RS-25-5.SLDASM, RS-202-6C1-B-B (DPST 16A 250VAC).SLDPRT]
2021-07-05 + разиатор HS 117-30
    [Heatsink 43x20x30 - HS 117-30 (K117-30).SLDPRT, Heatsink 43x20x30 - HS 117-30 (K117-30).STEP, Heatsink 43x20x30 - HS 117-30.STEP]
2021-07-05 выводы с формовкой
2021-07-06 + разъёмный клеммники
2021-07-09 SOT416 -> SOT523; +BQ24640; +IDC-20 etc...
    [BatteryHolder BAT-HLD-001.STEP, BatteryHolder CH7410 - вар.2.STEP, BatteryHolder CR2032 - BAT-HLD-001 (TBH-CR2032-M04).sldprt, BatteryHolder CR2032 - CH25-2032LF.sldprt, BatteryHolder CR2032 - CH7410.SLDPRT, BatteryHolder CR2032 - KLS5-CR2032-03.sldprt, BatteryHolder CR2032 - Keystone 3002TR.sldprt, IDC-14R_2x07_P2.54mm_Horizontal.step]
2021-07-14 структурарованны токоизмерительные резисторы
    [CurrentSensor 4-wire SBB-series.SLDPRT, CurrentSensor 4-wire SBB-series.STEP]
2021-07-16 + PBD-20; +PBD-x_mirr
    [PBD-20.STEP]
2021-09-05 обновлён вырез для петли
    [Вырез для магнита D3x5мм, WoodFill.SLDPRT, Вырез для петли (Hinge 42x14mm) WoodFill.SLDPRT, Вырез для петли Hinge 20x16mm, WoodFill.SLDPRT, Вырез для петли Hinge 42x14mm +упор крышки, WoodFill.SLDPRT, Вырез для петли Hinge 42x14mm, WoodFill.SLDPRT, Вырез для самореза D2.5mm и стойка, WoodFill.SLDPRT, Вырез под USB-micro 5Pin for wire, WoodFill.SLDPRT, Вырез под динамик Speaker_18x13, PLA.SLDPRT]
2021-10-17 правки позиционирования
    [Вырез под USB-micro 5Pin for wire, WoodFill.SLDPRT, Вырез под динамик Speaker_D40x5.8, WoodFill.SLDPRT]
2021-10-17 + Держатель мотора StepMotor_9x8mm
    [Держатель мотора StepMotor_9x8mm.SLDPRT]
2021-11-06 + контроллер идеального диода; + транзисторные сборки
2021-12-05 + клеммники 2,5мм
    [Cleamm-10_2.5mm_15EDGVC-2.5-10P-14-00AH.STEP, Cleamm-6_2.5mm_15EDGVC-2.5-06P-14-00AH.STEP, Cleamm-7_2.5mm_15EDGVC-2.5-07P-14-00AH.STEP, Cleamm-8_2.5mm_15EDGVC-2.5-08P-14-00AH.STEP, Cleamm-9_2.5mm_15EDGVC-2.5-09P-14-00AH.STEP]
2021-12-15 L476: подпись "RTS-DE"
2021-12-15 + втулочная гайка, винт с полу-круглой головкой, катушка беспроводной зарядки, переименованы подшипники, добавлен новый подшипник
    [Ball Bearing D1_4 D2_13 h5.sldprt, Ball Bearing D4x13h5 624ZZ.STEP, Ball Bearing D4x13h5 624ZZ.sldprt, Ball Bearing D4x13h5 624ZZ.step.SLDPRT, Ball Bearing D8x22h7 608ZZ.STEP, Ball Bearing D8x22h7 608ZZ.sldprt, Ball Bearing D8x22h7 608ZZ.step.SLDPRT, Button head screw M8x20.SLDPRT]
2021-12-17 добавлены ключи на разъёмы 15EDGVC
    [Cleamm-2_5mm_2EDGVC-5_0-02P-14-00AH.STEP, Cleamm-3_5mm_2EDGVC-5_0-03P-14-00AH.STEP]
2021-12-17 + 15EDGVC-3.5-07
    [Cleamm-7_3.5mm_15EDGVC-3.5-07P-14-00AH.STEP]
2021-12-27 + DT-26, ESP32PROG conn, GPIO Expander, NOR Flash, Real-Time Clock IC(s), STEF05PUR
    [DT-26 2x6-0.7mm.SLDPRT, DT-26 2x6-0.7mm.step, DT-26 2x6-1.4mm.sldprt, DT-26 2x6-1.4mm.step, PLS-10.STEP, PLS-3.SLDPRT, PLS-7.STEP, PLS-8.STEP]
2022-01-06 + магниты
    [Neodymium Magnet D10x3mm hole3.5x7.SLDPRT, Neodymium Magnet D10x3mm.SLDPRT, Neodymium Magnet D6x1mm.SLDPRT, Neodymium Magnet D8x5mm.SLDPRT]
2022-01-12 + 3D FPC-0.5-6 с контактами снизу
    [FPC-6_0.5mm 1734592-6.SLDPRT, FPC-6_0.5mm 1734592-6.STEP]
2022-01-19 замена "MSK12C01 ver" на "MSS12C01 ver"
2022-01-29 + модель динамика 17х12
    [Speaker_17x12x4.3.SLDPRT, Speaker_17x12x4.3.STEP, Speaker_17x12x4.3.step.SLDPRT]
2022-03-07 Исправления и правки
    [Шпон-паз для двигателя GM15BY (FIT0503), WoodFill.SLDPRT]
2022-03-11 Правка концепции названия корпусов SOT-3x3, SOT-5x3
    [SOT553_SOT665.step, SOT563_SOT666.step, SOT666_SOT563.step]
2022-03-21 + USB-A Wurth 614004135023 (DS1095-10)(vertical)
    [USB-A Molex SD-1050570-001 (vertical).stp, USB-A Wurth 614004135023 (DS1095-10)(vertical).SLDPRT, USB-A Wurth 614004135023 (DS1095-10)(vertical).stp, USB-B_vertical.step]
2022-03-21 мелкие правки
2022-03-22 + USB-A 3D vertical
    [USB-A-01 Buchse THT.sldprt, USB-A.SLDPRT, USB-A.STEP, USB-A.ipt, USB-micro B-5FS (vertical).step, USB-micro_B B-5FS (vertical).step, USB-micro_B USB3130-30-A (vertical).STEP, USB-mini_B 651005136421 (vertical).SLDPRT]
2022-03-28 + IDC22; fix IDC20
    [IDC-20R_Pin Shrouded Header Right Angle.STEP, IDC-22_Pin Shrouded Header.step]
2022-03-30 Развёрнуто обозначение диодов на 180груд; + универсальное посадочное место SOD323+523
2022-03-30 замена 3D IDC-22 + файл для постоения любого IDC-2.54
    [IDC-22MS (DS1013-22).STEP, IDC-22_Pin Shrouded Header.step, IDC-xxMS (DS1013-xx).SLDPRT, IDC1.27-xx (redaction 3220-xx-0100-00).SLDPRT]
2022-04-02 + универсальное посадочное место под ESP-32
2022-04-05 исколючение IDC-22: нет в модельном ряду (не производят IDC на 22 контакта)
    [IDC-22MS (DS1013-22).STEP]
2022-04-16 + IDC-24; LED reversive; Heatsink 35*10; & 3D...
    [Cleamm-4_5mm - 2EDGVC-5_0-04P-14-00AH.STEP, Cleamm-6_5mm - 2EDGVC-5_0-06P-14-00AH.STEP, Cleamm-8_5mm - 2EDGVC-5_0-08P-14-00AH.STEP, Heatsink 35x10x50 - HS 207-50 (K207-50).SLDPRT, Heatsink 35x10x50 - HS 207-50 (K207-50).STEP, Heatsink 35x10x50 - HS 207-50.STEP]
2022-04-20 + IDC-24
    [IDC-20R_Pin Shrouded Header Right Angle.STEP, IDC-24MS (DS1013-24).STEP]
2022-04-30 добавлена ось центра петли
    [Hinge 20x16mm Part.SLDASM, Hinge 20x16mm Part.step.SLDPRT, Hinge 42x14mm Part.SLDASM, Hinge 42x14mm Part.step.SLDPRT]
2022-05-10 + винтовые клемменики 5.08 3D
    [Cleamm-10_5.08mm 430-0051-01-00 (2EDGK-5.08-10P).SLDPRT, Cleamm-6_5.08mm - HOSTOQ085451 (2EDGRC-5_08-06P).sldprt]
2022-05-11 преход на кодировку UTF-8
2022-05-20 + пример выреза для самореза впотай
    [Вырез для самореза D2.5mm и стойка, WoodFill.SLDPRT, Сквозной вырез для саморезов впотай D2.5mm, шляпка D5mm, WoodFill.SLDPRT, Стойка и отверстие под саморез D2.5mm, WoodFill.SLDPRT]
2022-06-05 фототранзитор 0603 - явно обозначено положение кристалла
2022-06-05 увеличена длина контактных площадок
2022-06-08 + ножка для шкатулки (3D)
    [Feed Wood box h17 D10 (P010 G).SLDPRT, Feed Wood box h17 D10 (P010 G).STEP, Ножка приборная (Adjustable Support Leg).SLDPRT]
2022-06-08 обновлены контакты в FuseSolder
2022-06-21 Исправлен радиатор; добавлены обозначения крепёжных винтов; добавлен датчик расходя электроэнергии BL0937
2022-07-02 правка названия посаточного места светодиодов
2022-07-02 убрана иконка винта 3х3мм (слишком маленькая - сливаются линии шелкографии)
2022-07-21 скорректирован размер контактных пощадок
2022-08-15 + PBD2-10; доп. информация по "зарядкам"
    [PBD2-10 PinSocket_2x05_P2.00mm_Vertical.step, PBD2-10 PinSocket_2x05_P2.00mm_Vertical_SMD.step]
2022-08-17 Оптроны: правка описания
2022-08-18 + обозначение QRD111x
2022-08-24 + PBD2-10 & fix
    [PLD2-10 PinHeader_2x05_P2.00mm_Vertical.step, PLD2-10 PinHeader_2x05_P2.00mm_Vertical_SMD.step]
2022-09-06 + ИК светодиоды и фототранзистор
    [LED IR 3010 Hor - SFH 4045N.SLDPRT, LED IR 3010 Hor - SFH 4045N.STEP, LED3010 Hor 3pin - KPA-3010 sries.SLDPRT, LED3010 Hor 3pin - KPA-3010 sries.STEP, LightSens3010 - SFH 3015 FA.SLDPRT, LightSens3010 - SFH 3015 FA.STEP]
2022-09-13 вертикальные DIP-дсветодиоды: переименование
    [LED DIP 5mm Blue Vertical.STEP, LED DIP 5mm Green Vertical.STEP, LED DIP 5mm Green Vertical.sldprt, LED DIP 5mm Red Vertical.STEP, LED DIP 5mm Vertical.SLDPRT, LED DIP 5mm Vertical.STEP, LED DIP 5mm White Vertical.STEP, LED DIP 5mm Yellow Vertical.STEP]
2022-09-13 элетрод сенсора (обозначение): переименование
2022-09-13 + PBD-10, PBD2-12, FPC-6-0.5_vert; подписи к штыревым разъёмам
    [FPC-6_0.5mm-Vertical Molex 52559-0652.SLDPRT, FPC-6_0.5mm-Vertical Molex 52559-0652.STEP, PBD2-12 PinSocket_2x06_P2.00mm_Vertical.step, PLD2-12 PinHeader_2x06_P2.00mm_Vertical.step, PLD2-12S PinHeader_2x06_P2.00mm_Vertical_SMD.step]
2022-09-19 + PBD2-12S; правка описания...
    [PBD2-10S PinSocket_2x05_P2.00mm_Vertical_SMD.step, PBD2-12S PinSocket_2x06_P2.00mm_Vertical_SMD.step]
2022-09-20 обозначения PBD -mirr приняты за основные, зеркальный вариант исключён
2022-09-20 + электрод сенсора d5мм
    [TouchKey10mm_SilkS.SLDPRT, TouchKey5mm_SilkS.SLDPRT, TouchKey5mm_SilkS.STEP]
2022-09-20 + PT91-21C
    [LightSens2520 - PT91-21C-TR10.SLDPRT, LightSens2520 - PT91-21C-TR10.STEP]
2022-09-28 Добавлена графика сенсорного кольца за 9 секторов и d=39мм и т.п.
    [TouchKey5mm_SilkS.SLDPRT, TouchKey5mm_SilkS.STEP, TouchKey6mm_SilkS.SLDPRT, TouchKey6mm_SilkS.STEP]
2022-10-07 Исправления и уточнения
2022-10-23 + Reed Switch Glass 3D
    [Reed Switch Glass 14.1x2.3mm (МКА-14103).STEP, Reed Switch Glass 14.5x2.3mm (МКА-14103) hinged.SLDPRT, Reed Switch Glass 14.5x2.3mm (МКА-14103) hinged.step, Reed Switch Glass 15.2x2.2mm.sldprt, Reed Switch Glass 15.2x2.2mm.step, Reed Switch Glass 20x4mm.stp]
2022-11-01 убранно лишнее
    [trident.STL]
2022-11-03 облегчена модель SK6812-3535
    [SK6812mini (3535).SLDPRT, SK6812mini (3535).stp, SK6812mini (3535)_lite.SLDPRT, SK6812mini (3535)_lite.STEP]
2022-11-04 + вариант мотора 15BY с короткой платой; обновлены модели остальных
    [8412NGMI_ebm-papst.sldasm, Fan-House_8412NGMI_ebm-papst.sldprt, Fan_8412NGMI_ebm-papst.sldprt, StepGearMotor_GM-15BY-100-9D.SLDPRT, StepGearMotor_GM-15BY-100-9D.STEP, StepGearMotor_GM-15BY-100-9D.step.SLDPRT, StepGearMotor_GM15BY (FIT0503).SLDPRT, StepGearMotor_GM15BY (FIT0503).STEP]
2022-11-15 + разновидности кнопок 5х5, перенос токовогорезистора
    [Button 5x5x2 AJ-037(TS52xxA).STEP, Button 5x5x3 AJ-037(TS52xxA).STEP, Button 5x5x4 AJ-037(TS52xxA).STEP, Button 5x5x7 AJ-037(TS52xxA).STEP, Button 5x5x8 AJ-037(TS52xxA).STEP, Button 5x5x9 AJ-037(TS52xxA).STEP, CurrentSensor 4-wire SBB-series.SLDPRT, CurrentSensor 4-wire SBB-series.STEP]
2022-11-15 + плата-кольцо светодиодов; отрезок ленты на 144led/m
    [WS2812 35led Ring PCB 96mm.SLDASM, WS2812 35led Ring PCB 96mm.STEP, WS2812 led Strip 8mm.SLDASM, WS2812 led Strip 8mm.STEP]
2022-11-26 + сегмент ленты 60led/m, правка сегмента 144led/m
    [WS2812 led Strip 16x10mm 60led-m.SLDASM, WS2812 led Strip 16x10mm 60led-m.STEP, WS2812 led Strip 7x12mm 144led-m.SLDASM, WS2812 led Strip 7x12mm 144led-m.STEP, WS2812 led Strip 8mm.SLDASM]
2022-12-03 Обновлема модель (не критично)
    [StepGearMotor_GM-15BY-100-9D.SLDPRT, StepGearMotor_GM-15BY-100-9D.STEP, StepGearMotor_GM-15BY-100-9D.step.SLDPRT]
2022-12-21 Правка модели двигателя; +набросок модели динамика
    [Speaker_D40x15.SLDPRT, StepGearMotor_GM-15BY-100-9D.SLDPRT, StepGearMotor_GM-15BY-100-9D.STEP, StepGearMotor_GM-15BY-100-9D.step.SLDPRT, StepGearMotor_GM15BY (SM1511WC01).SLDPRT, StepGearMotor_GM15BY (SM1511WC01).STEP, StepGearMotor_GM15BY (SM1511WC01).step.SLDPRT]
2022-12-21 + прмеры отверстий
    [Сквозной вырез для саморезов впотай D2.0mm, шляпка D4mm, WoodFill.SLDPRT, Стойка и отверстие под саморез D2.0mm, WoodFill.SLDPRT, Стойка и отверстие под саморез D2.5mm, WoodFill.SLDPRT]
2023-01-20 обновлены 3D-модели светодиодной ленты
    [WS2812 led Strip 10x10mm 100led-m.SLDASM, WS2812 led Strip 10x10mm 100led-m.STEP, WS2812 led Strip 10x16mm 60led-m.SLDASM, WS2812 led Strip 10x16mm 60led-m.STEP, WS2812 led Strip 12x7mm 144led-m.SLDASM, WS2812 led Strip 12x7mm 144led-m.STEP, WS2812 led Strip 16x10mm 60led-m.SLDASM, WS2812 led Strip 16x10mm 60led-m.STEP]
2023-01-20 + сетка динамика 3ГДШ-2
    [Speaker grill for 3ГДШ-2.SLDPRT]
2023-02-09 + УГО самовосстанавливающегося предохранителя; обновлено УГО TP5100 ;комментарии
2023-03-17 + таблици библиотек
2023-03-22 основной путь для 3D моделей: ${KICAD_SYMBOL_DIR}/3D/
2023-03-22 переименование stp -> step
    [BREADBOARD_MINI.step, Button 6x6x5.step, CAPSMD470-6.3.step, CAPTH1000-16.step, CAPTH1000-25.step, CAPTH220-16.step, CAPTH220-25.step, CAPTH220-50.step]
2023-03-22 Созданы библиотеки символов KiCAD 7
2023-03-22 удалены старый файлы библитотек
2023-03-22 + TSOP48xx; правки описаний
2023-03-25 Fix / update
    [opto_SOIC-16L (127P690X210) — копия.sldprt]
2023-03-30 + 3D модель TSOP48xx
    [TSOP2xxx, TSOP32xxx Hor.STEP, TSOP2xxx, TSOP32xxx Hor.stp.SLDPRT, TSOP2xxx, TSOP32xxx Vert.stp.SLDPRT]
2023-03-30 мелкие правки...
2023-03-30 Правки, исправления.
2023-04-06 атрибуты
2023-04-11 Обновление катушек...
    [CDRH4D18.sldprt, CDRH4D28.sldprt, CDRH5D28 h3.STEP, CDRH5D28.sldprt, CDRH6D28 h3.STEP, CDRH6D28.sldprt]
2023-04-11 + вертикальный micro-USB
    [USB-micro_B U-D-M5DD-W-1 (vertical).SLDPRT, USB-micro_B U-D-M5DD-W-1 (vertical).STEP]
2023-04-12 + логика
2023-04-12 обновления и исправления
    [CDRH4D28 h3.STEP, CDRH4D28.sldprt, CDRH5D28.sldprt, CDRH6D28 h3.STEP, CDRH6D28.sldprt, SMB_DO214AA.step]
2023-04-14 Добавлены новые катушки фильтров; обновления синфазных дросселей
    [6039296832.sldasm, Body.sldasm, Choke ACM1211.SLDPRT, Choke ACM1211.step, Choke PL8200.SLDPRT, Choke SRF2012A.SLDPRT, Choke SRF2012A.step, Choke_0805 - DLW21S.STEP]
2023-04-14 + твёрдотельное DC реле
2023-04-14 правки, заметки
2023-04-15 првыки привязок к 3D
    [4D18C h1.9.STEP, CDRH5D28 h3.STEP, Ferrite Bead 1206 h1.1 - PBY321611.STEP, Ferrite Bead 1206 h1.6 - BLM31s.STEP]
2023-04-18 обновлены конденсаторы (+3D модели DIP)
    [CAP Electrolytic DIP 10x20.sldprt, CAP_DIP_5.0mm Small.step, CAP_DIP_5.0mm Vishay Kxxxx15 Series.SLDPRT, CAP_DIP_5.0mm Vishay Kxxxx15 Series.step, CAP_DIP_5.0mm.STEP, CAP_pol_DIP_D10x13mm.STEP, CAP_pol_DIP_D10x13mm.sldprt, CAP_pol_DIP_D10x16mm.STEP]
2023-04-19 + 3D можели: додные мосты, трансформатор
    [Bridge DFM.SLDPRT, Bridge DFM_330mil.STEP, Bridge KBU case.SLDPRT, Bridge KBU-R.STEP, Bridge KBU.STEP, Transformer 58x50x44mm - ТПГ-114 series.SLDPRT, Transformer 58x50x44mm - ТПГ-114 series.STEP]
2023-04-19 + разъёмные клеммники на 3,5мм
    [Cleamm-12_3.5mm - 15EDGVC-3.5-12P-14-00AH.STEP, Cleamm-2_3.5mm - 15EDGVC-3.5-02P-14-00AH.STEP, Cleamm-2_5mm_screew terminal.STEP, Cleamm-3_3.5mm - 15EDGVC-3.5-03P-14-00AH.STEP, Cleamm-4_3.5mm - 15EDGVC-3.5-04P-14-00AH.STEP, Cleamm-5_3.5mm - 15EDGVC-3.5-05P-14-00AH.STEP, Cleamm-6_3.5mm - 15EDGVC-3.5-06P-14-00AH.STEP, Cleamm-7_3.5mm - 15EDGVC-3.5-07P-14-00AH.STEP]
2023-04-23 обновлены 3D модели сведодиодов
    [LED DIP 5mm Hor Green.SLDPRT, LED DIP 5mm Hor Green.STEP, LED DIP 5mm Hor_mirr Green.SLDPRT, LED DIP 5mm Hor_mirr Green.STEP, LED DIP 5mm Vert Blue.STEP, LED DIP 5mm Vert Blue.sldprt, LED DIP 5mm Vert Green.STEP, LED DIP 5mm Vert Green.sldprt]
2023-04-27 дополнения, правки, исправления
    [CAP_pol_DIP_D6.3x11mm.SLDPRT, CAP_pol_DIP_D6.3x11mm.STEP, CAP_pol_DIP_D8x11.5mm.sldprt, Crystal_2012 - FC-12M.step, Crystal_3215 - NX3215SA.SLDPRT, Crystal_3215 - NX3215SA.step, Crystal_3215 - RTF3215.step, Ferrite Bead 1812 h3.2 - FBMH4532s.STEP]
2023-05-02 увеличены отверстия под выводы конденсаторов
2023-05-02 добавлена надпись к логотипу WattWell
2023-05-13 редактирование gitignore: игнорировать каталог .settings/ (Eclipse)
2023-05-13 + мотор 9,6х10 и динамик 40х6,5
    [Speaker_D40x6.5.SLDPRT, Speaker_D40x6.5.STEP, Speaker_D40x6.5.step.SLDPRT, StepMotor_9.6x10mm - SMMY5B7P, SMMP5A8P (no tooth).SLDPRT, StepMotor_9.6x10mm - SMMY5B7P, SMMP5A8P (no tooth).STEP, StepMotor_9.6x10mm - SMMY5B7P, SMMP5A8P (no tooth).step.SLDPRT, StepMotor_9.6x10mm - SMMY5B7P, SMMP5A8P.SLDPRT, StepMotor_9.6x10mm - SMMY5B7P, SMMP5A8P.STEP]
2023-05-15 + CWF-5 & 3D
    [CWF-2_DS1069-2MVW6X.step, CWF-3_DS1069-3MVW6X.step, CWF-4_DS1069-4MVW6X.step, CWF-5_DS1069-5MVW6X.step]
2023-05-25 + 3D micro-fit
    [MicroFit-1x3 - Molex 43650-0304.sldprt, MicroFit-1x3R_SMD - Molex 43650-0312.sldprt, MicroFit-1x3_SMD - Molex 43650-0421.sldprt, MicroFit-2x10R - Molex 43045-2000.STEP, MicroFit-2x10R - Molex 43045-2000.sldprt, MicroFit-2x10_SMD - Molex 43045-2018.sldprt, MicroFit-2x12R - Molex 43045-2400.STEP, MicroFit-2x12R - Molex 43045-2400.sldprt]
2023-06-02 + cap pol D18mm
    [CAP_pol_DIP_D10x13mm.sldprt, CAP_pol_DIP_D10x16mm.sldprt, CAP_pol_DIP_D10x20mm.sldprt, CAP_pol_DIP_D18x40mm.STEP, CAP_pol_DIP_D18x40mm.sldprt, CAP_pol_DIP_D18x40mm_hor.STEP, CAP_pol_DIP_D18x40mm_hor.sldprt, CAP_pol_DIP_D18x40mm_hor_mirr.STEP]
2023-06-14 исплавления и корректировки
2023-06-18 правка размещения 3D моделей...
    [CAP1210 h0.8.STEP, CAP1210 h2.5.step, CAP2220 h2.0.step, CAP2220 h2.5.step, CAP7343 h1.9.STEP, Ferrite Bead 1206 h1.1 - PBY321611.STEP, Ferrite Bead 1206.STEP, Heatsink 35x10x50 - HS 207-50 (K207-50).STEP]
2023-06-18 отказ от прямоугольника как очертание копуса компоенета в пользу линий (прямоугольник некоректно отображается Топором)
2023-06-21 + варианты моделей самовоссстанавливающихся предохранителей (прозапас)
    [MF-R300 (12x12).step, MF-R300.SLDPRT, MF-R700 (22x22).STEP, MF-R700.SLDPRT, MF-RHT1100 (21x23).STEP, MF-RHT1300-2 (23.5x23.5).step, MR-RHT650-0 (12.7x12.7).step, MR-RHT750-0 (14x14).step]
2023-06-21 правка текста
2023-06-21 добавлены 3D модели
    [CDRH104R h4.STEP, CDRH127 h8.STEP, CDRH127.SLDPRT, CDRH127.step.SLDPRT, User Library-cdrh104r.sldasm, User Library-cdrh104r_CDRH104R_KORPUS.sldprt, User Library-cdrh104r_CDRH104R_NOGKA.sldprt, User Library-cdrh104r_CDRH104R_NOGKA_1.sldprt]
2023-06-22 + модель катушки 4*4*1,2мм
    [VLS4012CX h1.2.STEP]
2023-06-22 правки...
    [CDRH4D18.sldprt]
2023-06-23 + BNX022 3D
    [BNX022.SLDPRT, BNX022.step]
2023-06-26 корекция расстановки надписей
2023-06-26 добвлены метализированные полу-отверстия для паути LED денты на торец платы
2023-07-01 USB-micro_vert - увеличен диаметр отверстий.
2023-08-15 Модели штекеров помещены в отдельную папку, добавлена модель штекера micro-USB
    [RJ-25 plug + cover cast.STEP, RJ-25 plug + cover cast.STEP.SLDPRT, RJ-45 plug + cable.step, RJ-45 plug + cable.step.SLDPRT, RJ-45 plug + cover other.SLDPRT, RJ-45 plug + cover.STEP, RJ-45 plug + cover.sldprt, RJ-45 plug - MOLEX_44915-0001.SLDPRT]
2023-08-23 fix (на LED 1206_rev добавлен "ключ")
2023-09-06 редактирование _gitignore_global
2023-10-05 + обозначение MP2617B
2023-10-05 исправления, заметки
2023-10-16 правка расположения выводов
2023-10-22 + 3D модели користаллов в бвмбуковаого стебля
    [Bamboo stem (white).SLDPRT, Quartz crystal big simple.SLDPRT, Quartz crystal big.SLDPRT, Quartz crystal big.STEP]
2023-10-27 + BK-SIM7600; DS1095-01
    [USB-A 111 or DS1095-01 (vertical, angl).SLDPRT, USB-A 111 or DS1095-01 (vertical, angl).STEP]
2023-10-28 Раскашены USB-разъёмы
    [USB-A 111 or DS1095-01 (vertical, angl).SLDPRT, USB-A 111 or DS1095-01 (vertical, angl).STEP, USB-A Molex SD-1050570-001 (vertical).SLDPRT, USB-A Molex SD-1050570-001 (vertical).step, USB-B molex 67068-0000.sldprt]
2023-10-29 + 3D модели блоков питания; + угловые клеммники; мелкие правки
    [Cleamm-2_5mm_2EDGRC-5.0-02P-14-00AH.STEP, Cleamm-8_2.5mm_15EDGRC-2.5-08P-14-00AH.STEP, LD-05 TH series.step, LD-10.step, PwrSupp_MW_IRM-03.step, PwrSupp_MW_IRM-15.SLDPRT, PwrSupp_MW_IRM-15.step, PwrSupp_MW_IRM-30-xxST.SLDPRT]
2023-10-29 + ADC CS1238
2023-10-30 + SuperCap_D21mm C-type
    [SuperCap_D22 C-type 5.5V 1.5F.step]
2023-10-31 павки
2023-11-02 Правки 15EDGRC-2.5; добавлены новые 3D-модели
    [Cleamm-11_2.5mm_15EDGVC-2.5-11P-14-00AH.STEP, Cleamm-2_2.5mm_15EDGRC-2.5-02P-14-00AH.STEP, Cleamm-2_2.5mm_15EDGVC-2.5-02P-14-00AH.STEP, Cleamm-3_2.5mm_15EDGVC-2.5-03P-14-00AH.STEP, Cleamm-4_2.5mm_15EDGRC-2.5-04P-14-00AH.STEP, Cleamm-4_2.5mm_15EDGVC-2.5-04P-14-00AH.STEP, Cleamm-5_2.5mm_15EDGVC-2.5-05P-14-00AH.STEP]
2023-11-02 разъёмы 15EDGVC, 15EDGRC - корпус развёрнут на 180 градусов, изменена номерация контсктов вериткального исполнения
2023-11-04 развернёт корпус клессников 3,5 и 5,0 на 180 градусов
2023-11-04 правка имён 3D-моделей
    [Cleamm-10_2.5mm - 15EDGVC-2.5-10P-14-00AH.STEP, Cleamm-10_5mm - DG128-5.0-10.step, Cleamm-11_2.5mm - 15EDGVC-2.5-11P-14-00AH.STEP, Cleamm-2_2.5mm - 15EDGRC-2.5-02P-14-00AH.STEP, Cleamm-2_2.5mm - 15EDGVC-2.5-02P-14-00AH.STEP, Cleamm-2_5mm - 2EDGRC-5.0-02P-14-00AH.STEP, Cleamm-2_5mm - 2EDGVC-5.0-02P-14-00AH.STEP, Cleamm-2_5mm - DG128-5.0-02.step]
2023-11-04 заметки
2023-11-09 + угловая кнопка и модель
    [Button 6x6_h5 DIP angle - TS-A2PV-130.step, Button 6x6_h7 DIP angle - TS-A3PV-130.step, SuperCap_D21 C-type 5.5V 1.5F.step]
2023-11-13 + модель светодиода DIP 3мм; обновлены другие модели
    [LED DIP 3mm Hor Green.SLDPRT, LED DIP 3mm Hor Green.STEP, LED DIP 3mm Hor Yellow.STEP, LED DIP 3mm Vert Green.STEP, LED DIP 3mm Vert Green.sldprt, LED DIP 5mm Hor Green.SLDPRT, LED DIP 5mm Hor_mirr Green.SLDPRT, LED DIP 5mm Vert Green.STEP]
2023-11-13 переименована модель
    [USB-A 111 or DS1095-01 (vertical, angle).SLDPRT, USB-A 111 or DS1095-01 (vertical, angle).STEP]
2023-11-13 Заменена 3D-модель ионистора D21,5мм
    [SuperCap_D21 C-type 5.5V 1.5F.step, SuperCap_D21.5x7.5 C-type DCL5R series.STEP, SuperCap_D21.5x7.5 C-type DCL5R series.sldprt]
2023-11-18 + Средний кристалл кварца
    [Quartz crystal big simple.SLDPRT, Quartz crystal mid.SLDPRT, Quartz crystal mid.STEP]
2023-11-26 + модель дюралекой трубы
    [Duralumin tube D10x1x100.SLDPRT]
2023-12-01 прака ориентации надписей
2023-12-03 Обновлено посадочное место MLP8
2023-12-06 + корпус MLP8 3x3
2023-12-06 + LED's
    [WS2812-2020.SLDPRT, WS2812-2020.STEP]
2023-12-07 правка моделей светодиодов
    [Cree XP-L Hi (XLamp XHP35.2 HI).SLDPRT, Cree XP-L Hi (XLamp XHP35.2 HI).STEP, WS2812-2020.SLDPRT, WS2812-2020.STEP, cree xlamp_xp_e XPERED_L1_0000_00601.SLDASM, emiter_fosfor.SLDPRT, led anod.SLDPRT, led_alaptest.SLDPRT]
2023-12-07 пробное увеличение диаметра отверстий
2023-12-07 исправлено обозначение ключа
2024-01-22 fix: stp -> step
    [FCQFN16 - MP8765.step.SLDPRT, FCQFN24 - MP2637.step.SLDPRT, TSOP2xxx, TSOP32xxx Hor.step.SLDPRT, TSOP2xxx, TSOP32xxx Vert.step.SLDPRT, X2QFN12 - TUSB211RWBR.step.SLDPRT]
2024-01-22 + Cleamm-6_2.5mm - 15EDGRC-2.5-06P-14-00AH (угловой)
    [Cleamm-6_2.5mm - 15EDGRC-2.5-06P-14-00AH.STEP]
2024-01-29 Уменьшен размер котнутра комопнентв на 0,05мм, чтобы при выравнивании по сетке не было предупреждений о пересекающихся корпусах
2024-02-05 + USB type-C & fix
    [USB-C_10PF-074.STEP, USB-C_16PF-076.STEP, USB-C_24PF-009.STEP]
2024-02-05 + USB-C 16PF-015
    [USB-C_16PF-015 - 2.SLDPRT, USB-C_16PF-015.SLDPRT, USB-C_16PF-015.STEP]
2024-02-05 + CH224K
    [SSOP10_3.9x4.9mm_P1.00mm.step]
2024-02-05 + FCQFN20
    [FCQFN20 - MP2617.step.SLDPRT, FCQFN20.STEP]
2024-02-06 скрыто обозначение первого вывода
2024-02-12 добавлена модель micro-USB vert Molex SD-105133-011; иззенены имена
    [USB-micro B Molex 105017-0001.sldprt, USB-micro_B - B-5FS (vertical).step, USB-micro_B - Molex 105017-0001.STEP, USB-micro_B - Molex 105017-0001.sldprt, USB-micro_B - Molex 47346-0001.step, USB-micro_B - Molex SD-105133-011 var.2.sldprt, USB-micro_B - Molex SD-105133-011.SLDPRT, USB-micro_B - Molex SD-105133-011.STEP]
2024-02-18 добавлено посатдочное место USB-micro_B-Molex SD-105133-0xx; правки, заметки
    [USB-micro_B - Molex SD-105133-011.SLDPRT]
2024-02-18 Скорректирована ширина контектных площадок MSOP-8
2024-02-19 Переделаны (исправлены) нематаличесские отверстия
2024-02-19 переименование
    [Molex 0471510001.sldprt, Molex 0473460001.sldprt, Molex 1040310811.sldprt, Molex 672983090.sldprt, RJ-45 plug - Molex 44915-0001.SLDPRT, RJ-45 plug - Molex 44915-0001.STEP, USB-A Molex 1050570-001 (vertical).SLDPRT, USB-A Molex 1050570-001 (vertical).step]
2024-02-19 отредактирован размер контактных площадок
2024-02-20 Обновлена модель Choke_2824
    [Choke_2824 - ACM7060.SLDPRT, Choke_2824 - ACM7060.STEP]
2024-02-26 правки контура
2024-02-26 посадочное место USB-micro_B-Molex 105017-0001 перенесено в архив
2024-02-26 Правка параметов контактных плащадок крепления корпуса - термазагрузка
2024-02-26 овальные контктные площадки заменены на круглые
2024-02-26 Уменьшен размер котнутра комопнентв на 0,01мм, чтобы при выравнивании по сетке не было предупреждений о пересекающихся корпусах
2024-03-07 добавлена паяльная паста
2024-03-09 + модель горизонтального ионистора
    [SuperCap_D10.5x21x32 WEC6R0505QG I_hor.STEP, SuperCap_D10.5x21x32 WEC6R0505QG I_hor.sldprt]
2024-03-13 исправлен цвет
    [TJ-8P8C_vret-5520259-x.SLDPRT, TJ-8P8C_vret-5520259-x.STEP]
2024-03-21 отключено авторазмещение полей
2024-03-22 правки
2024-03-29 Правка обозначения позиуионирования угловых разъёмов (добавлены линии контактов)
2024-03-31 прописана 3D-модель для перемычек "fus"
2024-04-06 глобальный гит игрор
2024-04-06 правка свойств
2024-05-02 отключено авторазмещение текста
2024-05-13 добавлено обозначение моста, правки...
2024-05-17 правка ориентации посадочных мест (под расстановщик)
2024-05-18 Развернуты компоненты
2024-05-22 Правка подписей к посадочным местам
2024-05-27 продолжение правки подписей к посадочным местам
2024-06-06 добавлен вертикальный разъём USB-B
    [USB-B vetrical IGS-61400413321.STEP, USB-B_vertical.step, User Library-IGS-61400413321-rev1.sldasm, User Library-IGS-61400413321-rev1_DEFAULT-1.sldprt, User Library-IGS-61400413321-rev1_DEFAULT-2.sldprt, User Library-IGS-61400413321-rev1_DEFAULT-3.sldprt, User Library-IGS-61400413321-rev1_DEFAULT.sldasm, User Library-IGS-61400413321-rev1_DEFAULT.sldprt]
2024-06-10 fix (размер контактных площадок и настояние между ними)
2024-06-13 добавлен корпус DPAK
    [TO252-4.step, TO252AA-IRF.stp, TO252AA-Vishay.stp, TO252AD-6.stp]
2024-06-13 Овальное неметаличесское отверстие заменено на два круглых (иначе Топор его не видет)
2024-06-13 "уголком" обозначен "ключ"
2024-06-13 перенесён логотип в папку проекта
2024-06-20 отказ от прямоугольнаков
2024-06-26 + FDC-8-0.5
    [FPC-6_0.5mm 1734592-6.SLDPRT, FPC-6_0.5mm 1734592-6.STEP, FPC-6_0.5mm 1734839-6.SLDPRT, FPC-6_0.5mm 1734839-6.STEP, FPC-8_0.5mm 1734592-8.SLDPRT, FPC-8_0.5mm 1734592-8.STEP, FPC-8_0.5mm 1734839-8.SLDPRT, FPC-8_0.5mm 1734839-8.STEP]
2024-06-28 скорректированно: позиционирование посадочного места, размеры контктных площадок
2024-06-28 уменьшена ширина контктных площадок
2024-06-29 Созданы произвольные контактные площадки с полигоном
2024-09-04 + FDC-10; flat-10
    [FDC-10 ( DS1018-10 ).STEP]
2024-09-06 правка шелкографии
2024-09-18 добавлено посадочное место с PAD без сквозных отверстий
2024-09-20 добаботаны и добавлены мосты
2024-10-13 + аккумалятор и ножки шкатулки
    [Feed Wood box - hexagon h14 l22.SLDPRT, Feed Wood box - rectangle h10 l18.SLDPRT, Feed Wood box - rectangle h10 l22.SLDPRT, Feed Wood box - rectangle h14 l22.SLDPRT, Feed Wood box - round h11 d10.5.SLDPRT, Feed Wood box h17 D10 (P010 G).SLDPRT, Li-Pol_6x19.5x36.5_602035_600mAh.SLDPRT, Li-Pol_6x19.5x36.5_602035_600mAh.STEP]
2024-10-23 проставлены основные размеры
    [StepGearMotor_GM15BY (FIT0503).SLDPRT, StepGearMotor_GM15BY (FIT0503).step.SLDPRT, StepGearMotor_GM15BY (SM1511WC01).step.SLDPRT, StepMotor_9.6x10mm - SMMY5B7P, SMMP5A8P.SLDPRT]
2024-10-30 добавлены зеркальные посадочные места разъёмных клеммников (из архива)
2024-10-31 обновлено посадочное место светодиода (раздвинуты контакты)
2024-11-06 установлен зазор термозагрузки
2024-11-10 +петля-ограничитель
    [Hinge 1222.01.21 42.5x9mm Assem.SLDASM, Hinge 1222.01.21 42.5x9mm Part.SLDPRT, Hinge 1222.01.21 42.5x9mm Part.STEP, Hinge 1222.01.21 42.5x9mm Part.step.SLDPRT]
2024-11-10 добавлено граничное сопряжение
    [Hinge 42x14mm Assem.SLDASM, Hinge 42x14mm Part.SLDASM]
2024-11-11 исправлены некторые размеры
    [StepGearMotor_GM15BY (SM1511WC01).SLDPRT, StepGearMotor_GM15BY (SM1511WC01).STEP, StepGearMotor_GM15BY (SM1511WC01).step.SLDPRT]
2024-11-15 добавлены клеммники
    [Cleamm-3_5mm - 2EDGRC-5.0-03P-14-00AH.STEP, Cleamm-5_2.5mm - 15EDGRC-2.5-05P-14-00AH.STEP]
2024-11-26 вернул овальные контактные площадки
2024-11-26 исправлено имя
    [StepMotor_MSDW020B41.SLDPRT, StepMotor_MSDW020B41.STEP, StepMotor_MSDW020B41.step.SLDPRT, StepMotor_MSDW020B41alternat.SLDPRT, StepMotor_MSDW020B41alternat.STEP, StepMotor_MSDW020B41alternat.step.SLDPRT]
2024-11-27 + flat 2 mm & fix
2024-12-09 убран символ & из названия (не поддрерживается Топором)
2024-12-10 + зажим CH-201A
    [Clamp CH-201A.SLDASM]
2024-12-14 + & rename
    [Feed Wood box - hexagon h14 l22.SLDPRT, Feed Wood box - rectangle h10 l18.SLDPRT, Feed Wood box - rectangle h10 l22.SLDPRT, Feed Wood box - rectangle h14 l22.SLDPRT, Feed Wood box - round h11 d10.5.SLDPRT, Feed Wood box h17 D10 (P010 G).SLDPRT, Feed Wood box h17 D10 (P010 G).STEP, Leg Support Adjustable (Ножка приборная).SLDPRT]
2024-12-22 fix & +LED_DIP_RG_5mm
    [Bi-Color-СС DIP-5mm - WP59xxx_L7.5.step, Clamp GH-201A.SLDASM, Nut BD-7x4x15.SLDPRT, RGB-CC DIP-5mm-1.3.STEP]
2024-12-22 + BTN 12mm
    [Button 12x12x12 DIP - SWT 12x12-12.STEP, Button 12x12x12 DIP - SWT 12x12x12.SLDPRT, Button 12x12x7.3 DIP - KLS7-TS1204-7.3-180.step]
2025-02-06 размер основных плоскостей
    [Neodymium Magnet 6x4x1mm.SLDPRT, Neodymium Magnet D10x3mm hole3.5x7.SLDPRT, Neodymium Magnet D3x2mm.SLDPRT, Neodymium Magnet D3x3mm.SLDPRT, Neodymium Magnet D3x5mm.SLDPRT]
2025-02-06 добавлена ось
    [Hinge 20x16mm Assem.SLDASM, Hinge 42x14mm Assem.SLDASM]
2025-03-05 + стальной стержень
    [SteelRod_d3x40mm.SLDPRT]
2025-03-13 переименованы аккумуляторы
    [Li-Pol_28.5x24.5x8.3_852526_Robiton_500mAh.SLDPRT, Li-Pol_28.5x24.5x8.3_852526_Robiton_500mAh.STEP, Li-Pol_28.5x24.5x8.3_852526_Robiton_500mAh.step.SLDPRT, Li-Pol_29.5x28x3.2_30303_280mAh.SLDPRT, Li-Pol_29.5x28x3.2_30303_280mAh.STEP, Li-Pol_29.5x28x3.2_30303_280mAh.step.SLDPRT, Li-Pol_31.5x20x3_302030_320mAh.SLDPRT, Li-Pol_31.5x20x3_302030_320mAh.STEP]
2025-03-13 удалены промежуточные step-файлы
    [Li-Pol_28.5x24.5x8.3_852526_Robiton_500mAh.STEP, Li-Pol_28.5x24.5x8.3_852526_Robiton_500mAh.step.SLDPRT, Li-Pol_29.5x28x3.2_30303_280mAh.STEP, Li-Pol_29.5x28x3.2_30303_280mAh.step.SLDPRT, Li-Pol_31.5x20x3_302030_320mAh.STEP, Li-Pol_31.5x20x3_302030_320mAh.step.SLDPRT, Li-Pol_32x30x6_603030_750mAh.STEP, Li-Pol_32x30x6_603030_750mAh.step.SLDPRT]
2025-04-05 + аккумулятор 50*20*4
    [Li-Pol_51.5x20x4_042048_500mAh.SLDPRT]
2025-04-11 переименование ножек для шкатулок
    [Leg Wood box h17 d10 (P010 G).STEP, Leg Wooden box - cylinder d9 h4.SLDPRT, Leg Wooden box - figure h11 d10.5.SLDPRT, Leg Wooden box - figure h17 d10 (P010 G).SLDPRT, Leg Wooden box - hexagon h14 l22.SLDPRT, Leg Wooden box - rectangle h10 l18.SLDPRT, Leg Wooden box - rectangle h10 l22.SLDPRT, Leg Wooden box - rectangle h14 l22.SLDPRT]
2025-04-11 L433: добавлены подписи RTS_DE
2025-06-27 IDC2: меркие правки; +IDC2-10
2025-07-01 + BGR LED
2025-07-05 + WS2811F
    [FSOP8.step]
2025-07-05 + PLS 1.27
    [PLL1.27-1 PinHeader_1x01_P1.27mm_Vertical.step]
2025-07-13 контакты для подключения с увеличенным диаметром
2025-07-13 годавлен "формальный" поясок вокруг отверстия
2025-07-16 Увеличено растояние между контактными площадками на 0.2, чтобы проходил проводник "0,15/0,015"
2025-07-16 удалена пустая ссылка на модель
2025-07-16 убраны "лишние" границы зазоров; правка размещения текстовых слоёв
2025-09-18 + посадочные места под провод
2025-09-29 fix (мелкие правки)
2025-09-29 уменьшен поясок контактов SHLD
2025-10-13 обновление
    [Quartz crystal big.SLDPRT, Quartz crystal mid_1.SLDPRT, Quartz crystal mid_2 2.SLDPRT, Quartz crystal mid_2.SLDPRT, Quartz crystal mid_2.STEP]
2025-10-13 Добавлены шаблоны частоиспользуемых схем и библиотека операций на C++
    [151_bottom.kicad_pcb, 151_top.kicad_pcb, D2MG_bottom.kicad_pcb, D2MG_center.kicad_pcb, D3MG_bottom.kicad_pcb, D3MG_top.kicad_pcb, D5MG_bottom.kicad_pcb, Spruce_60x70.kicad_pcb]
2025-11-13 + дифференциатор
2025-11-15 + модели FDC
    [FDC-10 (DS1018-10).STEP, FDC2-14 (DS1018-02-14).sldprt, FDC2-14 (DS1018-02-14B2).step, FDC2-26 (DS1018-02-26).SLDPRT, FDC2-6 (DS1018-02-06).SLDPRT]
2025-11-15 Убрал свойство автоориентации с текстовых меток
2025-11-15 игнор...
2026-01-21 + USB-C разъём на кабель
    [USB Type-C female with PCB.step, USB Type-C female with PCB.step.SLDPRT, USB Type-C male with PCB.step]
2026-02-16 обновлены модели штыревых контактов
    [PBS-1.SLDPRT, PBS-1.STEP, PBS-2.STEP, PBS-3.SLDPRT, PBS-3.STEP, PBS-4.STEP, PBS-4R.SLDPRT, PBS-4R.step]
2026-03-12 позадочне место с отзеркадденными контактами
2026-03-13 обновлены USB-C разъёмы
    [USB-C_16PF-015.STEP, USB-C_16pin - 10PF-074.STEP, USB-C_16pin - 16PF-015 2.SLDPRT, USB-C_16pin - 16PF-015.SLDPRT, USB-C_16pin - 16PF-015.STEP, USB-C_16pin - 16PF-076.STEP, USB-C_16pin - Molex 217179-0001 footprint.SLDPRT, USB-C_16pin - Molex 217179-0001.SLDPRT]
2026-03-17 перемещение центра разъёмав
2026-03-17 правка размеров контактных площадок
2026-03-20 правка назмания
2026-03-20 обновлено посадочное место под кнопку 5.2*5.2
2026-03-27 новый аккумалятор + USB-C штекер
    [Li-Pol_41x20x5.8_602040_500mAh.SLDPRT, USB-C plug lip.SLDPRT, USB-C plug.STEP, USB-C plug.step.SLDPRT]
2026-04-15 обновление бибилотеки
2026-05-21 добавлена kl_crc
2026-05-21 kl_crc: добавлена установка начального значения при DMA
2026-05-25 + динамик от Мотороллы
    [Speaker_18x13x4.3_LCHS1622.step.SLDPRT, Speaker_20x14x3_Motorola L6.SLDPRT, Speaker_20x14x3_Motorola L6.STEP, Speaker_20x14x3_Motorola L6.step.SLDPRT]
2026-06-08 правка расположения обозначения
